tyevco/prettycoolboards/caliper/docs/electronics.md

# Schematics and boards

> **Status: rev A schematics captured, ERC clean (2 waived, listed below). Designed, not built or tested.**
> **Layout (§7):** both boards laid out and routed; KiCad 10.0.8 DRC + schematic parity: 0 errors, 0 unconnected.
> The toolchain and both boards moved from KiCad 9.0.9 to KiCad 10.0.8 on 2026-11-08 with no design change (§7.12).
> Both fab packages pass `release.py` (the J50 land now matches its part, §7.11); designed, not built.
> Every current, voltage and part choice here is a datasheet or catalogue figure, not a measurement.

The architecture of record is [SPEC](../hardware/design/SPEC.md); the net names, the ESP32 pin map and the I2C
addresses are in [`nets.py`](https://github.com/tyevco/prettycoolboards/blob/main/caliper/hardware/design/nets.py).
Why the big parts were chosen (and what lost) is in [Architecture](architecture.md).

## 1. How the schematic is made

The KiCad 10 projects are **generated from Python**, with the same toolchain as dial-me-spinner (vendored in
[`tools/`](https://github.com/tyevco/prettycoolboards/tree/main/tools)):

```
caliper/hardware/design/sheets/*.py ──build.py──▶ caliper/hardware/kicad/<board>/*.kicad_sch ──kicad-cli──▶ ERC, netlist, PDF
```

```sh
# in WSL (Ubuntu 24.04, KiCad 10.0.8)
python3 caliper/hardware/design/build.py --render      # both boards: schematic, ERC, netlist, PDF + PNG per sheet
python3 caliper/hardware/design/check_contract.py      # ESP32 pins in the netlist == nets.MCU_PINS
python3 tools/lcsc_check.py caliper/hardware/kicad/slider/prettycool-caliper-slider.net   # LCSC stock/type check
```

The sheets are **drawn with wires**, the way a person draws a schematic, so you can follow a connection by eye
(the toolchain's hard wiring rule, R1–R6 in [`tools/README.md`](https://github.com/tyevco/prettycoolboards/blob/main/tools/README.md#wiring-rule)):

- Each annotated group is a cluster around its anchor IC. Every satellite part sits next to the pin it serves and
  faces it: pull-ups and pull-downs, dividers, RC filters, the TX jumper + series-resistor chains, the CC
  resistors, the ESD part.
- Every connection on a sheet is an orthogonal wire, with a junction dot on every T. No junction joins four
  wires: a pull-up and a pull-down on the same net sit one grid step apart, so they make two T's.
- A pin's wire runs straight out on the pin's own row where it can. A test point or pull-up that would reach into
  the next row moves further out along its wire, and a test point may hang below the wire instead of above it
  (the ESP32's USB_D-/USB_D+ test points, the fuel gauge's ALRT pull-up). Only where a column is too crowded for
  that do the wires jog to fan the rows out: the AS5311 outputs (MAG_DO/A/IDX/INC_N/DEC_N) and the LCD
  connector's backlight pins, where R50 sits about 45 mm below J50 pin 12.
- Decoupling caps hang off the wire of the pin they decouple, and the power symbol sits at the end of that wire.
- A net that leaves the sheet has one global label per cluster, wired to all of that cluster's pins.
- A local net carries one local label as a name tag on its wire, so the net names in the netlist are unchanged.

`build.py` fails if the drawing breaks the rule. The check traces the drawn wires, not the labels, and names the
sheet, net and pins. Do not hand-edit the `.kicad_sch` files: change the sheet module and rebuild.

When the generator moved from "stub + label on every pin" to drawn wires (2026-11-07), `tools/netlist_diff.py`
showed the netlists before and after are **identical**: slider 96 nets, 125 components, 390 net members; scale
1 net, 4 components; same net names, same component fields, same symbol UUIDs. The ERC result did not change.
A second, independent review pass the same day traced the rendered sheets by eye. It fixed a power symbol drawn
over the buzzer's pin, six 4-way junctions, the half-row jogs on the I2C and LCD labels, and the label jumps
around test points on the ESP32 and the fuel gauge. The netlists were again identical to the pre-rework ones.
This is a check of the drawing only: nothing was built or measured.

| Board | KiCad project | Sheets | Rendered schematic |
|---|---|---|---|
| `slider` | `caliper/hardware/kicad/slider/prettycool-caliper-slider.kicad_pro` | power, mcu, sensor_mag, sensor_cap, ui, imu | [PDF](https://github.com/tyevco/prettycoolboards/blob/main/caliper/hardware/kicad/slider/render/prettycool-caliper-slider-schematic.pdf) |
| `scale` | `caliper/hardware/kicad/scale/prettycool-caliper-scale.kicad_pro` | scale | [PDF](https://github.com/tyevco/prettycoolboards/blob/main/caliper/hardware/kicad/scale/render/prettycool-caliper-scale-schematic.pdf) |

Toolchain changes made for this project (backward compatible): the deterministic UUID namespace in `schgen.py`
and `pcbgen.py` is now settable (`schgen.set_uuid_namespace()`, `pcbgen.UUID_NAMESPACE`; the default is still
`dial-me-spinner`), and `symgen.write_library()` takes the generator name. The caliper uses `prettycool-caliper`.

## 2. ERC status

| Board | Result (kicad-cli 10.0.8, `--severity-all`) |
|---|---|
| slider | **0 unwaived**; 2 waived `pin_to_pin` |
| scale | **clean** |

Waivers (in `build.py`, reported as "waived", never dropped silently):

| Violation | Pins | Why it is intended |
|---|---|---|
| pin_to_pin (open collector ↔ power output) | U5 pins 5 (QOD), 6 (VOUT) | TPS22917 QOD tied straight to VOUT, the datasheet's second QOD option (SLVSDW8B Table 6-1): +3V3_SNS is actively discharged when the switch turns off |
| pin_to_pin | U6 pins 5, 6 | Same for +3V3_UI |

`check_contract.py` result: `U10 checked against 42 nets.MCU_PINS entries -> OK` (it was also checked to fail on a
deliberately swapped pin).

## 3. Slider board, sheet by sheet

Reference designators are grouped by sheet: power 1–19, mcu 20s, sensor_mag 30s, sensor_cap 40s/60s–80s, ui 50s, imu 60s
(U60/C60–C62).

### 3.1 power: USB-C, charger, 3V3, rails

| Ref | Part | LCSC | Notes |
|---|---|---|---|
| J1 | HRO TYPE-C-31-M-12, 16-pin USB 2.0 receptacle | C165948 | Right edge (x = 62, y ≈ 26). CC1/CC2 each 5.1 k to GND (R1, R2): sink only, 5 V default USB current |
| U1 | USBLC6-2SC6 | C7519 | ESD on D+/D−/VBUS, flow-through. Within 5 mm of J1 |
| D1 | SMF5.0A TVS | C151296 | VBUS surge (as dial-me-spinner). On the layout both of J1's VBUS pad pairs land on D1's VBUS pad and the run to C1 / U2 leaves from it, so no copper path from J1 skips the TVS (§7.13) |
| U2 | BQ25180YBGR (I2C 0x6A) | C3682423 | Linear charger + power path, 70 mA charge set over I2C (0.52C for the 135 mAh cell; 250 mA before 2026-11-09), ship mode for storage. Battery discharge limit `IBAT_OCP` at its 1 A reset value (not 500 mA: an uncapped ≈ 0.5 A Wi-Fi peak from a low cell would come close; firmware §12.6). IN 2.2 µF/25 V 0805 X7R, SYS 10 µF/25 V, BAT 4.7 µF (dial-me-spinner's values, which its SPICE suite checked for DC bias). /INT → CHG_INT_N. TS/MR: 10 k NTC RT1 (board temperature next to the battery connector; the datasheet's "no TS" option is a plain 10 k) |
| J2 | JST SM02B-SRSS-TB (SH 2-pin) | C160402 | 1 = BAT+ (net VBAT_RAW), 2 = GND. **Check every pack's polarity**: hobby packs are not consistent (Q1 now survives a reversed one) |
| Q1, R10 | AO3401A P-MOSFET + 10 k gate resistor: battery reverse-polarity protection (added 2026-11-08) | C15127 (Basic), C25744 | Drain to J2 pin 1, source to VBAT, gate to GND via R10. Body diode first, then VGS = −VBAT turns it fully on; it conducts both ways, so charging works. Reversed cell: VGS = 0, off. VGS max ±12 V vs ≤ 4.4 V: no zener. At 0.5 A: ≤ 43 mV / ≤ 21 mW (85 mΩ max at VGS −2.5 V; ≈ 28 mV typical at a 3.0 V cell). The charger BAT pin, C3 and the MAX17048 stay on the protected side. Detail and the reversed-cell-with-USB case: [SPEC §3](../hardware/design/SPEC.md#_3-power-tree) |
| U3 | TPS63802DLAR buck-boost → +3V3 | C2845237 | 2 A, 11 µA Iq. EN = VSYS (always on), MODE = GND (power save), PG unused. TI typical application (SLVSEU9D Fig. 10-1): CIN 10 µF (C4), COUT 22 µF (C5) + 22 µF bulk (C6), feedback R3 511 k / R4 91 k → 3.31 V |
| L1 | Murata DFE201612E-R47M (0.47 µH, 5.5 A Isat) | C668312 | From TI's recommended list (Table 10-2). Footprint = KiCad's DFE201610P land (same 2016 body; the E part is 1.2 mm tall) |
| U4 | MAX17048G+T10 fuel gauge (0x36) | C2682616 | VDD = CELL = VBAT, CTG/QSTRT/EP to GND, 0.1 µF (C7). 3 µA hibernate. ALRT → FG_ALRT_N |
| U5 | TPS22917DBVR → +3V3_SNS | C2681320 | AS5311 + capacitive front-end. ON = SNS_PWR_EN (R5 100 k pull-down), CT 1 nF to VIN, QOD = VOUT |
| U6 | TPS22917DBVR → +3V3_UI | C2681320 | **Added during capture**: LCD logic VDD + RGB LED, also on SNS_PWR_EN (no GPIO is free) |
| C13 | 1 µF 0402 X5R at U6 VIN (added 2026-11-08) | C52923 (Basic) | U6's own input capacitor, right under its VIN / GND pins (C5, the nearest +3V3 cap, was 12.5 mm away by copper); the same part as C8 at U5 |
| R6, R7 | **2.2 k** I2C pull-ups to +3V3 (were 4.7 k) | C25879 | 400 kHz: rise time (30→70 %) = 0.847 RC = **205 ns** with the ≈ 110 pF bus estimate (4.7 k gave 438 ns, over fast mode's 300 ns). Sink current at VOL 0.4 V: (3.4 V − 0.4 V) / 2.18 kΩ ≤ **1.4 mA**, inside fast mode's 3 mA and every device's VOL rating: ESP32-S3 0.1 × VDD at 28 mA (S3 datasheet), BQ25180 0.4 V at 5 mA (SLUSE99C), MAX17048 0.4 V at 4 mA (19-6171); the LIS2DW12 is taken as fast-mode compliant (3 mA at 0.4 V; its datasheet could not be re-read here). No sleep cost: the bus idles high and the rail is off in ship mode. Always-on rail: the MAX17048's SCL/SDA have internal pull-downs and read a low bus as "disconnected" |
| R8, R9 | 10 k pull-ups on CHG_INT_N, FG_ALRT_N | C25744 | Open-drain interrupts |
| H1–H5, FID1–3 | M2 plated holes (GND), fiducials | – | Footprints only. H1 is the support hole, H2–H5 the tab clamp holes (H5 added to the schematic 2026-11-08). The SMT M2 standoffs on H2–H5 are **fitted by hand**: the only LCSC M2 SMT nuts (SMTSO20x0CTJ, e.g. C2915626 M2 × 2) have a Ø5.6 base and land, which would overhang the 6 mm tab (the hole is 2.5 mm from its outer edge) and exceed SPEC's OD ≤ 4.0 |
| TP1–TP7 | VBUS, VBAT, VSYS, +3V3, +3V3_SNS, +3V3_UI, GND | – | Bring-up |

Pinouts: BQ25180 from TI SLUSE99C Table 6-1 (and the YBG0008 land pattern, the footprint is copied from
dial-me-spinner); TPS63802 from SLVSEU9D Table 7-1, footprint drawn from the DLA0010A example board layout (p. 36:
pads 1–5 0.6 × 0.25 mm at x = −0.9, pads 6/7/9/10 0.9 × 0.25 mm at x = +0.75, GND pad 8 1.3 × 0.25 mm);
MAX17048 from the Maxim 19-6171 pin table (TDFN: 1 CTG, 2 CELL, 3 VDD, 4 GND, 5 ALRT, 6 QSTRT, 7 SCL, 8 SDA, EP).

### 3.2 mcu: ESP32-S3-MINI-1

| Ref | Part | LCSC | Notes |
|---|---|---|---|
| U10 | **ESP32-S3-MINI-1-N4R2** (4 MB quad flash, 2 MB quad PSRAM) | C3013941 | The N8R2 is not stocked at LCSC (searched 2026-11-07); the N8 (no PSRAM) is. KiCad's `RF_Module:ESP32-S3-MINI-1` symbol matches the Espressif pin table pad for pad; its footprint is `RF_Module:ESP32-S2-MINI-1`, the same 65-pad 15.4 × 20.5 mm land. That footprint has **no antenna keep-out zone** (its description also wrongly says "external antenna"): the layout must add the all-layer keep-out |
| C20, C21, C23 | 22 µF (0603) + 100 nF + 10 µF (0402) at pad 3 | C59461, C1525, C15525 | Datasheet v1.7 Fig. 9-1. C21 and C23 (CL05A106MQ5NUNC, 6.3 V X5R, 0.5 mm tall; expect a few µF at 3.3 V bias) sit on the **bottom under pad 3** (§7.2); C20 is the 22 µF bulk on top below the module |
| R20, C22 | EN RC 10 k / 1 µF | C25744, C52923 | Datasheet §9: "R = 10 kΩ and C = 1 µF" |
| R21, SW20 | BOOT: 10 k pull-up on GPIO0, button to GND | C25744, C720477 | Recovery only; normal flashing uses USB-Serial-JTAG |

The pin map is exactly `nets.MCU_PINS` ([SPEC §5](../hardware/design/SPEC.md#_5-mcu-pin-map-esp32-s3-mini-1)).
The KiCad symbol names pads 23/24 `USB_D-`/`USB_D+`; the sheet maps the contract's `IO19`/`IO20` to them.
IO26 (the PSRAM chip select on R2 parts) has a no-connect flag. Strapping: GPIO45 has a 100 k pull-down on the BUZZ
gate (R56), GPIO46 a 100 k pull-down on RGB_DIN (R55), GPIO0 the BOOT pull-up, GPIO3 the CHG_INT_N pull-up (harmless
while the JTAG_SEL eFuse is unburnt).

### 3.3 sensor_mag: AS5311

| Ref | Part | LCSC | Notes |
|---|---|---|---|
| U30 | ams AS5311-ATST (TSSOP-20) | C22459687 | **80 pcs in stock** at LCSC on 2026-11-07, Extended, $12.63. Order it early; if it is gone, consign it or hand-place it |
| C30, C31 | 100 nF + 1 µF at VDD5V | C1525, C52923 | Datasheet §7.7 |
| R30, R31 | 10 k pull-ups to +3V3_SNS on MagINCn / MagDECn | C25744 | Open drain (Table 1) |
| TP30–32 | MAG_A, MAG_B, MAG_IDX | – | Scope / logic analyser |

Pinout from the ams datasheet Revision 1.13, Table 1 (checked pin by pin): 1 NC, 2 MagINCn, 3 MagDECn, 4 A, 5 B,
6 NC, 7 Index, 8 VSS, 9 Prog, 10 NC, 11 NC, 12 DO, 13 CLK, 14 CSn, 15 PWM, 16 NC, 17 NC, 18 VDD3V3, 19 VDD5V,
20 NC. "Pins 1, 6, 10, 11, 16, 17 and 20 are for internal use and must not be connected": they carry no-connect
flags, as does the unused PWM output. 3.3 V operation: VDD5V and VDD3V3 both on +3V3_SNS (§7.7, "the LDO must be
bypassed by connecting VDD3V3 with VDD5V"). Prog to VSS ("for factory programming only"). CSn has an internal
~50 k pull-up and must be low for the A/B/Index outputs. Supply current 16 mA typ, 21 mA max.

### 3.4 sensor_cap: capacitive front-end (experimental)

```
CAP_TXn ─ R6n 0R (DNP-able) ─ R7n 100R ─ CAP_EL_TXn (comb phase n)        n = 0…7
CAP_EL_RX ─ R80 0R (DNP-able) ─ CAP_RX_IN ─┬─ U40A − (C40 10p C0G ‖ R81 10M to CAP_AMP_OUT)
                                           U40A + = CAP_VREF (R82/R83 100k/100k + C41 1u, buffered by U40B)
CAP_AMP_OUT ─ R84 390R ─┬─ R85 3.9k ─┬─ CAP_RX (GPIO1, ADC1_CH0)
                       C43 1n       C44 100p C0G
```

* **Placement (2026-11-08):** R84 / C43 sit at U40; R85 / C44 sit at the ESP32's GPIO1 pad (bottom side, under the
  module, beside GPIO1's escape via), so the long run across the board is **CAP_LP1** (390 Ω and 1 nF at its source
  end, a low-impedance node) and **CAP_RX** is ≈ 2 mm from the ADC pin. Both nets are in their own net class
  (*Analog*): 0.2 mm from every other net, and the GND pour follows them. TP42 (scope point) is on CAP_LP1
  (it was on CAP_RX; a pad in the test-pad row would now hang a 30 mm stub on the ADC node). §7.13. CAP_LP1's B.Cu
  and In2 stretches run in a shielded corridor (no other track within 1 mm on their layer or along them on the
  neighbouring one, GND copper round them): §7.14.

* **Op-amp:** TLV9062IDGKR (C398356): dual, 10 MHz GBW, rail-to-rail in/out, 538 µA per amplifier, 1.8–5.5 V.
  It meets SPEC's "≥ 10 MHz GBW, RRIO CMOS" at $0.23. If the bandwidth turns out short, a 50 MHz RRIO dual such as
  the OPA2365 has the same pinout, but LCSC C130011 is the **SOIC-8** OPA2365AIDR, so it is not a footprint drop-in
  for the VSSOP-8 land (a VSSOP version would have to be sourced).
* **Feedback:** 10 pF ‖ 10 MΩ: the gain is −C<sub>coupling</sub>/10 pF and the DC path's corner is
  1/(2π·10 MΩ·10 pF) ≈ 1.6 kHz, far below the 25–100 kHz drive.
* **Low-pass:** two RC poles at 1/(2π·390 Ω·1 nF) ≈ 408 kHz and 1/(2π·3.9 kΩ·100 pF) ≈ 408 kHz; the second stage
  is 10× the impedance so it barely loads the first.
* **Isolation:** with R60–R67 and R80 left off, the experiment is fully disconnected from the ESP32 and the
  op-amp. The rail (+3V3_SNS) is shared with the AS5311, and the op-amp is always fitted.

**Electrodes in the schematic (the approach chosen):** the electrodes are bottom-layer copper, not parts. They are
drawn as one symbol, **E40** (`caliper:CAP_ELECTRODES`), with a footprint of *seed pads*, one per electrode net:
pads 1–8 are eight 0.30 × 5.00 mm fingers at 0.635 mm pitch (pins PHASE0…PHASE7, one 5.08 mm repeat), pad 9 (pin RCV) is a
5.08 × 1.20 mm receive strip 3.8 mm below the comb centre (SPEC §2.1: comb y = 12.5…17.5, RX y = 10.6…11.8). The
layout script places E40 on the bottom at the start of the comb and draws the remaining 7 repeats and the full
40 mm RX strip as copper on the same nets. E40 is excluded from the BOM and the CPL. This keeps every electrode a
real net with a pad (ERC checks it, the netlist carries it to the board, DRC sees the copper on its net) without
net-tie footprints or ERC waivers. The pins are **passive** and named PHASEn / RCV, not TXn / RX: hwtools boardcheck
read a pin named TX6 as a UART transmitter and flagged it against U10 TXD0 (GPIO43, which drives phase 6 through
R66/R76) as "output to output" (SERIAL_DIRECTION_WIRING). With the rename it no longer does (re-run 2026-11-08).

### 3.5 ui: display, buttons, LED, piezo

**LCD panel pinout.** The 13-pin 1.14 in ST7789 glass is sold under many part numbers; the pin order used is the
DisplayModule **DM-TFT114-397** datasheet, §3.1 "Panel Pin Description" ([PDF](https://cdn.shopify.com/s/files/1/0264/7629/files/DM-TFT114-397_Datasheet.pdf)):

| Pin | 1 | 2 | 3 | 4 | 5 | 6 | 7 | 8 | 9 | 10 | 11 | 12 | 13 |
|---|---|---|---|---|---|---|---|---|---|---|---|---|---|
| Panel | NC | NC | SDA | SCL | RS (D/C) | RESET | CS | GND | NC | VDD | LEDK | LEDA | GND |
| Net | – | – | LCD_MOSI | LCD_SCK | LCD_DC | LCD_RST_N | LCD_CS_N | GND | – | +3V3_UI | LCD_LEDK | LCD_LEDA | GND |

Same datasheet: VDD 2.4–3.3 V, 8 mA typ; sleep-in 15 + 5 µA typ; backlight 1 white LED, VF 2.9–3.1 V at 20 mA.

| Ref | Part | LCSC | Notes |
|---|---|---|---|
| J50 | HDGC 0.5K-AX-13PWB, 13 P 0.5 mm FPC, bottom contact, slide lock, 2.0 mm | C2911931 | 2784 in stock. **Own footprint** (`caliper:HDGC_0.5K-AX-13PWB_1x13-1MP_P0.50mm_Horizontal`, drawn in `sheets/ui.py`) from the vendor drawing 0.5K-AX-nPWB: contacts 0.30 × 1.25 at 0.5 mm, nail pads 2.00 × 3.00 at x ±4.54, 2.325 mm behind the contact row. The genuine Hirose FH12-13S-0.5SH(55) (C5700671) and the Amphenol F32R 13-pin have KiCad footprints but no LCSC/JLC stock. Checked against the EasyEDA land (same contacts and nail x; EasyEDA's nails are 0.37 mm nearer the row and still land on this one). Pin 1 and the panel-tail orientation: §7.2 |
| C50, C51 | 1 µF + 100 nF at VDD | | |
| R50 | 15 Ω 0603, +3V3 → LEDA | C22810 | (3.31 V − VF) / 15 Ω ≈ 20 mA at VF 3.0 V (the panel's rated point), ≤ 27 mA at 2.9 V, ~14 mA at 3.1 V. Was 10 Ω at capture, which gave 31–41 mA (changed in review). Only ~0.3 V of headroom, so brightness follows VF and +3V3. Dim by PWM |
| Q50 | AO3400A, low side on LEDK, gate = LCD_BL | C20917 (Basic) | R51 100 k gate pull-down |
| SW50–52 | XUNPU TS-1088-AR02016 (3.9 × 2.9 × 2.0 mm) ZERO/HOLD/MODE | C720477 (Basic) | 100 k pull-up (R52–R54) + 100 nF (C52–C54) = 10 ms RC debounce; RTC GPIOs 17/18/21 wake from deep sleep |
| D50 | WS2812B-2020-V6 RGB LED | C52917434 | LCSC lists 3.3–5.3 V, so it runs on +3V3_UI with a 3.3 V DIN and no level shifter. R55 100 k pull-down (GPIO46 strap) |
| BZ50 | Murata PKMCS0909E4000-R1 piezo (4 kHz, external drive) | C910763 | +3V3 → BZ50 ‖ R57 1 k → Q51 (AO3400A) drain. R56 100 k gate pull-down holds GPIO45 (VDD_SPI strap) low at reset |

### 3.6 imu: LSM6DSO

U60 **LSM6DSOTR** (C2655100), a 6-axis IMU: 3-axis accelerometer + 3-axis gyroscope in an LGA-14 (2.5 × 3.0 ×
0.86 mm). It is on the system I2C and always powered from +3V3, so it can wake the ESP32 on pickup (INT1 → GPIO15,
an RTC GPIO). Until 2026-11-10 U60 was a LIS2DW12 accelerometer; the reasons for the change and what it cost are in
[§7.15](#_7-15-gyroscope-lsm6dso-replaces-the-lis2dw12-2026-11-10).

| Pin | Net | Why |
|---|---|---|
| 8 VDD, 5 VDDIO | +3V3 | C60 100 nF + C61 10 µF at VDD, C62 100 nF at VDDIO (DS12140 asks for 100 nF on each) |
| 13 SCL, 14 SDA | I2C_SCL, I2C_SDA | the system bus, 400 kHz |
| 12 CS | +3V3 | high = I2C |
| 1 SDO/SA0 | +3V3 | **address 0x6B**. SA0 low is 0x6A, the BQ25180's address on the same bus. SA0 is an input without a pull-up by default (Table 19, `PIN_CTRL.SDO_PU_EN` = 0), so the strap draws nothing (the LIS2DW12's SA0 had a permanent pull-up) |
| 2 SDx, 3 SCx | GND | Mode 1 (no sensor hub): "connect to VDDIO or GND" (Table 1) |
| 10 OCS_Aux, 11 SDO_Aux | not connected | Mode 1: left open, pads soldered |
| 4 INT1 | IMU_INT1 (GPIO15) | wake on pickup. Push-pull, active low, latched, set by the firmware. No pull on the net |
| 9 INT2 | IMU_INT2 (GPIO16) | spare interrupt, push-pull, no pull |
| 6, 7 GND | GND | |

* **INT1 at power-up.** Until the firmware configures it, INT1 is an *input* with an internal pull-down, and it
  "must be set to 0 or left unconnected during power-on" (Table 19, note 2). The net has no pull and GPIO15 is a
  high-impedance input at reset, so that holds. The consequence for the firmware: an unconfigured IMU shows INT1
  **low**, which is the wake level, so the firmware configures the IMU before it arms the wake
  ([Firmware](firmware.md)).
* **Axes.** U60 sits at 0° on the top side, so the chip axes are the board's (Fig. 3): X along the beam (board +x),
  Y across it (board +y), Z out of the display face.
* **What the gyroscope gives.** Roll and pitch come from gravity (the accelerometer) and stay absolute; the gyroscope
  makes them usable while the tool moves, and gives turn rate and a "held steady" test. Heading (rotation about
  the vertical) from the gyroscope alone is only relative and drifts. Since 2026-11-10 a magnetometer (U61, below)
  gives it a reference. This page said until then that one "would not work this close to the magnetic scale"; that
  reason was wrong (the tape's field is gone a centimetre away), and the real problem is the steel beam
  ([§7.16](#_7-16-compass-iis2mdc-magnetometer-2026-11-10)).
* **Not verified.** The piezo (BZ50) is 10 mm away; whether its 4 kHz drive shows up in the gyroscope output is not
  known (TVP: gyro noise with the buzzer on and off). The current figures are the datasheet's at VDD = 1.8 V; the
  board runs it at 3.3 V.

**The compass, U61.** An **IIS2MDCTR** (C2655002), a 3-axis magnetometer in an LGA-12 (2 × 2 × 0.7 mm), on the same
sheet, the same I2C bus and the always-on +3V3. Added on 2026-11-10
([§7.16](#_7-16-compass-iis2mdc-magnetometer-2026-11-10)). Pin functions and the application circuit are from ST
DocID030986 Rev 1 (Table 2, Fig. 5, §5), read from a distributor's copy up to page 25 of 40: the register map and
the package drawing were **not read**.

| Pin | Net | Why |
|---|---|---|
| 9 Vdd, 10 Vdd_IO | +3V3 | C64 100 nF + C65 10 µF at Vdd, C66 100 nF at Vdd_IO (Fig. 5: C3, C2, C4) |
| 5 C1 | COMPASS_C1 | **C63 220 nF** to GND (Fig. 5). The sensor's set / reset pulses come out of this capacitor: "very high current pulses flow from C1 to pin 5 and 6", ESR ≤ 200 mΩ, "as close as possible" to both pins (§5). An X7R 0402 (CL05B224KO5NNNC, C16772) |
| 1 SCL, 4 SDA | I2C_SCL, I2C_SDA | the system bus, 400 kHz. **Address 0x1E**, fixed (Table 21): no address pin, and nothing else on the bus is near it |
| 3 CS | +3V3 | "When using the I2C, CS must be tied high" (§5). An input without a pull-up |
| 7 INT/DRDY | not connected | every ESP32 pin is taken (`nets.MCU_PINS`), so the firmware polls. The pin is high impedance by default (Table 14) |
| 2, 11, 12 NC | not connected | "internally not connected" (Table 2); pads soldered |
| 6, 8 GND | GND | |

* **Axes: not known from the datasheet.** Its axis drawing (Fig. 2) is an isometric view from which the signs
  against pin 1 could not be read with certainty. The firmware has an axis map, and the first board fixes it
  (`bu compass`, [bring-up](bringup.md)).
* **Currents** (Table 5 and Table 11, typical): idle 1.5 µA; low-power mode at 10 Hz 25 µA, 50 µA with offset
  cancellation (the firmware's mode); high-resolution at 10 Hz 100 µA. Not measured.
* **What it can and cannot do here** is in §7.16: the steel beam is 11.2 mm away.

## 4. Scale board

No electronics: two plated M2 holes on GND (H1, H2) in the schematic, which the layout turns into the SPEC's Ø1.0
non-plated alignment holes (§7.6), two fiducials and a PWR_FLAG. The reflector pattern and the
back-copper ground plane are drawn by the layout script as copper/graphics (SPEC §2.2). The netlist exists so the
layout can import the holes and fiducials the same way as the slider.

## 5. BOM and sourcing

`tools/lcsc_check.py` against the JLCPCB catalogue on 2026-11-10: **49 BOM lines, 0 flagged** (every code
found, in stock, MPN matches). 23 lines are JLC **Basic**, 26 **Extended**; the four buttons are four lines with one
code, so the order has 46 different parts. On 2026-11-08 it was 47 lines, 22 Basic and 25 Extended: the compass
(§7.16) added U61 (Extended) and C63 220 nF (Basic). The stock and price columns below are as read on the date
given in each row, or on 2026-11-08.

| Line | LCSC | Type | Stock | $ (qty 1) |
|---|---|---|---|---|
| ESP32-S3-MINI-1-N4R2 | C3013941 | Extended | 7 487 | 5.00 |
| AS5311-ATST | C22459687 | Extended | **80** | 12.63 |
| BQ25180YBGR | C3682423 | Extended | 5 848 | 1.85 |
| MAX17048G+T10 | C2682616 | Extended | 22 821 | 2.01 |
| TPS63802DLAR | C2845237 | Extended | 23 909 | 0.91 |
| TPS22917DBVR (×2) | C2681320 | Extended | 3 637 | 0.37 |
| LSM6DSOTR (since 2026-11-10; was LIS2DW12TR C189624, $0.90) | C2655100 | Extended | 23 738 (2026-11-10) | 3.99 |
| IIS2MDCTR (compass, since 2026-11-10; §7.16) | C2655002 | Extended | 2 705 (2026-11-10) | 4.25 |
| TLV9062IDGKR | C398356 | Extended | 53 188 | 0.23 |
| WS2812B-2020-V6 | C52917434 | Extended | 740 820 | 0.09 |
| PKMCS0909E4000-R1 | C910763 | Extended | **535** | 1.10 |
| 0.5K-AX-13PWB FPC | C2911931 | Extended | 2 784 | 0.12 |
| AO3400A, AO3401A (Q1, C15127), TS-1088, 0402 R/C | various | Basic | > 100 k | < 0.09 |

**Parts that are not (reliably) on LCSC:** none is missing, but the **AS5311** has only 80 pieces at LCSC: if they
are gone when the order is placed, the part is consigned or hand-placed (the BOM field `JLC` says so). The LCD panel
itself is not a PCBA part: it plugs into J50 by hand.

## 6. Open risks (schematic)

* **LCD panel pitch / pin order.** The cited pinout comes from a module whose drawing shows a 0.7 mm *solder*
  tail; the board needs a panel with a 0.5 mm, 0.3 mm-thick plug-in tail in the same pin order. Buy the panel
  first and check its drawing; if it differs, change `PANEL_PINS` in `sheets/ui.py`.
* **FPC footprint**: now the C2911931 vendor land (§3.5). The vendor drawing and EasyEDA disagree by 0.37 mm on the
  nail position; the land covers both, but check the first parts' nails on the pads.
* **WS2812B-2020-V6** pin order and the 3.3 V minimum are from the LCSC listing and the WS2812B-2020 family; the V6
  datasheet could not be downloaded during capture.
* **Backlight headroom**: 3.31 V − 3.0 V VF leaves 0.3 V across 15 Ω + the FET; a 3.1 V LED gets ~14 mA, a 2.9 V
  one ≤ 27 mA. The panel's maximum LED current is not in the cited datasheet: check it on the bought panel.
* **Sleep current** is ≈ 40 µA (estimate; ≈ 38 µA before the compass, ≈ 33 µA before the gyroscope) against SPEC's
  target of ≤ 42 µA
  ([Architecture §5](architecture.md#_5-power-budget-and-battery-life)).
* **Contract reconciliation (SPEC §10, 2026-11-07).** The layout has the clamp tabs (74 × 34 overall), the
  single upper-band hole H1, the module in the top-left corner with an all-layer antenna keep-out, the D5 electrode
  geometry and the scale's Ø1.0 alignment holes (§7). H5 is in the schematic since 2026-11-08; the SMT M2 standoffs
  are hand-fitted (no LCSC part fits, §3.1). **Not yet in the schematics** (the board carries them as board-side
  edits, §7.9): the E40 seed-pad change (fingers 0.30 × 3.80, RX 5.08 × 1.30) and the scale holes as NPTH. In the schematics already: RT1 populated and
  TS enabled; IMU_INT1 has no pull (checked in the netlist).
* **Ship mode** can only be left by plugging in USB (TS/MR is not wired to a button).
* **RX electrode ESD**: the receive strip is exposed copper under an open mask, connected through R80 straight to a
  high-impedance op-amp input. It faces the scale, not the user, but a discharge into the beam could reach it.
  Not protected in rev A (a TVS would add pF and leakage at the most sensitive node).
* **Back-powering**: the MAG_*, LCD_* and RGB_DIN lines go into switched rails; the firmware must drive them low
  before SNS_PWR_EN goes low.
* Nothing here has been simulated (the simulation track owns SPICE) or built.

## 7. Layout

> **Status (2026-11-08): both boards laid out, routed and through the DRC + schematic-parity gate (KiCad 10.0.8:
> 0 errors, 0 unconnected, 0 parity errors on both; it was KiCad 9.0.9 until the move in §7.12, which changed no
> copper), and both fab packages pass
> `release.py`**, including the jlcplace placement gate on every CPL row (§7.7). The slider was re-placed and re-routed from
> scratch after the hardware changes in §7.11 (Q1, 2.2 k I2C pull-ups, the J50 land, bottom-side module
> decoupling, H5, silk); the figures in §7.5 and §7.10 are from the board before that re-route. The phase-4 review
> fixes (§7.13: VBAT / VSYS / VBUS pre-routes, C13, R85/C44 at the ADC pin, the stack-up, the USB loop round U1) were
> made with `layout.py --rework`, which keeps the routing of every unchanged net; so was the CAP_LP1 crosstalk
shield (§7.14, 2026-11-09). Designed,
> not built: nothing has been fabricated or measured, and no signal-integrity, RF or thermal analysis was run on
> the layout. An adversarial layout review on 2026-11-08 found and fixed five defects (the USB pair, three
> decoupling placements, a truncated electrode guard) and corrected several claims here; its findings, fixed and
> open, are in §7.10.

The boards are generated from the netlists by
[`layout.py`](https://github.com/tyevco/prettycoolboards/blob/main/caliper/hardware/design/layout.py) (adapted from
dial-me-spinner's) and released by
[`release.py`](https://github.com/tyevco/prettycoolboards/blob/main/caliper/hardware/design/release.py):

```sh
# in WSL (Ubuntu 24.04, KiCad 10.0.8, Freerouting 2.1.0, FREEROUTING_JAR=/opt/freerouting/freerouting.jar)
python3 caliper/hardware/design/layout.py --board scale                                  # place, pour, DRC
python3 caliper/hardware/design/layout.py --board slider --route --minutes 8 --attempts 1 # place, route, pour, DRC
python3 caliper/hardware/design/layout.py --board slider --complete                      # only if any stay open
python3 caliper/hardware/design/layout.py --board slider --rework [--rip NET,...]         # a change: keep the routing
                                                                                         # of the unchanged nets (§7.13)
python3 caliper/hardware/design/release.py [--refit-jlc] [--force]                       # gates, fab package
```

Coordinates below are SPEC's: board mm, origin at the lower-left of the 62 × 34 body, +y up (the beam's jaw-side
edge is y = 0). The drill/place origin is the same point, so the CPL is in these coordinates too.

### 7.1 Stack-up and rules (slider)

| Layer | Use |
|---|---|
| F.Cu | parts, signals, GND pour |
| In1.Cu | **solid GND plane** (layer type *power*; every GND SMD pad has its own via to it) |
| In2.Cu | **+3V3 pour**, signals, the 8 electrode **phase buses**, and a **GND** pour inside the electrode ring |
| B.Cu | U30 (AS5311) + C30/C31, the electrode comb and guards, 19 test pads, the MAG bus, signals; GND pour |

**Stack (written into the board since 2026-11-08, `layout.py` `SLIDER_STACKUP`; ORDER-NOTES names it): JLC04101H-3313**,
JLC's symmetric 1.0 mm 4-layer construction. ENIG.

| Layer | Thickness | Material |
|---|---|---|
| F.Mask / B.Mask | 15 µm | εr 3.8 |
| F.Cu, B.Cu | 35 µm | 1 oz finished |
| L1–L2 and L3–L4 prepreg | 0.0994 mm | 3313 (RC 57 %), εr 4.1 |
| In1.Cu, In2.Cu | 15.2 µm | 0.5 oz finished (JLC's figure) |
| Core | 0.6708 mm | FR-4, εr 4.6 (set so the stack adds up to 1.0 mm) |

The prepreg, its εr and the copper figures are JLC's impedance-table values (the hwtools run assumed the same). JLC
publishes this construction's core only inside its order and impedance pages, which could not be read from here; no
line on this board depends on it (every controlled line is an outer layer over its neighbouring plane through the
prepreg). Before 2026-11-08 the board file had no stack-up, so KiCad, sicalc and pcbroute fell back to KiCad's
default stack (the USB pair read 125 Ω differential there).

Net classes: default 0.12 / 0.10 mm, vias 0.40/0.20; Power (VBUS, VSYS, VBAT, VBAT_RAW, the buck-boost switch nodes)
0.30 mm, vias 0.50/0.25, with the main power paths pre-routed wider (§7.13); Rail3V3 (+3V3) 0.20 mm (≈ 0.7 A on 1 oz
outer copper, with the In2 +3V3 pour in parallel; the module peaks at ≈ 0.36 A); Supply (+3V3_SNS, +3V3_UI,
backlight) 0.20 mm; GND 0.30 mm; **USB 0.16 mm, 0.15 mm clearance, differential pair 0.16 mm / 0.16 mm gap**;
**Analog** (CAP_RX, CAP_LP1) 0.15 mm, **0.30 mm clearance**. Copper to edge 0.25 mm.

**USB pair impedance** (hwtools `sicalc solve`, 2D field solver, edge-coupled microstrip over the plane through the
0.0994 mm prepreg, εr 4.1, 35 µm copper, 15 µm mask, JLC's 17.8 µm etch): 0.14 mm / 0.18 mm gap (until 2026-11-08)
**96.7 Ω**; **0.16 mm / 0.16 mm gap (now) 89.4 Ω** (89.0 Ω with the B.Cu GND pour 0.25 mm beside it); the
0.16 / 0.14 mm of a 45° leg at the old 0.30 mm pitch would be 87.4 Ω, so the D− 45° leg moved out to 0.32 mm pitch.
The pair runs on B.Cu over its In2 GND strip, which in this symmetric stack is the same structure as F.Cu over In1.
Full-speed USB (12 Mb/s, ≥ 4 ns edges) is not sensitive to this at these lengths; the class is set right anyway.

Copper is poured on all four layers over the beam band (y 0–20) where the routing leaves room. Measured in the review
(copper incl. tracks and pads, share of the board area in y 0–20): F.Cu 67 %, In1 93 %, In2 63 %, B.Cu 65 %. The
outer pair is balanced; the inner pair is not (93 / 63 %), a small warp bias against the 0.03 mm flatness callout.

**In1 under the electrode via field.** Each phase's finger vias step 0.635 mm in x and 0.45 mm in y, 0.78 mm apart,
and their 0.8 mm In1 antipads merge, so In1 has eight diagonal slots ≈ 5.5 mm long under y 13.5–17.1. F.Cu tracks
that cross the via field cross those slots (a few mm per net, measured). Harmless for the slow nets; the LCD SPI lines
cross it for ≈ 1 mm each. Not changed in rev A (smaller finger vias would only shrink the slots to 0.08 mm webs).

### 7.2 Slider placement

Everything in SPEC §2.1's table is placed and locked by the script. The rest is placed next to the IC pin it serves
(decoupling, pull-ups, filters) or inside its cluster region. Where the layout differs from the table (SPEC allows
≤ 1 mm when every rule still holds; **bold** = more than that). The SPEC §2.1 table was updated to these
positions on 2026-11-08 (SPEC §11):

| Part | SPEC §2.1 | Layout | Why |
|---|---|---|---|
| U10 module | origin (8.3, 24.25) | (7.85, 24.25) | the electrode comb's left end runs under the module (SPEC places both there). With the module 0.45 mm left, finger 8's via clears the module's right pad column. Antenna still flush with the top edge; body x 0.1–15.6 |
| J50 FPC | (21.5, 8.5) | (21.5, 7.5) | at 8.5 its (FH12) fitting-nail pad sat on the electrode via rows. Since §7.11 the land is the C2911931 drawing's: contact row at x 23.35, pin 1 at y 10.5, pin 13 at y 4.5, nail pads up to y 13.04 |
| **Q1 / R10** (battery FET), RT1, C7 | RT1 (24.5, 26.5), C7 in the cluster | Q1 (25.1, 25.1) 90°, R10 (22.5, 23.5); **RT1 (22.3, 26.75)**; C7 (27.37, 26.3) | §7.11: Q1's drain pad 2.6 mm below J2 pin 1; RT1 moved 2.2 mm left (still beside J2, over the cell); C7 fixed left of U4's VBAT pins (1.3 mm) |
| J2 battery | (24.5, 31.4) | **bottom** (24.1, 24.9), 0° flipped (2026-11-09, SPEC §15 L1; was top (24.5, 30.6), 180°) | the slim housing has no room for a plug past the top edge, so J2 hangs into the battery pocket's J2 bay, mouth toward +y. At the draft's 31.4 the front fitting-nail pads crossed the top edge |
| SW20 BOOT | (27, 15.5) | (27, 15.7), 90° | rotated so its pads fall between the finger via rows |
| U1 USB ESD | (53.0, 24.0) | **(50.2, 26.3)** | at 53 its VBUS pin sits under the locked D+/D− crossover behind J1's pads; still 5 mm from J1 |
| **D1** TVS, R1/R2 CC | near J1 | **(52.7, 19.95) 180°**; (53.4, 23.7 / 29.0) | §7.13: D1's VBUS pad on the VBUS trunk (both J1 feeds land on it, the run to C1 / U2 leaves it), below J1's courtyard; was (51.3, 22.0) 90°, a branch. C53 (BTN_HOLD_N debounce) took D1's old spot, (51.3, 23.0) |
| **C30** (AS5311 100 nF) | (25.5, 6.0) bottom | **(35.45, 8.6)** bottom | review 2026-11-08: at 25.5 it was 8.1 mm from the VDD pins 18/19 (14.9 mm of track); now 1.7 mm, still inside the D2 window x 20–41, y 2.4–9.6. C31 (1 µF) stays at (36.5, 6.0). **SPEC table to update** |
| C8 / C10 (U5 in / out) | in the cluster | (51.3, 1.55) / (49.75, 5.5) | review 2026-11-08: the pin-anchored placer found no room inside the SPEC cluster box (y ≥ 2.5, x ≥ 50.5) and left them 6.5 / 7.0 mm from U5; now 1.9 / 1.6 mm. Both sit up to 0.95 mm outside the box (the 4.2 mm height rule still holds) |
| **U4 fuel gauge** | in the charger cluster | **(29.6, 27.2)**, beside J2 | its CELL/VDD pins then sense VBAT at the cell's connector, its I2C/ALRT lines stay short, and the cluster could not let them out (the electrode ring blocks In2/B.Cu up to x 52.4). **SPEC cluster list to update** |
| **R60–R67, R70–R77** | x 3.5–16, y 2.5–12 | **x 1.8–10.2, y 7.0–11.2** (a ladder of 8 columns, R7n over R6n) | §7.3: with the ladder there, the TX lines reach it down the left side instead of through the corner where the module meets the electrode via field |
| R6–R9 (I2C/alert pull-ups), C20 (module 22 µ bulk) | – / at pad 3, < 2 mm | below the TX ladder, x 0.4–9.9, y 2.7–6.8 | the module's 3V3 pad is in its left column, 0.45 mm from the edge, and no top-side spot is closer than ≈ 12 mm (the antenna keep-out is above the pad, the board edge left of it). C20 stays 20.5 mm away as the bulk, fed through the In2 +3V3 pour |
| **R85 / C44** (CAP_RX 3.9 k / 100 p, 0402) | at U40 | **bottom**, (3.3, 24.25) / (3.3, 23.25), under the module below C23 | §7.13: the anti-alias RC at the ADC pin; R85's and C44's CAP_RX pads 0.8 mm from GPIO1's escape via (was 40 mm of track away). SPEC §2.1's under-module bottom exception extended to y 22.7 |
| C13 (U6 input, 1 µ 0402) | new | (52.25, 10.3), under U6's VIN / GND pins | §7.13 |
| **C21 / C23** (module 100 n / 10 µ, 0402) | at pad 3, < 2 mm | **bottom**, (3.1, 26.5) / (3.1, 25.3), either side of pad 3's escape via (2.0, 25.95) | §7.11 (SPEC call 2026-11-08): their +3V3 pads are 1.9 mm from pad 3 (C21 was 22.4 mm away on top). 0.55 mm envelope against the 0.75 mm housing floor gap there; outside the beam band, the antenna rule area and the battery pocket |
| **R50 / Q50 / R51** (backlight) | (25.5, 4.0) | **(27.0, 7.4) / (28.1, 3.6) / (28.7, 7.0)** | beside J50, under the glass, around the electrode feed |
| **Q51 / R56 / R57** (piezo driver) | (40.0, 18.0) | **(47.35, 20.4) / (46.2, 23.7) / (33.7, 19.5)** | around BZ50 instead of under the glass edge; R57 (BUZZ_D pull-up) at BZ50's left |
| **FID3** | (60.5, 32.8) | **(33.0, 27.6)** | SPEC's spot is inside J1's courtyard (it reaches y 31.9 over x 54–63) |
| Charger / buck-boost | x 50.5–61.5, y 2.5–20.5 | U3 (55, 9), L1 (58, 9), U2 (57.2, 16.4), U5 (52.2, 4.6), U6 (53, 12.9) | TPS63802: CIN at VIN, COUT at VOUT, L1 right beside L1/L2, the FB divider R3/R4 at FB on the side away from L1; BQ25180: a locked DSBGA fan-out and its caps around the array; a locked 0.30 mm VBUS run from J1 to C1 and D1. L1 is 16 mm from U40 (SPEC ≥ 10), U60 31 mm from L1 (SPEC ≥ 15) |

**Antenna.** The module's library footprint carries Espressif's 15 mm clearance as a 45 × 19.5 mm rule area and a
matching courtyard. SPEC D4 records a 5 mm deviation, so on this instance both are replaced by the module-body
courtyard, and the SPEC keep-out is a board rule area on all four layers: no tracks, vias, pads or pours in x 0–21,
**y 29.2**–34 (SPEC says 29.0; the module's own top GND pad row reaches 29.1, and the antenna starts at 29.5).

**Escapes.** Before routing, the module's left column (0.45 mm from the edge, so it can only escape inward) and bottom
row, its right column, J50's five LCD pads, U60, U4 and U1's VBUS pin get a locked stub and via. The routers then leave
those pins on In2/B.Cu instead of walling them in on F.Cu; a via the router does not use is pruned afterwards. Five
AS5311 lines (MAG_A/B/IDX/CLK/DO) are a locked B.Cu bus from the module's left column down the left edge to U30,
planned so that no two cross.

### 7.3 Capacitive electrodes (SPEC §2.2)

All of the comb is real copper on the E40 nets, so DRC and parity check it like any other copper:

* **Fingers and RX are E40 pads.** The E40 instance on B.Cu holds 64 finger pads (0.30 × 3.80 at 0.635 mm,
  x 10.68 + 0.635 k, y 13.55–17.35). Pads 1–8 are the library's seed pads resized; 56 more carry the same numbers, so
  the phase is k mod 8. Pad 9 becomes the whole RX strip (40.64 × 1.30, y 11.05–12.35). As pads they get one mask
  aperture each (no aperture spans two nets) and no paste. The library seed still has the pre-D5 geometry, which is
  why DRC reports E40 as differing from its library copy.
* **Vias and buses.** One 0.40/0.20 via per finger. The eight seed fingers (k = 0–7) have theirs in a row at y 13.75,
  just below the module's bottom pad row; every other finger's via is at its phase's bus height. Phase p's In2 bus
  starts at its seed via, climbs at 45° to y = 13.75 + 0.45 (7 − p) and runs under the comb to finger 56 + p. Phase 7
  is the lowest bus and phase 0 the highest, so each new seed, one pitch to the right, finds the earlier buses already
  above it: no crossings, one layer. The buses under the fingers are the SPEC table's "phase bus" exception to the
  solid In2 guard.
* **Feed.** Each seed via drops on F.Cu to y 13.3 − 0.25 n and runs left to its ladder column (x 2.3 + 1.05 n): R7n
  (100 Ω) then R6n (0 Ω). Seed n turns lower the further right it is, so the eight stubs do not cross. The RX feed is a
  via at (42, 11.7) with R80 right under it.
* **Guards.** The inner guard (0.60, y 12.65–13.25, x 9.78–52.22 between the ring's sides) and the closed outer
  ring (0.40) are GND tracks on B.Cu, stitched to In1/In2 every 2.54 mm (not under the module). The routed board
  before the review had the inner guard cut back to x 17.4–50.42 by the clean-up (`pcbgen.trim_dangling` took its
  ends on the ring's sides for open ends), so the first ten fingers had no guard between them and the RX strip.
  Restored, and `trim_dangling` now treats an end on another segment's body as connected. In2 inside the ring is a GND pour around the buses.
  Freerouting gets In2 and B.Cu inside the ring as keep-outs (written into its DSN), the grid router as a temporary
  rule area, so no other net is routed under the electrodes (checked: no foreign track or via inside the ring).
* The finger vias sit inside the finger mask apertures and are open there (ORDER-NOTES says so).

**Bottom side** (SPEC D2): only U30 (AS5311, (31, 6), long axis along x, pads inside y 2.4–9.6) and C30/C31
(C30 at (35.45, 8.6) beside the VDD pins, C31 at (36.5, 6.0)) over the beam band; the 19 test pads on a 2.54 grid
at y 22.6 / 25.14, x 22.5–47.9, assigned by proximity (MCU next to the module, the rails at the charger end; TP22 /
TP23 (D+ / D−) at the east end of the lower row, on the two sides of the USB pair, §7.5); the tab holes H2–H5 have no exposed bottom
copper (B.Mask dropped on the instance pads).

### 7.4 Outline, holes, tabs

74 × 34 overall: the 62 × 34 body with 1 mm corners plus the two 6 × 14 mm end tabs (x −6…0 and 62…68, y 2.5…16.5),
with 0.5 mm fillets at the tab roots (a router bit leaves those anyway). H1 (18.75, 24) is the support hole; H2–H5 are
the tab clamp holes at (−3.5 / 65.5, 5.5 / 14.0), plated GND, Ø4.4 top pads for the SMT standoffs (fitted by hand,
§3.1). H5 is in the schematic since 2026-11-08 (it was a board-only footprint before).

### 7.5 Routing result (slider)

The slider is fully routed: **0 unconnected** (KiCad 9.0.9 then, KiCad 10.0.8 now). After the review: 2955 mm of track (F.Cu
1054, In2 933, B.Cu 968 mm) and 481 vias, 234 of them locked (electrode comb, escapes, the USB pair, GND fan-out,
stitching). The review's changes were made by moving the parts, ripping up the copper they disturbed and closing it
again with `layout.py --complete`, not by a fresh Freerouting run; `layout.py` carries the same placement and
pre-routes, so a fresh run starts from them (checked with `--place-only`: no pad conflicts, no clearance errors).

How it got there: Freerouting 2.1 (8 min) leaves ≈ 90 connections open on this board, mostly around the module.
Its passes stall, and in some runs it hung after an internal error. The grid router (`tools/finish_route.py`)
connects the rest, with rip-up, then the pours, the clean-up and the GND stitching are added and the loop repeats
until DRC shows nothing open (the logged run needed 15 finisher rounds). Freerouting has some randomness, so a
re-run gives a different but equivalent board. The run also found and fixed three generic toolchain bugs:

* `finish_route`: obstacles were grown by the new net's clearance only; KiCad uses the larger of the two nets'
  (the 0.15 mm USB class), so its new copper failed DRC and was thrown away again. It now also keeps the best round,
  and gives every failing net its turn at rip-up.
* `pcbgen.remove_debris` / `trim_dangling`: a track whose round end overlaps a pad, but whose end point lies just
  outside it, was treated as a floating spur and deleted, re-opening connections after every routing pass.
* `pcbgen` / `release.sync_fields` now copy the symbols' Description and Datasheet into the footprints (KiCad 10's
  parity compares them).

**USB D+/D−.** Before the review they were two independently routed tracks, 85 % on B.Cu: D+ above the test-pad
rows (y 28.6), D− between them (y 23.9), up to 4.7 mm apart, with no adjacent plane under 50 mm (D+) / 47 mm (D−)
of them (In2 there was signal routing, not pour) and about 25 In2 nets crossing broadside 0.1 mm below (LCD_MOSI,
LCD_SCK, LCD_BL and CAP_TX4 among them). The 0.14 mm "90 Ω" class width described none of it. Now
(`preroute_usb_pair`) they are **one locked pair**, 0.14 mm tracks 0.32 mm apart centre to centre (0.18 mm gap), on B.Cu from the module's escape
vias along y 19.2–19.6 (just above the electrode ring) and up a 45° leg to U1, over an **In2 GND strip**
(`USB_REF_IN2`, 0.6 mm wider than the pair each side, x 15–46.6, tied to In1 by 10 GND vias along its edges; the
routers are kept off it). D+ climbs to F.Cu west of U1 and enters pin 1, so the ESD array is in the line (J1 →
pin 6 → pin 1 → module; before, U1 hung off D+ as a stub); TP22 is a 2.7 mm stub, D− runs through TP23. U1's GND
pin 2 has a locked via of its own beside the D+ climb. Measured on the board before the 2026-11-08 re-route: D+
62.3 mm, D− 64.4 mm (2.1 mm mismatch). After the re-route (§7.11) KiCad 9.0.9 gave D+ 67.74 mm, D− 67.19 mm (hwtools
`pcbroute tune`, measure only, 2026-11-08: 0.55 mm skew, ≈ 3.6 ps, irrelevant at 12 Mb/s), and the routers had added
a second connection on each line between U1's two sides (D+ on In2 from J1's via (53.58, 27.25) to the climb via
(47.85, 27.45); D− from TP23 to U1 pin 4), so each line formed a loop through U1. **Fixed (§7.13):** J1 → U1 is now
pre-routed straight on F.Cu (D+ from J1's B6 via into pin 6, D− from the corner of the U behind J1's pads into pin 4),
the module side of D− (via → between R53's pads → pin 3) is locked too, and the bypasses are gone. Since §7.13 the
pair is 0.16 mm tracks with a 0.16 mm gap (89 Ω on the ordered stack, §7.1). Length before the re-route with no plane directly under it 17.6 / 15.8 mm (the stretch under the module's escape-via field, x 8–15, plus the
short F.Cu ends); In2 nets still under the pair: BTN_ZERO_N 3.6 mm, BTN_HOLD_N 3.1 mm and a few ≤ 1.4 mm. The pair
is an L4-over-L3 structure, not the L1-over-L2 microstrip the class width was estimated for, so ORDER-NOTES no
longer asks for impedance control. Full-speed USB (≥ 4 ns edges) is electrically short at these lengths either
way; the change is about common-mode loop area and crosstalk.

Not optimised by hand: the routing is what the two routers produced. It is dense and in places indirect (look at
the copper PDFs in `fab/slider/`). A hand clean-up pass in KiCad before an order would be worth it, especially
around the module and the charger.

### 7.6 DRC and schematic parity

| Board | KiCad | Errors | Unconnected | Parity errors | Warnings |
|---|---|---|---|---|---|
| slider | 10.0.8 (WSL, the gate) | **0** | **0** | **0** | `lib_footprint_mismatch` ×7 (E40, U10, J1, H2–H5) and 1 `track_dangling` (the open end of a 2.5 mm dead I2C_SCL branch on B.Cu at (16.65, 21.78) that the clean-up's six prune rounds left; harmless at 400 kHz) after §7.13 and its review; the regenerated FID1–3 match the 10.0.8 library now |
| scale | 10.0.8 | **0** | **0** | **0** | 7: `lib_footprint_mismatch` ×4 (H1, H2, FID1, FID2), `isolated_copper` ×1, `net_conflict` ×2 (parity warning) |

Under KiCad 9.0.9 (until 2026-11-08) the same boards gave the same 0 / 0 / 0 with 7 and 5 warnings: the
fiducials matched the 9.0 library.

Why each warning is intended:

* **E40**: the instance carries the SPEC D5 electrode geometry (64 fingers + the full RX strip as pads); the library
  seed is pre-D5. Fix in `sheets/sensor_cap.py` (below), not on the board.
* **U10**: the library's 15 mm antenna rule area and courtyard are removed on purpose (SPEC D4 deviation, §7.2),
  and its outline silk is clipped where it ran over the left and top edges.
* **J1**: its shell outline silk is clipped where it ran past the right edge (the receptacle overhangs the edge by
  1 mm). This replaced the four `silk_edge_clearance` warnings (`silk.clip_silk_at_edge`, layout.py).
* **H2–H5**: B.Mask removed from the tab-hole pads (no exposed copper 0.15 mm over the beam, SPEC §2.1).
* **FID1/FID2 (scale)**: the board keeps the KiCad 9.0 library's `Fiducial_1mm_Mask2mm`; KiCad 10.0.8's copy of
  that footprint differs (§7.12). The slider's FID1–3 were regenerated from the 10.0.8 library in §7.13. The fiducial copper and mask are unchanged; updating them from the
  library is not needed for the order.
* **Scale H1/H2** (`lib_footprint_mismatch`, `net_conflict` "no pad for pin 1 (GND)"): the netlist still has plated
  M2 holes; the instances are the SPEC Ø1.0 NPTH alignment holes, which have no copper pad for the GND pin.
* **Scale `isolated_copper`**: the back GND plane connects to nothing once the holes are NPTH (the scale is bonded
  with no fastener). Intentional for now; whether to tie it to the beam is an open question (§7.9).

The full reports: `caliper/hardware/kicad/<board>/*-drc.rpt` (`--severity-all`) and
`caliper/hardware/fab/<board>/drc-parity.rpt` (the release gate, errors only).

### 7.7 Release (fab package)

`release.py` writes, per board: gerbers + drill (zip), PDFs per side and per copper layer, the schematic PDF, 3D
renders and `ORDER-NOTES.md`; for the slider also the JLCPCB BOM and CPL. Order settings: [Assembly](assembly.md).

* **Scale: released** (both gates passed; no BOM/CPL: no parts. jlcplace checks it with an empty CPL: nothing on the
  board needs placing and gerbers.zip is this board's, plotted from the aux origin).
* **Slider: released** (2026-11-08): the DRC/parity gate and the jlcplace placement gate pass. Before §7.11 it was
  review-only: with the Hirose FH12 land the C2911931 part's fitting nails landed 1.3 mm off their pads.
* **jlcplace placement gate** ([jlcplace](https://github.com/tyevco/jlcplace) 0.2.1, `tools/jlcplace_gate.py`; how to
  run it: [Assembly](assembly.md#_6-jlcplace-placement-gate)). `jlcplace cpl` writes the slider CPL from the Gerbers'
  (0, 0) with the corrections stored in `caliper/hardware/design/jlcplace-db/` (44 LCSC codes, fitted 2026-11-08,
  status auto: derived numbers only, no EasyEDA geometry), then `jlcplace check` puts JLC's own EasyEDA footprint down
  at every row over `gerbers.zip`, with the BOM, and compares the nets each EasyEDA pad lands on, the LCSC pin names
  against the symbol's pin functions, polarity, the Gerbers' origin and the bottom-side reading. Any red row or red
  run finding refuses the package. Result after §7.13 (2026-11-08): slider **102 rows (C13 added): 0 red, 0 yellow,
  102 green** (BZ50 is green through the manual non-polar decision now stored in `jlcplace-db/C910763.json`; its
  polarity stays a preview-checklist item; before: 101 rows, 0 red, 1 yellow, 100 green); scale 0 rows,
  0 red. Before the decision BZ50 was the one yellow row: EasyEDA draws no "+" and names no pins, so the pad
  numbers alone decide its polarity. The datasheet shows the part is non-polar, so either way round is fine. It stays
  on the preview checklist with U30's bottom-side reading.
  The rows jlcplace writes match the previous `tools/jlc_cpl.py` CPL to 0.5 µm and the same angles; `jlc_cpl.py` and
  `jlc_offsets.json` (which kept EasyEDA pad coordinates in this public repository) are retired.

### 7.8 Renders

| | Top | Bottom |
|---|---|---|
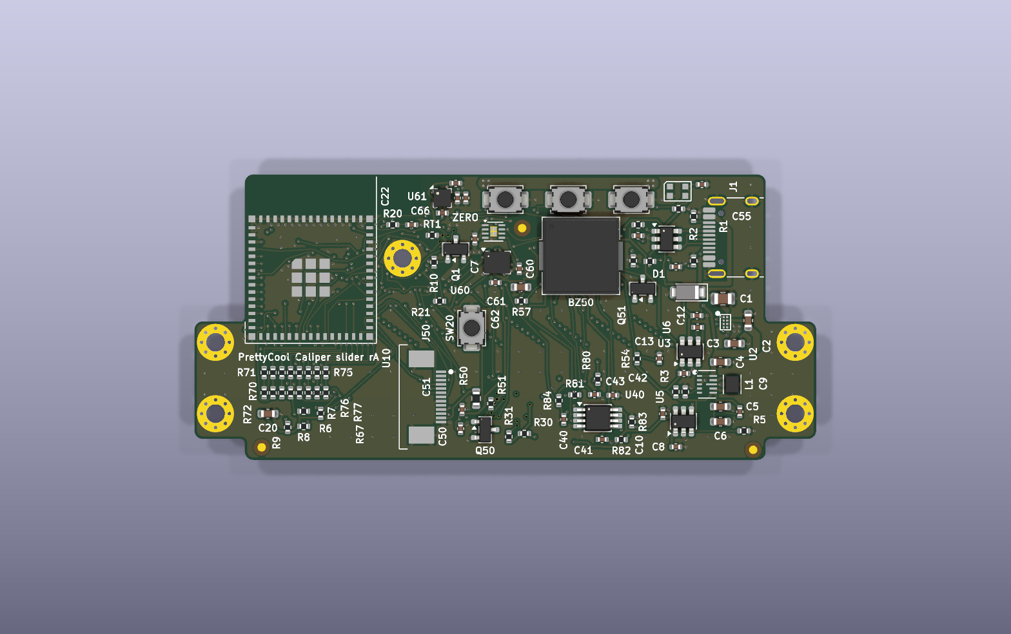
[picture p1: caliper/hardware/fab/slider/prettycool-caliper-slider-3d-top.png]
slider top
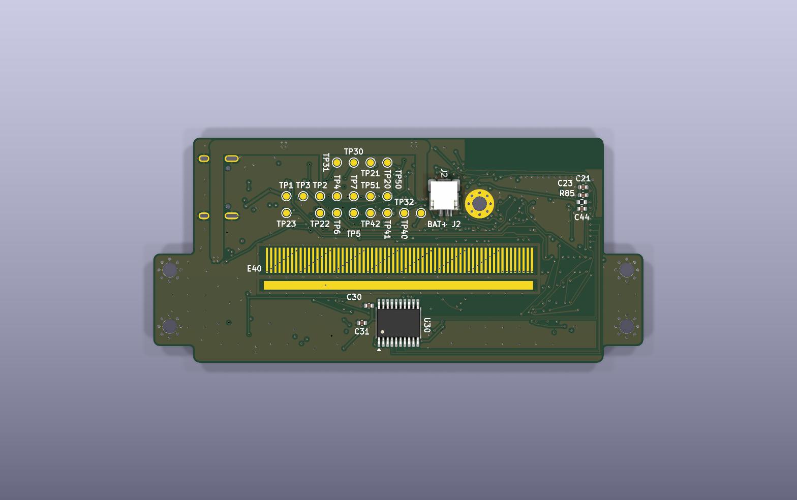
[picture p2: caliper/hardware/fab/slider/prettycool-caliper-slider-3d-bottom.png]
slider bottom
| Slider (`release.py`, KiCad 10.0.8) |  |  |

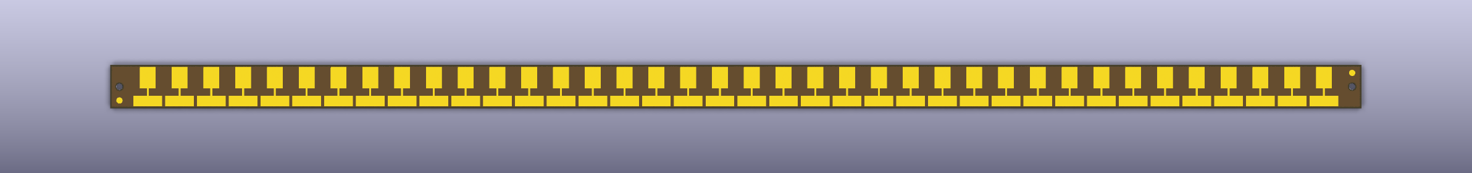
[picture p3: caliper/hardware/fab/scale/prettycool-caliper-scale-3d-top.png]
scale top


The module has no 3D body in the render (no model is installed for the KiCad footprint); the display glass, the
battery and the standoffs are not on the board.

### 7.9 Open layout items

* **SPEC table updates** for the moves above: done 2026-11-08 (SPEC §2.1 and §11). The mechanics re-extracted the
  envelope from this board and re-ran `clash_check.py`: 0 clashes ([Mechanics](mechanical.md) §12). With the module
  at x 7.85 the PA-CF moving inside jaw was 4.70 mm in plan from the antenna, inside SPEC D4's 5 mm. Its root
  flank was first relieved round the antenna corner; since the jaw's stiffening (2026-11-08) its root block runs
  under that corner and the part within 5.15 mm prints in unfilled PA through the body's RF modifier, so the PA-CF
  still keeps 5.15 mm ([Mechanics](mechanical.md) §9, §12).
* **Schematic-track items the board carries as layout edits**: the E40 footprint (should become the 64-finger + RX
  geometry; for a bottom placement at rotation 0 its RX pad must sit at local y −3.75) and the scale's Ø1.0 NPTH
  holes. (H5 and the module decoupling were closed on 2026-11-08, §7.11; the SMT standoffs are hand-fitted.)
* **USB**: the first 7 mm of the pair, under the module's escape-via field, has no plane directly under it (§7.5).
  The bypasses around U1 that the 2026-11-08 re-route had added are gone (§7.13). sicalc put MAG_A → D+ at 25.5 mV
  (5.9 mm at 0.18 mm on B.Cu along the pair's jog at x 10–14, y 20.5; I2C_SCL sat there before, 22.4 mV) against
  its 10 mV USB budget: a GND guard or a re-route of that jog (§7.14). Each rework since has put another line
  beside the pair: IMU_INT2 → D+ 26.9 mV on 2026-11-09, and since 2026-11-10 **I2C_SCL → D+ 27.8 mV and IMU_INT1 →
  D− 19.5 mV** (§7.15). The guard should be a rule area in `layout.py`, so that a rework cannot do it again.
* **`--rework` and Freerouting**: Freerouting does not see U1's jumper pad groups, so a rework that runs it puts a
  bypass round U1 back on each USB line, and it re-writes pieces of the VBUS / VBAT pre-routes; finish such a rework
  with `--rework --rip USB_DP,USB_DM,VBUS --no-freerouting` and `--rip VBUS,VSYS,VBAT --no-freerouting` (§7.14), or
  drop the USB nets from its DSN (not done yet).
* **From the hwtools run on the re-routed board (2026-11-08)**: the VBAT run, U6's input capacitor, the VBUS / TVS
  order, CAP_RX and the missing stack-up were fixed on 2026-11-08 (§7.13). Still open from that list:
  * **Backlight corner current**: R50 15 Ω gives up to ≈ 31 mA at VF 2.9 V and +3V3 at its top tolerance against the
    panel's 20 mA typical rating (§3.5 gives ≤ 27 mA at nominal +3V3). R50 18–22 Ω or a firmware PWM duty cap; an
    owner decision, not changed.
  * **CAP_RX in firmware**: the crosstalk estimates in §7.13 are upper bounds; still, do not sample during I2C
    traffic or LED updates where it costs nothing.
* **Antenna**: 5 mm clearance, not 15 (SPEC D4); BLE/Wi-Fi range test at bring-up.
* **Electrode buses under the fingers** (In2, 0.1 mm under B.Cu): ≈ 17 fF per bus/finger crossing. Every finger and
  every bus is driven through 100 Ω, so this crosstalk between driven nodes does not move a finger's potential; the
  coupling that matters is into the RX strip, and the In2 GND guard sits between the buses and the strip. Worth a
  look at bring-up, not expected to be a fixed offset source.
* **Scale back plane** floats (no fastener); decide whether to tie it to the beam.
* **Freerouting** stalls on this board; the grid router does most of the closing (§7.5). Re-runs differ: the first
  fresh run on KiCad 10 left USB_CC2 and CHG_INT_N open (§7.12). Changes are therefore made with `layout.py
  --rework` (§7.13), which keeps the routing of every unchanged net; a full fresh route has not been tried since.
* **Hand review** of the routing in KiCad before ordering (density around the module and the charger).

### 7.10 Layout review (2026-11-08)

An adversarial review of the routed slider and the scale, measured with pcbnew scripts on the board files (KiCad
9.0.9 in WSL) and by looking at per-layer plots and the renders. **Fixed** = changed in `layout.py` / the tools and
on the board, then the DRC/parity gate and `release.py` re-run.

| Check | Finding | Result |
|---|---|---|
| USB pair, ESD, reference plane | two separate tracks up to 4.7 mm apart, no adjacent plane under ≈ 50 mm, In2 signals crossing 0.1 mm below, U1 a stub on D+ | **Fixed** (§7.5): locked coupled pair over an In2 GND strip, U1 in line |
| Decoupling distance (straight line, cap pad to IC pin) | C8 / C10 (U5 in/out) 6.5 / 7.0 mm (the placer's cluster box had no room; the layout run's WARN was not acted on); C30 (AS5311 100 nF) 8.1 mm, 14.9 mm of track | **Fixed**: 1.96 / 1.66 / 1.71 mm |
| | C20 / C21 (module 22 µ / 100 n) 20.5 / 22.4 mm (§7.2 said 13) | open: SPEC call (§7.2) |
| | the rest: BQ25180 C1–C3 2.3–2.6 mm, TPS63802 C4/C5 1.65 mm and C6 3.45 mm, U60 C60–C62 1.65–2.3 mm, U40 C42 1.9 mm, C55 1.5 mm, C12 3.2 mm, C31 4.0 mm, C50/C51 2.1/3.4 mm | acceptable |
| BQ25180 / TPS63802 loops | CIN / COUT 1.65 mm from VIN / VOUT on F.Cu, L1 2.3 mm from the switch pins with short F.Cu leads; the CIN/COUT GND returns reach the IC GND through vias to In1 (0.1 mm below), not on top, because L1 and the VSYS feed sit between them; L1 16 mm from U40, U60 31 mm from L1 | acceptable (not TI's top-layer GND loop; In1 is right under it) |
| Electrode inner guard | cut back to x 17.4–50.42 by the clean-up | **Fixed** (§7.3) |
| Electrode comb vs SPEC §2.2 | 64 fingers 0.30 × 3.80 at 10.68 + 0.635 k, phase k mod 8, mask open, no paste; RX 10.68–51.32 × 11.05–12.35; ring 9.58–52.42 / 10.35–18.05, 0.40 wide; no foreign copper inside the ring on B.Cu or In2; In2 guard pour 189 mm² in one piece; comb and buses identical to a fresh generation | matches |
| Scale vs slider | 38 cells, coupler 4.58 wide at 5.08 pitch from scale x 3.73 (beam 18.23), y 10.85–17.15; Ø1.0 NPTH at scale x 1.5 / 198.5; the front is one mask opening | matches SPEC §2.2 (beam = scale + 14.5; slider electrodes beam 18.68–59.32 at R = 0) |
| Finger vias | 0.40 vias in 0.30 fingers: the annulus is 0.05 wider than the finger each side (under mask), the drill is open in the electrode; their In1 antipads merge into 8 slots (§7.1) | accepted, noted |
| Bottom side, beam band | parts only U30, C30, C31 (inside x 20–41, y 2.4–9.6) and E40; exposed copper in y < 20.5 only on those; every via tented on both sides (no via aperture in either mask gerber) | matches D2 |
| AS5311 vs tape | U30 centre (31.0, 6.0) = tape centre y 6.0, long axis along x, pads y 2.8–9.2, inside the channel window | matches SPEC; the Hall-array position inside the package was not checked against the datasheet drawing |
| Antenna | module body x 0.1–15.6, y 13.95–34.05 (flush with the top edge, top-left corner); no pad, track, via or pour on any layer in x 0–21, y 29.2–34; the pours reach y 29.0–29.2 (0.3 mm short of the antenna area at 29.5; the module's own GND pad row reaches 29.1) | matches the recorded D4 deviation |
| In1 plane under fast lines | solid (one fill outline, 92 % of the beam band) apart from via antipads and the finger-via slots; the USB pair is on B.Cu over its In2 strip; LCD SPI lines cross the slots for ≈ 1 mm each | acceptable |
| Thermal reliefs | all pours thermal (0.3 gap / 0.3 spoke); no starved-thermal or unconnected pad in DRC | acceptable |
| Copper balance (y 0–20) | F 67 %, In1 92 %, In2 65 %, B 66 % | outer pair balanced, inner not (§7.1) |
| Silk | 0.8 mm / 0.15 mm text (JLC's minimum), 34 references hidden where there is no room | legible at the limit |
| CPL rotations | JLC placement simulation on every row: all land on copper except J50 (the known part/footprint mismatch); the moved C8 / C10 / C30 pass | unchanged: review-only |
| Fab notes | asked for impedance control on a structure that did not exist; said vias were tented "on top" (they are tented on both sides) | **Fixed** in `release.py` (ORDER-NOTES) and [Assembly](assembly.md) |
| KiCad 10 | a zero-length track left by the clean-up was a `tracks_crossing` error in KiCad 10 only | **Fixed**: `finish()` drops zero-length segments |

Not checked: no field solver, SI, RF or thermal simulation; the routing outside the areas above was not
hand-reviewed. The mechanical clash check was not part of this review; the mechanics track ran it afterwards on the
reviewed board (C8 / C10 / C30 at their new positions): 0 clashes ([Mechanics](mechanical.md) §12).

### 7.11 Hardware changes after phase 3 (2026-11-08)

Made in the sheet modules and `layout.py`, then the slider was re-placed and re-routed from scratch (`layout.py
--board slider --route --minutes 8 --attempts 1`: Freerouting left 87 connections open, the grid router closed them,
then `--finish`). Result: 2940 mm of track (F.Cu 1061, In2 898, B.Cu 980), 479 vias (243 locked); KiCad 9 DRC +
parity 0 / 0 / 0 (7 warnings, §7.6); KiCad 10 the same; `release.py` passes for both boards; the mechanics' clash
check: 0 clashes. The record is [SPEC §12](../hardware/design/SPEC.md#_12-hardware-changes-after-phase-3-2026-11-08).

| Change | Detail |
|---|---|
| Battery reverse-polarity FET **Q1** (AO3401A, C15127, Basic) + R10 10 k | J2 pin 1 → VBAT_RAW → Q1 drain; source → VBAT; gate → R10 → GND. ≤ 43 mV / ≤ 21 mW at 0.5 A (VGS −3.0 V, bounded by the 85 mΩ maximum at −2.5 V; ≈ 28 mV typical), ≤ 21 mV at the 250 mA charge current. VGS max ±12 V: no zener. Reversed cell: off; reversed cell plus USB: the charger trickles 8 mA into Q1 at its threshold (≈ 40 mW) until its timer ends it. VBAT_RAW is in the 0.30 mm Power class. §3.1 |
| I2C pull-ups R6/R7 **2.2 k** | 205 ns rise at ≈ 110 pF (was 438 ns), ≤ 1.4 mA sink at 0.4 V (§3.1) |
| **J50 land** from the C2911931 vendor drawing | own footprint, checked against the EasyEDA land; the CPL row now lands on copper. Pin 1 at y 10.5 (the +y end of the row); the panel tail needs its contacts on the viewer side and pin 1 on +y before the fold (SPEC §2.1). §3.5 |
| **Module decoupling** C21 100 nF + new C23 10 µF (0402) on the **bottom** under pad 3 | 1.9 mm from pad 3; C20 22 µF stays on top as the bulk. §7.2 |
| **E40 pins** renamed PHASE0…7 / RCV | boardcheck's name-based UART check no longer pairs E40 with U10 TXD0 (§3.4) |
| **H5** in the schematic | parity no longer needs a board-only footprint; the SMT standoffs are hand-fitted (§3.1) |
| **Silk** | J1 and U10 outline silk clipped at the board edge: the four `silk_edge_clearance` warnings are gone (§7.6) |

Placement moves for these: Q1 (25.1, 25.1), R10 (22.5, 23.5), RT1 (24.5, 26.5) → (22.3, 26.75), C7 → (27.37, 26.3),
C21/C23 bottom (3.1, 26.5 / 25.3). A fresh route moves most other tracks, so the per-net figures in §7.5 and the
review table in §7.10 (USB lengths, copper balance, decoupling distances other than the above) describe the previous
board and were not re-measured.

### 7.12 Move to KiCad 10.0.8 (2026-11-08)

On 2026-11-08 WSL's KiCad went from 9.0.9 to **10.0.8** (kicad-cli, the `pcbnew` module and the 10.0.8 symbol,
footprint and 3D libraries). The toolchain was ported (API and file-format changes: [`tools/README.md`, "KiCad
10"](https://github.com/tyevco/prettycoolboards/blob/main/tools/README.md#kicad-10)) and both boards were moved
**without a design change**. KiCad 10 is now the only KiCad: the "KiCad 10 second opinion" files that used to be
copied into `fab/` by hand are gone. Evidence, all from pcbnew 10.0.8 / kicad-cli 10.0.8 in WSL:

* **Schematics** regenerated by `build.py` in the KiCad 10 format (`kicad-cli sch upgrade` of every generated sheet
  changes only token order and formatting, apart from the pin UUIDs KiCad adds for the other units of the
  multi-unit U40; the review also found 8 pairs of wires on the power and UI sheets sharing a UUID, a generator bug
  older than the move, now fixed: `tools/README.md`, "KiCad 10"). Wiring check passes; ERC: slider the same 2 waived
  `pin_to_pin`, scale clean; no new ERC rule fires (KiCad 10's report also lists the 4 checks the default settings
  ignore).
* **Netlists**: `netlist_diff.py --strict-fields` against the KiCad 9 netlists is **IDENTICAL** for both boards
  (98 nets / 129 parts / 398 pins on the slider) once `--pin-rename J1:S1=SH` maps the one pin the 10.0.8 library
  renamed (the USB-C shield). Format-only differences, not counted: KiCad 10 writes an empty datasheet as `""`
  (9: `"~"`, 105 parts), pin functions as `name_number`, and each net's class as the project's net-class patterns
  assign it (9: `"Default"` everywhere; nothing reads it). `check_contract.py`: OK.
* **Boards**: the committed routed boards were loaded and saved by pcbnew 10, not re-routed. A pcbnew script compared
  them with the KiCad 9 files: tracks (1671), vias (479), zones (12) and their fills (18 layers), pads (524 with
  nets), footprints (129) and copper drawings (124) are **identical** in count, coordinates and nets on the slider,
  and the scale likewise (1 zone, 4 pads, 43 drawings). The only edit: J1's four shield pads renumbered `S1` → `SH`
  to match the symbol (same copper, same GND net). Its footprint is otherwise the 9.0 copy: 10.0.8 draws that
  receptacle's signal pads as rounded rectangles, and updating it would change copper.
* **DRC + parity** (`--severity-all`): 0 errors, 0 unconnected, 0 parity on both (§7.6); the new warnings are the
  `lib_footprint_mismatch` of the fiducials against the 10.0.8 library.
* **Fab outputs** regenerated by `release.py`: every Gerber layer and both drill files of both boards are
  **geometrically identical** to the KiCad 9 package (same flashes, draws, arcs and regions per polarity block; only
  the header, the object order and the `J1,SH` pad attribute differ). BOM, CPL and `jlcplace-checklist.md` are
  byte-identical; jlcplace 0.2.1 still gives slider 101 rows, **0 red, 1 yellow (BZ50)**, 100 green, scale 0 rows.
* **Toolchain on pcbnew 10**: `layout.py` re-places the slider exactly where the committed board has every part
  (129 / 129 footprints at the same position, side and angle) and regenerates the scale copper-identical; `--finish`
  runs. One fresh `--route --minutes 8 --attempts 1` run of the slider in a scratch copy worked end to end on
  pcbnew 10 (Freerouting left 154 connections incomplete, about as many as the KiCad 9 run's 153; the grid router,
  clean-up, pours, stitching and silk all ran; 113 min) but ended with **2 connections open**, both routing outcomes
  rather than port defects: Freerouting ran VBUS through the gap between R2 and J1 that USB_CC2 needs (VBUS is
  Power class, which the grid router may not rip up), and CHG_INT_N found no path out of U2's 0.4 mm-pitch ball
  array. With that VBUS detour removed, `--complete` closed USB_CC2 at once; CHG_INT_N stayed open. Everything else
  on that board passed DRC and parity (0 errors). The committed board is not affected (it keeps its KiCad 9 routing);
  a future fresh route may need another run or a locked CC pre-route (open item).
* **Mechanics and firmware**: `extract_board_parts.py` writes the same `board_parts.json`, `clash_check.py` 0
  clashes, the mechanical tests and `tools/tests` pass, `gen_pins.py --check` and `pin_plan.py --check` up to date.

### 7.13 Phase-4 review fixes (2026-11-08)

The hwtools run and the phase-4 review found seven board / design issues (§7.9). Each fix is in the generators
(`sheets/*.py`, `layout.py`, `tools/`), so a regeneration reproduces it; nothing was edited by hand on a board. Designed,
not built: every number below is a calculation on the board files, not a measurement.

**How the board was changed (`layout.py --rework`).** A full fresh route does not reliably close on KiCad 10 (§7.12),
so the committed routing was kept: `--rework` regenerates the placement and every pre-route (child process), copies
the routed tracks and vias of every net it did not change from the old board, drops the copied items that now
collide with a new part or pre-route (shape check against the net classes, then DRC), routes what is open with
Freerouting while everything else is locked (and unlocks it again), then the grid router, pours, clean-up and
stitching as usual. Re-done here: the nets of the moved / new parts (D1, C53, C13, R85, C44, TP42), VBAT, VBAT_RAW,
VSYS, VBUS, USB_DP/DM, CAP_RX, CAP_LP1, plus whatever the new copper cut (FG_ALRT_N, I2C, CHG_TSMR, RGB_DIN, MAG_A,
IMU_INT1/2 and a few more were re-routed round the VBAT riser and the CAP_LP1 run). Toolchain fixes found on the way:
`finish_route.drc_uuids` now runs DRC with the board's own project file (a process that had built a board in memory
handed KiCad a default project: 0.5 mm minimum via, no net classes); `generate()` writes the net classes into the
`.kicad_pro` (pcbnew does not save the project of an in-memory board, so the USB and new classes never reached it);
`pcbgen.trim_dangling` no longer cuts locked copper and `dedupe_tracks` keeps the locked one of two identical
items; locked pre-routes that Freerouting rewrites on import are put back, and only they stay locked afterwards;
the grid router's clusters honour jumper pad groups; regenerated escape stubs / vias that the old board had pruned
(unused) are left out, because the old routing used that room. The board was reworked twice: from the committed
board (everything above), then from that result with USB_DP / USB_DM re-done once the U1 jumper groups and the
router fixes were in. Results below are the routed board's (resistance: a resistor network of the board's own tracks and vias,
35 µm outer / 15.2 µm inner copper, 20 µm via plating, pads ideal).

| # | Issue | Fix | Before → after |
|---|---|---|---|
| 1 | VBAT Q1 → U2 BAT: 0.30 mm over F.Cu, 18.9 mm B.Cu, 10.3 mm 0.5 oz In2, three single 0.25 mm vias | `preroute_vbat`: Q1's source → 3 vias → 2.0 mm B.Cu riser → 2.1 mm B.Cu band along the top edge (1.3 mm F.Cu strip in parallel over x 28–48.6, 2 × 2 vias at each end) → 1.9 mm B.Cu riser down x 58.4 between J1's shell tabs (band and riser doubled on In2) → 4 vias beside U2 → F.Cu to C3 and the BAT ball; BAT's DSBGA neck 0.12 → 0.25 mm (0.15 mm inside the ball's mask opening, review 2026-11-09) | Q1 → BAT ball **95 → 11.7 mΩ** (47.5 → 5.8 mV at 0.5 A; target ≤ 15); Q1 → C3 88 → 11.5 mΩ |
| 1 | J2 → Q1 (VBAT_RAW) | `preroute_vbat_raw`: 0.60 mm, the pads' width | 4.0 → 2.1 mΩ |
| 1 | U2 SYS → VSYS → TPS63802 VIN | `preroute_vsys`: SYS neck 0.25, 0.30 to C2, 0.80 mm C2 → C4, 0.60 / 0.25 into VIN, EN 0.20 | SYS → U3 VIN **20.9 → 11.8 mΩ**; → C4 18.5 → 10.0 |
| 1 | J1 → U2 IN (VBUS) | `preroute_vbus` (item 3), IN neck 0.25 / 0.30 | A4/B9 → IN 17.6 → 10.7 mΩ; A9/B4 → IN 22.5 → 18.5 mΩ (the two pad pairs are joined in the plug, so in use they are in parallel) |
| 2 | U6 (+3V3_UI switch) had no input cap; C5 12.5 mm away by copper | **C13** 1 µF 0402 (C52923, Basic) in `sheets/power.py`, fixed at (52.25, 10.3) under U6's VIN / GND pins | none → C13 pad 1.5 mm (centre to centre) from U6 pin 1 |
| 3 | J1's A9/B4 reached U2 along x 57.5 without passing D1 | `preroute_vbus`: D1 turned 180° and moved to (52.7, 19.95) so its VBUS pad faces east; A4/B9 (x 54.15, 0.40 mm) and A9/B4 (under the receptacle, x 57.65, 0.50 mm) both end on D1's pad, and the run to C1 (0.60) and U2 IN (0.50) leaves from it | every J1 VBUS pad now reaches U2 only through D1's pad; J1 A9 → D1 27.4 → 13.3 mΩ |
| 4 | CAP_RX 60 mm beside digital lines, R85/C44 at U40, ≈ 40 mm from GPIO1 | R85/C44 fixed on the bottom under the module beside GPIO1's escape via (SPEC §2.1 exception extended to y 22.7); the long run is now CAP_LP1 (390 Ω + 1 nF at its source end), pre-routed (`CAP_LP1_PATH`: the corridor the old CAP_RX used, an In2 hop round Q1, then F.Cu over the In1 plane, crossing the electrode via field in the channel between two phase staircases); net class **Analog** (CAP_RX, CAP_LP1): 0.2 mm from every other net (0.3 cannot cross the via field). TP42 moved from CAP_RX to CAP_LP1 | CAP_RX copper 60.1 → **2.9 mm**; R85 / C44 41.5 mm → 1.9 mm from GPIO1's pad; CAP_LP1 57.9 mm |
| 4 | crosstalk into the ADC line | hwtools `sicalc xtalk` (config below), same JLC04101H-3313 stack before and after | CAP_RX: worst **11.0 mV** (FG_ALRT_N, 11.6 mm edge-coupled on B.Cu), 7 aggressors over the 1 mV budget → worst **0.14 mV**, none over |
| 5 | no stack-up in the board file | `SLIDER_STACKUP` written into the board (JLC04101H-3313, §7.1), ORDER-NOTES names it; USB class 0.16 / 0.16 mm, a 90 Ω differential pair class | USB pair Zdiff (sicalc, mask + etch) 96.7 → **89.4 Ω** (it read 125 Ω on KiCad's default stack) |
| 6 | each USB line looped through U1 (D+ In2 J1 via → climb via; D− TP23 → U1 pin 4) | J1 → U1 pre-routed straight (`USB_J1_U1`), D− via → pin 3 locked, and U1's pins 1/6 and 3/4 declared **jumper pad groups** (they are one conductor in the USBLC6): KiCad then sees each line connected through the part and no router adds the bypass back (it was the routers' answer to "pin 1 and pin 6 not connected") | bypasses gone; D+ / D− J1 → U1 on F.Cu only |
| 7 | schematic readability | `schgen`: when the in-order rows do not fit a paper size, a first-fit-decreasing-height packing (whose last row may sit left of the title block) is tried before going up a size | power sheet **A2 → A3** (it was more than half empty); every sheet is A3 now. R50 still sits ≈ 45 mm of wire from J50 pin 12 and the dense sides keep their fanned labels (not changed: the placer's spine logic, more than a modest change) |

**CAP_LP1 crosstalk** (closed 2026-11-09, §7.14: worst 20.4 → 0.88 mV): the same scan flagged the new long run itself. Worst BTN_MODE_N 20.4 mV (5.7 mm broadside,
B.Cu over the In2 leg), then BOOT_N 4.4, RGB_DIN 3.7, IMU_INT2 3.2, I2C_SDA 3.0, BUZZ_D 1.8 mV. sicalc models a
terminated line; CAP_LP1 is not: 1 nF (C43) holds its source end and the coupled charge is filtered by R85 / C44
(408 kHz) before the ADC, so these are upper bounds, far above what reaches CAP_RX. The button and LED lines do not
switch during a burst in normal use.

**Independent check of this rework (review 2026-11-09, own pcbnew scripts on the committed board vs HEAD 2e86e8b):**

* **Two defects found and fixed** (the board was reworked once more, `--rework --rip VBUS,VSYS,VBAT` from the board
  above):
  * **DSBGA necks wider than the ball land.** The 0.25 mm IN / SYS / BAT necks started at the ball centre, so inside
    the ball's mask opening (r 0.14) the wetted copper was wider than the 0.23 mm NSMD land. TI's DSBGA land rule keeps
    the trace at the land to ≤ 2/3 of its diameter, or the joint wets off-centre. `preroute_bga_escape` now runs
    0.15 mm (`BGA_PAD_TRACE_MAX`) out to 0.27 mm from the centre and widens after that (+0.3 mΩ per ball).
  * **The grid router cut pre-routes short.** `finish_route.anchor_end` splits a track where a new route joins it
    part-way along, but pcbnew's `GetEnd()` returns a reference to the track's own point, so after `SetEnd()` the
    "tail" became zero-length and the far part of the track was lost (then pruned as dangling). In the board above
    this had already replaced the 0.50 mm C1 → U2 IN run with 0.30 mm router copper and cut the A4 feed and the In2
    band. On a rework that taps the VBAT band, it removed the whole B.Cu band east of the tap and the B.Cu riser
    (VBAT went to 25 mΩ, DRC still clean). Fixed: the split copies the points (`tools/tests/test_finish_route.py`).
    Every generated pre-route item is now on the board, locked (checked against a fresh `--place-only`).
* Resistances on the final board by a separate network solver (same copper figures; via barrels over the full
  1.0 mm): VBAT Q1 → BAT 97 → 12.7 mΩ, Q1 → C3 12.0, J2 → Q1 2.1, VSYS SYS → U3 VIN 12.0 (→ C4 10.2), VBUS
  A4/B9 → IN 11.2, A9/B4 → IN 18.1, A9/B4 → D1 12.9 mΩ: the table's figures within ±1 mΩ.
* D1: removing every VBUS item whose copper touches D1's pads leaves J1's pads reaching only each other and U1's
  VBUS pin / TP1 (the ESD clamp's reference and the test pad, joined on the A4/B9 side), never C1 or U2 (at HEAD, J1
  still reached C1 and U2), so every J1 → U2 path crosses D1's pad.
* C13: +3V3 pad → U6 pin 1 1.7 mm of copper (the +3V3 feed passes C13 first), GND pad → the GND via U6 pin 2 uses.
* CAP_RX 2.9 mm, R85's pad 1.94 mm from GPIO1's pad; CAP_LP1 keeps ≥ 0.22 mm from other nets and does not run
  beside any CAP_TX / CAP_EL_TX copper. The sicalc scan reproduces the numbers above on the committed board.
* USB: 31.8 mm of the pair at exactly 0.16 mm gap, 0.16 mm tracks (0.15 at J1's pads); a closed-form edge-coupled
  microstrip estimate on the 0.0994 mm prepreg gives ≈ 91 Ω before mask, consistent with the field solve's 89 Ω.
  D+ is J1 → U1 pin 6 / pin 1 → module, D− J1 → pin 4 / pin 3 → module, no other copper; U1 carries
  `jumper_pad_groups` (1 6) (3 4).
* Decoupling (shortest copper from each cap to its IC pin): no cap other than C13 moved; C1 3.4 → 2.7 mm, C3
  3.5 → 2.6 mm and C2 2.4 → 2.6 mm to U2 (SYS's escape now passes over C2 into its pad 1), C4 1.5 → 1.7 mm, the
  rest unchanged within 1 mm. C62 (U60's VDD_IO 100 n) is not tracked to pin 10 on either board: it reaches it
  through the In2 +3V3 pour (pre-existing; C61 10 µ is 1.8 mm of copper from pin 10).

Side effects of the rework (not defects, but the board did change outside the seven items):

* The B.Cu VBAT riser above Q1 and the top-edge band pushed some signals round: I2C_SCL 73 → 108 mm (+2 vias),
  BUZZ 40 → 58 mm, BTN_MODE_N 60 → 77 mm (+7 vias), LCD_BL 38 → 55 mm, BTN_HOLD_N 62 → 72 mm. None is timing-
  critical (400 kHz I2C, 2.2 k pull-ups: about 4 pF more).
* GND stitching vias 192 → 179: the row along the top edge (y 32.8, x 27–58) is gone under the VBAT band, and four
  grid vias at y 5.3 (x 12.7–20.2) gave way to I2C_SCL. F.Cu and the In1 plane still run to the edge there.
* The VBAT band (B.Cu, y 31.5–33.6) lies under the button-band ledge (x 29–57.5, y 32.6–34), which a button press
  loads. It is under mask and its vias are tented, so SPEC's "no exposed copper" holds, but keep at least one Kapton
  layer on the ledge when shimming it ([Mechanics](mechanical.md) §7 step 6): the body may be PA-CF.
* The button lines' press edges are fast (the switch discharges the 100 nF debounce cap), but a press is rare and
  the firmware sees it (GPIO edge), so a capacitive burst that overlaps one can simply be dropped.

Scan config (`caliper/hardware/design/xtalk-cap.yaml`, `python -m sicalc xtalk <board> --config ...` from hwtools): victims CAP_RX, CAP_LP1, CAP_AMP_OUT at a 1 mV budget; aggressors the
digital lines that may switch during a measurement (RGB_DIN, I2C_*, MAG_*, LCD_*, BTN_*, BUZZ*, IMU_*, CHG_INT_N,
FG_ALRT_N, SNS_PWR_EN, BOOT_N, MCU_EN, CAP_TX*, USB_D*) as 3.3 V / 2 ns waves, plus sicalc's default classes.

**USB after §7.13:** D+ 60.0 mm (F.Cu 8.1, B.Cu 51.9), D− 57.6 mm (F.Cu 11.6, B.Cu 45.9), all of it the locked pre-route
(no router copper left on either line), 2.4 mm skew (≈ 14 ps, irrelevant at 12 Mb/s). The same scan puts I2C_SCL → D+
at 22 mV (unchanged from before) and, after the re-routes, IMU_INT1 → D− at 13 mV against sicalc's 10 mV USB budget
(terminated-line upper bounds; full-speed USB receivers have ≥ 200 mV of differential margin and reject most of it as
common mode).

**Gates (2026-11-08, KiCad 10.0.8, WSL):** `build.py` wiring check and ERC as before (2 waived `pin_to_pin`); netlist
vs the previous one: the intended changes only (C13 added, TP42 CAP_RX → CAP_LP1); `netlist_diff.py --strict-fields`
IDENTICAL across the `schgen` packing change; DRC + schematic parity **0 errors, 0 unconnected, 0 parity** (warnings:
7 `lib_footprint_mismatch`, 2 `track_dangling` 0.035 mm router stubs; after the review's rework 1, see above); `release.py` PASS on both boards; jlcplace slider
102 rows 0 red; `check_contract.py` OK; firmware `gen_pins.py --check` / `pin_plan.py --check` up to date;
`tools/tests` 18 passed; mechanics `extract_board_parts.py` + `clash_check.py` on the reworked board: 108 envelopes,
6255 intersections, **0 not clear, 0 FAIL / RISK** (R85 / C44 under the module, 0.5 mm, inside the 0.75 mm floor gap).

### 7.14 CAP_LP1 crosstalk shield (2026-11-09)

Designed, not built: every number below is a calculation on the board file (hwtools `sicalc xtalk`, config
`caliper/hardware/design/xtalk-cap.yaml`, the JLC04101H-3313 stack in the board), not a measurement.

**Problem (§7.13, open item).** CAP_LP1, the 58 mm run from R84 / C43 at U40 to R85 under the module, was the victim
of every digital line over the 1 mV ANALOG budget. All of it sat on the two stretches that are not F.Cu over the In1
plane: B.Cu under the module (R85 → the climb past H1) and In2 from H1 to TP42. B.Cu and In2 are only 0.1 mm apart
and In2 has no GND plane of its own, so a line on B.Cu over the In2 stretch couples broadside, and the B.Cu stretch
has no ground closer than In1 (0.77 mm down):

| aggressor | where (before) | before | after |
|---|---|---|---|
| BTN_MODE_N | B.Cu right over the In2 stretch, 5.7 mm (15 mm alongside), offset 0.13 mm | **20.4 mV** | 0.88 mV (F.Cu, 4.4 mm at 0.49 mm in the electrode-field channel at x 38.9, F.Cu over In1: the lower half, unchanged) |
| BOOT_N | In2, 0.73 mm beside the In2 stretch's start | 4.4 | 0.03 (GND guard 0.53 mm wide between) |
| RGB_DIN | B.Cu, 0.44 mm beside the B.Cu stretch at the module's right edge | 3.7 | not coupled |
| IMU_INT2 | B.Cu, 0.42 mm beside the B.Cu stretch | 3.2 | 0.64 (F.Cu beside the short F.Cu hop by H1, 1.8 mm at 0.35 mm) |
| I2C_SDA | B.Cu, 0.37 mm beside the B.Cu stretch | 3.0 | 0.14 (GND guard 0.33 mm wide between) |
| BUZZ_D | B.Cu over the In2 stretch at TP42 | 1.8 | not coupled |

**Fix (`layout.py`: `CAP_LP1_SHIELD`, `cap_lp1_shield_keepouts`, `cap_lp1_ref_zone`, `cap_lp1_stitch`).** The pre-route
(`CAP_LP1_PATH`) is unchanged; each of its two inner stretches gets a 2 mm wide shielded corridor (1.0 mm either side
of the centre line):

* **Its own layer** (B.Cu for the B.Cu stretch, In2 for the In2 stretch): rule areas (no tracks) from 0.3 mm to
  1.0 mm either side, so no other line runs closer than ≈ 0.85 mm edge to edge, and the GND pour fills the gap.
* **The neighbouring layer** (In2 under the B.Cu stretch, B.Cu over the In2 stretch): a no-track rule area over the
  whole 2 mm band, cut by 0.8 mm crossing windows every 1.6 mm, so other nets still cross at right angles (a crossing
  couples over ≈ 0.2 mm, a parallel run over all of it) but none runs along it. The module's right-column escape vias
  inside the B.Cu stretch's band get a window of their own; the B.Cu test pads over the In2 stretch (TP30–TP41) get a
  channel out of the band on their far side.
* **GND copper**: an In2 GND zone over both bands (`CAP_LP1_REF_IN2`, priority 2 over the In2 +3V3 pour), so the In2
  stretch is a stripline with GND 0.2 mm beside it on In2 and the B.Cu GND pour 0.1 mm above it, and the B.Cu stretch
  a microstrip 0.1 mm over In2 GND with the B.Cu pour beside it; tied to In1 by GND vias 0.62 mm either side of the
  centre line every ≈ 1.6 mm where they fit (`cap_lp1_stitch`, after routing; 17 GND vias inside the bands).
* The ends stop short where CAP_LP1's own copper is on the guarded layer (the TP42 stub on B.Cu) or other parts'
  locked copper is (R85 / C44 / C23 at the B.Cu stretch's start).

**How the board was changed** (`layout.py --rework`, in a scratch copy of the repo, the result copied back; every step
DRC-clean): (1) `--rework --rip I2C_SDA,MAG_B` from the committed board: the new rule areas dropped every copied
track that now lay in them (BTN_MODE_N, BOOT_N, RGB_DIN, IMU_INT2, BUZZ_D and the lines crossing the corridors at a
shallow angle), Freerouting and the grid router re-routed them. A first attempt that ripped CAP_LP1 and the six
aggressors had left TP31 (MAG_B) with no way out of the B.Cu band and let I2C_SDA leave a U60 escape via under
CAP_AMP_OUT through a window; the pad channels and the "escape windows on the B.Cu stretch only" rule came from it.
(2) `--rip CAP_AMP_OUT,I2C_SCL,LCD_BL`: I2C_SCL had settled on In2 under CAP_AMP_OUT's B.Cu run to TP40 (2.3 mV) and
LCD_BL beside it (1.0 mV). (3) `--rip USB_DP,USB_DM,VBUS --no-freerouting`: Freerouting had added a bypass round U1
on each USB line again (it does not see U1's jumper pad groups) and re-written pieces of the VBUS / VBAT pre-routes;
(4) `--rip VBAT,VSYS --no-freerouting` and (5) `--rip VBUS,VSYS,VBAT --no-freerouting` (a rework that does not rip a
pre-routed net copies its split pieces unlocked; ripping the three together puts every generated piece back locked).
Result: USB_DP / USB_DM, VBUS, VBAT, VBAT_RAW, VSYS, CAP_RX and CAP_LP1 copper as on the committed board (CAP_LP1
plus a 0.26 mm grid-router joint at R84), every generated pre-route item locked.

Side effects (none timing-critical): BTN_MODE_N 77 → 111 mm (+6 vias, round the corridors), BTN_HOLD_N 72 → 84 mm,
I2C_SDA 88 → 96 mm, IMU_INT1 41 → 53 mm; I2C_SCL 107 → 74 mm, LCD_BL 55 → 39 mm, CAP_AMP_OUT 29 → 22 mm; CAP_TX1/2/3/7 re-routed under the module (In2 band), BOOT_N, RGB_DIN, IMU_INT2, MAG_A/B, BUZZ, the +3V3
routing round it; GND vias 179 → 191. No part moved (the mechanics' extracted envelope is identical).

Review (2026-11-09, pcbnew comparison with the committed board): 39 nets' copper differs, not only the ones named above.
Also re-routed in part (pieces that crossed a new rule area or were displaced by the re-routes): BTN_ZERO_N, MAG_DEC_N,
MAG_IDX, BATFET_G (its B.Cu hop through the corridor is now on F.Cu), MCU_EN, and **CAP_VREF** (a 2 mm piece now runs on
In2 with two vias, outside the In2 stretch's corridor; its closest approach to CAP_LP1 is unchanged, 0.23 mm on F.Cu
by U40 as on the committed board). CAP_RX_IN, CAP_VDIV, +3V3_SNS, +3V3_UI, CAP_TX0/5, CHG_TSMR, UI_CT,
LCD_CS_N, FG_ALRT_N, MAG_CSN and MAG_INC_N kept all their copper and gained short grid-router joints; router segments
under 1 µm went from 25 to 70 (no DRC finding). USB_DP/DM, VBUS, VBAT, VBAT_RAW, VSYS and CAP_RX are identical, no
footprint moved, and the 22 new zones are the shield's.

**Scan after (whole board, same config):** over-budget pairs 10 → 3. ANALOG victims (1 mV): CAP_LP1 worst **0.88 mV**
(BTN_MODE_N, above), CAP_AMP_OUT worst 0.65 → 0.15 mV (MAG_IDX), CAP_RX 0.14 mV (unchanged). USB (10 mV budget,
terminated-line upper bounds): the pair on itself 51 mV as before; I2C_SCL → D+ 22.4 and IMU_INT1 → D− 13.4 are gone,
**MAG_A → D+ 25.5 mV** took I2C_SCL's place (5.9 mm at 0.18 mm on B.Cu along the pair's jog at x 10–14, y 20.5, just
east of the module's escape-via field), I2C_SCL → D− 7.4 mV. Full-speed USB receivers reject most of it as common mode
(§7.13); a GND guard or a re-route of that jog is the remaining USB item (§7.9).

**Gates (2026-11-09, KiCad 10.0.8, WSL):** DRC + schematic parity **0 errors, 0 unconnected, 0 parity** (7
`lib_footprint_mismatch` warnings, the intended local overrides; no `track_dangling` left); `release.py --board slider`
PASS, jlcplace 0.2.1 **102 rows: 0 red, 0 yellow, 102 green** (the scale package is unchanged); `check_contract.py` OK;
`tools/tests` 19 passed; mechanics `extract_board_parts.py` + `clash_check.py` on this board (in a scratch copy of
`hardware/mechanical/`): 108 envelopes identical to the committed `board_parts.json`, 6255 intersections, **0 not
clear, 0 FAIL / RISK**. The schematic and netlist did not change.

### 7.15 Gyroscope: LSM6DSO replaces the LIS2DW12 (2026-11-10)

Designed, not built: nothing below has been soldered or measured. The currents are ST's typical figures (DS12140
Rev 3, AN5192 Rev 5, both at VDD = 1.8 V; the board runs the part at 3.3 V), the crosstalk numbers are hwtools
`sicalc xtalk` calculations on the board file, and the firmware has run on a PC and through the compiler only.

**Request and decision.** The owner asked for a gyroscope, so that the caliper knows which way it is held, and
offered Wi-Fi as the thing to remove if the board needed the room. It did not: the accelerometer U60 becomes a 6-axis
part (accelerometer + gyroscope in one package) on the same spot, on the same I2C bus, with the same two interrupt
lines to the same GPIOs. Nothing was removed.

**Wi-Fi stays.** Wi-Fi and BLE are the same ESP32-S3-MINI-1 module and the same antenna. Taking Wi-Fi out would be a
firmware option; it frees no board area, no part and no keep-out.

| | LIS2DW12 (before) | LSM6DSO (now) |
|---|---|---|
| Sensors | 3-axis accelerometer | 3-axis accelerometer + 3-axis gyroscope |
| Package | LGA-12, 2 × 2 × 0.7 mm | LGA-14L, 2.5 × 3.0 × 0.86 mm max |
| I2C address | 0x19 (SA0 high) | **0x6B** (SA0 high; 0x6A is the BQ25180) |
| Asleep | ~1 µA (low-power wake mode, estimate) | 5.5 µA typ (accelerometer in ultra-low-power mode at 12.5 Hz, gyroscope powered down) |
| Awake | 0.05 mA | 0.30 mA typ (both at 52 Hz, low-power mode; 0.55 mA in high-performance mode) |
| LCSC, price at 1–9 (JLC, 2026-11-10) | C189624, $0.90 | C2655100, extended, 23 738 in stock, **$3.99** |
| JLC placement rotation | 270 | 0 |

**What it costs.** $3.09 a board (5 boards of parts ≈ $136 → ≈ $151, [ordering](ordering.md)). The sleep estimate
goes from ≈ 33 to ≈ 38 µA and the SPEC target from ≤ 35 to **≤ 40 µA**; awake it adds 0.25 mA to ≈ 56 mA idle /
≈ 71 mA measuring, which does not show in the rounded totals. Battery life with the 135 mAh cell: a typical shop day
stays ≈ 3.3 days, light use 9.5 → ≈ 9.4 days, storage in deep sleep ≈ 5 → ≈ 4 months
([architecture §5](architecture.md)).

**What a gyroscope without a magnetometer can do.** Roll and pitch, and so "which face is up", are absolute:
gravity is the reference, and the gyroscope lets them follow a quick turn without waiting for the accelerometer to
settle. **Yaw, the turn about the vertical, is relative and drifts**: nothing on the board knows where north is. The
firmware reports it as an angle since power-on or since it was last zeroed, with a growing uncertainty
([firmware §12.2](firmware.md)).

**Circuit** (§3.6). Mode 1, I2C only: CS and SA0 to +3V3, SDx / SCx to GND, OCS_Aux / SDO_Aux open. INT1 → IMU_INT1
(GPIO15, the pickup wake), INT2 → IMU_INT2 (GPIO16), no pull on either. C60 100 nF + C61 10 µF at VDD (pin 8), C62
100 nF at VDDIO (pin 5): the same three capacitors as before. The netlist differs from the previous one at U60 only
(19 differences: its pins, value, footprint and fields).

**Board.** U60 keeps its centre (30.0, 23.5) and now sits at rotation 0, so the chip's axes are the board's: X along
the beam toward the USB end, Y toward the top edge, Z out of the display (to be checked on the first board with
`bu imu`, [bring-up](bringup.md)). The courtyard is now 3.58 × 3.10 mm (x 28.21…31.79, y 21.95…25.05), and four parts
moved out of its way:

| Part | Before (x, y, rot) | Now |
|---|---|---|
| C60 100 nF (VDD) | 27.62, 22.57, 90 | 32.66, 22.75, 90 |
| C61 10 µF (VDD) | 32.49, 23.75, 90 | 32.85, 20.58, 0 |
| C62 100 nF (VDDIO) | 30.11, 21.41, 0 | 29.82, 21.12, 0 |
| R57 1 k (piezo) | 33.73, 19.55, 90 | 32.90, 18.93, 0 |

**No copper under the sensor on its own layer** (`layout.py` `add_imu_keepout`, rule area `U60_NO_COPPER_UNDER`):
no track, via or pour on F.Cu inside the pad ring, x 29.35…30.65, y 23.1…23.9. ST's mounting note for LGA MEMS
sensors (TN0018) asks for a keep-out on the top metal layer under the package, so that nothing under it loads the
sensor unevenly once soldered. **Source caveat:** the wording comes from a web-search excerpt of Rev 6 of that note;
the current Rev 8 PDF was not read, and the excerpt says nothing about vias beside the package. The first rework had
put the I2C escape vias between the pad rows; with the rule area there is no copper there. The seven +3V3 / GND /
I2C escape vias now sit outside the pad ring, at the package outline: all inside the courtyard, and the nearest
overlaps the body's edge by about 0.1 mm. Whether that matters for the zero-g / zero-rate offsets is not known; the
bring-up reads both (`bu imu`, `bu gyro`).

**Re-route:** `layout.py --rework --rework-from <the committed board> --no-freerouting`, then `layout.py --finish`.
The grid router alone was used because the first attempt with Freerouting re-did 42 nets, the USB pair, VBUS, VBAT
and VSYS among them. Copper that differs from the committed board, 11 nets:

| Net | Length mm, before → now | Vias | Why |
|---|---|---|---|
| I2C_SCL | 73.6 → 75.0 | 13 → 10 | U60 pins moved |
| I2C_SDA | 95.1 → 85.8 | 14 → 11 | U60 pins moved |
| IMU_INT1 | 54.1 → 29.1 | 8 → 3 | U60 pins moved |
| IMU_INT2 | 33.9 → 51.0 | 7 → 6 | U60 pins moved |
| +3V3 | 209.2 → 208.7 | 16 → 15 | U60, C60–C62 |
| GND | 356.5 → 359.8 | 193 → 192 | U60, C60–C62 |
| BUZZ_D | 17.7 → 14.4 | 3 → 4 | R57 moved |
| BTN_MODE_N | 114.5 → 112.9 | 18 → 17 | displaced by the new copper |
| BOOT_N | 59.6 → 63.8 | 9 → 11 | displaced |
| LCD_BL | 38.9 → 51.8 | 9 → 11 | displaced |
| CAP_TX7 | 23.1 → 26.7 | 4 → 2 | displaced |

Vias in all 546 → 534. USB_DP / USB_DM, VBUS, VBAT, VBAT_RAW, VSYS, CAP_RX and CAP_LP1 are as on the committed board.

**Crosstalk scan after** (same config as §7.14). ANALOG victims (1 mV budget): CAP_LP1 worst **0.88 mV** (BTN_MODE_N,
unchanged), BOOT_N 0.65 mV (unchanged), IMU_INT2 0.31 mV. **USB got worse by one pair**: over sicalc's 10 mV budget
3 → 4. The pair on itself 51 mV as before; **I2C_SCL → D+ 27.8 mV** (6.7 mm at 0.18 mm on B.Cu) and **IMU_INT1 → D−
19.5 mV** (13.8 mm at 0.24 mm on B.Cu) where IMU_INT2 → D+ 26.9 mV was. These are the two aggressors §7.14 had moved
away from the pair, back beside it. They are terminated-line upper bounds, a full-speed receiver rejects most of it as
common mode (§7.13), and the I2C rise through 2.2 k is ≈ 205 ns (only the falling edge is fast). The GND guard or
re-route of that part of the pair is still the open USB item (§7.9), now with two lines beside it and not one.

**Toolchain fixes that came out of it** (`tools/`, with tests):

* `pcbgen.fanout_vias` kept a flat 0.15 mm from other nets' copper. A GND fan-out via landed 0.18 mm from a track of
  the Analog class (0.2 mm clearance): a DRC error. The gap is now the other net's class clearance when that is the
  larger one (`tools/tests/test_fanout_vias.py`).
* `pcbgen.dead_branch`, used by `layout.py`'s `prune_dangling`: a rework cuts the old copper of a re-routed net and
  can leave a dead branch of dozens of very short grid-router segments. DRC reports only the last segment of a branch
  per run, and the pruner removed one segment per round for six rounds, so two `track_dangling` warnings stayed
  (+3V3 on B.Cu; BTN_MODE_N on F.Cu, through a via, on B.Cu). It now removes the whole branch behind a reported end,
  up to the next fork, T-junction, pad, zone of the net or locked copper, and falls back to the single segment when
  the DRC count of unconnected items rises (`tools/tests/test_dead_branch.py`).

**Firmware** ([firmware §12.2](firmware.md)): an LSM6DSO driver (`components/power/imu.c`), an orientation filter
(`components/measure/orient.c`: up vector, roll / pitch / tilt, nearest face, relative yaw, gyroscope bias learned at
rest, a "held steady" flag), the display turning with the caliper (`CONFIG_CALIPER_UI_AUTO_FLIP`), and the bring-up
steps `bu imu`, `bu gyro`, `bu gyro turn` and `bu lcd flip`. Asleep the gyroscope is off and the accelerometer wakes
the ESP32 on pickup as the LIS2DW12 did. Not connected yet: orientation in the SETTLE capture, movement as "in use"
for the auto-off timer, and orientation over BLE, the web page or the log. The app slot is nearly full (4 % free).

**To verify on the first board (TVP):** the axis signs; INT1's level before and after configuration and INT2's
default level; the wake-up threshold (62.5 mg) against real handling; the two currents at 3.3 V; the filter's
thresholds; the zero-rate offset with the escape vias where they are.

**Gates (2026-11-10, KiCad 10.0.8, WSL):** `build.py` wiring check OK, ERC as before (2 waived TPS22917 pin_to_pin,
scale clean); `check_contract.py` OK; DRC + schematic parity **0 errors, 0 unconnected, 0 parity** (7
`lib_footprint_mismatch` warnings, the intended local overrides; no `track_dangling`); `release.py --board slider`
PASS, jlcplace 0.2.1 **102 rows: 0 red, 0 yellow, 102 green** (new entry C2655100: fitted by pad numbers, 14 of 14, rms
0.100 mm); `tools/tests` 24 passed; mechanics `run_all.sh`: 107 envelopes, 41 tests passed, clash check **0 not clear,
0 FAIL / RISK**; firmware host tests 6 of 6, `idf.py build` without warnings. The scale board did not change.

### 7.16 Compass: IIS2MDC magnetometer (2026-11-10)

Designed, not built: nothing below has been soldered or measured. The currents are ST's typical figures (DocID030986
Rev 1, read up to page 25 of 40 from a distributor's copy; the register map and the package drawing were not read),
the field figures are hand calculations, the crosstalk numbers are hwtools `sicalc xtalk` calculations on the board
file, and the firmware has run on a PC and through the compiler only.

**Request and decision.** After the gyroscope (§7.15) the owner asked for the magnetometer. The gyroscope's yaw is
relative and drifts, and a magnetometer is the usual reference for it. U61, an **IIS2MDCTR**, goes on the same I2C
bus and the always-on +3V3 with four capacitors (circuit and pin table: §3.6). Nothing was removed, and no ESP32 pin
changed: there was none free, so the part's INT/DRDY pin is not connected and the firmware polls it.

**What it costs.** $4.25 a board (U61 $4.25, JLC extended, 2 705 in stock on 2026-11-10; C63 $0.0045), and one more
extended line and one more basic line to load: 5 boards of parts ≈ $151 → ≈ $172 ([ordering](ordering.md)). The sleep estimate goes from ≈ 38 to
≈ 40 µA and the SPEC target from ≤ 40 to **≤ 42 µA**; awake it adds 0.05 mA, which does not show in the rounded
totals ([architecture §5](architecture.md)).

**What a compass can do on this tool, and what it cannot.** It gives the orientation filter a direction that holds
still, so the yaw stops drifting. It does **not** give north, and nothing in the firmware or the pages calls it
north. The Earth's field is 25–65 µT, of which roughly 20 µT is horizontal at mid-northern latitudes; that
horizontal part is all a heading has to work with. What disturbs it here, largest first:

| Source | Estimate at U61 | Kind |
|---|---|---|
| **The beam** (O1 tool steel, ferromagnetic), its edge 11.2 mm from U61 | **not calculated, not measured**; tens of degrees of heading error are possible | soft iron that moves against the sensor: it changes with the slider position and with how the tool is held, so no fixed calibration removes it |
| Wi-Fi transmission, ≈ 300 mA peaks | several times the 70 mA figures below | comes and goes with the load |
| GND-plane return under the corner, 70 mA | ≈ 1.3–1.7 µT in the board's plane (an upper bound: all of the current in a narrow strip) | load |
| VBAT riser, 70 mA | ≈ 1.8 µT, of which ≈ 0.56 µT in the board's plane | load |
| Battery lead pair at J2 (bottom side, under this corner), 70 mA | ≈ 1.6 µT, mostly vertical | load |
| Q1 path, 70 mA | ≤ ≈ 0.8 µT | load |
| VBAT trunk, 70 mA | ≈ 0.4 µT | load |
| The magnetic tape (2 mm poles), ≈ 21 mm from U61 | < 0.01 µT | negligible: an alternating pole pattern's field dies off within a few pole lengths |

* The load terms together come to roughly 5–10 % of a 20 µT horizontal field: **a few degrees of heading between
  load states**, and several times that while Wi-Fi transmits. They are straight-wire and current-strip estimates at
  70 mA (measuring, radio idle), not a field simulation.
* The datasheet asks to "keep currents higher than 10 mA a few millimeters away from the sensor IC" (§5.2). The
  battery connector J2 is on the bottom side under this corner, and its leads carry the whole load. The corner was
  still chosen, because distance from the beam matters more and the only other free spot, near (46.7, 26.5), is
  6.5 mm from the beam.
* **The beam is the open question.** With the O1 beam the heading may be poor or useless; with the 1.4301 beam
  option (not magnetic) it is expected to be much better. A distorted field that holds still is still a reference
  for yaw; a field that changes when the slider moves is not. The first board measures it
  ([bring-up B-10a](bringup.md#b-10a-compass-iis2mdc-and-the-steel-beam)).
* **Not assessed:** steel that moves with the board (the dome of SW50, 3.2 mm from U61's courtyard, the screws, the
  cell's tabs). It is fixed against the sensor, so its permanent field ends up in the calibration's offset; what it
  does by bending the field is not corrected.

**Board.** U61 at (23.5, 31.2), rotation 0, top side: the free corner of the top band, 1.25 mm right of the antenna
keep-out (x ≤ 21) and 3.2 mm left of SW50's courtyard. Courtyard x 22.25…24.75, y 29.95…32.45.

| Part | x, y, rot | Where |
|---|---|---|
| U61 IIS2MDC | 23.5, 31.2, 0 | |
| C63 220 nF (C1) | 23.5, 29.4, 0 | under pins 5 and 6, 1.04 mm centre to centre |
| C64 100 nF (Vdd) | 25.3, 31.2, 90 | beside pin 9 |
| C65 10 µF (Vdd) | 26.3, 31.2, 90 | beside C64 |
| C66 100 nF (Vdd_IO) | 25.1, 32.95, 180 | above pin 10 |

* **C1 loop, pre-routed** (`layout.py` `preroute_compass`, locked): pin 5 → C63 and pin 6 (GND) → C63 on F.Cu,
  0.25 mm wide, 1.1 mm each, about 2 mΩ. The datasheet wants C1 "as close as possible to pins 5 and 6 since very
  high current pulses flow from C1 to pin 5 and 6" (§5). The grid router's first result joined pin 5 and C63 with
  fifteen 0.12 mm segments in a zigzag.
* **No copper under the sensor on its own layer** (`add_imu_keepout(bb, "U61")`, rule area `U61_NO_COPPER_UNDER`):
  no track, via or pour on F.Cu inside the pad ring, x 23.12…23.88, y 30.83…31.58. The same rule as U60's, with the
  same caveat about its source (§7.15). Three vias sit inside the courtyard but outside the pad ring: GND
  (24.05, 32.5), I2C_SCL (22.33, 31.85) and I2C_SDA (22.62, 30.05). On In2, BTN_HOLD_N passes under the part and
  BOOT_N close by: lines that carry microamps through their pull-ups.
* **Re-route:** as in §7.15, `layout.py --rework --rework-from <the committed board> --no-freerouting`, then
  `layout.py --finish`. Copper that differs from the committed board, 16 nets:

| Net | Length mm, before → now | Vias | Why |
|---|---|---|---|
| COMPASS_C1 | 0 → 1.1 | 0 → 0 | new, pre-routed |
| +3V3 | 208.7 → 222.7 | 15 → 16 | U61, C64–C66 |
| GND | 359.8 → 366.5 | 192 → 189 | U61, C63–C66 |
| I2C_SCL | 75.0 → 98.0 | 10 → 11 | U61 added to the bus |
| I2C_SDA | 85.8 → 106.6 | 11 → 15 | U61 added to the bus |
| IMU_INT2 | 51.0 → 33.2 | 6 → 6 | re-routed with the bus |
| BOOT_N | 63.8 → 59.5 | 11 → 9 | displaced by the new copper |
| BTN_HOLD_N | 82.5 → 83.3 | 9 → 9 | displaced |
| BTN_MODE_N | 112.9 → 113.0 | 17 → 17 | displaced |
| BTN_ZERO_N | 64.2 → 68.2 | 10 → 12 | displaced |
| BUZZ | 62.9 → 54.7 | 11 → 11 | displaced |
| CAP_TX1 | 33.9 → 29.6 | 5 → 3 | displaced |
| CHG_TSMR | 44.4 → 42.2 | 4 → 6 | displaced |
| FG_ALRT_N | 59.7 → 64.6 | 4 → 9 | displaced |
| MCU_EN | 17.4 → 17.8 | 3 → 3 | displaced |
| RGB_DIN | 39.8 → 43.4 | 3 → 4 | displaced |

  Vias in all 534 → 543. USB_DP / USB_DM, VBUS, VBAT, VBAT_RAW, VSYS, CAP_RX and CAP_LP1 are as on the committed
  board. The I2C bus is now about 100 mm a line with four devices and the 2.2 k pull-ups; its capacitance was not
  re-calculated (TVP: rise time at 400 kHz).

**Crosstalk scan after** (same config as §7.14). ANALOG victims (1 mV budget): CAP_LP1 worst **0.88 mV** (BTN_MODE_N,
unchanged), then BTN_ZERO_N 0.74 mV (new: 2.5 mm at 0.27 mm on F.Cu) and BOOT_N 0.66 mV. **USB got better by one
pair**: over sicalc's 10 mV budget 4 → 3. The pair on itself 51 mV as before and IMU_INT1 → D− 19.4 mV (13.8 mm at
0.24 mm on B.Cu) as in §7.15; **I2C_SCL → D+ 27.8 mV is gone**. Now under the budget beside the pair: IMU_INT2 → D+
8.4 mV and I2C_SDA → D+ 6.8 mV. Terminated-line upper bounds, as before; the GND guard or re-route of that part of
the pair is still the open USB item (§7.9).

**Firmware** ([firmware §12.2](firmware.md)): a driver (`components/power/compass.c`: low-power mode at 10 Hz with
offset cancellation, power-down before deep sleep), a compass term in the orientation filter
(`components/measure/orient.c`), a hard-iron calibration kept in NVS (`bu compass cal`), and the bring-up check
`bu compass`. The filter uses the compass only while the field looks like the calibrated one (its size and its dip);
otherwise it marks the field as disturbed and yaw runs on the gyroscope alone, as before. The register addresses and
values come from ST's driver sources (`iis2mdc_reg.h`), not from the datasheet's register map. The app slot is now
3 % free.

**To verify on the first board (TVP):** the WHO_AM_I value and every register setting; the axis map; the two
currents at 3.3 V (1.5 µA asleep, 50 µA awake); the heading against the slider position and the tool's attitude
with the O1 beam, and with a 1.4301 beam if one is made; the heading against the load state (backlight, Wi-Fi,
charging); whether the calibration is accepted at all next to the beam; every threshold in the filter; the I2C rise
time.

**Gates (2026-11-10, KiCad 10.0.8, WSL):** `build.py` wiring check OK, ERC as before (2 waived TPS22917 pin_to_pin,
scale clean); `check_contract.py` OK; netlist against the previous one: 14 differences, all at U61 and C63–C66
(components 130 → 135, nets 99 → 104); DRC + schematic parity **0 errors, 0 unconnected, 0 parity** (7
`lib_footprint_mismatch` warnings, the intended local overrides); `release.py --board slider` PASS, jlcplace 0.2.1
**107 rows: 0 red, 0 yellow, 107 green** (new entries C2655002: fitted by pad numbers, 12 of 12, rms 0.013 mm, and
C16772: 2 of 2, rms 0.060 mm); `tools/lcsc_check.py` 49 lines, 0 flagged; `tools/tests` 24 passed; mechanics
`run_all.sh`: 112 envelopes, 41 tests passed, clash check **0 not clear, 0 FAIL / RISK**; firmware host tests 6 of 6,
`idf.py build` without warnings. The scale board did not change.
