tyevco/prettycoolboards/caliper/hardware/mechanical/clash_report.txt

clash_check.py -- board envelope from board_parts.json (../kicad/slider/prettycool-caliper-slider.kicad_pcb)
7097 intersections, 0 not clear; gap/board/RF rules: 0 FAIL, 0 RISK; body webs: 0 BREAK/THIN

== not clear ==
(intended contact, not counted: oring  x  beam)

== gaps and board rules ==
OK   AS5311 face (nominal A 1.1) to tape: 0.300 mm (target 0.3); over the package range A 0.85-1.2: 0.200-0.550 mm with the nominal 0.10 shim; the per-unit shim (0-0.35) brings every package to 0.3
OK   electrode face to scale face: 0.150 mm (target 0.15)
OK   B-rep distance AS5311 U30 (A max, as placed) to tape: 0.200 mm (>= 0.20)
OK   AS5311 leads y 2.80..9.20 inside the channel 1.90..10.10 (side clearance 0.90, need >= 0.5)
OK   bottom window x 28.0..49.0 over the tape channel x 27..201 at R 0
OK   bottom window x 179.0..200.0 over the tape channel x 27..201 at R 151
OK   board  bottom part C30 over the beam band: x 34.95..35.95 y 8.35..8.85 h 0.55 (window x 20..41 y 2.4..9.6 in, channel in, <= 1.3)
OK   board  bottom part C31 over the beam band: x 36.00..37.00 y 5.75..6.25 h 0.55 (window x 20..41 y 2.4..9.6 in, channel in, <= 1.3)
OK   board  bottom part U30 over the beam band: x 27.75..34.25 y 3.80..8.20 h 1.20 (window x 20..41 y 2.4..9.6 in, channel in, <= 1.3)
OK   board  tallest top part under the glass: SW20 2.00 (limit 2.6)
OK   board  tallest top part elsewhere: J1 3.30 (limit 4.2)
OK   board  bottom part C21 in the upper band: x 2.60..3.60 y 26.25..26.75 h 0.55 inside the module exception x 1.8..4.4, y 22.7..27.0, <= 0.55
OK   board  bottom part C23 in the upper band: x 2.60..3.60 y 25.05..25.55 h 0.55 inside the module exception x 1.8..4.4, y 22.7..27.0, <= 0.55
OK   board  bottom part C44 in the upper band: x 2.80..3.80 y 23.00..23.50 h 0.55 inside the module exception x 1.8..4.4, y 22.7..27.0, <= 0.55
OK   board  bottom part J2 in the upper band: x 22.10..26.10 y 23.23..27.48 h 2.95 inside the battery pocket x 21.8..59.3, y 22.7..34.8 (0.3 in)
OK   board  bottom part J2_plug in the upper band: x 21.90..26.30 y 27.48..32.08 h 2.95 inside the battery pocket x 21.8..59.3, y 22.7..34.8 (0.3 in)
OK   board  bottom part R85 in the upper band: x 2.77..3.83 y 23.98..24.52 h 0.40 inside the module exception x 1.8..4.4, y 22.7..27.0, <= 0.55
OK   board  antenna keep-out x 0.0..21.0 y 29.0..34.0: no parts
OK   board  H1 (18.75, 24.0) boss clear of the channel / Y gib (boss edge y 21.75 >= 21.70): True
OK   board  H2 (-3.5, 5.5) on an end tab with standoff room: True
OK   board  H3 (-3.5, 14.0) on an end tab with standoff room: True
OK   board  H4 (65.5, 5.5) on an end tab with standoff room: True
OK   board  H5 (65.5, 14.0) on an end tab with standoff room: True

== body walls (cut-feature pairs closer than WALL_MIN) ==
open  tunnel_cavity / tab_clamps: meet (intended opening)
open  tunnel_cavity / h1_pilot: meet (intended opening)
open  tunnel_cavity / battery_pocket: meet (intended opening)
open  tunnel_cavity / pad_pockets: meet (intended opening)
web   tunnel_cavity / pad_screws: web 0.90 mm (< WALL_MIN 1.2; local minimum 0.4)
open  tunnel_cavity / y_bores: meet (intended opening)
open  tunnel_cavity / back_plungers: meet (intended opening)
open  tunnel_cavity / roller_slot: meet (intended opening)
open  tunnel_cavity / usb: meet (intended opening)
web   tab_clamps / pad_pockets: web 0.45 mm (< WALL_MIN 1.2; local minimum 0.4)
web   tab_clamps / pad_screws: web 0.55 mm (< WALL_MIN 1.2; local minimum 0.4)
web   tab_clamps / lid_screws: web 0.94 mm (< WALL_MIN 1.2; local minimum 0.4)
web   h1_pilot / y_bores: web 0.85 mm (< WALL_MIN 1.2; local minimum 0.4)
open  battery_pocket / door_rebate: meet (intended opening)
web   battery_pocket / door_pilots: web 0.70 mm (< WALL_MIN 1.2; local minimum 0.4)
open  door_rebate / door_pilots: meet (intended opening)
open  pad_pockets / pad_screws: meet (intended opening)
web   pad_screws / usb: web 0.80 mm (< WALL_MIN 1.2; local minimum 0.4)
open  roller_slot / roller_axle: meet (intended opening)
open  roller_axle / usb: meet (intended opening)
web   usb / lid_screws: web 0.75 mm (< WALL_MIN 1.2; local minimum 0.4)

== RF (SPEC D4) ==
OK   plunger_hw_0: 5.15 mm from the antenna area in plan
OK   plunger_hw_1: 5.15 mm from the antenna area in plan
OK   board:J2_plug: 6.35 mm from the antenna area in plan
OK   board:J2: 6.86 mm from the antenna area in plan
OK   y_gib: 8.50 mm from the antenna area in plan
OK   beam: 9.50 mm from the antenna area in plan
OK   pad_insert_u3.5_y18.8: 9.87 mm from the antenna area in plan
OK   front_pad_1: 10.06 mm from the antenna area in plan
OK   battery (cell): 12.05 mm from the antenna area in plan
OK   back_gib: 12.50 mm from the antenna area in plan
OK   board:H3_standoff: 13.92 mm from the antenna area in plan
OK   tab_clamp_2: 13.92 mm from the antenna area in plan
OK   tab_clamp_3: 14.02 mm from the antenna area in plan
OK   lid_screw_u4.5_y9.75: 18.98 mm from the antenna area in plan
OK   board:H2_standoff: 22.28 mm from the antenna area in plan
OK   tab_clamp_0: 22.28 mm from the antenna area in plan
OK   tab_clamp_1: 22.38 mm from the antenna area in plan
OK   back_plunger_insert_u14: 22.70 mm from the antenna area in plan
OK   plunger_hw_2: 23.75 mm from the antenna area in plan
OK   pad_insert_u3.5_y0.95: 27.13 mm from the antenna area in plan
OK   front_pad_0: 27.93 mm from the antenna area in plan
OK   ref_strip: 29.50 mm from the antenna area in plan
OK   board:J1: 40.10 mm from the antenna area in plan
OK   back_plunger_insert_u64: 45.49 mm from the antenna area in plan
OK   plunger_hw_3: 46.54 mm from the antenna area in plan
OK   lid_screw_u73_y33.4: 48.35 mm from the antenna area in plan
OK   front_pad_3: 49.41 mm from the antenna area in plan
OK   pad_insert_u74_y18.8: 49.77 mm from the antenna area in plan
OK   roller_axle_pin: 49.77 mm from the antenna area in plan
OK   board:H5_standoff: 50.30 mm from the antenna area in plan
OK   tab_clamp_6: 50.30 mm from the antenna area in plan
OK   tab_clamp_7: 50.40 mm from the antenna area in plan
OK   lid_screw_u73.5_y9.75: 52.61 mm from the antenna area in plan
OK   board:H4_standoff: 53.42 mm from the antenna area in plan
OK   tab_clamp_4: 53.42 mm from the antenna area in plan
OK   tab_clamp_5: 53.52 mm from the antenna area in plan
OK   front_pad_2: 55.86 mm from the antenna area in plan
OK   pad_insert_u74_y0.95: 56.17 mm from the antenna area in plan
OK   stop_screw: 205.13 mm from the antenna area in plan
OK   PA-CF moving inside jaw: 5.15 mm in plan, 5.15 mm in 3D from the antenna; its shoulder block and gusset within 5.15 mm (0.19 cm^3, 1.75 mm at the closest) print in unfilled PA (the modifier)
OK   PA-CF fixed jaw (its inside jaw tip) at R = 0: 5.15 mm in plan from the antenna; further at any R > 0
OK   body within 5 mm of the antenna: 2.39 cm^3, printed in unfilled PA through the slicer modifier stl/slider_body_rf_modifier.stl

== all ==
CLEAR  R0     BZ50  x  beam
CLEAR  R0     BZ50  x  fixed_jaw
CLEAR  R0     BZ50  x  scale_pcb
CLEAR  R0     BZ50  x  stop_screw
CLEAR  R0     BZ50  x  tape
CLEAR  R0     C1  x  beam
CLEAR  R0     C1  x  fixed_jaw
CLEAR  R0     C1  x  scale_pcb
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
CLEAR  R0     C61  x  stop_screw
CLEAR  R0     C61  x  tape
CLEAR  R0     C62  x  beam
CLEAR  R0     C62  x  fixed_jaw
CLEAR  R0     C62  x  scale_pcb
CLEAR  R0     C62  x  stop_screw
CLEAR  R0     C62  x  tape
CLEAR  R0     C63  x  beam
CLEAR  R0     C63  x  fixed_jaw
CLEAR  R0     C63  x  scale_pcb
CLEAR  R0     C63  x  stop_screw
CLEAR  R0     C63  x  tape
CLEAR  R0     C64  x  beam
CLEAR  R0     C64  x  fixed_jaw
CLEAR  R0     C64  x  scale_pcb
CLEAR  R0     C64  x  stop_screw
CLEAR  R0     C64  x  tape
CLEAR  R0     C65  x  beam
CLEAR  R0     C65  x  fixed_jaw
CLEAR  R0     C65  x  scale_pcb
CLEAR  R0     C65  x  stop_screw
CLEAR  R0     C65  x  tape
CLEAR  R0     C66  x  beam
CLEAR  R0     C66  x  fixed_jaw
CLEAR  R0     C66  x  scale_pcb
CLEAR  R0     C66  x  stop_screw
CLEAR  R0     C66  x  tape
CLEAR  R0     C7  x  beam
CLEAR  R0     C7  x  fixed_jaw
CLEAR  R0     C7  x  scale_pcb
CLEAR  R0     C7  x  stop_screw
CLEAR  R0     C7  x  tape
CLEAR  R0     C8  x  beam
CLEAR  R0     C8  x  fixed_jaw
CLEAR  R0     C8  x  scale_pcb
CLEAR  R0     C8  x  stop_screw
CLEAR  R0     C8  x  tape
CLEAR  R0     C9  x  beam
CLEAR  R0     C9  x  fixed_jaw
CLEAR  R0     C9  x  scale_pcb
CLEAR  R0     C9  x  stop_screw
CLEAR  R0     C9  x  tape
CLEAR  R0     D1  x  beam
CLEAR  R0     D1  x  fixed_jaw
CLEAR  R0     D1  x  scale_pcb
CLEAR  R0     D1  x  stop_screw
CLEAR  R0     D1  x  tape
CLEAR  R0     D50  x  beam
CLEAR  R0     D50  x  fixed_jaw
CLEAR  R0     D50  x  scale_pcb
CLEAR  R0     D50  x  stop_screw
CLEAR  R0     D50  x  tape
CLEAR  R0     H2_standoff  x  beam
CLEAR  R0     H2_standoff  x  fixed_jaw
CLEAR  R0     H2_standoff  x  scale_pcb
CLEAR  R0     H2_standoff  x  stop_screw
CLEAR  R0     H2_standoff  x  tape
CLEAR  R0     H3_standoff  x  beam
CLEAR  R0     H3_standoff  x  fixed_jaw
CLEAR  R0     H3_standoff  x  scale_pcb
CLEAR  R0     H3_standoff  x  stop_screw
CLEAR  R0     H3_standoff  x  tape
CLEAR  R0     H4_standoff  x  beam
CLEAR  R0     H4_standoff  x  fixed_jaw
CLEAR  R0     H4_standoff  x  scale_pcb
CLEAR  R0     H4_standoff  x  stop_screw
CLEAR  R0     H4_standoff  x  tape
CLEAR  R0     H5_standoff  x  beam
CLEAR  R0     H5_standoff  x  fixed_jaw
CLEAR  R0     H5_standoff  x  scale_pcb
CLEAR  R0     H5_standoff  x  stop_screw
CLEAR  R0     H5_standoff  x  tape
CLEAR  R0     J1  x  beam
CLEAR  R0     J1  x  fixed_jaw
CLEAR  R0     J1  x  scale_pcb
CLEAR  R0     J1  x  stop_screw
CLEAR  R0     J1  x  tape
CLEAR  R0     J2  x  beam
CLEAR  R0     J2  x  fixed_jaw
CLEAR  R0     J2  x  scale_pcb
CLEAR  R0     J2  x  stop_screw
CLEAR  R0     J2  x  tape
CLEAR  R0     J2_plug  x  beam
CLEAR  R0     J2_plug  x  fixed_jaw
CLEAR  R0     J2_plug  x  scale_pcb
CLEAR  R0     J2_plug  x  stop_screw
CLEAR  R0     J2_plug  x  tape
CLEAR  R0     J50  x  beam
CLEAR  R0     J50  x  fixed_jaw
CLEAR  R0     J50  x  scale_pcb
CLEAR  R0     J50  x  stop_screw
CLEAR  R0     J50  x  tape
CLEAR  R0     L1  x  beam
CLEAR  R0     L1  x  fixed_jaw
CLEAR  R0     L1  x  scale_pcb
CLEAR  R0     L1  x  stop_screw
CLEAR  R0     L1  x  tape
CLEAR  R0     Q1  x  beam
CLEAR  R0     Q1  x  fixed_jaw
CLEAR  R0     Q1  x  scale_pcb
CLEAR  R0     Q1  x  stop_screw
CLEAR  R0     Q1  x  tape
CLEAR  R0     Q50  x  beam
CLEAR  R0     Q50  x  fixed_jaw
CLEAR  R0     Q50  x  scale_pcb
CLEAR  R0     Q50  x  stop_screw
CLEAR  R0     Q50  x  tape
CLEAR  R0     Q51  x  beam
CLEAR  R0     Q51  x  fixed_jaw
CLEAR  R0     Q51  x  scale_pcb
CLEAR  R0     Q51  x  stop_screw
CLEAR  R0     Q51  x  tape
CLEAR  R0     R1  x  beam
CLEAR  R0     R1  x  fixed_jaw
CLEAR  R0     R1  x  scale_pcb
CLEAR  R0     R1  x  stop_screw
CLEAR  R0     R1  x  tape
CLEAR  R0     R10  x  beam
CLEAR  R0     R10  x  fixed_jaw
CLEAR  R0     R10  x  scale_pcb
CLEAR  R0     R10  x  stop_screw
CLEAR  R0     R10  x  tape
CLEAR  R0     R2  x  beam
CLEAR  R0     R2  x  fixed_jaw
CLEAR  R0     R2  x  scale_pcb
CLEAR  R0     R2  x  stop_screw
CLEAR  R0     R2  x  tape
CLEAR  R0     R20  x  beam
CLEAR  R0     R20  x  fixed_jaw
CLEAR  R0     R20  x  scale_pcb
CLEAR  R0     R20  x  stop_screw
CLEAR  R0     R20  x  tape
CLEAR  R0     R21  x  beam
CLEAR  R0     R21  x  fixed_jaw
CLEAR  R0     R21  x  scale_pcb
CLEAR  R0     R21  x  stop_screw
CLEAR  R0     R21  x  tape
CLEAR  R0     R3  x  beam
CLEAR  R0     R3  x  fixed_jaw
CLEAR  R0     R3  x  scale_pcb
CLEAR  R0     R3  x  stop_screw
CLEAR  R0     R3  x  tape
CLEAR  R0     R30  x  beam
CLEAR  R0     R30  x  fixed_jaw
CLEAR  R0     R30  x  scale_pcb
CLEAR  R0     R30  x  stop_screw
CLEAR  R0     R30  x  tape
CLEAR  R0     R31  x  beam
CLEAR  R0     R31  x  fixed_jaw
CLEAR  R0     R31  x  scale_pcb
CLEAR  R0     R31  x  stop_screw
CLEAR  R0     R31  x  tape
CLEAR  R0     R4  x  beam
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
CLEAR  R0     U40  x  tape
CLEAR  R0     U5  x  beam
CLEAR  R0     U5  x  fixed_jaw
CLEAR  R0     U5  x  scale_pcb
CLEAR  R0     U5  x  stop_screw
CLEAR  R0     U5  x  tape
CLEAR  R0     U6  x  beam
CLEAR  R0     U6  x  fixed_jaw
CLEAR  R0     U6  x  scale_pcb
CLEAR  R0     U6  x  stop_screw
CLEAR  R0     U6  x  tape
CLEAR  R0     U60  x  beam
CLEAR  R0     U60  x  fixed_jaw
CLEAR  R0     U60  x  scale_pcb
CLEAR  R0     U60  x  stop_screw
CLEAR  R0     U60  x  tape
CLEAR  R0     U61  x  beam
CLEAR  R0     U61  x  fixed_jaw
CLEAR  R0     U61  x  scale_pcb
CLEAR  R0     U61  x  stop_screw
CLEAR  R0     U61  x  tape
CLEAR  R0     back_gib  x  beam
CLEAR  R0     back_gib  x  fixed_jaw
CLEAR  R0     back_gib  x  scale_pcb
CLEAR  R0     back_gib  x  stop_screw
CLEAR  R0     back_gib  x  tape
CLEAR  R0     battery  x  beam
CLEAR  R0     battery  x  fixed_jaw
CLEAR  R0     battery  x  scale_pcb
CLEAR  R0     battery  x  stop_screw
CLEAR  R0     battery  x  tape
CLEAR  R0     battery_door  x  beam
CLEAR  R0     battery_door  x  fixed_jaw
CLEAR  R0     battery_door  x  scale_pcb
CLEAR  R0     battery_door  x  stop_screw
CLEAR  R0     battery_door  x  tape
CLEAR  R0     board  x  beam
CLEAR  R0     board  x  fixed_jaw
CLEAR  R0     board  x  scale_pcb
CLEAR  R0     board  x  stop_screw
CLEAR  R0     board  x  tape
CLEAR  R0     button_cap_HOLD  x  beam
CLEAR  R0     button_cap_HOLD  x  fixed_jaw
CLEAR  R0     button_cap_HOLD  x  scale_pcb
CLEAR  R0     button_cap_HOLD  x  stop_screw
CLEAR  R0     button_cap_HOLD  x  tape
CLEAR  R0     button_cap_MODE  x  beam
CLEAR  R0     button_cap_MODE  x  fixed_jaw
CLEAR  R0     button_cap_MODE  x  scale_pcb
CLEAR  R0     button_cap_MODE  x  stop_screw
CLEAR  R0     button_cap_MODE  x  tape
CLEAR  R0     button_cap_ZERO  x  beam
CLEAR  R0     button_cap_ZERO  x  fixed_jaw
CLEAR  R0     button_cap_ZERO  x  scale_pcb
CLEAR  R0     button_cap_ZERO  x  stop_screw
CLEAR  R0     button_cap_ZERO  x  tape
CLEAR  R0     display  x  beam
CLEAR  R0     display  x  fixed_jaw
CLEAR  R0     display  x  scale_pcb
CLEAR  R0     display  x  stop_screw
CLEAR  R0     display  x  tape
CLEAR  R0     front_pad_0  x  beam
CLEAR  R0     front_pad_0  x  fixed_jaw
CLEAR  R0     front_pad_0  x  scale_pcb
CLEAR  R0     front_pad_0  x  stop_screw
CLEAR  R0     front_pad_0  x  tape
CLEAR  R0     front_pad_1  x  beam
CLEAR  R0     front_pad_1  x  fixed_jaw
CLEAR  R0     front_pad_1  x  scale_pcb
CLEAR  R0     front_pad_1  x  stop_screw
CLEAR  R0     front_pad_1  x  tape
CLEAR  R0     front_pad_2  x  beam
CLEAR  R0     front_pad_2  x  fixed_jaw
CLEAR  R0     front_pad_2  x  scale_pcb
CLEAR  R0     front_pad_2  x  stop_screw
CLEAR  R0     front_pad_2  x  tape
CLEAR  R0     front_pad_3  x  beam
CLEAR  R0     front_pad_3  x  fixed_jaw
CLEAR  R0     front_pad_3  x  scale_pcb
CLEAR  R0     front_pad_3  x  stop_screw
CLEAR  R0     front_pad_3  x  tape
CLEAR  R0     front_shell  x  beam
CLEAR  R0     front_shell  x  fixed_jaw
CLEAR  R0     front_shell  x  scale_pcb
CLEAR  R0     front_shell  x  stop_screw
CLEAR  R0     front_shell  x  tape
CLEAR  R0     lock_screw  x  beam
CLEAR  R0     lock_screw  x  fixed_jaw
CLEAR  R0     lock_screw  x  scale_pcb
CLEAR  R0     lock_screw  x  stop_screw
CLEAR  R0     lock_screw  x  tape
CLEAR  R0     oring  x  fixed_jaw
CLEAR  R0     oring  x  scale_pcb
CLEAR  R0     oring  x  stop_screw
CLEAR  R0     oring  x  tape
CLEAR  R0     plunger_hw_0  x  beam
CLEAR  R0     plunger_hw_0  x  fixed_jaw
CLEAR  R0     plunger_hw_0  x  scale_pcb
CLEAR  R0     plunger_hw_0  x  stop_screw
CLEAR  R0     plunger_hw_0  x  tape
CLEAR  R0     plunger_hw_1  x  beam
CLEAR  R0     plunger_hw_1  x  fixed_jaw
CLEAR  R0     plunger_hw_1  x  scale_pcb
CLEAR  R0     plunger_hw_1  x  stop_screw
CLEAR  R0     plunger_hw_1  x  tape
CLEAR  R0     plunger_hw_2  x  beam
CLEAR  R0     plunger_hw_2  x  fixed_jaw
CLEAR  R0     plunger_hw_2  x  scale_pcb
CLEAR  R0     plunger_hw_2  x  stop_screw
CLEAR  R0     plunger_hw_2  x  tape
CLEAR  R0     plunger_hw_3  x  beam
CLEAR  R0     plunger_hw_3  x  fixed_jaw
CLEAR  R0     plunger_hw_3  x  scale_pcb
CLEAR  R0     plunger_hw_3  x  stop_screw
CLEAR  R0     plunger_hw_3  x  tape
CLEAR  R0     pusher_lock_u19  x  beam
CLEAR  R0     pusher_lock_u19  x  fixed_jaw
CLEAR  R0     pusher_lock_u19  x  scale_pcb
CLEAR  R0     pusher_lock_u19  x  stop_screw
CLEAR  R0     pusher_lock_u19  x  tape
CLEAR  R0     pusher_tip_u14  x  beam
CLEAR  R0     pusher_tip_u14  x  fixed_jaw
CLEAR  R0     pusher_tip_u14  x  scale_pcb
CLEAR  R0     pusher_tip_u14  x  stop_screw
CLEAR  R0     pusher_tip_u14  x  tape
CLEAR  R0     pusher_tip_u24  x  beam
CLEAR  R0     pusher_tip_u24  x  fixed_jaw
CLEAR  R0     pusher_tip_u24  x  scale_pcb
CLEAR  R0     pusher_tip_u24  x  stop_screw
CLEAR  R0     pusher_tip_u24  x  tape
CLEAR  R0     pusher_u14  x  beam
CLEAR  R0     pusher_u14  x  fixed_jaw
CLEAR  R0     pusher_u14  x  scale_pcb
CLEAR  R0     pusher_u14  x  stop_screw
CLEAR  R0     pusher_u14  x  tape
CLEAR  R0     pusher_u24  x  beam
CLEAR  R0     pusher_u24  x  fixed_jaw
CLEAR  R0     pusher_u24  x  scale_pcb
CLEAR  R0     pusher_u24  x  stop_screw
CLEAR  R0     pusher_u24  x  tape
CLEAR  R0     ref_strip  x  beam
CLEAR  R0     ref_strip  x  fixed_jaw
CLEAR  R0     ref_strip  x  scale_pcb
CLEAR  R0     ref_strip  x  stop_screw
CLEAR  R0     ref_strip  x  tape
CLEAR  R0     slider_body  x  beam
CLEAR  R0     slider_body  x  fixed_jaw
CLEAR  R0     slider_body  x  scale_pcb
CLEAR  R0     slider_body  x  stop_screw
CLEAR  R0     slider_body  x  tape
CLEAR  R0     tab_clamp_0  x  beam
CLEAR  R0     tab_clamp_0  x  fixed_jaw
CLEAR  R0     tab_clamp_0  x  scale_pcb
CLEAR  R0     tab_clamp_0  x  stop_screw
CLEAR  R0     tab_clamp_0  x  tape
CLEAR  R0     tab_clamp_1  x  beam
CLEAR  R0     tab_clamp_1  x  fixed_jaw
CLEAR  R0     tab_clamp_1  x  scale_pcb
CLEAR  R0     tab_clamp_1  x  stop_screw
CLEAR  R0     tab_clamp_1  x  tape
CLEAR  R0     tab_clamp_2  x  beam
CLEAR  R0     tab_clamp_2  x  fixed_jaw
CLEAR  R0     tab_clamp_2  x  scale_pcb
CLEAR  R0     tab_clamp_2  x  stop_screw
CLEAR  R0     tab_clamp_2  x  tape
CLEAR  R0     tab_clamp_3  x  beam
CLEAR  R0     tab_clamp_3  x  fixed_jaw
CLEAR  R0     tab_clamp_3  x  scale_pcb
CLEAR  R0     tab_clamp_3  x  stop_screw
CLEAR  R0     tab_clamp_3  x  tape
CLEAR  R0     tab_clamp_4  x  beam
CLEAR  R0     tab_clamp_4  x  fixed_jaw
CLEAR  R0     tab_clamp_4  x  scale_pcb
CLEAR  R0     tab_clamp_4  x  stop_screw
CLEAR  R0     tab_clamp_4  x  tape
CLEAR  R0     tab_clamp_5  x  beam
CLEAR  R0     tab_clamp_5  x  fixed_jaw
CLEAR  R0     tab_clamp_5  x  scale_pcb
CLEAR  R0     tab_clamp_5  x  stop_screw
CLEAR  R0     tab_clamp_5  x  tape
CLEAR  R0     tab_clamp_6  x  beam
CLEAR  R0     tab_clamp_6  x  fixed_jaw
CLEAR  R0     tab_clamp_6  x  scale_pcb
CLEAR  R0     tab_clamp_6  x  stop_screw
CLEAR  R0     tab_clamp_6  x  tape
CLEAR  R0     tab_clamp_7  x  beam
CLEAR  R0     tab_clamp_7  x  fixed_jaw
CLEAR  R0     tab_clamp_7  x  scale_pcb
CLEAR  R0     tab_clamp_7  x  stop_screw
CLEAR  R0     tab_clamp_7  x  tape
CLEAR  R0     thumb_roller  x  beam
CLEAR  R0     thumb_roller  x  fixed_jaw
CLEAR  R0     thumb_roller  x  scale_pcb
CLEAR  R0     thumb_roller  x  stop_screw
CLEAR  R0     thumb_roller  x  tape
CLEAR  R0     y_gib  x  beam
CLEAR  R0     y_gib  x  fixed_jaw
CLEAR  R0     y_gib  x  scale_pcb
CLEAR  R0     y_gib  x  stop_screw
CLEAR  R0     y_gib  x  tape
CLEAR  R0     y_set_screw_u14  x  beam
CLEAR  R0     y_set_screw_u14  x  fixed_jaw
CLEAR  R0     y_set_screw_u14  x  scale_pcb
CLEAR  R0     y_set_screw_u14  x  stop_screw
CLEAR  R0     y_set_screw_u14  x  tape
CLEAR  R0     y_set_screw_u24  x  beam
CLEAR  R0     y_set_screw_u24  x  fixed_jaw
CLEAR  R0     y_set_screw_u24  x  scale_pcb
CLEAR  R0     y_set_screw_u24  x  stop_screw
CLEAR  R0     y_set_screw_u24  x  tape
CLEAR  R151   BZ50  x  beam
CLEAR  R151   BZ50  x  fixed_jaw
CLEAR  R151   BZ50  x  scale_pcb
CLEAR  R151   BZ50  x  stop_screw
CLEAR  R151   BZ50  x  tape
CLEAR  R151   C1  x  beam
CLEAR  R151   C1  x  fixed_jaw
CLEAR  R151   C1  x  scale_pcb
CLEAR  R151   C1  x  stop_screw
CLEAR  R151   C1  x  tape
CLEAR  R151   C10  x  beam
CLEAR  R151   C10  x  fixed_jaw
CLEAR  R151   C10  x  scale_pcb
CLEAR  R151   C10  x  stop_screw
CLEAR  R151   C10  x  tape
CLEAR  R151   C11  x  beam
CLEAR  R151   C11  x  fixed_jaw
CLEAR  R151   C11  x  scale_pcb
CLEAR  R151   C11  x  stop_screw
CLEAR  R151   C11  x  tape
CLEAR  R151   C12  x  beam
CLEAR  R151   C12  x  fixed_jaw
CLEAR  R151   C12  x  scale_pcb
CLEAR  R151   C12  x  stop_screw
CLEAR  R151   C12  x  tape
CLEAR  R151   C13  x  beam
CLEAR  R151   C13  x  fixed_jaw
CLEAR  R151   C13  x  scale_pcb
CLEAR  R151   C13  x  stop_screw
CLEAR  R151   C13  x  tape
CLEAR  R151   C2  x  beam
CLEAR  R151   C2  x  fixed_jaw
CLEAR  R151   C2  x  scale_pcb
CLEAR  R151   C2  x  stop_screw
CLEAR  R151   C2  x  tape
CLEAR  R151   C20  x  beam
CLEAR  R151   C20  x  fixed_jaw
CLEAR  R151   C20  x  scale_pcb
CLEAR  R151   C20  x  stop_screw
CLEAR  R151   C20  x  tape
CLEAR  R151   C21  x  beam
CLEAR  R151   C21  x  fixed_jaw
CLEAR  R151   C21  x  scale_pcb
CLEAR  R151   C21  x  stop_screw
CLEAR  R151   C21  x  tape
CLEAR  R151   C22  x  beam
CLEAR  R151   C22  x  fixed_jaw
CLEAR  R151   C22  x  scale_pcb
CLEAR  R151   C22  x  stop_screw
CLEAR  R151   C22  x  tape
CLEAR  R151   C23  x  beam
CLEAR  R151   C23  x  fixed_jaw
CLEAR  R151   C23  x  scale_pcb
CLEAR  R151   C23  x  stop_screw
CLEAR  R151   C23  x  tape
CLEAR  R151   C3  x  beam
CLEAR  R151   C3  x  fixed_jaw
CLEAR  R151   C3  x  scale_pcb
CLEAR  R151   C3  x  stop_screw
CLEAR  R151   C3  x  tape
CLEAR  R151   C30  x  beam
CLEAR  R151   C30  x  fixed_jaw
CLEAR  R151   C30  x  scale_pcb
CLEAR  R151   C30  x  stop_screw
CLEAR  R151   C30  x  tape
CLEAR  R151   C31  x  beam
CLEAR  R151   C31  x  fixed_jaw
CLEAR  R151   C31  x  scale_pcb
CLEAR  R151   C31  x  stop_screw
CLEAR  R151   C31  x  tape
CLEAR  R151   C4  x  beam
CLEAR  R151   C4  x  fixed_jaw
CLEAR  R151   C4  x  scale_pcb
CLEAR  R151   C4  x  stop_screw
CLEAR  R151   C4  x  tape
CLEAR  R151   C40  x  beam
CLEAR  R151   C40  x  fixed_jaw
CLEAR  R151   C40  x  scale_pcb
CLEAR  R151   C40  x  stop_screw
CLEAR  R151   C40  x  tape
CLEAR  R151   C41  x  beam
CLEAR  R151   C41  x  fixed_jaw
CLEAR  R151   C41  x  scale_pcb
CLEAR  R151   C41  x  stop_screw
CLEAR  R151   C41  x  tape
CLEAR  R151   C42  x  beam
CLEAR  R151   C42  x  fixed_jaw
CLEAR  R151   C42  x  scale_pcb
CLEAR  R151   C42  x  stop_screw
CLEAR  R151   C42  x  tape
CLEAR  R151   C43  x  beam
CLEAR  R151   C43  x  fixed_jaw
CLEAR  R151   C43  x  scale_pcb
CLEAR  R151   C43  x  stop_screw
CLEAR  R151   C43  x  tape
CLEAR  R151   C44  x  beam
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
CLEAR  R151   U30  x  stop_screw
CLEAR  R151   U30  x  tape
CLEAR  R151   U4  x  beam
CLEAR  R151   U4  x  fixed_jaw
CLEAR  R151   U4  x  scale_pcb
CLEAR  R151   U4  x  stop_screw
CLEAR  R151   U4  x  tape
CLEAR  R151   U40  x  beam
CLEAR  R151   U40  x  fixed_jaw
CLEAR  R151   U40  x  scale_pcb
CLEAR  R151   U40  x  stop_screw
CLEAR  R151   U40  x  tape
CLEAR  R151   U5  x  beam
CLEAR  R151   U5  x  fixed_jaw
CLEAR  R151   U5  x  scale_pcb
CLEAR  R151   U5  x  stop_screw
CLEAR  R151   U5  x  tape
CLEAR  R151   U6  x  beam
CLEAR  R151   U6  x  fixed_jaw
CLEAR  R151   U6  x  scale_pcb
CLEAR  R151   U6  x  stop_screw
CLEAR  R151   U6  x  tape
CLEAR  R151   U60  x  beam
CLEAR  R151   U60  x  fixed_jaw
CLEAR  R151   U60  x  scale_pcb
CLEAR  R151   U60  x  stop_screw
CLEAR  R151   U60  x  tape
CLEAR  R151   U61  x  beam
CLEAR  R151   U61  x  fixed_jaw
CLEAR  R151   U61  x  scale_pcb
CLEAR  R151   U61  x  stop_screw
CLEAR  R151   U61  x  tape
CLEAR  R151   back_gib  x  beam
CLEAR  R151   back_gib  x  fixed_jaw
CLEAR  R151   back_gib  x  scale_pcb
CLEAR  R151   back_gib  x  stop_screw
CLEAR  R151   back_gib  x  tape
CLEAR  R151   battery  x  beam
CLEAR  R151   battery  x  fixed_jaw
CLEAR  R151   battery  x  scale_pcb
CLEAR  R151   battery  x  stop_screw
CLEAR  R151   battery  x  tape
CLEAR  R151   battery_door  x  beam
CLEAR  R151   battery_door  x  fixed_jaw
CLEAR  R151   battery_door  x  scale_pcb
CLEAR  R151   battery_door  x  stop_screw
CLEAR  R151   battery_door  x  tape
CLEAR  R151   board  x  beam
CLEAR  R151   board  x  fixed_jaw
CLEAR  R151   board  x  scale_pcb
CLEAR  R151   board  x  stop_screw
CLEAR  R151   board  x  tape
CLEAR  R151   button_cap_HOLD  x  beam
CLEAR  R151   button_cap_HOLD  x  fixed_jaw
CLEAR  R151   button_cap_HOLD  x  scale_pcb
CLEAR  R151   button_cap_HOLD  x  stop_screw
CLEAR  R151   button_cap_HOLD  x  tape
CLEAR  R151   button_cap_MODE  x  beam
CLEAR  R151   button_cap_MODE  x  fixed_jaw
CLEAR  R151   button_cap_MODE  x  scale_pcb
CLEAR  R151   button_cap_MODE  x  stop_screw
CLEAR  R151   button_cap_MODE  x  tape
CLEAR  R151   button_cap_ZERO  x  beam
CLEAR  R151   button_cap_ZERO  x  fixed_jaw
CLEAR  R151   button_cap_ZERO  x  scale_pcb
CLEAR  R151   button_cap_ZERO  x  stop_screw
CLEAR  R151   button_cap_ZERO  x  tape
CLEAR  R151   display  x  beam
CLEAR  R151   display  x  fixed_jaw
CLEAR  R151   display  x  scale_pcb
CLEAR  R151   display  x  stop_screw
CLEAR  R151   display  x  tape
CLEAR  R151   front_pad_0  x  beam
CLEAR  R151   front_pad_0  x  fixed_jaw
CLEAR  R151   front_pad_0  x  scale_pcb
CLEAR  R151   front_pad_0  x  stop_screw
CLEAR  R151   front_pad_0  x  tape
CLEAR  R151   front_pad_1  x  beam
CLEAR  R151   front_pad_1  x  fixed_jaw
CLEAR  R151   front_pad_1  x  scale_pcb
CLEAR  R151   front_pad_1  x  stop_screw
CLEAR  R151   front_pad_1  x  tape
CLEAR  R151   front_pad_2  x  beam
CLEAR  R151   front_pad_2  x  fixed_jaw
CLEAR  R151   front_pad_2  x  scale_pcb
CLEAR  R151   front_pad_2  x  stop_screw
CLEAR  R151   front_pad_2  x  tape
CLEAR  R151   front_pad_3  x  beam
CLEAR  R151   front_pad_3  x  fixed_jaw
CLEAR  R151   front_pad_3  x  scale_pcb
CLEAR  R151   front_pad_3  x  stop_screw
CLEAR  R151   front_pad_3  x  tape
CLEAR  R151   front_shell  x  beam
CLEAR  R151   front_shell  x  fixed_jaw
CLEAR  R151   front_shell  x  scale_pcb
CLEAR  R151   front_shell  x  stop_screw
CLEAR  R151   front_shell  x  tape
CLEAR  R151   lock_screw  x  beam
CLEAR  R151   lock_screw  x  fixed_jaw
CLEAR  R151   lock_screw  x  scale_pcb
CLEAR  R151   lock_screw  x  stop_screw
CLEAR  R151   lock_screw  x  tape
CLEAR  R151   oring  x  fixed_jaw
CLEAR  R151   oring  x  scale_pcb
CLEAR  R151   oring  x  stop_screw
CLEAR  R151   oring  x  tape
CLEAR  R151   plunger_hw_0  x  beam
CLEAR  R151   plunger_hw_0  x  fixed_jaw
CLEAR  R151   plunger_hw_0  x  scale_pcb
CLEAR  R151   plunger_hw_0  x  stop_screw
CLEAR  R151   plunger_hw_0  x  tape
CLEAR  R151   plunger_hw_1  x  beam
CLEAR  R151   plunger_hw_1  x  fixed_jaw
CLEAR  R151   plunger_hw_1  x  scale_pcb
CLEAR  R151   plunger_hw_1  x  stop_screw
CLEAR  R151   plunger_hw_1  x  tape
CLEAR  R151   plunger_hw_2  x  beam
CLEAR  R151   plunger_hw_2  x  fixed_jaw
CLEAR  R151   plunger_hw_2  x  scale_pcb
CLEAR  R151   plunger_hw_2  x  stop_screw
CLEAR  R151   plunger_hw_2  x  tape
CLEAR  R151   plunger_hw_3  x  beam
CLEAR  R151   plunger_hw_3  x  fixed_jaw
CLEAR  R151   plunger_hw_3  x  scale_pcb
CLEAR  R151   plunger_hw_3  x  stop_screw
CLEAR  R151   plunger_hw_3  x  tape
CLEAR  R151   pusher_lock_u19  x  beam
CLEAR  R151   pusher_lock_u19  x  fixed_jaw
CLEAR  R151   pusher_lock_u19  x  scale_pcb
CLEAR  R151   pusher_lock_u19  x  stop_screw
CLEAR  R151   pusher_lock_u19  x  tape
CLEAR  R151   pusher_tip_u14  x  beam
CLEAR  R151   pusher_tip_u14  x  fixed_jaw
CLEAR  R151   pusher_tip_u14  x  scale_pcb
CLEAR  R151   pusher_tip_u14  x  stop_screw
CLEAR  R151   pusher_tip_u14  x  tape
CLEAR  R151   pusher_tip_u24  x  beam
CLEAR  R151   pusher_tip_u24  x  fixed_jaw
CLEAR  R151   pusher_tip_u24  x  scale_pcb
CLEAR  R151   pusher_tip_u24  x  stop_screw
CLEAR  R151   pusher_tip_u24  x  tape
CLEAR  R151   pusher_u14  x  beam
CLEAR  R151   pusher_u14  x  fixed_jaw
CLEAR  R151   pusher_u14  x  scale_pcb
CLEAR  R151   pusher_u14  x  stop_screw
CLEAR  R151   pusher_u14  x  tape
CLEAR  R151   pusher_u24  x  beam
CLEAR  R151   pusher_u24  x  fixed_jaw
CLEAR  R151   pusher_u24  x  scale_pcb
CLEAR  R151   pusher_u24  x  stop_screw
CLEAR  R151   pusher_u24  x  tape
CLEAR  R151   ref_strip  x  beam
CLEAR  R151   ref_strip  x  fixed_jaw
CLEAR  R151   ref_strip  x  scale_pcb
CLEAR  R151   ref_strip  x  stop_screw
CLEAR  R151   ref_strip  x  tape
CLEAR  R151   slider_body  x  beam
CLEAR  R151   slider_body  x  fixed_jaw
CLEAR  R151   slider_body  x  scale_pcb
CLEAR  R151   slider_body  x  stop_screw
CLEAR  R151   slider_body  x  tape
CLEAR  R151   tab_clamp_0  x  beam
CLEAR  R151   tab_clamp_0  x  fixed_jaw
CLEAR  R151   tab_clamp_0  x  scale_pcb
CLEAR  R151   tab_clamp_0  x  stop_screw
CLEAR  R151   tab_clamp_0  x  tape
CLEAR  R151   tab_clamp_1  x  beam
CLEAR  R151   tab_clamp_1  x  fixed_jaw
CLEAR  R151   tab_clamp_1  x  scale_pcb
CLEAR  R151   tab_clamp_1  x  stop_screw
CLEAR  R151   tab_clamp_1  x  tape
CLEAR  R151   tab_clamp_2  x  beam
CLEAR  R151   tab_clamp_2  x  fixed_jaw
CLEAR  R151   tab_clamp_2  x  scale_pcb
CLEAR  R151   tab_clamp_2  x  stop_screw
CLEAR  R151   tab_clamp_2  x  tape
CLEAR  R151   tab_clamp_3  x  beam
CLEAR  R151   tab_clamp_3  x  fixed_jaw
CLEAR  R151   tab_clamp_3  x  scale_pcb
CLEAR  R151   tab_clamp_3  x  stop_screw
CLEAR  R151   tab_clamp_3  x  tape
CLEAR  R151   tab_clamp_4  x  beam
CLEAR  R151   tab_clamp_4  x  fixed_jaw
CLEAR  R151   tab_clamp_4  x  scale_pcb
CLEAR  R151   tab_clamp_4  x  stop_screw
CLEAR  R151   tab_clamp_4  x  tape
CLEAR  R151   tab_clamp_5  x  beam
CLEAR  R151   tab_clamp_5  x  fixed_jaw
CLEAR  R151   tab_clamp_5  x  scale_pcb
CLEAR  R151   tab_clamp_5  x  stop_screw
CLEAR  R151   tab_clamp_5  x  tape
CLEAR  R151   tab_clamp_6  x  beam
CLEAR  R151   tab_clamp_6  x  fixed_jaw
CLEAR  R151   tab_clamp_6  x  scale_pcb
CLEAR  R151   tab_clamp_6  x  stop_screw
CLEAR  R151   tab_clamp_6  x  tape
CLEAR  R151   tab_clamp_7  x  beam
CLEAR  R151   tab_clamp_7  x  fixed_jaw
CLEAR  R151   tab_clamp_7  x  scale_pcb
CLEAR  R151   tab_clamp_7  x  stop_screw
CLEAR  R151   tab_clamp_7  x  tape
CLEAR  R151   thumb_roller  x  beam
CLEAR  R151   thumb_roller  x  fixed_jaw
CLEAR  R151   thumb_roller  x  scale_pcb
CLEAR  R151   thumb_roller  x  stop_screw
CLEAR  R151   thumb_roller  x  tape
CLEAR  R151   y_gib  x  beam
CLEAR  R151   y_gib  x  fixed_jaw
CLEAR  R151   y_gib  x  scale_pcb
CLEAR  R151   y_gib  x  stop_screw
CLEAR  R151   y_gib  x  tape
CLEAR  R151   y_set_screw_u14  x  beam
CLEAR  R151   y_set_screw_u14  x  fixed_jaw
CLEAR  R151   y_set_screw_u14  x  scale_pcb
CLEAR  R151   y_set_screw_u14  x  stop_screw
CLEAR  R151   y_set_screw_u14  x  tape
CLEAR  R151   y_set_screw_u24  x  beam
CLEAR  R151   y_set_screw_u24  x  fixed_jaw
CLEAR  R151   y_set_screw_u24  x  scale_pcb
CLEAR  R151   y_set_screw_u24  x  stop_screw
CLEAR  R151   y_set_screw_u24  x  tape
CLEAR  R75    BZ50  x  beam
CLEAR  R75    BZ50  x  fixed_jaw
CLEAR  R75    BZ50  x  scale_pcb
CLEAR  R75    BZ50  x  stop_screw
CLEAR  R75    BZ50  x  tape
CLEAR  R75    C1  x  beam
CLEAR  R75    C1  x  fixed_jaw
CLEAR  R75    C1  x  scale_pcb
CLEAR  R75    C1  x  stop_screw
CLEAR  R75    C1  x  tape
CLEAR  R75    C10  x  beam
CLEAR  R75    C10  x  fixed_jaw
CLEAR  R75    C10  x  scale_pcb
CLEAR  R75    C10  x  stop_screw
CLEAR  R75    C10  x  tape
CLEAR  R75    C11  x  beam
CLEAR  R75    C11  x  fixed_jaw
CLEAR  R75    C11  x  scale_pcb
CLEAR  R75    C11  x  stop_screw
CLEAR  R75    C11  x  tape
CLEAR  R75    C12  x  beam
CLEAR  R75    C12  x  fixed_jaw
CLEAR  R75    C12  x  scale_pcb
CLEAR  R75    C12  x  stop_screw
CLEAR  R75    C12  x  tape
CLEAR  R75    C13  x  beam
CLEAR  R75    C13  x  fixed_jaw
CLEAR  R75    C13  x  scale_pcb
CLEAR  R75    C13  x  stop_screw
CLEAR  R75    C13  x  tape
CLEAR  R75    C2  x  beam
CLEAR  R75    C2  x  fixed_jaw
CLEAR  R75    C2  x  scale_pcb
CLEAR  R75    C2  x  stop_screw
CLEAR  R75    C2  x  tape
CLEAR  R75    C20  x  beam
CLEAR  R75    C20  x  fixed_jaw
CLEAR  R75    C20  x  scale_pcb
CLEAR  R75    C20  x  stop_screw
CLEAR  R75    C20  x  tape
CLEAR  R75    C21  x  beam
CLEAR  R75    C21  x  fixed_jaw
CLEAR  R75    C21  x  scale_pcb
CLEAR  R75    C21  x  stop_screw
CLEAR  R75    C21  x  tape
CLEAR  R75    C22  x  beam
CLEAR  R75    C22  x  fixed_jaw
CLEAR  R75    C22  x  scale_pcb
CLEAR  R75    C22  x  stop_screw
CLEAR  R75    C22  x  tape
CLEAR  R75    C23  x  beam
CLEAR  R75    C23  x  fixed_jaw
CLEAR  R75    C23  x  scale_pcb
CLEAR  R75    C23  x  stop_screw
CLEAR  R75    C23  x  tape
CLEAR  R75    C3  x  beam
CLEAR  R75    C3  x  fixed_jaw
CLEAR  R75    C3  x  scale_pcb
CLEAR  R75    C3  x  stop_screw
CLEAR  R75    C3  x  tape
CLEAR  R75    C30  x  beam
CLEAR  R75    C30  x  fixed_jaw
CLEAR  R75    C30  x  scale_pcb
CLEAR  R75    C30  x  stop_screw
CLEAR  R75    C30  x  tape
CLEAR  R75    C31  x  beam
CLEAR  R75    C31  x  fixed_jaw
CLEAR  R75    C31  x  scale_pcb
CLEAR  R75    C31  x  stop_screw
CLEAR  R75    C31  x  tape
CLEAR  R75    C4  x  beam
CLEAR  R75    C4  x  fixed_jaw
CLEAR  R75    C4  x  scale_pcb
CLEAR  R75    C4  x  stop_screw
CLEAR  R75    C4  x  tape
CLEAR  R75    C40  x  beam
CLEAR  R75    C40  x  fixed_jaw
CLEAR  R75    C40  x  scale_pcb
CLEAR  R75    C40  x  stop_screw
CLEAR  R75    C40  x  tape
CLEAR  R75    C41  x  beam
CLEAR  R75    C41  x  fixed_jaw
CLEAR  R75    C41  x  scale_pcb
CLEAR  R75    C41  x  stop_screw
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
CLEAR  R75    U2  x  beam
CLEAR  R75    U2  x  fixed_jaw
CLEAR  R75    U2  x  scale_pcb
CLEAR  R75    U2  x  stop_screw
CLEAR  R75    U2  x  tape
CLEAR  R75    U3  x  beam
CLEAR  R75    U3  x  fixed_jaw
CLEAR  R75    U3  x  scale_pcb
CLEAR  R75    U3  x  stop_screw
CLEAR  R75    U3  x  tape
CLEAR  R75    U30  x  beam
CLEAR  R75    U30  x  fixed_jaw
CLEAR  R75    U30  x  scale_pcb
CLEAR  R75    U30  x  stop_screw
CLEAR  R75    U30  x  tape
CLEAR  R75    U4  x  beam
CLEAR  R75    U4  x  fixed_jaw
CLEAR  R75    U4  x  scale_pcb
CLEAR  R75    U4  x  stop_screw
CLEAR  R75    U4  x  tape
CLEAR  R75    U40  x  beam
CLEAR  R75    U40  x  fixed_jaw
CLEAR  R75    U40  x  scale_pcb
CLEAR  R75    U40  x  stop_screw
CLEAR  R75    U40  x  tape
CLEAR  R75    U5  x  beam
CLEAR  R75    U5  x  fixed_jaw
CLEAR  R75    U5  x  scale_pcb
CLEAR  R75    U5  x  stop_screw
CLEAR  R75    U5  x  tape
CLEAR  R75    U6  x  beam
CLEAR  R75    U6  x  fixed_jaw
CLEAR  R75    U6  x  scale_pcb
CLEAR  R75    U6  x  stop_screw
CLEAR  R75    U6  x  tape
CLEAR  R75    U60  x  beam
CLEAR  R75    U60  x  fixed_jaw
CLEAR  R75    U60  x  scale_pcb
CLEAR  R75    U60  x  stop_screw
CLEAR  R75    U60  x  tape
CLEAR  R75    U61  x  beam
CLEAR  R75    U61  x  fixed_jaw
CLEAR  R75    U61  x  scale_pcb
CLEAR  R75    U61  x  stop_screw
CLEAR  R75    U61  x  tape
CLEAR  R75    back_gib  x  beam
CLEAR  R75    back_gib  x  fixed_jaw
CLEAR  R75    back_gib  x  scale_pcb
CLEAR  R75    back_gib  x  stop_screw
CLEAR  R75    back_gib  x  tape
CLEAR  R75    battery  x  beam
CLEAR  R75    battery  x  fixed_jaw
CLEAR  R75    battery  x  scale_pcb
CLEAR  R75    battery  x  stop_screw
CLEAR  R75    battery  x  tape
CLEAR  R75    battery_door  x  beam
CLEAR  R75    battery_door  x  fixed_jaw
CLEAR  R75    battery_door  x  scale_pcb
CLEAR  R75    battery_door  x  stop_screw
CLEAR  R75    battery_door  x  tape
CLEAR  R75    board  x  beam
CLEAR  R75    board  x  fixed_jaw
CLEAR  R75    board  x  scale_pcb
CLEAR  R75    board  x  stop_screw
CLEAR  R75    board  x  tape
CLEAR  R75    button_cap_HOLD  x  beam
CLEAR  R75    button_cap_HOLD  x  fixed_jaw
CLEAR  R75    button_cap_HOLD  x  scale_pcb
CLEAR  R75    button_cap_HOLD  x  stop_screw
CLEAR  R75    button_cap_HOLD  x  tape
CLEAR  R75    button_cap_MODE  x  beam
CLEAR  R75    button_cap_MODE  x  fixed_jaw
CLEAR  R75    button_cap_MODE  x  scale_pcb
CLEAR  R75    button_cap_MODE  x  stop_screw
CLEAR  R75    button_cap_MODE  x  tape
CLEAR  R75    button_cap_ZERO  x  beam
CLEAR  R75    button_cap_ZERO  x  fixed_jaw
CLEAR  R75    button_cap_ZERO  x  scale_pcb
CLEAR  R75    button_cap_ZERO  x  stop_screw
CLEAR  R75    button_cap_ZERO  x  tape
CLEAR  R75    display  x  beam
CLEAR  R75    display  x  fixed_jaw
CLEAR  R75    display  x  scale_pcb
CLEAR  R75    display  x  stop_screw
CLEAR  R75    display  x  tape
CLEAR  R75    front_pad_0  x  beam
CLEAR  R75    front_pad_0  x  fixed_jaw
CLEAR  R75    front_pad_0  x  scale_pcb
CLEAR  R75    front_pad_0  x  stop_screw
CLEAR  R75    front_pad_0  x  tape
CLEAR  R75    front_pad_1  x  beam
CLEAR  R75    front_pad_1  x  fixed_jaw
CLEAR  R75    front_pad_1  x  scale_pcb
CLEAR  R75    front_pad_1  x  stop_screw
CLEAR  R75    front_pad_1  x  tape
CLEAR  R75    front_pad_2  x  beam
CLEAR  R75    front_pad_2  x  fixed_jaw
CLEAR  R75    front_pad_2  x  scale_pcb
CLEAR  R75    front_pad_2  x  stop_screw
CLEAR  R75    front_pad_2  x  tape
CLEAR  R75    front_pad_3  x  beam
CLEAR  R75    front_pad_3  x  fixed_jaw
CLEAR  R75    front_pad_3  x  scale_pcb
CLEAR  R75    front_pad_3  x  stop_screw
CLEAR  R75    front_pad_3  x  tape
CLEAR  R75    front_shell  x  beam
CLEAR  R75    front_shell  x  fixed_jaw
CLEAR  R75    front_shell  x  scale_pcb
CLEAR  R75    front_shell  x  stop_screw
CLEAR  R75    front_shell  x  tape
CLEAR  R75    lock_screw  x  beam
CLEAR  R75    lock_screw  x  fixed_jaw
CLEAR  R75    lock_screw  x  scale_pcb
CLEAR  R75    lock_screw  x  stop_screw
CLEAR  R75    lock_screw  x  tape
CLEAR  R75    oring  x  fixed_jaw
CLEAR  R75    oring  x  scale_pcb
CLEAR  R75    oring  x  stop_screw
CLEAR  R75    oring  x  tape
CLEAR  R75    plunger_hw_0  x  beam
CLEAR  R75    plunger_hw_0  x  fixed_jaw
CLEAR  R75    plunger_hw_0  x  scale_pcb
CLEAR  R75    plunger_hw_0  x  stop_screw
CLEAR  R75    plunger_hw_0  x  tape
CLEAR  R75    plunger_hw_1  x  beam
CLEAR  R75    plunger_hw_1  x  fixed_jaw
CLEAR  R75    plunger_hw_1  x  scale_pcb
CLEAR  R75    plunger_hw_1  x  stop_screw
CLEAR  R75    plunger_hw_1  x  tape
CLEAR  R75    plunger_hw_2  x  beam
CLEAR  R75    plunger_hw_2  x  fixed_jaw
CLEAR  R75    plunger_hw_2  x  scale_pcb
CLEAR  R75    plunger_hw_2  x  stop_screw
CLEAR  R75    plunger_hw_2  x  tape
CLEAR  R75    plunger_hw_3  x  beam
CLEAR  R75    plunger_hw_3  x  fixed_jaw
CLEAR  R75    plunger_hw_3  x  scale_pcb
CLEAR  R75    plunger_hw_3  x  stop_screw
CLEAR  R75    plunger_hw_3  x  tape
CLEAR  R75    pusher_lock_u19  x  beam
CLEAR  R75    pusher_lock_u19  x  fixed_jaw
CLEAR  R75    pusher_lock_u19  x  scale_pcb
CLEAR  R75    pusher_lock_u19  x  stop_screw
CLEAR  R75    pusher_lock_u19  x  tape
CLEAR  R75    pusher_tip_u14  x  beam
CLEAR  R75    pusher_tip_u14  x  fixed_jaw
CLEAR  R75    pusher_tip_u14  x  scale_pcb
CLEAR  R75    pusher_tip_u14  x  stop_screw
CLEAR  R75    pusher_tip_u14  x  tape
CLEAR  R75    pusher_tip_u24  x  beam
CLEAR  R75    pusher_tip_u24  x  fixed_jaw
CLEAR  R75    pusher_tip_u24  x  scale_pcb
CLEAR  R75    pusher_tip_u24  x  stop_screw
CLEAR  R75    pusher_tip_u24  x  tape
CLEAR  R75    pusher_u14  x  beam
CLEAR  R75    pusher_u14  x  fixed_jaw
CLEAR  R75    pusher_u14  x  scale_pcb
CLEAR  R75    pusher_u14  x  stop_screw
CLEAR  R75    pusher_u14  x  tape
CLEAR  R75    pusher_u24  x  beam
CLEAR  R75    pusher_u24  x  fixed_jaw
CLEAR  R75    pusher_u24  x  scale_pcb
CLEAR  R75    pusher_u24  x  stop_screw
CLEAR  R75    pusher_u24  x  tape
CLEAR  R75    ref_strip  x  beam
CLEAR  R75    ref_strip  x  fixed_jaw
CLEAR  R75    ref_strip  x  scale_pcb
CLEAR  R75    ref_strip  x  stop_screw
CLEAR  R75    ref_strip  x  tape
CLEAR  R75    slider_body  x  beam
CLEAR  R75    slider_body  x  fixed_jaw
CLEAR  R75    slider_body  x  scale_pcb
CLEAR  R75    slider_body  x  stop_screw
CLEAR  R75    slider_body  x  tape
CLEAR  R75    tab_clamp_0  x  beam
CLEAR  R75    tab_clamp_0  x  fixed_jaw
CLEAR  R75    tab_clamp_0  x  scale_pcb
CLEAR  R75    tab_clamp_0  x  stop_screw
CLEAR  R75    tab_clamp_0  x  tape
CLEAR  R75    tab_clamp_1  x  beam
CLEAR  R75    tab_clamp_1  x  fixed_jaw
CLEAR  R75    tab_clamp_1  x  scale_pcb
CLEAR  R75    tab_clamp_1  x  stop_screw
CLEAR  R75    tab_clamp_1  x  tape
CLEAR  R75    tab_clamp_2  x  beam
CLEAR  R75    tab_clamp_2  x  fixed_jaw
CLEAR  R75    tab_clamp_2  x  scale_pcb
CLEAR  R75    tab_clamp_2  x  stop_screw
CLEAR  R75    tab_clamp_2  x  tape
CLEAR  R75    tab_clamp_3  x  beam
CLEAR  R75    tab_clamp_3  x  fixed_jaw
CLEAR  R75    tab_clamp_3  x  scale_pcb
CLEAR  R75    tab_clamp_3  x  stop_screw
CLEAR  R75    tab_clamp_3  x  tape
CLEAR  R75    tab_clamp_4  x  beam
CLEAR  R75    tab_clamp_4  x  fixed_jaw
CLEAR  R75    tab_clamp_4  x  scale_pcb
CLEAR  R75    tab_clamp_4  x  stop_screw
CLEAR  R75    tab_clamp_4  x  tape
CLEAR  R75    tab_clamp_5  x  beam
CLEAR  R75    tab_clamp_5  x  fixed_jaw
CLEAR  R75    tab_clamp_5  x  scale_pcb
CLEAR  R75    tab_clamp_5  x  stop_screw
CLEAR  R75    tab_clamp_5  x  tape
CLEAR  R75    tab_clamp_6  x  beam
CLEAR  R75    tab_clamp_6  x  fixed_jaw
CLEAR  R75    tab_clamp_6  x  scale_pcb
CLEAR  R75    tab_clamp_6  x  stop_screw
CLEAR  R75    tab_clamp_6  x  tape
CLEAR  R75    tab_clamp_7  x  beam
CLEAR  R75    tab_clamp_7  x  fixed_jaw
CLEAR  R75    tab_clamp_7  x  scale_pcb
CLEAR  R75    tab_clamp_7  x  stop_screw
CLEAR  R75    tab_clamp_7  x  tape
CLEAR  R75    thumb_roller  x  beam
CLEAR  R75    thumb_roller  x  fixed_jaw
CLEAR  R75    thumb_roller  x  scale_pcb
CLEAR  R75    thumb_roller  x  stop_screw
CLEAR  R75    thumb_roller  x  tape
CLEAR  R75    y_gib  x  beam
CLEAR  R75    y_gib  x  fixed_jaw
CLEAR  R75    y_gib  x  scale_pcb
CLEAR  R75    y_gib  x  stop_screw
CLEAR  R75    y_gib  x  tape
CLEAR  R75    y_set_screw_u14  x  beam
CLEAR  R75    y_set_screw_u14  x  fixed_jaw
CLEAR  R75    y_set_screw_u14  x  scale_pcb
CLEAR  R75    y_set_screw_u14  x  stop_screw
CLEAR  R75    y_set_screw_u14  x  tape
CLEAR  R75    y_set_screw_u24  x  beam
CLEAR  R75    y_set_screw_u24  x  fixed_jaw
CLEAR  R75    y_set_screw_u24  x  scale_pcb
CLEAR  R75    y_set_screw_u24  x  stop_screw
CLEAR  R75    y_set_screw_u24  x  tape
CLEAR  board  BZ50  x  back_gib
CLEAR  board  BZ50  x  battery
CLEAR  board  BZ50  x  battery_door
CLEAR  board  BZ50  x  button_cap_HOLD
CLEAR  board  BZ50  x  button_cap_MODE
CLEAR  board  BZ50  x  button_cap_ZERO
CLEAR  board  BZ50  x  display
CLEAR  board  BZ50  x  front_pad_0
CLEAR  board  BZ50  x  front_pad_1
CLEAR  board  BZ50  x  front_pad_2
CLEAR  board  BZ50  x  front_pad_3
CLEAR  board  BZ50  x  front_shell
CLEAR  board  BZ50  x  lock_screw
CLEAR  board  BZ50  x  oring
CLEAR  board  BZ50  x  plunger_hw_0
CLEAR  board  BZ50  x  plunger_hw_1
CLEAR  board  BZ50  x  plunger_hw_2
CLEAR  board  BZ50  x  plunger_hw_3
CLEAR  board  BZ50  x  pusher_lock_u19
CLEAR  board  BZ50  x  pusher_tip_u14
CLEAR  board  BZ50  x  pusher_tip_u24
CLEAR  board  BZ50  x  pusher_u14
CLEAR  board  BZ50  x  pusher_u24
CLEAR  board  BZ50  x  ref_strip
CLEAR  board  BZ50  x  slider_body
CLEAR  board  BZ50  x  tab_clamp_0
CLEAR  board  BZ50  x  tab_clamp_1
CLEAR  board  BZ50  x  tab_clamp_2
CLEAR  board  BZ50  x  tab_clamp_3
CLEAR  board  BZ50  x  tab_clamp_4
CLEAR  board  BZ50  x  tab_clamp_5
CLEAR  board  BZ50  x  tab_clamp_6
CLEAR  board  BZ50  x  tab_clamp_7
CLEAR  board  BZ50  x  thumb_roller
CLEAR  board  BZ50  x  y_gib
CLEAR  board  BZ50  x  y_set_screw_u14
CLEAR  board  BZ50  x  y_set_screw_u24
CLEAR  board  C1  x  back_gib
CLEAR  board  C1  x  battery
CLEAR  board  C1  x  battery_door
CLEAR  board  C1  x  button_cap_HOLD
CLEAR  board  C1  x  button_cap_MODE
CLEAR  board  C1  x  button_cap_ZERO
CLEAR  board  C1  x  display
CLEAR  board  C1  x  front_pad_0
CLEAR  board  C1  x  front_pad_1
CLEAR  board  C1  x  front_pad_2
CLEAR  board  C1  x  front_pad_3
CLEAR  board  C1  x  front_shell
CLEAR  board  C1  x  lock_screw
CLEAR  board  C1  x  oring
CLEAR  board  C1  x  plunger_hw_0
CLEAR  board  C1  x  plunger_hw_1
CLEAR  board  C1  x  plunger_hw_2
CLEAR  board  C1  x  plunger_hw_3
CLEAR  board  C1  x  pusher_lock_u19
CLEAR  board  C1  x  pusher_tip_u14
CLEAR  board  C1  x  pusher_tip_u24
CLEAR  board  C1  x  pusher_u14
CLEAR  board  C1  x  pusher_u24
CLEAR  board  C1  x  ref_strip
CLEAR  board  C1  x  slider_body
CLEAR  board  C1  x  tab_clamp_0
CLEAR  board  C1  x  tab_clamp_1
CLEAR  board  C1  x  tab_clamp_2
CLEAR  board  C1  x  tab_clamp_3
CLEAR  board  C1  x  tab_clamp_4
CLEAR  board  C1  x  tab_clamp_5
CLEAR  board  C1  x  tab_clamp_6
CLEAR  board  C1  x  tab_clamp_7
CLEAR  board  C1  x  thumb_roller
CLEAR  board  C1  x  y_gib
CLEAR  board  C1  x  y_set_screw_u14
CLEAR  board  C1  x  y_set_screw_u24
CLEAR  board  C10  x  back_gib
CLEAR  board  C10  x  battery
CLEAR  board  C10  x  battery_door
CLEAR  board  C10  x  button_cap_HOLD
CLEAR  board  C10  x  button_cap_MODE
CLEAR  board  C10  x  button_cap_ZERO
CLEAR  board  C10  x  display
CLEAR  board  C10  x  front_pad_0
CLEAR  board  C10  x  front_pad_1
CLEAR  board  C10  x  front_pad_2
CLEAR  board  C10  x  front_pad_3
CLEAR  board  C10  x  front_shell
CLEAR  board  C10  x  lock_screw
CLEAR  board  C10  x  oring
CLEAR  board  C10  x  plunger_hw_0
CLEAR  board  C10  x  plunger_hw_1
CLEAR  board  C10  x  plunger_hw_2
CLEAR  board  C10  x  plunger_hw_3
CLEAR  board  C10  x  pusher_lock_u19
CLEAR  board  C10  x  pusher_tip_u14
CLEAR  board  C10  x  pusher_tip_u24
CLEAR  board  C10  x  pusher_u14
CLEAR  board  C10  x  pusher_u24
CLEAR  board  C10  x  ref_strip
CLEAR  board  C10  x  slider_body
CLEAR  board  C10  x  tab_clamp_0
CLEAR  board  C10  x  tab_clamp_1
CLEAR  board  C10  x  tab_clamp_2
CLEAR  board  C10  x  tab_clamp_3
CLEAR  board  C10  x  tab_clamp_4
CLEAR  board  C10  x  tab_clamp_5
CLEAR  board  C10  x  tab_clamp_6
CLEAR  board  C10  x  tab_clamp_7
CLEAR  board  C10  x  thumb_roller
CLEAR  board  C10  x  y_gib
CLEAR  board  C10  x  y_set_screw_u14
CLEAR  board  C10  x  y_set_screw_u24
CLEAR  board  C11  x  back_gib
CLEAR  board  C11  x  battery
CLEAR  board  C11  x  battery_door
CLEAR  board  C11  x  button_cap_HOLD
CLEAR  board  C11  x  button_cap_MODE
CLEAR  board  C11  x  button_cap_ZERO
CLEAR  board  C11  x  display
CLEAR  board  C11  x  front_pad_0
CLEAR  board  C11  x  front_pad_1
CLEAR  board  C11  x  front_pad_2
CLEAR  board  C11  x  front_pad_3
CLEAR  board  C11  x  front_shell
CLEAR  board  C11  x  lock_screw
CLEAR  board  C11  x  oring
CLEAR  board  C11  x  plunger_hw_0
CLEAR  board  C11  x  plunger_hw_1
CLEAR  board  C11  x  plunger_hw_2
CLEAR  board  C11  x  plunger_hw_3
CLEAR  board  C11  x  pusher_lock_u19
CLEAR  board  C11  x  pusher_tip_u14
CLEAR  board  C11  x  pusher_tip_u24
CLEAR  board  C11  x  pusher_u14
CLEAR  board  C11  x  pusher_u24
CLEAR  board  C11  x  ref_strip
CLEAR  board  C11  x  slider_body
CLEAR  board  C11  x  tab_clamp_0
CLEAR  board  C11  x  tab_clamp_1
CLEAR  board  C11  x  tab_clamp_2
CLEAR  board  C11  x  tab_clamp_3
CLEAR  board  C11  x  tab_clamp_4
CLEAR  board  C11  x  tab_clamp_5
CLEAR  board  C11  x  tab_clamp_6
CLEAR  board  C11  x  tab_clamp_7
CLEAR  board  C11  x  thumb_roller
CLEAR  board  C11  x  y_gib
CLEAR  board  C11  x  y_set_screw_u14
CLEAR  board  C11  x  y_set_screw_u24
CLEAR  board  C12  x  back_gib
CLEAR  board  C12  x  battery
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
CLEAR  board  C7  x  tab_clamp_2
CLEAR  board  C7  x  tab_clamp_3
CLEAR  board  C7  x  tab_clamp_4
CLEAR  board  C7  x  tab_clamp_5
CLEAR  board  C7  x  tab_clamp_6
CLEAR  board  C7  x  tab_clamp_7
CLEAR  board  C7  x  thumb_roller
CLEAR  board  C7  x  y_gib
CLEAR  board  C7  x  y_set_screw_u14
CLEAR  board  C7  x  y_set_screw_u24
CLEAR  board  C8  x  back_gib
CLEAR  board  C8  x  battery
CLEAR  board  C8  x  battery_door
CLEAR  board  C8  x  button_cap_HOLD
CLEAR  board  C8  x  button_cap_MODE
CLEAR  board  C8  x  button_cap_ZERO
CLEAR  board  C8  x  display
CLEAR  board  C8  x  front_pad_0
CLEAR  board  C8  x  front_pad_1
CLEAR  board  C8  x  front_pad_2
CLEAR  board  C8  x  front_pad_3
CLEAR  board  C8  x  front_shell
CLEAR  board  C8  x  lock_screw
CLEAR  board  C8  x  oring
CLEAR  board  C8  x  plunger_hw_0
CLEAR  board  C8  x  plunger_hw_1
CLEAR  board  C8  x  plunger_hw_2
CLEAR  board  C8  x  plunger_hw_3
CLEAR  board  C8  x  pusher_lock_u19
CLEAR  board  C8  x  pusher_tip_u14
CLEAR  board  C8  x  pusher_tip_u24
CLEAR  board  C8  x  pusher_u14
CLEAR  board  C8  x  pusher_u24
CLEAR  board  C8  x  ref_strip
CLEAR  board  C8  x  slider_body
CLEAR  board  C8  x  tab_clamp_0
CLEAR  board  C8  x  tab_clamp_1
CLEAR  board  C8  x  tab_clamp_2
CLEAR  board  C8  x  tab_clamp_3
CLEAR  board  C8  x  tab_clamp_4
CLEAR  board  C8  x  tab_clamp_5
CLEAR  board  C8  x  tab_clamp_6
CLEAR  board  C8  x  tab_clamp_7
CLEAR  board  C8  x  thumb_roller
CLEAR  board  C8  x  y_gib
CLEAR  board  C8  x  y_set_screw_u14
CLEAR  board  C8  x  y_set_screw_u24
CLEAR  board  C9  x  back_gib
CLEAR  board  C9  x  battery
CLEAR  board  C9  x  battery_door
CLEAR  board  C9  x  button_cap_HOLD
CLEAR  board  C9  x  button_cap_MODE
CLEAR  board  C9  x  button_cap_ZERO
CLEAR  board  C9  x  display
CLEAR  board  C9  x  front_pad_0
CLEAR  board  C9  x  front_pad_1
CLEAR  board  C9  x  front_pad_2
CLEAR  board  C9  x  front_pad_3
CLEAR  board  C9  x  front_shell
CLEAR  board  C9  x  lock_screw
CLEAR  board  C9  x  oring
CLEAR  board  C9  x  plunger_hw_0
CLEAR  board  C9  x  plunger_hw_1
CLEAR  board  C9  x  plunger_hw_2
CLEAR  board  C9  x  plunger_hw_3
CLEAR  board  C9  x  pusher_lock_u19
CLEAR  board  C9  x  pusher_tip_u14
CLEAR  board  C9  x  pusher_tip_u24
CLEAR  board  C9  x  pusher_u14
CLEAR  board  C9  x  pusher_u24
CLEAR  board  C9  x  ref_strip
CLEAR  board  C9  x  slider_body
CLEAR  board  C9  x  tab_clamp_0
CLEAR  board  C9  x  tab_clamp_1
CLEAR  board  C9  x  tab_clamp_2
CLEAR  board  C9  x  tab_clamp_3
CLEAR  board  C9  x  tab_clamp_4
CLEAR  board  C9  x  tab_clamp_5
CLEAR  board  C9  x  tab_clamp_6
CLEAR  board  C9  x  tab_clamp_7
CLEAR  board  C9  x  thumb_roller
CLEAR  board  C9  x  y_gib
CLEAR  board  C9  x  y_set_screw_u14
CLEAR  board  C9  x  y_set_screw_u24
CLEAR  board  D1  x  back_gib
CLEAR  board  D1  x  battery
CLEAR  board  D1  x  battery_door
CLEAR  board  D1  x  button_cap_HOLD
CLEAR  board  D1  x  button_cap_MODE
CLEAR  board  D1  x  button_cap_ZERO
CLEAR  board  D1  x  display
CLEAR  board  D1  x  front_pad_0
CLEAR  board  D1  x  front_pad_1
CLEAR  board  D1  x  front_pad_2
CLEAR  board  D1  x  front_pad_3
CLEAR  board  D1  x  front_shell
CLEAR  board  D1  x  lock_screw
CLEAR  board  D1  x  oring
CLEAR  board  D1  x  plunger_hw_0
CLEAR  board  D1  x  plunger_hw_1
CLEAR  board  D1  x  plunger_hw_2
CLEAR  board  D1  x  plunger_hw_3
CLEAR  board  D1  x  pusher_lock_u19
CLEAR  board  D1  x  pusher_tip_u14
CLEAR  board  D1  x  pusher_tip_u24
CLEAR  board  D1  x  pusher_u14
CLEAR  board  D1  x  pusher_u24
CLEAR  board  D1  x  ref_strip
CLEAR  board  D1  x  slider_body
CLEAR  board  D1  x  tab_clamp_0
CLEAR  board  D1  x  tab_clamp_1
CLEAR  board  D1  x  tab_clamp_2
CLEAR  board  D1  x  tab_clamp_3
CLEAR  board  D1  x  tab_clamp_4
CLEAR  board  D1  x  tab_clamp_5
CLEAR  board  D1  x  tab_clamp_6
CLEAR  board  D1  x  tab_clamp_7
CLEAR  board  D1  x  thumb_roller
CLEAR  board  D1  x  y_gib
CLEAR  board  D1  x  y_set_screw_u14
CLEAR  board  D1  x  y_set_screw_u24
CLEAR  board  D50  x  back_gib
CLEAR  board  D50  x  battery
CLEAR  board  D50  x  battery_door
CLEAR  board  D50  x  button_cap_HOLD
CLEAR  board  D50  x  button_cap_MODE
CLEAR  board  D50  x  button_cap_ZERO
CLEAR  board  D50  x  display
CLEAR  board  D50  x  front_pad_0
CLEAR  board  D50  x  front_pad_1
CLEAR  board  D50  x  front_pad_2
CLEAR  board  D50  x  front_pad_3
CLEAR  board  D50  x  front_shell
CLEAR  board  D50  x  lock_screw
CLEAR  board  D50  x  oring
CLEAR  board  D50  x  plunger_hw_0
CLEAR  board  D50  x  plunger_hw_1
CLEAR  board  D50  x  plunger_hw_2
CLEAR  board  D50  x  plunger_hw_3
CLEAR  board  D50  x  pusher_lock_u19
CLEAR  board  D50  x  pusher_tip_u14
CLEAR  board  D50  x  pusher_tip_u24
CLEAR  board  D50  x  pusher_u14
CLEAR  board  D50  x  pusher_u24
CLEAR  board  D50  x  ref_strip
CLEAR  board  D50  x  slider_body
CLEAR  board  D50  x  tab_clamp_0
CLEAR  board  D50  x  tab_clamp_1
CLEAR  board  D50  x  tab_clamp_2
CLEAR  board  D50  x  tab_clamp_3
CLEAR  board  D50  x  tab_clamp_4
CLEAR  board  D50  x  tab_clamp_5
CLEAR  board  D50  x  tab_clamp_6
CLEAR  board  D50  x  tab_clamp_7
CLEAR  board  D50  x  thumb_roller
CLEAR  board  D50  x  y_gib
CLEAR  board  D50  x  y_set_screw_u14
CLEAR  board  D50  x  y_set_screw_u24
CLEAR  board  H2_standoff  x  back_gib
CLEAR  board  H2_standoff  x  battery
CLEAR  board  H2_standoff  x  battery_door
CLEAR  board  H2_standoff  x  button_cap_HOLD
CLEAR  board  H2_standoff  x  button_cap_MODE
CLEAR  board  H2_standoff  x  button_cap_ZERO
CLEAR  board  H2_standoff  x  display
CLEAR  board  H2_standoff  x  front_pad_0
CLEAR  board  H2_standoff  x  front_pad_1
CLEAR  board  H2_standoff  x  front_pad_2
CLEAR  board  H2_standoff  x  front_pad_3
CLEAR  board  H2_standoff  x  front_shell
CLEAR  board  H2_standoff  x  lock_screw
CLEAR  board  H2_standoff  x  oring
CLEAR  board  H2_standoff  x  plunger_hw_0
CLEAR  board  H2_standoff  x  plunger_hw_1
CLEAR  board  H2_standoff  x  plunger_hw_2
CLEAR  board  H2_standoff  x  plunger_hw_3
CLEAR  board  H2_standoff  x  pusher_lock_u19
CLEAR  board  H2_standoff  x  pusher_tip_u14
CLEAR  board  H2_standoff  x  pusher_tip_u24
CLEAR  board  H2_standoff  x  pusher_u14
CLEAR  board  H2_standoff  x  pusher_u24
CLEAR  board  H2_standoff  x  ref_strip
CLEAR  board  H2_standoff  x  slider_body
CLEAR  board  H2_standoff  x  tab_clamp_0
CLEAR  board  H2_standoff  x  tab_clamp_1
CLEAR  board  H2_standoff  x  tab_clamp_2
CLEAR  board  H2_standoff  x  tab_clamp_3
CLEAR  board  H2_standoff  x  tab_clamp_4
CLEAR  board  H2_standoff  x  tab_clamp_5
CLEAR  board  H2_standoff  x  tab_clamp_6
CLEAR  board  H2_standoff  x  tab_clamp_7
CLEAR  board  H2_standoff  x  thumb_roller
CLEAR  board  H2_standoff  x  y_gib
CLEAR  board  H2_standoff  x  y_set_screw_u14
CLEAR  board  H2_standoff  x  y_set_screw_u24
CLEAR  board  H3_standoff  x  back_gib
CLEAR  board  H3_standoff  x  battery
CLEAR  board  H3_standoff  x  battery_door
CLEAR  board  H3_standoff  x  button_cap_HOLD
CLEAR  board  H3_standoff  x  button_cap_MODE
CLEAR  board  H3_standoff  x  button_cap_ZERO
CLEAR  board  H3_standoff  x  display
CLEAR  board  H3_standoff  x  front_pad_0
CLEAR  board  H3_standoff  x  front_pad_1
CLEAR  board  H3_standoff  x  front_pad_2
CLEAR  board  H3_standoff  x  front_pad_3
CLEAR  board  H3_standoff  x  front_shell
CLEAR  board  H3_standoff  x  lock_screw
CLEAR  board  H3_standoff  x  oring
CLEAR  board  H3_standoff  x  plunger_hw_0
CLEAR  board  H3_standoff  x  plunger_hw_1
CLEAR  board  H3_standoff  x  plunger_hw_2
CLEAR  board  H3_standoff  x  plunger_hw_3
CLEAR  board  H3_standoff  x  pusher_lock_u19
CLEAR  board  H3_standoff  x  pusher_tip_u14
CLEAR  board  H3_standoff  x  pusher_tip_u24
CLEAR  board  H3_standoff  x  pusher_u14
CLEAR  board  H3_standoff  x  pusher_u24
CLEAR  board  H3_standoff  x  ref_strip
CLEAR  board  H3_standoff  x  slider_body
CLEAR  board  H3_standoff  x  tab_clamp_0
CLEAR  board  H3_standoff  x  tab_clamp_1
CLEAR  board  H3_standoff  x  tab_clamp_2
CLEAR  board  H3_standoff  x  tab_clamp_3
CLEAR  board  H3_standoff  x  tab_clamp_4
CLEAR  board  H3_standoff  x  tab_clamp_5
CLEAR  board  H3_standoff  x  tab_clamp_6
CLEAR  board  H3_standoff  x  tab_clamp_7
CLEAR  board  H3_standoff  x  thumb_roller
CLEAR  board  H3_standoff  x  y_gib
CLEAR  board  H3_standoff  x  y_set_screw_u14
CLEAR  board  H3_standoff  x  y_set_screw_u24
CLEAR  board  H4_standoff  x  back_gib
CLEAR  board  H4_standoff  x  battery
CLEAR  board  H4_standoff  x  battery_door
CLEAR  board  H4_standoff  x  button_cap_HOLD
CLEAR  board  H4_standoff  x  button_cap_MODE
CLEAR  board  H4_standoff  x  button_cap_ZERO
CLEAR  board  H4_standoff  x  display
CLEAR  board  H4_standoff  x  front_pad_0
CLEAR  board  H4_standoff  x  front_pad_1
CLEAR  board  H4_standoff  x  front_pad_2
CLEAR  board  H4_standoff  x  front_pad_3
CLEAR  board  H4_standoff  x  front_shell
CLEAR  board  H4_standoff  x  lock_screw
CLEAR  board  H4_standoff  x  oring
CLEAR  board  H4_standoff  x  plunger_hw_0
CLEAR  board  H4_standoff  x  plunger_hw_1
CLEAR  board  H4_standoff  x  plunger_hw_2
CLEAR  board  H4_standoff  x  plunger_hw_3
CLEAR  board  H4_standoff  x  pusher_lock_u19
CLEAR  board  H4_standoff  x  pusher_tip_u14
CLEAR  board  H4_standoff  x  pusher_tip_u24
CLEAR  board  H4_standoff  x  pusher_u14
CLEAR  board  H4_standoff  x  pusher_u24
CLEAR  board  H4_standoff  x  ref_strip
CLEAR  board  H4_standoff  x  slider_body
CLEAR  board  H4_standoff  x  tab_clamp_0
CLEAR  board  H4_standoff  x  tab_clamp_1
CLEAR  board  H4_standoff  x  tab_clamp_2
CLEAR  board  H4_standoff  x  tab_clamp_3
CLEAR  board  H4_standoff  x  tab_clamp_4
CLEAR  board  H4_standoff  x  tab_clamp_5
CLEAR  board  H4_standoff  x  tab_clamp_6
CLEAR  board  H4_standoff  x  tab_clamp_7
CLEAR  board  H4_standoff  x  thumb_roller
CLEAR  board  H4_standoff  x  y_gib
CLEAR  board  H4_standoff  x  y_set_screw_u14
CLEAR  board  H4_standoff  x  y_set_screw_u24
CLEAR  board  H5_standoff  x  back_gib
CLEAR  board  H5_standoff  x  battery
CLEAR  board  H5_standoff  x  battery_door
CLEAR  board  H5_standoff  x  button_cap_HOLD
CLEAR  board  H5_standoff  x  button_cap_MODE
CLEAR  board  H5_standoff  x  button_cap_ZERO
CLEAR  board  H5_standoff  x  display
CLEAR  board  H5_standoff  x  front_pad_0
CLEAR  board  H5_standoff  x  front_pad_1
CLEAR  board  H5_standoff  x  front_pad_2
CLEAR  board  H5_standoff  x  front_pad_3
CLEAR  board  H5_standoff  x  front_shell
CLEAR  board  H5_standoff  x  lock_screw
CLEAR  board  H5_standoff  x  oring
CLEAR  board  H5_standoff  x  plunger_hw_0
CLEAR  board  H5_standoff  x  plunger_hw_1
CLEAR  board  H5_standoff  x  plunger_hw_2
CLEAR  board  H5_standoff  x  plunger_hw_3
CLEAR  board  H5_standoff  x  pusher_lock_u19
CLEAR  board  H5_standoff  x  pusher_tip_u14
CLEAR  board  H5_standoff  x  pusher_tip_u24
CLEAR  board  H5_standoff  x  pusher_u14
CLEAR  board  H5_standoff  x  pusher_u24
CLEAR  board  H5_standoff  x  ref_strip
CLEAR  board  H5_standoff  x  slider_body
CLEAR  board  H5_standoff  x  tab_clamp_0
CLEAR  board  H5_standoff  x  tab_clamp_1
CLEAR  board  H5_standoff  x  tab_clamp_2
CLEAR  board  H5_standoff  x  tab_clamp_3
CLEAR  board  H5_standoff  x  tab_clamp_4
CLEAR  board  H5_standoff  x  tab_clamp_5
CLEAR  board  H5_standoff  x  tab_clamp_6
CLEAR  board  H5_standoff  x  tab_clamp_7
CLEAR  board  H5_standoff  x  thumb_roller
CLEAR  board  H5_standoff  x  y_gib
CLEAR  board  H5_standoff  x  y_set_screw_u14
CLEAR  board  H5_standoff  x  y_set_screw_u24
CLEAR  board  J1  x  back_gib
CLEAR  board  J1  x  battery
CLEAR  board  J1  x  battery_door
CLEAR  board  J1  x  button_cap_HOLD
CLEAR  board  J1  x  button_cap_MODE
CLEAR  board  J1  x  button_cap_ZERO
CLEAR  board  J1  x  display
CLEAR  board  J1  x  front_pad_0
CLEAR  board  J1  x  front_pad_1
CLEAR  board  J1  x  front_pad_2
CLEAR  board  J1  x  front_pad_3
CLEAR  board  J1  x  front_shell
CLEAR  board  J1  x  lock_screw
CLEAR  board  J1  x  oring
CLEAR  board  J1  x  plunger_hw_0
CLEAR  board  J1  x  plunger_hw_1
CLEAR  board  J1  x  plunger_hw_2
CLEAR  board  J1  x  plunger_hw_3
CLEAR  board  J1  x  pusher_lock_u19
CLEAR  board  J1  x  pusher_tip_u14
CLEAR  board  J1  x  pusher_tip_u24
CLEAR  board  J1  x  pusher_u14
CLEAR  board  J1  x  pusher_u24
CLEAR  board  J1  x  ref_strip
CLEAR  board  J1  x  slider_body
CLEAR  board  J1  x  tab_clamp_0
CLEAR  board  J1  x  tab_clamp_1
CLEAR  board  J1  x  tab_clamp_2
CLEAR  board  J1  x  tab_clamp_3
CLEAR  board  J1  x  tab_clamp_4
CLEAR  board  J1  x  tab_clamp_5
CLEAR  board  J1  x  tab_clamp_6
CLEAR  board  J1  x  tab_clamp_7
CLEAR  board  J1  x  thumb_roller
CLEAR  board  J1  x  y_gib
CLEAR  board  J1  x  y_set_screw_u14
CLEAR  board  J1  x  y_set_screw_u24
CLEAR  board  J2  x  back_gib
CLEAR  board  J2  x  battery
CLEAR  board  J2  x  battery_door
CLEAR  board  J2  x  button_cap_HOLD
CLEAR  board  J2  x  button_cap_MODE
CLEAR  board  J2  x  button_cap_ZERO
CLEAR  board  J2  x  display
CLEAR  board  J2  x  front_pad_0
CLEAR  board  J2  x  front_pad_1
CLEAR  board  J2  x  front_pad_2
CLEAR  board  J2  x  front_pad_3
CLEAR  board  J2  x  front_shell
CLEAR  board  J2  x  lock_screw
CLEAR  board  J2  x  oring
CLEAR  board  J2  x  plunger_hw_0
CLEAR  board  J2  x  plunger_hw_1
CLEAR  board  J2  x  plunger_hw_2
CLEAR  board  J2  x  plunger_hw_3
CLEAR  board  J2  x  pusher_lock_u19
CLEAR  board  J2  x  pusher_tip_u14
CLEAR  board  J2  x  pusher_tip_u24
CLEAR  board  J2  x  pusher_u14
CLEAR  board  J2  x  pusher_u24
CLEAR  board  J2  x  ref_strip
CLEAR  board  J2  x  slider_body
CLEAR  board  J2  x  tab_clamp_0
CLEAR  board  J2  x  tab_clamp_1
CLEAR  board  J2  x  tab_clamp_2
CLEAR  board  J2  x  tab_clamp_3
CLEAR  board  J2  x  tab_clamp_4
CLEAR  board  J2  x  tab_clamp_5
CLEAR  board  J2  x  tab_clamp_6
CLEAR  board  J2  x  tab_clamp_7
CLEAR  board  J2  x  thumb_roller
CLEAR  board  J2  x  y_gib
CLEAR  board  J2  x  y_set_screw_u14
CLEAR  board  J2  x  y_set_screw_u24
CLEAR  board  J2_plug  x  back_gib
CLEAR  board  J2_plug  x  battery
CLEAR  board  J2_plug  x  battery_door
CLEAR  board  J2_plug  x  button_cap_HOLD
CLEAR  board  J2_plug  x  button_cap_MODE
CLEAR  board  J2_plug  x  button_cap_ZERO
CLEAR  board  J2_plug  x  display
CLEAR  board  J2_plug  x  front_pad_0
CLEAR  board  J2_plug  x  front_pad_1
CLEAR  board  J2_plug  x  front_pad_2
CLEAR  board  J2_plug  x  front_pad_3
CLEAR  board  J2_plug  x  front_shell
CLEAR  board  J2_plug  x  lock_screw
CLEAR  board  J2_plug  x  oring
CLEAR  board  J2_plug  x  plunger_hw_0
CLEAR  board  J2_plug  x  plunger_hw_1
CLEAR  board  J2_plug  x  plunger_hw_2
CLEAR  board  J2_plug  x  plunger_hw_3
CLEAR  board  J2_plug  x  pusher_lock_u19
CLEAR  board  J2_plug  x  pusher_tip_u14
CLEAR  board  J2_plug  x  pusher_tip_u24
CLEAR  board  J2_plug  x  pusher_u14
CLEAR  board  J2_plug  x  pusher_u24
CLEAR  board  J2_plug  x  ref_strip
CLEAR  board  J2_plug  x  slider_body
CLEAR  board  J2_plug  x  tab_clamp_0
CLEAR  board  J2_plug  x  tab_clamp_1
CLEAR  board  J2_plug  x  tab_clamp_2
CLEAR  board  J2_plug  x  tab_clamp_3
CLEAR  board  J2_plug  x  tab_clamp_4
CLEAR  board  J2_plug  x  tab_clamp_5
CLEAR  board  J2_plug  x  tab_clamp_6
CLEAR  board  J2_plug  x  tab_clamp_7
CLEAR  board  J2_plug  x  thumb_roller
CLEAR  board  J2_plug  x  y_gib
CLEAR  board  J2_plug  x  y_set_screw_u14
CLEAR  board  J2_plug  x  y_set_screw_u24
CLEAR  board  J50  x  back_gib
CLEAR  board  J50  x  battery
CLEAR  board  J50  x  battery_door
CLEAR  board  J50  x  button_cap_HOLD
CLEAR  board  J50  x  button_cap_MODE
CLEAR  board  J50  x  button_cap_ZERO
CLEAR  board  J50  x  display
CLEAR  board  J50  x  front_pad_0
CLEAR  board  J50  x  front_pad_1
CLEAR  board  J50  x  front_pad_2
CLEAR  board  J50  x  front_pad_3
CLEAR  board  J50  x  front_shell
CLEAR  board  J50  x  lock_screw
CLEAR  board  J50  x  oring
CLEAR  board  J50  x  plunger_hw_0
CLEAR  board  J50  x  plunger_hw_1
CLEAR  board  J50  x  plunger_hw_2
CLEAR  board  J50  x  plunger_hw_3
CLEAR  board  J50  x  pusher_lock_u19
CLEAR  board  J50  x  pusher_tip_u14
CLEAR  board  J50  x  pusher_tip_u24
CLEAR  board  J50  x  pusher_u14
CLEAR  board  J50  x  pusher_u24
CLEAR  board  J50  x  ref_strip
CLEAR  board  J50  x  slider_body
CLEAR  board  J50  x  tab_clamp_0
CLEAR  board  J50  x  tab_clamp_1
CLEAR  board  J50  x  tab_clamp_2
CLEAR  board  J50  x  tab_clamp_3
CLEAR  board  J50  x  tab_clamp_4
CLEAR  board  J50  x  tab_clamp_5
CLEAR  board  J50  x  tab_clamp_6
CLEAR  board  J50  x  tab_clamp_7
CLEAR  board  J50  x  thumb_roller
CLEAR  board  J50  x  y_gib
CLEAR  board  J50  x  y_set_screw_u14
CLEAR  board  J50  x  y_set_screw_u24
CLEAR  board  L1  x  back_gib
CLEAR  board  L1  x  battery
CLEAR  board  L1  x  battery_door
CLEAR  board  L1  x  button_cap_HOLD
CLEAR  board  L1  x  button_cap_MODE
CLEAR  board  L1  x  button_cap_ZERO
CLEAR  board  L1  x  display
CLEAR  board  L1  x  front_pad_0
CLEAR  board  L1  x  front_pad_1
CLEAR  board  L1  x  front_pad_2
CLEAR  board  L1  x  front_pad_3
CLEAR  board  L1  x  front_shell
CLEAR  board  L1  x  lock_screw
CLEAR  board  L1  x  oring
CLEAR  board  L1  x  plunger_hw_0
CLEAR  board  L1  x  plunger_hw_1
CLEAR  board  L1  x  plunger_hw_2
CLEAR  board  L1  x  plunger_hw_3
CLEAR  board  L1  x  pusher_lock_u19
CLEAR  board  L1  x  pusher_tip_u14
CLEAR  board  L1  x  pusher_tip_u24
CLEAR  board  L1  x  pusher_u14
CLEAR  board  L1  x  pusher_u24
CLEAR  board  L1  x  ref_strip
CLEAR  board  L1  x  slider_body
CLEAR  board  L1  x  tab_clamp_0
CLEAR  board  L1  x  tab_clamp_1
CLEAR  board  L1  x  tab_clamp_2
CLEAR  board  L1  x  tab_clamp_3
CLEAR  board  L1  x  tab_clamp_4
CLEAR  board  L1  x  tab_clamp_5
CLEAR  board  L1  x  tab_clamp_6
CLEAR  board  L1  x  tab_clamp_7
CLEAR  board  L1  x  thumb_roller
CLEAR  board  L1  x  y_gib
CLEAR  board  L1  x  y_set_screw_u14
CLEAR  board  L1  x  y_set_screw_u24
CLEAR  board  Q1  x  back_gib
CLEAR  board  Q1  x  battery
CLEAR  board  Q1  x  battery_door
CLEAR  board  Q1  x  button_cap_HOLD
CLEAR  board  Q1  x  button_cap_MODE
CLEAR  board  Q1  x  button_cap_ZERO
CLEAR  board  Q1  x  display
CLEAR  board  Q1  x  front_pad_0
CLEAR  board  Q1  x  front_pad_1
CLEAR  board  Q1  x  front_pad_2
CLEAR  board  Q1  x  front_pad_3
CLEAR  board  Q1  x  front_shell
CLEAR  board  Q1  x  lock_screw
CLEAR  board  Q1  x  oring
CLEAR  board  Q1  x  plunger_hw_0
CLEAR  board  Q1  x  plunger_hw_1
CLEAR  board  Q1  x  plunger_hw_2
CLEAR  board  Q1  x  plunger_hw_3
CLEAR  board  Q1  x  pusher_lock_u19
CLEAR  board  Q1  x  pusher_tip_u14
CLEAR  board  Q1  x  pusher_tip_u24
CLEAR  board  Q1  x  pusher_u14
CLEAR  board  Q1  x  pusher_u24
CLEAR  board  Q1  x  ref_strip
CLEAR  board  Q1  x  slider_body
CLEAR  board  Q1  x  tab_clamp_0
CLEAR  board  Q1  x  tab_clamp_1
CLEAR  board  Q1  x  tab_clamp_2
CLEAR  board  Q1  x  tab_clamp_3
CLEAR  board  Q1  x  tab_clamp_4
CLEAR  board  Q1  x  tab_clamp_5
CLEAR  board  Q1  x  tab_clamp_6
CLEAR  board  Q1  x  tab_clamp_7
CLEAR  board  Q1  x  thumb_roller
CLEAR  board  Q1  x  y_gib
CLEAR  board  Q1  x  y_set_screw_u14
CLEAR  board  Q1  x  y_set_screw_u24
CLEAR  board  Q50  x  back_gib
CLEAR  board  Q50  x  battery
CLEAR  board  Q50  x  battery_door
CLEAR  board  Q50  x  button_cap_HOLD
CLEAR  board  Q50  x  button_cap_MODE
CLEAR  board  Q50  x  button_cap_ZERO
CLEAR  board  Q50  x  display
CLEAR  board  Q50  x  front_pad_0
CLEAR  board  Q50  x  front_pad_1
CLEAR  board  Q50  x  front_pad_2
CLEAR  board  Q50  x  front_pad_3
CLEAR  board  Q50  x  front_shell
CLEAR  board  Q50  x  lock_screw
CLEAR  board  Q50  x  oring
CLEAR  board  Q50  x  plunger_hw_0
CLEAR  board  Q50  x  plunger_hw_1
CLEAR  board  Q50  x  plunger_hw_2
CLEAR  board  Q50  x  plunger_hw_3
CLEAR  board  Q50  x  pusher_lock_u19
CLEAR  board  Q50  x  pusher_tip_u14
CLEAR  board  Q50  x  pusher_tip_u24
CLEAR  board  Q50  x  pusher_u14
CLEAR  board  Q50  x  pusher_u24
CLEAR  board  Q50  x  ref_strip
CLEAR  board  Q50  x  slider_body
CLEAR  board  Q50  x  tab_clamp_0
CLEAR  board  Q50  x  tab_clamp_1
CLEAR  board  Q50  x  tab_clamp_2
CLEAR  board  Q50  x  tab_clamp_3
CLEAR  board  Q50  x  tab_clamp_4
CLEAR  board  Q50  x  tab_clamp_5
CLEAR  board  Q50  x  tab_clamp_6
CLEAR  board  Q50  x  tab_clamp_7
CLEAR  board  Q50  x  thumb_roller
CLEAR  board  Q50  x  y_gib
CLEAR  board  Q50  x  y_set_screw_u14
CLEAR  board  Q50  x  y_set_screw_u24
CLEAR  board  Q51  x  back_gib
CLEAR  board  Q51  x  battery
CLEAR  board  Q51  x  battery_door
CLEAR  board  Q51  x  button_cap_HOLD
CLEAR  board  Q51  x  button_cap_MODE
CLEAR  board  Q51  x  button_cap_ZERO
CLEAR  board  Q51  x  display
CLEAR  board  Q51  x  front_pad_0
CLEAR  board  Q51  x  front_pad_1
CLEAR  board  Q51  x  front_pad_2
CLEAR  board  Q51  x  front_pad_3
CLEAR  board  Q51  x  front_shell
CLEAR  board  Q51  x  lock_screw
CLEAR  board  Q51  x  oring
CLEAR  board  Q51  x  plunger_hw_0
CLEAR  board  Q51  x  plunger_hw_1
CLEAR  board  Q51  x  plunger_hw_2
CLEAR  board  Q51  x  plunger_hw_3
CLEAR  board  Q51  x  pusher_lock_u19
CLEAR  board  Q51  x  pusher_tip_u14
CLEAR  board  Q51  x  pusher_tip_u24
CLEAR  board  Q51  x  pusher_u14
CLEAR  board  Q51  x  pusher_u24
CLEAR  board  Q51  x  ref_strip
CLEAR  board  Q51  x  slider_body
CLEAR  board  Q51  x  tab_clamp_0
CLEAR  board  Q51  x  tab_clamp_1
CLEAR  board  Q51  x  tab_clamp_2
CLEAR  board  Q51  x  tab_clamp_3
CLEAR  board  Q51  x  tab_clamp_4
CLEAR  board  Q51  x  tab_clamp_5
CLEAR  board  Q51  x  tab_clamp_6
CLEAR  board  Q51  x  tab_clamp_7
CLEAR  board  Q51  x  thumb_roller
CLEAR  board  Q51  x  y_gib
CLEAR  board  Q51  x  y_set_screw_u14
CLEAR  board  Q51  x  y_set_screw_u24
CLEAR  board  R1  x  back_gib
CLEAR  board  R1  x  battery
CLEAR  board  R1  x  battery_door
CLEAR  board  R1  x  button_cap_HOLD
CLEAR  board  R1  x  button_cap_MODE
CLEAR  board  R1  x  button_cap_ZERO
CLEAR  board  R1  x  display
CLEAR  board  R1  x  front_pad_0
CLEAR  board  R1  x  front_pad_1
CLEAR  board  R1  x  front_pad_2
CLEAR  board  R1  x  front_pad_3
CLEAR  board  R1  x  front_shell
CLEAR  board  R1  x  lock_screw
CLEAR  board  R1  x  oring
CLEAR  board  R1  x  plunger_hw_0
CLEAR  board  R1  x  plunger_hw_1
CLEAR  board  R1  x  plunger_hw_2
CLEAR  board  R1  x  plunger_hw_3
CLEAR  board  R1  x  pusher_lock_u19
CLEAR  board  R1  x  pusher_tip_u14
CLEAR  board  R1  x  pusher_tip_u24
CLEAR  board  R1  x  pusher_u14
CLEAR  board  R1  x  pusher_u24
CLEAR  board  R1  x  ref_strip
CLEAR  board  R1  x  slider_body
CLEAR  board  R1  x  tab_clamp_0
CLEAR  board  R1  x  tab_clamp_1
CLEAR  board  R1  x  tab_clamp_2
CLEAR  board  R1  x  tab_clamp_3
CLEAR  board  R1  x  tab_clamp_4
CLEAR  board  R1  x  tab_clamp_5
CLEAR  board  R1  x  tab_clamp_6
CLEAR  board  R1  x  tab_clamp_7
CLEAR  board  R1  x  thumb_roller
CLEAR  board  R1  x  y_gib
CLEAR  board  R1  x  y_set_screw_u14
CLEAR  board  R1  x  y_set_screw_u24
CLEAR  board  R10  x  back_gib
CLEAR  board  R10  x  battery
CLEAR  board  R10  x  battery_door
CLEAR  board  R10  x  button_cap_HOLD
CLEAR  board  R10  x  button_cap_MODE
CLEAR  board  R10  x  button_cap_ZERO
CLEAR  board  R10  x  display
CLEAR  board  R10  x  front_pad_0
CLEAR  board  R10  x  front_pad_1
CLEAR  board  R10  x  front_pad_2
CLEAR  board  R10  x  front_pad_3
CLEAR  board  R10  x  front_shell
CLEAR  board  R10  x  lock_screw
CLEAR  board  R10  x  oring
CLEAR  board  R10  x  plunger_hw_0
CLEAR  board  R10  x  plunger_hw_1
CLEAR  board  R10  x  plunger_hw_2
CLEAR  board  R10  x  plunger_hw_3
CLEAR  board  R10  x  pusher_lock_u19
CLEAR  board  R10  x  pusher_tip_u14
CLEAR  board  R10  x  pusher_tip_u24
CLEAR  board  R10  x  pusher_u14
CLEAR  board  R10  x  pusher_u24
CLEAR  board  R10  x  ref_strip
CLEAR  board  R10  x  slider_body
CLEAR  board  R10  x  tab_clamp_0
CLEAR  board  R10  x  tab_clamp_1
CLEAR  board  R10  x  tab_clamp_2
CLEAR  board  R10  x  tab_clamp_3
CLEAR  board  R10  x  tab_clamp_4
CLEAR  board  R10  x  tab_clamp_5
CLEAR  board  R10  x  tab_clamp_6
CLEAR  board  R10  x  tab_clamp_7
CLEAR  board  R10  x  thumb_roller
CLEAR  board  R10  x  y_gib
CLEAR  board  R10  x  y_set_screw_u14
CLEAR  board  R10  x  y_set_screw_u24
CLEAR  board  R2  x  back_gib
CLEAR  board  R2  x  battery
CLEAR  board  R2  x  battery_door
CLEAR  board  R2  x  button_cap_HOLD
CLEAR  board  R2  x  button_cap_MODE
CLEAR  board  R2  x  button_cap_ZERO
CLEAR  board  R2  x  display
CLEAR  board  R2  x  front_pad_0
CLEAR  board  R2  x  front_pad_1
CLEAR  board  R2  x  front_pad_2
CLEAR  board  R2  x  front_pad_3
CLEAR  board  R2  x  front_shell
CLEAR  board  R2  x  lock_screw
CLEAR  board  R2  x  oring
CLEAR  board  R2  x  plunger_hw_0
CLEAR  board  R2  x  plunger_hw_1
CLEAR  board  R2  x  plunger_hw_2
CLEAR  board  R2  x  plunger_hw_3
CLEAR  board  R2  x  pusher_lock_u19
CLEAR  board  R2  x  pusher_tip_u14
CLEAR  board  R2  x  pusher_tip_u24
CLEAR  board  R2  x  pusher_u14
CLEAR  board  R2  x  pusher_u24
CLEAR  board  R2  x  ref_strip
CLEAR  board  R2  x  slider_body
CLEAR  board  R2  x  tab_clamp_0
CLEAR  board  R2  x  tab_clamp_1
CLEAR  board  R2  x  tab_clamp_2
CLEAR  board  R2  x  tab_clamp_3
CLEAR  board  R2  x  tab_clamp_4
CLEAR  board  R2  x  tab_clamp_5
CLEAR  board  R2  x  tab_clamp_6
CLEAR  board  R2  x  tab_clamp_7
CLEAR  board  R2  x  thumb_roller
CLEAR  board  R2  x  y_gib
CLEAR  board  R2  x  y_set_screw_u14
CLEAR  board  R2  x  y_set_screw_u24
CLEAR  board  R20  x  back_gib
CLEAR  board  R20  x  battery
CLEAR  board  R20  x  battery_door
CLEAR  board  R20  x  button_cap_HOLD
CLEAR  board  R20  x  button_cap_MODE
CLEAR  board  R20  x  button_cap_ZERO
CLEAR  board  R20  x  display
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
CLEAR  board  R84  x  y_set_screw_u24
CLEAR  board  R85  x  back_gib
CLEAR  board  R85  x  battery
CLEAR  board  R85  x  battery_door
CLEAR  board  R85  x  button_cap_HOLD
CLEAR  board  R85  x  button_cap_MODE
CLEAR  board  R85  x  button_cap_ZERO
CLEAR  board  R85  x  display
CLEAR  board  R85  x  front_pad_0
CLEAR  board  R85  x  front_pad_1
CLEAR  board  R85  x  front_pad_2
CLEAR  board  R85  x  front_pad_3
CLEAR  board  R85  x  front_shell
CLEAR  board  R85  x  lock_screw
CLEAR  board  R85  x  oring
CLEAR  board  R85  x  plunger_hw_0
CLEAR  board  R85  x  plunger_hw_1
CLEAR  board  R85  x  plunger_hw_2
CLEAR  board  R85  x  plunger_hw_3
CLEAR  board  R85  x  pusher_lock_u19
CLEAR  board  R85  x  pusher_tip_u14
CLEAR  board  R85  x  pusher_tip_u24
CLEAR  board  R85  x  pusher_u14
CLEAR  board  R85  x  pusher_u24
CLEAR  board  R85  x  ref_strip
CLEAR  board  R85  x  slider_body
CLEAR  board  R85  x  tab_clamp_0
CLEAR  board  R85  x  tab_clamp_1
CLEAR  board  R85  x  tab_clamp_2
CLEAR  board  R85  x  tab_clamp_3
CLEAR  board  R85  x  tab_clamp_4
CLEAR  board  R85  x  tab_clamp_5
CLEAR  board  R85  x  tab_clamp_6
CLEAR  board  R85  x  tab_clamp_7
CLEAR  board  R85  x  thumb_roller
CLEAR  board  R85  x  y_gib
CLEAR  board  R85  x  y_set_screw_u14
CLEAR  board  R85  x  y_set_screw_u24
CLEAR  board  R9  x  back_gib
CLEAR  board  R9  x  battery
CLEAR  board  R9  x  battery_door
CLEAR  board  R9  x  button_cap_HOLD
CLEAR  board  R9  x  button_cap_MODE
CLEAR  board  R9  x  button_cap_ZERO
CLEAR  board  R9  x  display
CLEAR  board  R9  x  front_pad_0
CLEAR  board  R9  x  front_pad_1
CLEAR  board  R9  x  front_pad_2
CLEAR  board  R9  x  front_pad_3
CLEAR  board  R9  x  front_shell
CLEAR  board  R9  x  lock_screw
CLEAR  board  R9  x  oring
CLEAR  board  R9  x  plunger_hw_0
CLEAR  board  R9  x  plunger_hw_1
CLEAR  board  R9  x  plunger_hw_2
CLEAR  board  R9  x  plunger_hw_3
CLEAR  board  R9  x  pusher_lock_u19
CLEAR  board  R9  x  pusher_tip_u14
CLEAR  board  R9  x  pusher_tip_u24
CLEAR  board  R9  x  pusher_u14
CLEAR  board  R9  x  pusher_u24
CLEAR  board  R9  x  ref_strip
CLEAR  board  R9  x  slider_body
CLEAR  board  R9  x  tab_clamp_0
CLEAR  board  R9  x  tab_clamp_1
CLEAR  board  R9  x  tab_clamp_2
CLEAR  board  R9  x  tab_clamp_3
CLEAR  board  R9  x  tab_clamp_4
CLEAR  board  R9  x  tab_clamp_5
CLEAR  board  R9  x  tab_clamp_6
CLEAR  board  R9  x  tab_clamp_7
CLEAR  board  R9  x  thumb_roller
CLEAR  board  R9  x  y_gib
CLEAR  board  R9  x  y_set_screw_u14
CLEAR  board  R9  x  y_set_screw_u24
CLEAR  board  RT1  x  back_gib
CLEAR  board  RT1  x  battery
CLEAR  board  RT1  x  battery_door
CLEAR  board  RT1  x  button_cap_HOLD
CLEAR  board  RT1  x  button_cap_MODE
CLEAR  board  RT1  x  button_cap_ZERO
CLEAR  board  RT1  x  display
CLEAR  board  RT1  x  front_pad_0
CLEAR  board  RT1  x  front_pad_1
CLEAR  board  RT1  x  front_pad_2
CLEAR  board  RT1  x  front_pad_3
CLEAR  board  RT1  x  front_shell
CLEAR  board  RT1  x  lock_screw
CLEAR  board  RT1  x  oring
CLEAR  board  RT1  x  plunger_hw_0
CLEAR  board  RT1  x  plunger_hw_1
CLEAR  board  RT1  x  plunger_hw_2
CLEAR  board  RT1  x  plunger_hw_3
CLEAR  board  RT1  x  pusher_lock_u19
CLEAR  board  RT1  x  pusher_tip_u14
CLEAR  board  RT1  x  pusher_tip_u24
CLEAR  board  RT1  x  pusher_u14
CLEAR  board  RT1  x  pusher_u24
CLEAR  board  RT1  x  ref_strip
CLEAR  board  RT1  x  slider_body
CLEAR  board  RT1  x  tab_clamp_0
CLEAR  board  RT1  x  tab_clamp_1
CLEAR  board  RT1  x  tab_clamp_2
CLEAR  board  RT1  x  tab_clamp_3
CLEAR  board  RT1  x  tab_clamp_4
CLEAR  board  RT1  x  tab_clamp_5
CLEAR  board  RT1  x  tab_clamp_6
CLEAR  board  RT1  x  tab_clamp_7
CLEAR  board  RT1  x  thumb_roller
CLEAR  board  RT1  x  y_gib
CLEAR  board  RT1  x  y_set_screw_u14
CLEAR  board  RT1  x  y_set_screw_u24
CLEAR  board  SW20  x  back_gib
CLEAR  board  SW20  x  battery
CLEAR  board  SW20  x  battery_door
CLEAR  board  SW20  x  button_cap_HOLD
CLEAR  board  SW20  x  button_cap_MODE
CLEAR  board  SW20  x  button_cap_ZERO
CLEAR  board  SW20  x  display
CLEAR  board  SW20  x  front_pad_0
CLEAR  board  SW20  x  front_pad_1
CLEAR  board  SW20  x  front_pad_2
CLEAR  board  SW20  x  front_pad_3
CLEAR  board  SW20  x  front_shell
CLEAR  board  SW20  x  lock_screw
CLEAR  board  SW20  x  oring
CLEAR  board  SW20  x  plunger_hw_0
CLEAR  board  SW20  x  plunger_hw_1
CLEAR  board  SW20  x  plunger_hw_2
CLEAR  board  SW20  x  plunger_hw_3
CLEAR  board  SW20  x  pusher_lock_u19
CLEAR  board  SW20  x  pusher_tip_u14
CLEAR  board  SW20  x  pusher_tip_u24
CLEAR  board  SW20  x  pusher_u14
CLEAR  board  SW20  x  pusher_u24
CLEAR  board  SW20  x  ref_strip
CLEAR  board  SW20  x  slider_body
CLEAR  board  SW20  x  tab_clamp_0
CLEAR  board  SW20  x  tab_clamp_1
CLEAR  board  SW20  x  tab_clamp_2
CLEAR  board  SW20  x  tab_clamp_3
CLEAR  board  SW20  x  tab_clamp_4
CLEAR  board  SW20  x  tab_clamp_5
CLEAR  board  SW20  x  tab_clamp_6
CLEAR  board  SW20  x  tab_clamp_7
CLEAR  board  SW20  x  thumb_roller
CLEAR  board  SW20  x  y_gib
CLEAR  board  SW20  x  y_set_screw_u14
CLEAR  board  SW20  x  y_set_screw_u24
CLEAR  board  SW50  x  back_gib
CLEAR  board  SW50  x  battery
CLEAR  board  SW50  x  battery_door
CLEAR  board  SW50  x  button_cap_HOLD
CLEAR  board  SW50  x  button_cap_MODE
CLEAR  board  SW50  x  button_cap_ZERO
CLEAR  board  SW50  x  display
CLEAR  board  SW50  x  front_pad_0
CLEAR  board  SW50  x  front_pad_1
CLEAR  board  SW50  x  front_pad_2
CLEAR  board  SW50  x  front_pad_3
CLEAR  board  SW50  x  front_shell
CLEAR  board  SW50  x  lock_screw
CLEAR  board  SW50  x  oring
CLEAR  board  SW50  x  plunger_hw_0
CLEAR  board  SW50  x  plunger_hw_1
CLEAR  board  SW50  x  plunger_hw_2
CLEAR  board  SW50  x  plunger_hw_3
CLEAR  board  SW50  x  pusher_lock_u19
CLEAR  board  SW50  x  pusher_tip_u14
CLEAR  board  SW50  x  pusher_tip_u24
CLEAR  board  SW50  x  pusher_u14
CLEAR  board  SW50  x  pusher_u24
CLEAR  board  SW50  x  ref_strip
CLEAR  board  SW50  x  slider_body
CLEAR  board  SW50  x  tab_clamp_0
CLEAR  board  SW50  x  tab_clamp_1
CLEAR  board  SW50  x  tab_clamp_2
CLEAR  board  SW50  x  tab_clamp_3
CLEAR  board  SW50  x  tab_clamp_4
CLEAR  board  SW50  x  tab_clamp_5
CLEAR  board  SW50  x  tab_clamp_6
CLEAR  board  SW50  x  tab_clamp_7
CLEAR  board  SW50  x  thumb_roller
CLEAR  board  SW50  x  y_gib
CLEAR  board  SW50  x  y_set_screw_u14
CLEAR  board  SW50  x  y_set_screw_u24
CLEAR  board  SW51  x  back_gib
CLEAR  board  SW51  x  battery
CLEAR  board  SW51  x  battery_door
CLEAR  board  SW51  x  button_cap_HOLD
CLEAR  board  SW51  x  button_cap_MODE
CLEAR  board  SW51  x  button_cap_ZERO
CLEAR  board  SW51  x  display
CLEAR  board  SW51  x  front_pad_0
CLEAR  board  SW51  x  front_pad_1
CLEAR  board  SW51  x  front_pad_2
CLEAR  board  SW51  x  front_pad_3
CLEAR  board  SW51  x  front_shell
CLEAR  board  SW51  x  lock_screw
CLEAR  board  SW51  x  oring
CLEAR  board  SW51  x  plunger_hw_0
CLEAR  board  SW51  x  plunger_hw_1
CLEAR  board  SW51  x  plunger_hw_2
CLEAR  board  SW51  x  plunger_hw_3
CLEAR  board  SW51  x  pusher_lock_u19
CLEAR  board  SW51  x  pusher_tip_u14
CLEAR  board  SW51  x  pusher_tip_u24
CLEAR  board  SW51  x  pusher_u14
CLEAR  board  SW51  x  pusher_u24
CLEAR  board  SW51  x  ref_strip
CLEAR  board  SW51  x  slider_body
CLEAR  board  SW51  x  tab_clamp_0
CLEAR  board  SW51  x  tab_clamp_1
CLEAR  board  SW51  x  tab_clamp_2
CLEAR  board  SW51  x  tab_clamp_3
CLEAR  board  SW51  x  tab_clamp_4
CLEAR  board  SW51  x  tab_clamp_5
CLEAR  board  SW51  x  tab_clamp_6
CLEAR  board  SW51  x  tab_clamp_7
CLEAR  board  SW51  x  thumb_roller
CLEAR  board  SW51  x  y_gib
CLEAR  board  SW51  x  y_set_screw_u14
CLEAR  board  SW51  x  y_set_screw_u24
CLEAR  board  SW52  x  back_gib
CLEAR  board  SW52  x  battery
CLEAR  board  SW52  x  battery_door
CLEAR  board  SW52  x  button_cap_HOLD
CLEAR  board  SW52  x  button_cap_MODE
CLEAR  board  SW52  x  button_cap_ZERO
CLEAR  board  SW52  x  display
CLEAR  board  SW52  x  front_pad_0
CLEAR  board  SW52  x  front_pad_1
CLEAR  board  SW52  x  front_pad_2
CLEAR  board  SW52  x  front_pad_3
CLEAR  board  SW52  x  front_shell
CLEAR  board  SW52  x  lock_screw
CLEAR  board  SW52  x  oring
CLEAR  board  SW52  x  plunger_hw_0
CLEAR  board  SW52  x  plunger_hw_1
CLEAR  board  SW52  x  plunger_hw_2
CLEAR  board  SW52  x  plunger_hw_3
CLEAR  board  SW52  x  pusher_lock_u19
CLEAR  board  SW52  x  pusher_tip_u14
CLEAR  board  SW52  x  pusher_tip_u24
CLEAR  board  SW52  x  pusher_u14
CLEAR  board  SW52  x  pusher_u24
CLEAR  board  SW52  x  ref_strip
CLEAR  board  SW52  x  slider_body
CLEAR  board  SW52  x  tab_clamp_0
CLEAR  board  SW52  x  tab_clamp_1
CLEAR  board  SW52  x  tab_clamp_2
CLEAR  board  SW52  x  tab_clamp_3
CLEAR  board  SW52  x  tab_clamp_4
CLEAR  board  SW52  x  tab_clamp_5
CLEAR  board  SW52  x  tab_clamp_6
CLEAR  board  SW52  x  tab_clamp_7
CLEAR  board  SW52  x  thumb_roller
CLEAR  board  SW52  x  y_gib
CLEAR  board  SW52  x  y_set_screw_u14
CLEAR  board  SW52  x  y_set_screw_u24
CLEAR  board  U1  x  back_gib
CLEAR  board  U1  x  battery
CLEAR  board  U1  x  battery_door
CLEAR  board  U1  x  button_cap_HOLD
CLEAR  board  U1  x  button_cap_MODE
CLEAR  board  U1  x  button_cap_ZERO
CLEAR  board  U1  x  display
CLEAR  board  U1  x  front_pad_0
CLEAR  board  U1  x  front_pad_1
CLEAR  board  U1  x  front_pad_2
CLEAR  board  U1  x  front_pad_3
CLEAR  board  U1  x  front_shell
CLEAR  board  U1  x  lock_screw
CLEAR  board  U1  x  oring
CLEAR  board  U1  x  plunger_hw_0
CLEAR  board  U1  x  plunger_hw_1
CLEAR  board  U1  x  plunger_hw_2
CLEAR  board  U1  x  plunger_hw_3
CLEAR  board  U1  x  pusher_lock_u19
CLEAR  board  U1  x  pusher_tip_u14
CLEAR  board  U1  x  pusher_tip_u24
CLEAR  board  U1  x  pusher_u14
CLEAR  board  U1  x  pusher_u24
CLEAR  board  U1  x  ref_strip
CLEAR  board  U1  x  slider_body
CLEAR  board  U1  x  tab_clamp_0
CLEAR  board  U1  x  tab_clamp_1
CLEAR  board  U1  x  tab_clamp_2
CLEAR  board  U1  x  tab_clamp_3
CLEAR  board  U1  x  tab_clamp_4
CLEAR  board  U1  x  tab_clamp_5
CLEAR  board  U1  x  tab_clamp_6
CLEAR  board  U1  x  tab_clamp_7
CLEAR  board  U1  x  thumb_roller
CLEAR  board  U1  x  y_gib
CLEAR  board  U1  x  y_set_screw_u14
CLEAR  board  U1  x  y_set_screw_u24
CLEAR  board  U10  x  back_gib
CLEAR  board  U10  x  battery
CLEAR  board  U10  x  battery_door
CLEAR  board  U10  x  button_cap_HOLD
CLEAR  board  U10  x  button_cap_MODE
CLEAR  board  U10  x  button_cap_ZERO
CLEAR  board  U10  x  display
CLEAR  board  U10  x  front_pad_0
CLEAR  board  U10  x  front_pad_1
CLEAR  board  U10  x  front_pad_2
CLEAR  board  U10  x  front_pad_3
CLEAR  board  U10  x  front_shell
CLEAR  board  U10  x  lock_screw
CLEAR  board  U10  x  oring
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
CLEAR  board  U60  x  pusher_u14
CLEAR  board  U60  x  pusher_u24
CLEAR  board  U60  x  ref_strip
CLEAR  board  U60  x  slider_body
CLEAR  board  U60  x  tab_clamp_0
CLEAR  board  U60  x  tab_clamp_1
CLEAR  board  U60  x  tab_clamp_2
CLEAR  board  U60  x  tab_clamp_3
CLEAR  board  U60  x  tab_clamp_4
CLEAR  board  U60  x  tab_clamp_5
CLEAR  board  U60  x  tab_clamp_6
CLEAR  board  U60  x  tab_clamp_7
CLEAR  board  U60  x  thumb_roller
CLEAR  board  U60  x  y_gib
CLEAR  board  U60  x  y_set_screw_u14
CLEAR  board  U60  x  y_set_screw_u24
CLEAR  board  U61  x  back_gib
CLEAR  board  U61  x  battery
CLEAR  board  U61  x  battery_door
CLEAR  board  U61  x  button_cap_HOLD
CLEAR  board  U61  x  button_cap_MODE
CLEAR  board  U61  x  button_cap_ZERO
CLEAR  board  U61  x  display
CLEAR  board  U61  x  front_pad_0
CLEAR  board  U61  x  front_pad_1
CLEAR  board  U61  x  front_pad_2
CLEAR  board  U61  x  front_pad_3
CLEAR  board  U61  x  front_shell
CLEAR  board  U61  x  lock_screw
CLEAR  board  U61  x  oring
CLEAR  board  U61  x  plunger_hw_0
CLEAR  board  U61  x  plunger_hw_1
CLEAR  board  U61  x  plunger_hw_2
CLEAR  board  U61  x  plunger_hw_3
CLEAR  board  U61  x  pusher_lock_u19
CLEAR  board  U61  x  pusher_tip_u14
CLEAR  board  U61  x  pusher_tip_u24
CLEAR  board  U61  x  pusher_u14
CLEAR  board  U61  x  pusher_u24
CLEAR  board  U61  x  ref_strip
CLEAR  board  U61  x  slider_body
CLEAR  board  U61  x  tab_clamp_0
CLEAR  board  U61  x  tab_clamp_1
CLEAR  board  U61  x  tab_clamp_2
CLEAR  board  U61  x  tab_clamp_3
CLEAR  board  U61  x  tab_clamp_4
CLEAR  board  U61  x  tab_clamp_5
CLEAR  board  U61  x  tab_clamp_6
CLEAR  board  U61  x  tab_clamp_7
CLEAR  board  U61  x  thumb_roller
CLEAR  board  U61  x  y_gib
CLEAR  board  U61  x  y_set_screw_u14
CLEAR  board  U61  x  y_set_screw_u24
CLEAR  board  board  x  back_gib
CLEAR  board  board  x  battery
CLEAR  board  board  x  battery_door
CLEAR  board  board  x  button_cap_HOLD
CLEAR  board  board  x  button_cap_MODE
CLEAR  board  board  x  button_cap_ZERO
CLEAR  board  board  x  display
CLEAR  board  board  x  front_pad_0
CLEAR  board  board  x  front_pad_1
CLEAR  board  board  x  front_pad_2
CLEAR  board  board  x  front_pad_3
CLEAR  board  board  x  front_shell
CLEAR  board  board  x  lock_screw
CLEAR  board  board  x  oring
CLEAR  board  board  x  plunger_hw_0
CLEAR  board  board  x  plunger_hw_1
CLEAR  board  board  x  plunger_hw_2
CLEAR  board  board  x  plunger_hw_3
CLEAR  board  board  x  pusher_lock_u19
CLEAR  board  board  x  pusher_tip_u14
CLEAR  board  board  x  pusher_tip_u24
CLEAR  board  board  x  pusher_u14
CLEAR  board  board  x  pusher_u24
CLEAR  board  board  x  ref_strip
CLEAR  board  board  x  slider_body
CLEAR  board  board  x  tab_clamp_0
CLEAR  board  board  x  tab_clamp_1
CLEAR  board  board  x  tab_clamp_2
CLEAR  board  board  x  tab_clamp_3
CLEAR  board  board  x  tab_clamp_4
CLEAR  board  board  x  tab_clamp_5
CLEAR  board  board  x  tab_clamp_6
CLEAR  board  board  x  tab_clamp_7
CLEAR  board  board  x  thumb_roller
CLEAR  board  board  x  y_gib
CLEAR  board  board  x  y_set_screw_u14
CLEAR  board  board  x  y_set_screw_u24
CLEAR  pair   back_gib  x  battery
CLEAR  pair   back_gib  x  display
CLEAR  pair   back_gib  x  front_pad_0
CLEAR  pair   back_gib  x  front_pad_1
CLEAR  pair   back_gib  x  front_pad_2
CLEAR  pair   back_gib  x  front_pad_3
CLEAR  pair   back_gib  x  lock_screw
CLEAR  pair   back_gib  x  plunger_hw_0
CLEAR  pair   back_gib  x  plunger_hw_1
CLEAR  pair   back_gib  x  plunger_hw_2
CLEAR  pair   back_gib  x  plunger_hw_3
CLEAR  pair   back_gib  x  pusher_lock_u19
CLEAR  pair   back_gib  x  pusher_tip_u14
CLEAR  pair   back_gib  x  pusher_tip_u24
CLEAR  pair   back_gib  x  pusher_u14
CLEAR  pair   back_gib  x  pusher_u24
CLEAR  pair   back_gib  x  ref_strip
CLEAR  pair   back_gib  x  tab_clamp_0
CLEAR  pair   back_gib  x  tab_clamp_1
CLEAR  pair   back_gib  x  tab_clamp_2
CLEAR  pair   back_gib  x  tab_clamp_3
CLEAR  pair   back_gib  x  tab_clamp_4
CLEAR  pair   back_gib  x  tab_clamp_5
CLEAR  pair   back_gib  x  tab_clamp_6
CLEAR  pair   back_gib  x  tab_clamp_7
CLEAR  pair   back_gib  x  y_gib
CLEAR  pair   back_gib  x  y_set_screw_u14
CLEAR  pair   back_gib  x  y_set_screw_u24
CLEAR  pair   battery  x  plunger_hw_0
CLEAR  pair   battery  x  plunger_hw_1
CLEAR  pair   battery  x  plunger_hw_2
CLEAR  pair   battery  x  plunger_hw_3
CLEAR  pair   battery  x  tab_clamp_0
CLEAR  pair   battery  x  tab_clamp_1
CLEAR  pair   battery  x  tab_clamp_2
CLEAR  pair   battery  x  tab_clamp_3
CLEAR  pair   battery  x  tab_clamp_4
CLEAR  pair   battery  x  tab_clamp_5
CLEAR  pair   battery  x  tab_clamp_6
CLEAR  pair   battery  x  tab_clamp_7
CLEAR  pair   battery_door  x  back_gib
CLEAR  pair   battery_door  x  battery
CLEAR  pair   battery_door  x  button_cap_HOLD
CLEAR  pair   battery_door  x  button_cap_MODE
CLEAR  pair   battery_door  x  button_cap_ZERO
CLEAR  pair   battery_door  x  display
CLEAR  pair   battery_door  x  front_pad_0
CLEAR  pair   battery_door  x  front_pad_1
CLEAR  pair   battery_door  x  front_pad_2
CLEAR  pair   battery_door  x  front_pad_3
CLEAR  pair   battery_door  x  lock_screw
CLEAR  pair   battery_door  x  oring
CLEAR  pair   battery_door  x  plunger_hw_0
CLEAR  pair   battery_door  x  plunger_hw_1
CLEAR  pair   battery_door  x  plunger_hw_2
CLEAR  pair   battery_door  x  plunger_hw_3
CLEAR  pair   battery_door  x  pusher_lock_u19
CLEAR  pair   battery_door  x  pusher_tip_u14
CLEAR  pair   battery_door  x  pusher_tip_u24
CLEAR  pair   battery_door  x  pusher_u14
CLEAR  pair   battery_door  x  pusher_u24
CLEAR  pair   battery_door  x  ref_strip
CLEAR  pair   battery_door  x  tab_clamp_0
CLEAR  pair   battery_door  x  tab_clamp_1
CLEAR  pair   battery_door  x  tab_clamp_2
CLEAR  pair   battery_door  x  tab_clamp_3
CLEAR  pair   battery_door  x  tab_clamp_4
CLEAR  pair   battery_door  x  tab_clamp_5
CLEAR  pair   battery_door  x  tab_clamp_6
CLEAR  pair   battery_door  x  tab_clamp_7
CLEAR  pair   battery_door  x  thumb_roller
CLEAR  pair   battery_door  x  y_gib
CLEAR  pair   battery_door  x  y_set_screw_u14
CLEAR  pair   battery_door  x  y_set_screw_u24
CLEAR  pair   button_cap_HOLD  x  back_gib
CLEAR  pair   button_cap_HOLD  x  battery
CLEAR  pair   button_cap_HOLD  x  button_cap_MODE
CLEAR  pair   button_cap_HOLD  x  display
CLEAR  pair   button_cap_HOLD  x  front_pad_0
CLEAR  pair   button_cap_HOLD  x  front_pad_1
CLEAR  pair   button_cap_HOLD  x  front_pad_2
CLEAR  pair   button_cap_HOLD  x  front_pad_3
CLEAR  pair   button_cap_HOLD  x  lock_screw
CLEAR  pair   button_cap_HOLD  x  oring
CLEAR  pair   button_cap_HOLD  x  plunger_hw_0
CLEAR  pair   button_cap_HOLD  x  plunger_hw_1
CLEAR  pair   button_cap_HOLD  x  plunger_hw_2
CLEAR  pair   button_cap_HOLD  x  plunger_hw_3
CLEAR  pair   button_cap_HOLD  x  pusher_lock_u19
CLEAR  pair   button_cap_HOLD  x  pusher_tip_u14
CLEAR  pair   button_cap_HOLD  x  pusher_tip_u24
CLEAR  pair   button_cap_HOLD  x  pusher_u14
CLEAR  pair   button_cap_HOLD  x  pusher_u24
CLEAR  pair   button_cap_HOLD  x  ref_strip
CLEAR  pair   button_cap_HOLD  x  tab_clamp_0
CLEAR  pair   button_cap_HOLD  x  tab_clamp_1
CLEAR  pair   button_cap_HOLD  x  tab_clamp_2
CLEAR  pair   button_cap_HOLD  x  tab_clamp_3
CLEAR  pair   button_cap_HOLD  x  tab_clamp_4
CLEAR  pair   button_cap_HOLD  x  tab_clamp_5
CLEAR  pair   button_cap_HOLD  x  tab_clamp_6
CLEAR  pair   button_cap_HOLD  x  tab_clamp_7
CLEAR  pair   button_cap_HOLD  x  thumb_roller
CLEAR  pair   button_cap_HOLD  x  y_gib
CLEAR  pair   button_cap_HOLD  x  y_set_screw_u14
CLEAR  pair   button_cap_HOLD  x  y_set_screw_u24
CLEAR  pair   button_cap_MODE  x  back_gib
CLEAR  pair   button_cap_MODE  x  battery
CLEAR  pair   button_cap_MODE  x  display
CLEAR  pair   button_cap_MODE  x  front_pad_0
CLEAR  pair   button_cap_MODE  x  front_pad_1
CLEAR  pair   button_cap_MODE  x  front_pad_2
CLEAR  pair   button_cap_MODE  x  front_pad_3
CLEAR  pair   button_cap_MODE  x  lock_screw
CLEAR  pair   button_cap_MODE  x  oring
CLEAR  pair   button_cap_MODE  x  plunger_hw_0
CLEAR  pair   button_cap_MODE  x  plunger_hw_1
CLEAR  pair   button_cap_MODE  x  plunger_hw_2
CLEAR  pair   button_cap_MODE  x  plunger_hw_3
CLEAR  pair   button_cap_MODE  x  pusher_lock_u19
CLEAR  pair   button_cap_MODE  x  pusher_tip_u14
CLEAR  pair   button_cap_MODE  x  pusher_tip_u24
CLEAR  pair   button_cap_MODE  x  pusher_u14
CLEAR  pair   button_cap_MODE  x  pusher_u24
CLEAR  pair   button_cap_MODE  x  ref_strip
CLEAR  pair   button_cap_MODE  x  tab_clamp_0
CLEAR  pair   button_cap_MODE  x  tab_clamp_1
CLEAR  pair   button_cap_MODE  x  tab_clamp_2
CLEAR  pair   button_cap_MODE  x  tab_clamp_3
CLEAR  pair   button_cap_MODE  x  tab_clamp_4
CLEAR  pair   button_cap_MODE  x  tab_clamp_5
CLEAR  pair   button_cap_MODE  x  tab_clamp_6
CLEAR  pair   button_cap_MODE  x  tab_clamp_7
CLEAR  pair   button_cap_MODE  x  thumb_roller
CLEAR  pair   button_cap_MODE  x  y_gib
CLEAR  pair   button_cap_MODE  x  y_set_screw_u14
CLEAR  pair   button_cap_MODE  x  y_set_screw_u24
CLEAR  pair   button_cap_ZERO  x  back_gib
CLEAR  pair   button_cap_ZERO  x  battery
CLEAR  pair   button_cap_ZERO  x  button_cap_HOLD
CLEAR  pair   button_cap_ZERO  x  button_cap_MODE
CLEAR  pair   button_cap_ZERO  x  display
CLEAR  pair   button_cap_ZERO  x  front_pad_0
CLEAR  pair   button_cap_ZERO  x  front_pad_1
CLEAR  pair   button_cap_ZERO  x  front_pad_2
CLEAR  pair   button_cap_ZERO  x  front_pad_3
CLEAR  pair   button_cap_ZERO  x  lock_screw
CLEAR  pair   button_cap_ZERO  x  oring
CLEAR  pair   button_cap_ZERO  x  plunger_hw_0
CLEAR  pair   button_cap_ZERO  x  plunger_hw_1
CLEAR  pair   button_cap_ZERO  x  plunger_hw_2
CLEAR  pair   button_cap_ZERO  x  plunger_hw_3
CLEAR  pair   button_cap_ZERO  x  pusher_lock_u19
CLEAR  pair   button_cap_ZERO  x  pusher_tip_u14
CLEAR  pair   button_cap_ZERO  x  pusher_tip_u24
CLEAR  pair   button_cap_ZERO  x  pusher_u14
CLEAR  pair   button_cap_ZERO  x  pusher_u24
CLEAR  pair   button_cap_ZERO  x  ref_strip
CLEAR  pair   button_cap_ZERO  x  tab_clamp_0
CLEAR  pair   button_cap_ZERO  x  tab_clamp_1
CLEAR  pair   button_cap_ZERO  x  tab_clamp_2
CLEAR  pair   button_cap_ZERO  x  tab_clamp_3
CLEAR  pair   button_cap_ZERO  x  tab_clamp_4
CLEAR  pair   button_cap_ZERO  x  tab_clamp_5
CLEAR  pair   button_cap_ZERO  x  tab_clamp_6
CLEAR  pair   button_cap_ZERO  x  tab_clamp_7
CLEAR  pair   button_cap_ZERO  x  thumb_roller
CLEAR  pair   button_cap_ZERO  x  y_gib
CLEAR  pair   button_cap_ZERO  x  y_set_screw_u14
CLEAR  pair   button_cap_ZERO  x  y_set_screw_u24
CLEAR  pair   display  x  battery
CLEAR  pair   display  x  plunger_hw_0
CLEAR  pair   display  x  plunger_hw_1
CLEAR  pair   display  x  plunger_hw_2
CLEAR  pair   display  x  plunger_hw_3
CLEAR  pair   display  x  tab_clamp_0
CLEAR  pair   display  x  tab_clamp_1
CLEAR  pair   display  x  tab_clamp_2
CLEAR  pair   display  x  tab_clamp_3
CLEAR  pair   display  x  tab_clamp_4
CLEAR  pair   display  x  tab_clamp_5
CLEAR  pair   display  x  tab_clamp_6
CLEAR  pair   display  x  tab_clamp_7
CLEAR  pair   front_pad_0  x  battery
CLEAR  pair   front_pad_0  x  display
CLEAR  pair   front_pad_0  x  front_pad_1
CLEAR  pair   front_pad_0  x  front_pad_2
CLEAR  pair   front_pad_0  x  front_pad_3
CLEAR  pair   front_pad_0  x  lock_screw
CLEAR  pair   front_pad_0  x  plunger_hw_0
CLEAR  pair   front_pad_0  x  plunger_hw_1
CLEAR  pair   front_pad_0  x  plunger_hw_2
CLEAR  pair   front_pad_0  x  plunger_hw_3
CLEAR  pair   front_pad_0  x  pusher_lock_u19
CLEAR  pair   front_pad_0  x  pusher_tip_u14
CLEAR  pair   front_pad_0  x  pusher_tip_u24
CLEAR  pair   front_pad_0  x  pusher_u14
CLEAR  pair   front_pad_0  x  pusher_u24
CLEAR  pair   front_pad_0  x  tab_clamp_0
CLEAR  pair   front_pad_0  x  tab_clamp_1
CLEAR  pair   front_pad_0  x  tab_clamp_2
CLEAR  pair   front_pad_0  x  tab_clamp_3
CLEAR  pair   front_pad_0  x  tab_clamp_4
CLEAR  pair   front_pad_0  x  tab_clamp_5
CLEAR  pair   front_pad_0  x  tab_clamp_6
CLEAR  pair   front_pad_0  x  tab_clamp_7
CLEAR  pair   front_pad_0  x  y_set_screw_u14
CLEAR  pair   front_pad_0  x  y_set_screw_u24
CLEAR  pair   front_pad_1  x  battery
CLEAR  pair   front_pad_1  x  display
CLEAR  pair   front_pad_1  x  front_pad_2
CLEAR  pair   front_pad_1  x  front_pad_3
CLEAR  pair   front_pad_1  x  lock_screw
CLEAR  pair   front_pad_1  x  plunger_hw_0
CLEAR  pair   front_pad_1  x  plunger_hw_1
CLEAR  pair   front_pad_1  x  plunger_hw_2
CLEAR  pair   front_pad_1  x  plunger_hw_3
CLEAR  pair   front_pad_1  x  pusher_lock_u19
CLEAR  pair   front_pad_1  x  pusher_tip_u14
CLEAR  pair   front_pad_1  x  pusher_tip_u24
CLEAR  pair   front_pad_1  x  pusher_u14
CLEAR  pair   front_pad_1  x  pusher_u24
CLEAR  pair   front_pad_1  x  tab_clamp_0
CLEAR  pair   front_pad_1  x  tab_clamp_1
CLEAR  pair   front_pad_1  x  tab_clamp_2
CLEAR  pair   front_pad_1  x  tab_clamp_3
CLEAR  pair   front_pad_1  x  tab_clamp_4
CLEAR  pair   front_pad_1  x  tab_clamp_5
CLEAR  pair   front_pad_1  x  tab_clamp_6
CLEAR  pair   front_pad_1  x  tab_clamp_7
CLEAR  pair   front_pad_1  x  y_set_screw_u14
CLEAR  pair   front_pad_1  x  y_set_screw_u24
CLEAR  pair   front_pad_2  x  battery
CLEAR  pair   front_pad_2  x  display
CLEAR  pair   front_pad_2  x  front_pad_3
CLEAR  pair   front_pad_2  x  lock_screw
CLEAR  pair   front_pad_2  x  plunger_hw_0
CLEAR  pair   front_pad_2  x  plunger_hw_1
CLEAR  pair   front_pad_2  x  plunger_hw_2
CLEAR  pair   front_pad_2  x  plunger_hw_3
CLEAR  pair   front_pad_2  x  pusher_lock_u19
CLEAR  pair   front_pad_2  x  pusher_tip_u14
CLEAR  pair   front_pad_2  x  pusher_tip_u24
CLEAR  pair   front_pad_2  x  pusher_u14
CLEAR  pair   front_pad_2  x  pusher_u24
CLEAR  pair   front_pad_2  x  tab_clamp_0
CLEAR  pair   front_pad_2  x  tab_clamp_1
CLEAR  pair   front_pad_2  x  tab_clamp_2
CLEAR  pair   front_pad_2  x  tab_clamp_3
CLEAR  pair   front_pad_2  x  tab_clamp_4
CLEAR  pair   front_pad_2  x  tab_clamp_5
CLEAR  pair   front_pad_2  x  tab_clamp_6
CLEAR  pair   front_pad_2  x  tab_clamp_7
CLEAR  pair   front_pad_2  x  y_set_screw_u14
CLEAR  pair   front_pad_2  x  y_set_screw_u24
CLEAR  pair   front_pad_3  x  battery
CLEAR  pair   front_pad_3  x  display
CLEAR  pair   front_pad_3  x  lock_screw
CLEAR  pair   front_pad_3  x  plunger_hw_0
CLEAR  pair   front_pad_3  x  plunger_hw_1
CLEAR  pair   front_pad_3  x  plunger_hw_2
CLEAR  pair   front_pad_3  x  plunger_hw_3
CLEAR  pair   front_pad_3  x  pusher_lock_u19
CLEAR  pair   front_pad_3  x  pusher_tip_u14
CLEAR  pair   front_pad_3  x  pusher_tip_u24
CLEAR  pair   front_pad_3  x  pusher_u14
CLEAR  pair   front_pad_3  x  pusher_u24
CLEAR  pair   front_pad_3  x  tab_clamp_0
CLEAR  pair   front_pad_3  x  tab_clamp_1
CLEAR  pair   front_pad_3  x  tab_clamp_2
CLEAR  pair   front_pad_3  x  tab_clamp_3
CLEAR  pair   front_pad_3  x  tab_clamp_4
CLEAR  pair   front_pad_3  x  tab_clamp_5
CLEAR  pair   front_pad_3  x  tab_clamp_6
CLEAR  pair   front_pad_3  x  tab_clamp_7
CLEAR  pair   front_pad_3  x  y_set_screw_u14
CLEAR  pair   front_pad_3  x  y_set_screw_u24
CLEAR  pair   front_shell  x  back_gib
CLEAR  pair   front_shell  x  battery
CLEAR  pair   front_shell  x  battery_door
CLEAR  pair   front_shell  x  button_cap_HOLD
CLEAR  pair   front_shell  x  button_cap_MODE
CLEAR  pair   front_shell  x  button_cap_ZERO
CLEAR  pair   front_shell  x  display
CLEAR  pair   front_shell  x  front_pad_0
CLEAR  pair   front_shell  x  front_pad_1
CLEAR  pair   front_shell  x  front_pad_2
CLEAR  pair   front_shell  x  front_pad_3
CLEAR  pair   front_shell  x  lock_screw
CLEAR  pair   front_shell  x  oring
CLEAR  pair   front_shell  x  plunger_hw_0
CLEAR  pair   front_shell  x  plunger_hw_1
CLEAR  pair   front_shell  x  plunger_hw_2
CLEAR  pair   front_shell  x  plunger_hw_3
CLEAR  pair   front_shell  x  pusher_lock_u19
CLEAR  pair   front_shell  x  pusher_tip_u14
CLEAR  pair   front_shell  x  pusher_tip_u24
CLEAR  pair   front_shell  x  pusher_u14
CLEAR  pair   front_shell  x  pusher_u24
CLEAR  pair   front_shell  x  ref_strip
CLEAR  pair   front_shell  x  tab_clamp_0
CLEAR  pair   front_shell  x  tab_clamp_1
CLEAR  pair   front_shell  x  tab_clamp_2
CLEAR  pair   front_shell  x  tab_clamp_3
CLEAR  pair   front_shell  x  tab_clamp_4
CLEAR  pair   front_shell  x  tab_clamp_5
CLEAR  pair   front_shell  x  tab_clamp_6
CLEAR  pair   front_shell  x  tab_clamp_7
CLEAR  pair   front_shell  x  thumb_roller
CLEAR  pair   front_shell  x  y_gib
CLEAR  pair   front_shell  x  y_set_screw_u14
CLEAR  pair   front_shell  x  y_set_screw_u24
CLEAR  pair   lock_screw  x  battery
CLEAR  pair   lock_screw  x  display
CLEAR  pair   lock_screw  x  plunger_hw_0
CLEAR  pair   lock_screw  x  plunger_hw_1
CLEAR  pair   lock_screw  x  plunger_hw_2
CLEAR  pair   lock_screw  x  plunger_hw_3
CLEAR  pair   lock_screw  x  tab_clamp_0
CLEAR  pair   lock_screw  x  tab_clamp_1
CLEAR  pair   lock_screw  x  tab_clamp_2
CLEAR  pair   lock_screw  x  tab_clamp_3
CLEAR  pair   lock_screw  x  tab_clamp_4
CLEAR  pair   lock_screw  x  tab_clamp_5
CLEAR  pair   lock_screw  x  tab_clamp_6
CLEAR  pair   lock_screw  x  tab_clamp_7
CLEAR  pair   lock_screw  x  y_set_screw_u14
CLEAR  pair   lock_screw  x  y_set_screw_u24
CLEAR  pair   oring  x  back_gib
CLEAR  pair   oring  x  battery
CLEAR  pair   oring  x  display
CLEAR  pair   oring  x  front_pad_0
CLEAR  pair   oring  x  front_pad_1
CLEAR  pair   oring  x  front_pad_2
CLEAR  pair   oring  x  front_pad_3
CLEAR  pair   oring  x  lock_screw
CLEAR  pair   oring  x  plunger_hw_0
CLEAR  pair   oring  x  plunger_hw_1
CLEAR  pair   oring  x  plunger_hw_2
CLEAR  pair   oring  x  plunger_hw_3
CLEAR  pair   oring  x  pusher_lock_u19
CLEAR  pair   oring  x  pusher_tip_u14
CLEAR  pair   oring  x  pusher_tip_u24
CLEAR  pair   oring  x  pusher_u14
CLEAR  pair   oring  x  pusher_u24
CLEAR  pair   oring  x  ref_strip
CLEAR  pair   oring  x  tab_clamp_0
CLEAR  pair   oring  x  tab_clamp_1
CLEAR  pair   oring  x  tab_clamp_2
CLEAR  pair   oring  x  tab_clamp_3
CLEAR  pair   oring  x  tab_clamp_4
CLEAR  pair   oring  x  tab_clamp_5
CLEAR  pair   oring  x  tab_clamp_6
CLEAR  pair   oring  x  tab_clamp_7
CLEAR  pair   oring  x  y_gib
CLEAR  pair   oring  x  y_set_screw_u14
CLEAR  pair   oring  x  y_set_screw_u24
CLEAR  pair   plunger_hw_0  x  plunger_hw_1
CLEAR  pair   plunger_hw_0  x  plunger_hw_2
CLEAR  pair   plunger_hw_0  x  plunger_hw_3
CLEAR  pair   plunger_hw_1  x  plunger_hw_2
CLEAR  pair   plunger_hw_1  x  plunger_hw_3
CLEAR  pair   plunger_hw_2  x  plunger_hw_3
CLEAR  pair   pusher_lock_u19  x  battery
CLEAR  pair   pusher_lock_u19  x  display
CLEAR  pair   pusher_lock_u19  x  lock_screw
CLEAR  pair   pusher_lock_u19  x  plunger_hw_0
CLEAR  pair   pusher_lock_u19  x  plunger_hw_1
CLEAR  pair   pusher_lock_u19  x  plunger_hw_2
CLEAR  pair   pusher_lock_u19  x  plunger_hw_3
CLEAR  pair   pusher_lock_u19  x  tab_clamp_0
CLEAR  pair   pusher_lock_u19  x  tab_clamp_1
CLEAR  pair   pusher_lock_u19  x  tab_clamp_2
CLEAR  pair   pusher_lock_u19  x  tab_clamp_3
CLEAR  pair   pusher_lock_u19  x  tab_clamp_4
CLEAR  pair   pusher_lock_u19  x  tab_clamp_5
CLEAR  pair   pusher_lock_u19  x  tab_clamp_6
CLEAR  pair   pusher_lock_u19  x  tab_clamp_7
CLEAR  pair   pusher_lock_u19  x  y_set_screw_u14
CLEAR  pair   pusher_lock_u19  x  y_set_screw_u24
CLEAR  pair   pusher_tip_u14  x  battery
CLEAR  pair   pusher_tip_u14  x  display
CLEAR  pair   pusher_tip_u14  x  lock_screw
CLEAR  pair   pusher_tip_u14  x  plunger_hw_0
CLEAR  pair   pusher_tip_u14  x  plunger_hw_1
CLEAR  pair   pusher_tip_u14  x  plunger_hw_2
CLEAR  pair   pusher_tip_u14  x  plunger_hw_3
CLEAR  pair   pusher_tip_u14  x  pusher_lock_u19
CLEAR  pair   pusher_tip_u14  x  pusher_tip_u24
CLEAR  pair   pusher_tip_u14  x  pusher_u14
CLEAR  pair   pusher_tip_u14  x  pusher_u24
CLEAR  pair   pusher_tip_u14  x  tab_clamp_0
CLEAR  pair   pusher_tip_u14  x  tab_clamp_1
CLEAR  pair   pusher_tip_u14  x  tab_clamp_2
CLEAR  pair   pusher_tip_u14  x  tab_clamp_3
CLEAR  pair   pusher_tip_u14  x  tab_clamp_4
CLEAR  pair   pusher_tip_u14  x  tab_clamp_5
CLEAR  pair   pusher_tip_u14  x  tab_clamp_6
CLEAR  pair   pusher_tip_u14  x  tab_clamp_7
CLEAR  pair   pusher_tip_u14  x  y_set_screw_u14
CLEAR  pair   pusher_tip_u14  x  y_set_screw_u24
CLEAR  pair   pusher_tip_u24  x  battery
CLEAR  pair   pusher_tip_u24  x  display
CLEAR  pair   pusher_tip_u24  x  lock_screw
CLEAR  pair   pusher_tip_u24  x  plunger_hw_0
CLEAR  pair   pusher_tip_u24  x  plunger_hw_1
CLEAR  pair   pusher_tip_u24  x  plunger_hw_2
CLEAR  pair   pusher_tip_u24  x  plunger_hw_3
CLEAR  pair   pusher_tip_u24  x  pusher_lock_u19
CLEAR  pair   pusher_tip_u24  x  pusher_u24
CLEAR  pair   pusher_tip_u24  x  tab_clamp_0
CLEAR  pair   pusher_tip_u24  x  tab_clamp_1
CLEAR  pair   pusher_tip_u24  x  tab_clamp_2
CLEAR  pair   pusher_tip_u24  x  tab_clamp_3
CLEAR  pair   pusher_tip_u24  x  tab_clamp_4
CLEAR  pair   pusher_tip_u24  x  tab_clamp_5
CLEAR  pair   pusher_tip_u24  x  tab_clamp_6
CLEAR  pair   pusher_tip_u24  x  tab_clamp_7
CLEAR  pair   pusher_tip_u24  x  y_set_screw_u14
CLEAR  pair   pusher_tip_u24  x  y_set_screw_u24
CLEAR  pair   pusher_u14  x  battery
CLEAR  pair   pusher_u14  x  display
CLEAR  pair   pusher_u14  x  lock_screw
CLEAR  pair   pusher_u14  x  plunger_hw_0
CLEAR  pair   pusher_u14  x  plunger_hw_1
CLEAR  pair   pusher_u14  x  plunger_hw_2
CLEAR  pair   pusher_u14  x  plunger_hw_3
CLEAR  pair   pusher_u14  x  pusher_lock_u19
CLEAR  pair   pusher_u14  x  pusher_tip_u24
CLEAR  pair   pusher_u14  x  pusher_u24
CLEAR  pair   pusher_u14  x  tab_clamp_0
CLEAR  pair   pusher_u14  x  tab_clamp_1
CLEAR  pair   pusher_u14  x  tab_clamp_2
CLEAR  pair   pusher_u14  x  tab_clamp_3
CLEAR  pair   pusher_u14  x  tab_clamp_4
CLEAR  pair   pusher_u14  x  tab_clamp_5
CLEAR  pair   pusher_u14  x  tab_clamp_6
CLEAR  pair   pusher_u14  x  tab_clamp_7
CLEAR  pair   pusher_u14  x  y_set_screw_u14
CLEAR  pair   pusher_u14  x  y_set_screw_u24
CLEAR  pair   pusher_u24  x  battery
CLEAR  pair   pusher_u24  x  display
CLEAR  pair   pusher_u24  x  lock_screw
CLEAR  pair   pusher_u24  x  plunger_hw_0
CLEAR  pair   pusher_u24  x  plunger_hw_1
CLEAR  pair   pusher_u24  x  plunger_hw_2
CLEAR  pair   pusher_u24  x  plunger_hw_3
CLEAR  pair   pusher_u24  x  pusher_lock_u19
CLEAR  pair   pusher_u24  x  tab_clamp_0
CLEAR  pair   pusher_u24  x  tab_clamp_1
CLEAR  pair   pusher_u24  x  tab_clamp_2
CLEAR  pair   pusher_u24  x  tab_clamp_3
CLEAR  pair   pusher_u24  x  tab_clamp_4
CLEAR  pair   pusher_u24  x  tab_clamp_5
CLEAR  pair   pusher_u24  x  tab_clamp_6
CLEAR  pair   pusher_u24  x  tab_clamp_7
CLEAR  pair   pusher_u24  x  y_set_screw_u14
CLEAR  pair   pusher_u24  x  y_set_screw_u24
CLEAR  pair   ref_strip  x  battery
CLEAR  pair   ref_strip  x  display
CLEAR  pair   ref_strip  x  front_pad_0
CLEAR  pair   ref_strip  x  front_pad_1
CLEAR  pair   ref_strip  x  front_pad_2
CLEAR  pair   ref_strip  x  front_pad_3
CLEAR  pair   ref_strip  x  lock_screw
CLEAR  pair   ref_strip  x  plunger_hw_0
CLEAR  pair   ref_strip  x  plunger_hw_1
CLEAR  pair   ref_strip  x  plunger_hw_2
CLEAR  pair   ref_strip  x  plunger_hw_3
CLEAR  pair   ref_strip  x  pusher_lock_u19
CLEAR  pair   ref_strip  x  pusher_tip_u14
CLEAR  pair   ref_strip  x  pusher_tip_u24
CLEAR  pair   ref_strip  x  pusher_u14
CLEAR  pair   ref_strip  x  pusher_u24
CLEAR  pair   ref_strip  x  tab_clamp_0
CLEAR  pair   ref_strip  x  tab_clamp_1
CLEAR  pair   ref_strip  x  tab_clamp_2
CLEAR  pair   ref_strip  x  tab_clamp_3
CLEAR  pair   ref_strip  x  tab_clamp_4
CLEAR  pair   ref_strip  x  tab_clamp_5
CLEAR  pair   ref_strip  x  tab_clamp_6
CLEAR  pair   ref_strip  x  tab_clamp_7
CLEAR  pair   ref_strip  x  y_set_screw_u14
CLEAR  pair   ref_strip  x  y_set_screw_u24
CLEAR  pair   slider_body  x  back_gib
CLEAR  pair   slider_body  x  battery
CLEAR  pair   slider_body  x  battery_door
CLEAR  pair   slider_body  x  button_cap_HOLD
CLEAR  pair   slider_body  x  button_cap_MODE
CLEAR  pair   slider_body  x  button_cap_ZERO
CLEAR  pair   slider_body  x  display
CLEAR  pair   slider_body  x  front_pad_0
CLEAR  pair   slider_body  x  front_pad_1
CLEAR  pair   slider_body  x  front_pad_2
CLEAR  pair   slider_body  x  front_pad_3
CLEAR  pair   slider_body  x  front_shell
CLEAR  pair   slider_body  x  lock_screw
CLEAR  pair   slider_body  x  oring
CLEAR  pair   slider_body  x  plunger_hw_0
CLEAR  pair   slider_body  x  plunger_hw_1
CLEAR  pair   slider_body  x  plunger_hw_2
CLEAR  pair   slider_body  x  plunger_hw_3
CLEAR  pair   slider_body  x  pusher_lock_u19
CLEAR  pair   slider_body  x  pusher_tip_u14
CLEAR  pair   slider_body  x  pusher_tip_u24
CLEAR  pair   slider_body  x  pusher_u14
CLEAR  pair   slider_body  x  pusher_u24
CLEAR  pair   slider_body  x  ref_strip
CLEAR  pair   slider_body  x  tab_clamp_0
CLEAR  pair   slider_body  x  tab_clamp_1
CLEAR  pair   slider_body  x  tab_clamp_2
CLEAR  pair   slider_body  x  tab_clamp_3
CLEAR  pair   slider_body  x  tab_clamp_4
CLEAR  pair   slider_body  x  tab_clamp_5
CLEAR  pair   slider_body  x  tab_clamp_6
CLEAR  pair   slider_body  x  tab_clamp_7
CLEAR  pair   slider_body  x  thumb_roller
CLEAR  pair   slider_body  x  y_gib
CLEAR  pair   slider_body  x  y_set_screw_u14
CLEAR  pair   slider_body  x  y_set_screw_u24
CLEAR  pair   tab_clamp_0  x  plunger_hw_0
CLEAR  pair   tab_clamp_0  x  plunger_hw_1
CLEAR  pair   tab_clamp_0  x  plunger_hw_2
CLEAR  pair   tab_clamp_0  x  plunger_hw_3
CLEAR  pair   tab_clamp_0  x  tab_clamp_1
CLEAR  pair   tab_clamp_0  x  tab_clamp_2
CLEAR  pair   tab_clamp_0  x  tab_clamp_3
CLEAR  pair   tab_clamp_0  x  tab_clamp_4
CLEAR  pair   tab_clamp_0  x  tab_clamp_5
CLEAR  pair   tab_clamp_0  x  tab_clamp_6
CLEAR  pair   tab_clamp_0  x  tab_clamp_7
CLEAR  pair   tab_clamp_1  x  plunger_hw_0
CLEAR  pair   tab_clamp_1  x  plunger_hw_1
CLEAR  pair   tab_clamp_1  x  plunger_hw_2
CLEAR  pair   tab_clamp_1  x  plunger_hw_3
CLEAR  pair   tab_clamp_1  x  tab_clamp_2
CLEAR  pair   tab_clamp_1  x  tab_clamp_3
CLEAR  pair   tab_clamp_1  x  tab_clamp_4
CLEAR  pair   tab_clamp_1  x  tab_clamp_5
CLEAR  pair   tab_clamp_1  x  tab_clamp_6
CLEAR  pair   tab_clamp_1  x  tab_clamp_7
CLEAR  pair   tab_clamp_2  x  plunger_hw_0
CLEAR  pair   tab_clamp_2  x  plunger_hw_1
CLEAR  pair   tab_clamp_2  x  plunger_hw_2
CLEAR  pair   tab_clamp_2  x  plunger_hw_3
CLEAR  pair   tab_clamp_2  x  tab_clamp_3
CLEAR  pair   tab_clamp_2  x  tab_clamp_4
CLEAR  pair   tab_clamp_2  x  tab_clamp_5
CLEAR  pair   tab_clamp_2  x  tab_clamp_6
CLEAR  pair   tab_clamp_2  x  tab_clamp_7
CLEAR  pair   tab_clamp_3  x  plunger_hw_0
CLEAR  pair   tab_clamp_3  x  plunger_hw_1
CLEAR  pair   tab_clamp_3  x  plunger_hw_2
CLEAR  pair   tab_clamp_3  x  plunger_hw_3
CLEAR  pair   tab_clamp_3  x  tab_clamp_4
CLEAR  pair   tab_clamp_3  x  tab_clamp_5
CLEAR  pair   tab_clamp_3  x  tab_clamp_6
CLEAR  pair   tab_clamp_3  x  tab_clamp_7
CLEAR  pair   tab_clamp_4  x  plunger_hw_0
CLEAR  pair   tab_clamp_4  x  plunger_hw_1
CLEAR  pair   tab_clamp_4  x  plunger_hw_2
CLEAR  pair   tab_clamp_4  x  plunger_hw_3
CLEAR  pair   tab_clamp_4  x  tab_clamp_5
CLEAR  pair   tab_clamp_4  x  tab_clamp_6
CLEAR  pair   tab_clamp_4  x  tab_clamp_7
CLEAR  pair   tab_clamp_5  x  plunger_hw_0
CLEAR  pair   tab_clamp_5  x  plunger_hw_1
CLEAR  pair   tab_clamp_5  x  plunger_hw_2
CLEAR  pair   tab_clamp_5  x  plunger_hw_3
CLEAR  pair   tab_clamp_5  x  tab_clamp_6
CLEAR  pair   tab_clamp_5  x  tab_clamp_7
CLEAR  pair   tab_clamp_6  x  plunger_hw_0
CLEAR  pair   tab_clamp_6  x  plunger_hw_1
CLEAR  pair   tab_clamp_6  x  plunger_hw_2
CLEAR  pair   tab_clamp_6  x  plunger_hw_3
CLEAR  pair   tab_clamp_6  x  tab_clamp_7
CLEAR  pair   tab_clamp_7  x  plunger_hw_0
CLEAR  pair   tab_clamp_7  x  plunger_hw_1
CLEAR  pair   tab_clamp_7  x  plunger_hw_2
CLEAR  pair   tab_clamp_7  x  plunger_hw_3
CLEAR  pair   thumb_roller  x  back_gib
CLEAR  pair   thumb_roller  x  battery
CLEAR  pair   thumb_roller  x  display
CLEAR  pair   thumb_roller  x  front_pad_0
CLEAR  pair   thumb_roller  x  front_pad_1
CLEAR  pair   thumb_roller  x  front_pad_2
CLEAR  pair   thumb_roller  x  front_pad_3
CLEAR  pair   thumb_roller  x  lock_screw
CLEAR  pair   thumb_roller  x  oring
CLEAR  pair   thumb_roller  x  plunger_hw_0
CLEAR  pair   thumb_roller  x  plunger_hw_1
CLEAR  pair   thumb_roller  x  plunger_hw_2
CLEAR  pair   thumb_roller  x  plunger_hw_3
CLEAR  pair   thumb_roller  x  pusher_lock_u19
CLEAR  pair   thumb_roller  x  pusher_tip_u14
CLEAR  pair   thumb_roller  x  pusher_tip_u24
CLEAR  pair   thumb_roller  x  pusher_u14
CLEAR  pair   thumb_roller  x  pusher_u24
CLEAR  pair   thumb_roller  x  ref_strip
CLEAR  pair   thumb_roller  x  tab_clamp_0
CLEAR  pair   thumb_roller  x  tab_clamp_1
CLEAR  pair   thumb_roller  x  tab_clamp_2
CLEAR  pair   thumb_roller  x  tab_clamp_3
CLEAR  pair   thumb_roller  x  tab_clamp_4
CLEAR  pair   thumb_roller  x  tab_clamp_5
CLEAR  pair   thumb_roller  x  tab_clamp_6
CLEAR  pair   thumb_roller  x  tab_clamp_7
CLEAR  pair   thumb_roller  x  y_gib
CLEAR  pair   thumb_roller  x  y_set_screw_u14
CLEAR  pair   thumb_roller  x  y_set_screw_u24
CLEAR  pair   y_gib  x  battery
CLEAR  pair   y_gib  x  display
CLEAR  pair   y_gib  x  front_pad_0
CLEAR  pair   y_gib  x  front_pad_1
CLEAR  pair   y_gib  x  front_pad_2
CLEAR  pair   y_gib  x  front_pad_3
CLEAR  pair   y_gib  x  lock_screw
CLEAR  pair   y_gib  x  plunger_hw_0
CLEAR  pair   y_gib  x  plunger_hw_1
CLEAR  pair   y_gib  x  plunger_hw_2
CLEAR  pair   y_gib  x  plunger_hw_3
CLEAR  pair   y_gib  x  pusher_lock_u19
CLEAR  pair   y_gib  x  pusher_tip_u14
CLEAR  pair   y_gib  x  pusher_tip_u24
CLEAR  pair   y_gib  x  pusher_u14
CLEAR  pair   y_gib  x  pusher_u24
CLEAR  pair   y_gib  x  ref_strip
CLEAR  pair   y_gib  x  tab_clamp_0
CLEAR  pair   y_gib  x  tab_clamp_1
CLEAR  pair   y_gib  x  tab_clamp_2
CLEAR  pair   y_gib  x  tab_clamp_3
CLEAR  pair   y_gib  x  tab_clamp_4
CLEAR  pair   y_gib  x  tab_clamp_5
CLEAR  pair   y_gib  x  tab_clamp_6
CLEAR  pair   y_gib  x  tab_clamp_7
CLEAR  pair   y_gib  x  y_set_screw_u14
CLEAR  pair   y_gib  x  y_set_screw_u24
CLEAR  pair   y_set_screw_u14  x  battery
CLEAR  pair   y_set_screw_u14  x  display
CLEAR  pair   y_set_screw_u14  x  plunger_hw_0
CLEAR  pair   y_set_screw_u14  x  plunger_hw_1
CLEAR  pair   y_set_screw_u14  x  plunger_hw_2
CLEAR  pair   y_set_screw_u14  x  plunger_hw_3
CLEAR  pair   y_set_screw_u14  x  tab_clamp_0
CLEAR  pair   y_set_screw_u14  x  tab_clamp_1
CLEAR  pair   y_set_screw_u14  x  tab_clamp_2
CLEAR  pair   y_set_screw_u14  x  tab_clamp_3
CLEAR  pair   y_set_screw_u14  x  tab_clamp_4
CLEAR  pair   y_set_screw_u14  x  tab_clamp_5
CLEAR  pair   y_set_screw_u14  x  tab_clamp_6
CLEAR  pair   y_set_screw_u14  x  tab_clamp_7
CLEAR  pair   y_set_screw_u14  x  y_set_screw_u24
CLEAR  pair   y_set_screw_u24  x  battery
CLEAR  pair   y_set_screw_u24  x  display
CLEAR  pair   y_set_screw_u24  x  plunger_hw_0
CLEAR  pair   y_set_screw_u24  x  plunger_hw_1
CLEAR  pair   y_set_screw_u24  x  plunger_hw_2
CLEAR  pair   y_set_screw_u24  x  plunger_hw_3
CLEAR  pair   y_set_screw_u24  x  tab_clamp_0
CLEAR  pair   y_set_screw_u24  x  tab_clamp_1
CLEAR  pair   y_set_screw_u24  x  tab_clamp_2
CLEAR  pair   y_set_screw_u24  x  tab_clamp_3
CLEAR  pair   y_set_screw_u24  x  tab_clamp_4
CLEAR  pair   y_set_screw_u24  x  tab_clamp_5
CLEAR  pair   y_set_screw_u24  x  tab_clamp_6
CLEAR  pair   y_set_screw_u24  x  tab_clamp_7
INTND  R0     oring  x  beam  overlap 0.084 mm^3
INTND  R151   oring  x  beam  overlap 0.084 mm^3
INTND  R75    oring  x  beam  overlap 0.084 mm^3
