tyevco/prettycoolboards/caliper/hardware/fab/scale/jlcplace-checklist.md

# JLC preview checklist: prettycool-caliper-scale.kicad\_pcb

CPL prettycool-caliper-scale-CPL-empty.csv, bottom reading `jlc-2022`, jlcplace 0.2.1.

Open the order's placement preview at JLC and look at each part below. Tick it when the part sits on its pads with pin 1 / polarity where the board wants it. An item for several parts names the one to look at.

**Origin:** the Gerbers' (0, 0) is this CPL's origin, board (100, 100) (the aux (drill/place file) origin): the rows were checked from it, as JLC reads them

Nothing to check: every row was simulated, no bottom part depends on the reading, every angle is a multiple of 90 and every correction is green or verified.
