tyevco/prettycoolboards/caliper/docs/firmware.md

# Firmware

> **Status: builds for the target, not run on hardware.** The ESP-IDF project in
> [`caliper/firmware`](../firmware/README.md) **builds with `idf.py build` on ESP-IDF v5.4.2** for the
> esp32s3 (4 MB / N4R2 layout, clean build, **0 warnings**). With the bring-up commands (§10.1) the image is
> **1 711 168 B and fits the 1 728 KB app slot with 58 304 B (3.3 %) to spare** (built 2026-11-10 with the IIS2MDC
> compass driver and its part of the orientation filter: 6 288 B more than with the LSM6DSO driver, the orientation
> filter and the display flip, which had added 15 728 B the same day); `CONFIG_CALIPER_BRINGUP=n` gave 23 520 B
> back before those changes and has not been rebuilt since (§13). No binary has been flashed: nothing has run on a
> chip, and that includes the LSM6DSO driver, which is written from the datasheet text, and the IIS2MDC compass
> driver, whose register values come from ST's driver sources because the datasheet's register map was not read
> (§12.2). The portable core (units, rounding, tolerance, statistics, the SETTLE / SWEEP capture modes, log
> records, GATT codecs, settings JSON, CSV, button gestures, the AS5311 frame logic, the SSI fine
> interpolation, the capacitive demodulator, the orientation filter of §12.2 with its compass part and the
> bring-up pass/fail rules) is compiled and tested on the host: **72 test groups, 2741 checks, 0 failures**, with
> `-Werror`,
> AddressSanitizer and UBSan (fatal: any undefined behaviour fails the run), and also compiled as strict ISO C11; the reading-log store (`store.c`) has its
> own host test against stubbed LittleFS/NVS (**4 groups, 2614 checks, 0 failures**). Everything that
> touches a peripheral is unverified. Numbers marked **TVP** are to be verified on the prototype. The
> adversarial review of the capacitive, UI, storage, Wi-Fi and USB modules and the SSI interpolation
> (§14.1) found and fixed 20 defects; none of the fixes has run on a chip either.

The architecture of record is [SPEC](../hardware/design/SPEC.md); the pins come from
[`nets.py`](../hardware/design/nets.py) through a generated header. Where this page and SPEC disagree,
SPEC wins. The companion page that talks to the BLE service is described in [App](app.md).

## 1. Platform and layout

| | |
|---|---|
| SDK | ESP-IDF **v5.4.2** (built with it), target `esp32s3` |
| Module | ESP32-S3-MINI-1-**N4R2**: 4 MB quad flash, 2 MB quad PSRAM (SPEC §1). An 8 MB (N8R2) overlay exists |
| RTOS | FreeRTOS (dual core), tickless idle, dynamic frequency scaling 40–160 MHz |
| BLE | NimBLE (in IDF), peripheral only, up to 2 connections |
| Display | `esp_lcd` ST7789 driver (in IDF) + `espressif/esp_lvgl_port` **2.7.2** + `lvgl/lvgl` **9.2.2**. The port is pinned to `~2.7.2`: 2.8.0 and later use `LV_COLOR_FORMAT_RGB565_SWAPPED`, which LVGL 9.2 does not have |
| USB | `espressif/esp_tinyusb` **1.7.6** (with `espressif/tinyusb` 0.21.0): CDC ACM + MSC |
| Storage | `joltwallet/littlefs` **1.23.1** for the log and profiles, NVS for settings, FAT + wear levelling for MSC |
| Lock file | `caliper/firmware/dependencies.lock` (committed) pins the managed components above; `led_strip` 2.5.5 |
| Network | `esp_wifi`, `esp_http_server`, `esp_http_client`, `esp-mqtt` (all in IDF 5.4) |

```
caliper/firmware/
  CMakeLists.txt  sdkconfig.defaults  sdkconfig.defaults.8mb  partitions_4mb.csv  partitions_8mb.csv
  tools/gen_pins.py          nets.py -> main/board_pins.h
  main/                      app_main.c (tasks, wiring), Kconfig.projbuild, idf_component.yml
    board_pins.h             GENERATED, committed
    proto/caliper_gatt.h     the BLE contract (UUIDs, opcodes, layouts, flags)
  components/
    board/                   exposes main/board_pins.h + proto/ to every component; checks pin drift
    measure/                 PORTABLE: measure.c logrec.c gatt_codec.c settings.c csv.c buttons.c hid_keymap.c
                             orient.c (orientation from the gyroscope + accelerometer, the compass as a
                             yaw reference, §12.2)
    sensor_mag/              AS5311: sensor_mag.c (PCNT, SSI, index) + as5311_proto.c (PORTABLE)
    sensor_cap/              EXPERIMENTAL: sensor_cap.c (bundle drive, ADC) + cap_demod.c (PORTABLE)
    caliper_core/            event bus, live state, commands, settings, profiles, stats
    store/                   LittleFS ring log, profiles file, NVS settings, CSV export
    ui/                      panel + LVGL port, screens, button routing
    ble/                     NimBLE: custom service, BAS/DIS/HID, worker (log stream, typing)
    caliper_wifi/            STA / provisioning AP, HTTP server, MQTT + HTTP POST push
    caliper_usb/             TinyUSB CDC + MSC, CLI
    power/                   BQ25180, MAX17048, LSM6DSO (imu.c), IIS2MDC (compass.c), temperature guard,
                             LEDC, LED, deep sleep
  test/host/                 CMake project: the PORTABLE files + tiny_test.h + test_main.c
```

The components are named `caliper_wifi` / `caliper_usb` rather than `wifi` / `usb` because IDF 5.x already
has a component called `usb` (the PHY and host library that `esp_tinyusb` uses); a project component of the
same name would shadow it.

## 2. Architecture

```mermaid
flowchart LR
  subgraph core1["core 1"]
    SEN["sensor task<br/>100 Hz"]
    CAP["cap task<br/>~20 Hz, EXPERIMENTAL"]
  end
  subgraph core0["core 0"]
    BTN["buttons task<br/>100 Hz"]
    APP["app task<br/>10 Hz / 1 Hz"]
    BUS(("bus<br/>esp_event loop"))
    BLEW["ble_wrk"]
    LV["LVGL task"]
    HTTP["httpd"]
    PUSH["push"]
    CLI["cli"]
  end
  AS5311["AS5311<br/>PCNT A/B + SSI"] --> SEN
  CAPHW["8 TX phases + ADC1"] --> CAP
  CAP -- "atomic cap_nm" --> SEN
  SEN -- "core_sample()" --> CORE["caliper_core<br/>live state, zero/hold,<br/>auto-hold, tolerance, stats"]
  BTN -- "ui_handle_button()" --> LV
  LV -- "core_command()" --> BUS
  BLEGATT["NimBLE host<br/>GATT access"] -- "core_command()" --> BUS
  HTTP -- "core_command()" --> BUS
  CLI -- "core_command()" --> BUS
  BUS --> CORE
  CORE -- "RECORDED / SEND / STATE /<br/>SLEEP / WIFI / BEEP / TOAST" --> BUS
  BUS --> BLEW & PUSH & LV & APP
  CORE --> STORE["store<br/>LittleFS ring + NVS"]
  APP --> PWR["power<br/>BQ25180, MAX17048,<br/>LSM6DSO, IIS2MDC, sleep"]
  APP -- "ble_tick()" --> BLEGATT
```

* **One owner of the state.** `caliper_core` holds the live reading, the zero, hold, unit, active
  profile, statistics, settings and profiles behind one mutex. Readers copy a snapshot
  (`core_get_live()`); writers post a command (`core_command()`), which runs in order on the **bus** task, a
  dedicated `esp_event` loop (queue 32, stack 6 KB, priority 6, core 0). Every front end (buttons, BLE,
  web, CLI) therefore behaves the same way.
* **Events out** of the core go over the same bus: `CAL_EVT_RECORDED` (a `logrec_t`) feeds the BLE log, the
  MQTT/HTTP push and the LED flash; `CAL_EVT_SEND` makes the BLE worker type the reading; `CAL_EVT_SLEEP`,
  `CAL_EVT_WIFI`, `CAL_EVT_BEEP`, `CAL_EVT_TOAST`, `CAL_EVT_STATE`, `CAL_EVT_SETTINGS`, `CAL_EVT_PROFILES`.
* **The capacitive path is isolated.** It has its own task and pins, hands one atomic value to the
  sensor task, and stops itself after 50 bad bursts in a row. A failure only clears `CAP_VALID`.

### 2.1 Tasks

| Task | Core | Prio | Rate | Job |
|---|---|---|---|---|
| `sensor` | 1 | 10 | 100 Hz (`vTaskDelayUntil`) | PCNT count and an SSI frame (≈ 40 µs) on every sample, fine position, `core_sample()` |
| `cap` | 1 | 4 | ~20 Hz (6.8 ms burst + 40 ms pause) | EXPERIMENTAL burst, demodulation, unwrap |
| `buttons` | 0 | 7 | 100 Hz | sample 3 GPIOs, `btn_update()`, `ui_handle_button()` |
| `app` | 0 | 3 | 10 Hz | `ble_tick()` (LIVE/battery notify); at 1 Hz: power poll, USB poll, dim, auto-off, low battery |
| `bus` | 0 | 6 | events | commands, events |
| `imu` | 0 | 5 | 50 Hz (`vTaskDelayUntil`) | one 14-byte I2C read of the LSM6DSO (temperature, gyroscope, accelerometer), the orientation filter (§12.2); on every 5th sample (10 Hz) the IIS2MDC compass: its status and, when a new sample is waiting, a 6-byte read |
| `ble_wrk` | 0 | 5 | jobs | LOG_READ streaming, HID typing |
| `push` | 0 | 3 | jobs | MQTT publish, HTTP POST |
| `cli` | 0 | 3 | lines | USB console commands |
| LVGL (`esp_lvgl_port`) | 0 | 4 | 33 ms refresh | rendering; pinned to core 0 (the port's default is no affinity) |
| TinyUSB | 0 | 5 | events | CDC/MSC; `CONFIG_TINYUSB_TASK_AFFINITY_CPU0` (esp_tinyusb defaults to CPU1) |
| NimBLE host, httpd, mqtt | 0 | | | started by their components |

Core 1 holds only the sensor and cap tasks. The cap burst masks interrupts on core 1 for 6.8 ms, which
delays the sensor task by up to one sample; the PCNT keeps counting in hardware meanwhile, so no counts are
lost. The ADC DMA interrupt is allocated from `app_main` on core 0 so the masked core never holds it, and it
is IRAM-safe (`CONFIG_ADC_CONTINUOUS_ISR_IRAM_SAFE`) so a flash write on core 0 cannot hold it off (§5).

## 3. The pin header

`tools/gen_pins.py` reads `caliper/hardware/design/nets.py` (`GPIO` and `I2C_ADDR`) and writes
[`main/board_pins.h`](../firmware/main/board_pins.h): one `PIN_<NET>` per GPIO, `I2C_ADDR_<DEV>`, the
`PIN_CAP_TX_LIST` initialiser in phase order, `BOARD_PINS_ALL` / `BOARD_PINS_COUNT` (every GPIO, for the
pin-plan test, §12.5), and a `BOARD_PINS_HASH` (SHA-256 of nets.py and the generator). It fails if a net the firmware needs disappears or if GPIO26 (the PSRAM chip select) is used.

* The header is **committed**, so the firmware builds without the hardware tree.
* The `board` component runs `gen_pins.py --check` at CMake configure time; a stale header **stops the
  build** with the command to regenerate it. CMake re-runs the check when nets.py changes.
* It already paid off once: during capture the schematic moved the accelerometer (then a LIS2DW12) to **0x19**
  (SA0 high) and added the +3V3_UI rail; the check flagged the stale header and the firmware followed (§12).
  The same path carried the change to the LSM6DSO at **0x6B** on 2026-11-10 (§12.2), and the same day the
  compass: `I2C_ADDR["IIS2MDC"]` in nets.py became `I2C_ADDR_IIS2MDC` **0x1E** in the header, whose
  `BOARD_PINS_HASH` is now `202d301f8ed3b0f1` (it was `ee472a43b6aab9d6`). No GPIO changed: the compass has no
  pin of its own (§12.2).

```sh
python3 caliper/firmware/tools/gen_pins.py           # regenerate
python3 caliper/firmware/tools/gen_pins.py --check   # what the build runs
```

## 4. Magnetic sensing (AS5311)

| Item | Implementation |
|---|---|
| Counting | PCNT unit, two channels (A edge/B level and B edge/A level), **4× decoding**. The AS5311's incremental outputs give **256 A/B pulses = 1024 edges per 2 mm pole pair** (datasheet rev 1.12 §7.1 and Table 8, "RESinc 10 bit, 1.95 µm"); only the SSI word has 4096 steps per pole pair. Limits ±30000 with watch points and `accum_count`, so the driver accumulates overflows into an `int` (150 mm = 76 800 counts) |
| Scale | 2 mm / 1024 = **1953.125 nm/count** = 15625/8 nm. The reading is the count **refined by the SSI angle** (SPEC D1, below) to the 12-bit step **488.28125 nm** = 15625/32 nm, converted in `int64` with symmetric round-half-away (`meas_lsb_to_nm`; `meas_counts_to_nm` for the count alone). Displayed resolution 0.01 mm is 20.48 SSI steps |
| Fine interpolation | `as5311_fine_combine()` (portable, host-tested). With the slip tracker locked, `ssi ≈ 4·dir·count + offset (mod 4096)`; the residual `r = wrap(ssi − expected(count))` in [−2048, 2047] is the SSI's correction to the count, and `fine = 4·count + dir·r` SSI LSB. This is the SSI position unwrapped around the count: the count supplies the pole, the wrap is taken on the difference, so it is continuous across pole boundaries (4095 → 0). It also removes the incremental outputs' 2-edge direction hysteresis. Used only with a valid frame taken while the count did not change during it; otherwise (moving, bad frame) the count alone (`COARSE`, not an error) |
| Consistency | `\|r\|` > **12 LSB** (3 edges: the 2-edge hysteresis of §7.2 plus up to one edge of lock phase, since the offset is learned at an arbitrary point inside a count; **TVP**) is a **mismatch**: that reading uses the count alone and is flagged `SENSOR_ERR` (SPEC D1: "more than 2 edges" beyond what the hysteresis allows). The count is only re-aligned to the SSI after the **same** correction (±1 count) is seen on **3 consecutive still frames** (`as5311_mismatch_update`), so one bad but parity-valid frame cannot shift the reading; each correction is counted (`slips`) |
| Wrap-race filter | The PCNT driver's count is the 16-bit hardware count plus an accumulator its ISR bumps by ±30000 at the watch points. A read that lands between the hardware reset and the ISR is off by 30000 counts (58.6 mm). A step > 15000 counts (29 mm in one 10 ms sample, 2.9 m/s) is re-read up to twice 20 µs apart (`as5311_jump_plausible()`, no state change); then `as5311_jump_filter()` sees that sample's last read **once**: an implausible step is held (the previous count is used, the reading is COARSE) and only a jump that persists for **3 samples (30 ms)** is accepted as real. (Before the review the filter ran on every re-read, so a race that outlasted 40 µs, e.g. with the PCNT ISR held off by a flash write on core 0, was accepted as a 58.6 mm jump.) Rejections are counted (`jumps`) |
| SSI | Bit-banged on MAG_CSN/MAG_CLK/MAG_DO with 1 µs half-periods (≈ 500 kHz; limit 1 MHz). Datasheet Table 10 / Fig. 6: CLK idles **high** and must be high when CSn falls (with CLK low the frame carries the field magnitude instead), ≥ 500 ns CSn high between frames (tCSn), ≥ 500 ns from CSn low to the first CLK falling edge (tCLKFE, which latches the data), then each rising edge shifts out one bit (valid ≤ 413 ns later); DO is sampled 1 µs after each of the 18 rising edges. Frame: D11..D0, OCF, COF, LIN, MagINC, MagDEC, PAR (even parity over bits 1–17) |
| Frame check | Parity even over all 18 bits, OCF = 1, COF = 0 (`as5311_frame_valid`). All-ones (DO stuck high) and all-zeros frames are rejected. 3 bad frames in a row set `SENSOR_ERR` |
| Field check | Datasheet Table 13: MagINC = MagDEC = 1 with LIN = 1 is the RED range (out of spec), readings flagged `SENSOR_ERR`; with LIN = 0 it is YELLOW (≈ 3.4…54.5 mT, slightly reduced accuracy, logged). MagINC or MagDEC alone is a dynamic "distance changing" state. **TVP** at bring-up; the MAG_INC_N / MAG_DEC_N pins are configured as inputs but not used yet |
| Power-up lock | CSn is high at power-up, so A/B/Index stay high until the first CSn low pulse (datasheet §7.1.1). After the first valid frame the driver waits 2 ms for A/B to settle and takes a second frame as the reference, so that unlock transition can't shift the count |
| Slip check | At first power-up the offset between the SSI position and the count's phase (in SSI LSB: count mod 1024 × 4) is locked; it is kept across deep sleep (RTC memory), so the fine position never jumps by a lock phase. Every SSI read (100 Hz) computes the residual above, but only when the count did not change during the ≈ 40 µs frame; the correction uses `SSI_SIGN` |
| Index | MAG_IDX rising edge → IRAM ISR reads the PCNT count; the count's phase at the index must stay within ±16 LSB (4 counts) of the first one (logged) |
| Direction | `CONFIG_CALIPER_MAG_DIR_INVERT` flips the user-facing sign. The firmware assumes the SSI position rises with the PCNT count as wired (`SSI_SIGN`, **TVP**) |
| Power | SNS_PWR_EN high powers +3V3_SNS (and +3V3_UI, §12); 20 ms power-up, then up to 100 ms waiting for OCF |
| Deep sleep | Before sleeping, the count, the in-pole position and the SSI/count offset go to RTC memory (only from a still count and a valid frame) and the rail goes off. After waking, `count = stored + round(wrap(ssi_now − ssi_stored) / 4)`, then the stored offset is restored and the recovered count must pass the consistency check above. The result is exact to an SSI step if the slider moved less than ±1 mm while asleep. A larger move while asleep is not detectable: the reading is then off by a multiple of 2 mm (documented limitation, SPEC/architecture §3.2) |
| Zero after a wake | The zero lives in RTC memory, but `core_mag_origin()` keeps it **only if the count was recovered** (`sensor_mag_origin() == MAG_ORIGIN_RECOVERED`). If there was no saved position, no valid frame on waking, or the recovered count failed the check (and also after a reset that kept RTC memory), the zero is dropped and LIVE / the log carry **`REZERO` (flag bit 6)**. The display shows the value in amber with **ZERO?**, the web page shows "PRESS ZERO" and a toast says "Position lost: press ZERO". ZERO clears it |

## 5. Capacitive sensing (EXPERIMENTAL)

The SPEC asks for a rotating 8-phase square pattern and synchronous I/Q demodulation of ADC1 continuous
samples. Two hardware facts shape the implementation:

1. The ESP32-S3 ADC in continuous mode tops out at about **83 kS/s**, so 8 samples per cycle at the SPEC's
   25–100 kHz is impossible. The ADC's rate is APB / 16 / 2 / *interval* with an integer interval
   (`hal/adc_hal.c`): the firmware uses interval 31 = **80 645 S/s** and steps the pattern every 2 samples
   (**24.8 µs**), i.e. a **5.04 kHz** rotation with exactly 16 samples per cycle. The step is counted in CPU
   cycles of the clock actually running (3968 at 160 MHz) from the ADC period read back from the clock tree.
   (Before the review the drive used a fixed 25.000 µs against the 80 645 S/s the driver really produced
   for its "80 kS/s" request: 16.13 samples per cycle, so the windows slid ~2 samples against the drive per
   half.) The charge amplifier (10 pF ‖ 10 MΩ, corner 1.6 kHz) still integrates at 5 kHz, so the
   front-end should work there (**TVP**; contract issue reported).
2. The ADC and the drive loop start at an unknown relative delay. Each burst therefore runs the pattern
   **forward for 16 cycles, then in reverse for 16**. The position phase changes sign between the halves and
   the delay phase does not, so `2·θ = φ_reverse − φ_forward`, independent of the delay. The price is a
   **half-pitch ambiguity**: the burst measures the position modulo 2.54 mm.

| Step | Detail |
|---|---|
| Drive | Dedicated-GPIO bundle on CAP_TX0..7; phase *n* high while (n − step) mod 8 < 4. A cycle-counter loop inside a critical section on core 1, with a CPU-max PM lock |
| Sample | `adc_continuous` ADC1_CH0 (CAP_RX, GPIO1), 12 dB attenuation, TYPE2 frames; ~530 samples per burst. The driver's pool is flushed before and after every burst (`adc_continuous_stop()` leaves unread frames there, which shifted the next burst's sample index by a frame). The delay estimate (ADC start → drive start) is taken after `adc_continuous_start()` returns; a burst whose drive started more than 64 samples late (preempted) is discarded instead of being clamped into the wrong windows. `CONFIG_ADC_CONTINUOUS_ISR_IRAM_SAFE=y`: with a non-IRAM ISR, a log or NVS write on core 0 holds the ISR off for a sector erase while the 5-frame (4 ms) DMA ring is overwritten, and the burst would be demodulated from spliced samples |
| Demodulate | Single-bin DFT at 16 samples/cycle on a 12-cycle window from each half (2 cycles of margin at every edge), referenced to the absolute sample index, mean removed (`cap_demod_iq`) |
| Position | `frac = wrap((φr − φf) / 2π)` in [0, 1) of the 2.54 mm half pitch; amplitude of each half ≥ 8 LSB and within 2× of the other, else invalid |
| Unwrap | Whole half-pitches are counted from successive fractions, so the slider must move less than **1.27 mm between bursts (~25 mm/s at ~20 bursts/s)**; faster motion loses a half-pitch while the in-pitch fraction stays right |
| Zero and origin | The unwrapper restarts at every boot, so the cap zero is **not** kept across a deep sleep (it was, and the reading came back off by a multiple of 2.54 mm). After a boot, and after a ZERO taken while the cap had no valid burst, the first valid burst is **aligned to the magnetic reading**; ZERO zeroes both. A later cap/mag disagreement of more than 1.27 mm can only be a lost half-pitch, so whole half-pitches are taken back out (`caliper_core.c`); the sub-half-pitch part stays the capacitive scale's own measurement |

The host tests synthesise captures from a coupling model (phase *n* couples `1 + cos(θ − 2πn/8)`), with ±2 LSB
noise and start delays of 0–16 samples: the recovered fraction is delay-independent to 0.003 of a half
pitch and linear in θ. That proves the arithmetic, not the electrode physics. The sign (`CAP_SIGN`), the
constant phase offset (taken out by zeroing) and the ADC's actual sample rate (a rate error adds a constant
offset, also zeroed) are **TVP**.

## 6. Measurement core (`components/measure`, portable)

| Function | Rule | Tested |
|---|---|---|
| Rounding | Integer nm; halves round **away from zero**, symmetric for negative values; a value that rounds to zero prints `0.00`, never `-0.00` | ±5000 nm at 0.01 mm, carries (999.995 → 1000.00) |
| mm display | `decimals` (settings) = 1–3 digits; default 2 → step 10 µm | |
| Inch display | `decimals + 2` digits; at the default 4 digits the step is **0.0005 in = 12 700 nm**, so the last digit is always 0 or 5 | 0.0005 / 0.00075 / 150 mm = 5.9055 in |
| Zero / hold | Zero stores the raw position; hold freezes the shown value; zeroing while held shows 0 | |
| Capture: SETTLE | Replaces the auto-hold. Fires once when the reading has moved > 0.5 mm since the last capture and then stays within a 10 µm span (±5 µm) for 0.8 s; holds the **median of the last 32 samples** (320 ms), not the first still sample; releases when the jaws move > 0.5 mm away (§6.1) | exact median against a reference sort, a +40 µm glitch moves it ≤ 1 LSB, a 20 µm/s ramp never fires, power-up stillness never fires |
| Capture: SWEEP | Min/max peak-hold while the jaws are on the part; freezes on lift-off; shows MIN (OD) or MAX (ID) from the approach direction, or forced (§6.1) | analytic rocked-cylinder, bore and depth traces (§6.1) |
| Tolerance | Band = `nominal − \|tol_minus\| … nominal + \|tol_plus\|`, **inclusive**, decided on the **displayed (rounded)** value. Green inside the inner 80 % of each half, amber in the outer 20 % (still a pass), red outside. Gauge −1000 at the lower limit, +1000 at the upper, clamped ±1500 | limits ±1 nm, one-sided, negative nominal, sign of tol_minus ignored |
| Statistics | Welford over the **recorded** readings: n, min, max, mean, sample σ (n − 1) | vs a two-pass long-double computation on 5000 values at 150 mm (σ to 1e-9 relative) |
| Log record | 16 bytes LE `{u32 seq, u32 unix_s, i32 value_nm, u8 unit_kind, u8 flags, u16 profile_id}` (byte 12: bit 0 unit, bits 1..3 the capture kind, §8.1) | byte-exact pack, round trip, end marker |
| Ring log | seq *s* lives in slot (s − 1) mod capacity; seq numbers never restart (a clear moves `base_seq`), so incremental sync never sees a reused number | wraparound, clear, restore after reboot, bijection over 12 345 appends; the flash layout in `store_tests` (§11) |
| CSV | `seq,unix_s[,utc],value,unit,flags,profile,kind`; flags `H` hold, `P` pass, `F` fail, `E` sensor error, **`Z` zero lost** (REZERO, added in the review: such a value is relative to an origin set after a sleep/reset); **`kind`** (appended last with the capture modes, so readers of the first seven columns are unaffected): empty for a plain reading, `settle`, `min` or `max`. `csv_pack()` emits whole lines only and the export flushes and continues, so a batch that does not fit the 1 KiB buffer is split instead of losing its tail (the old loop dropped the rest of the batch) | widest line < 104 B, a 16-record batch of widest lines in 1 KiB, `HPFEZ`, the kind column |
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
