tyevco/prettycoolboards/caliper/docs/app.md

# Companion app

**Status:** written and tested against its own demo simulator and unit tests only. No caliper
firmware or hardware exists yet, so the page has **never talked to a real caliper**. Treat
everything below as the design of record for the app side of the BLE contract.

**Live page: <https://tyevco.github.io/prettycoolboards/caliper/app/>**
(add `?demo` to the URL to start the simulator straight away).

The companion app is one static web page that talks to the caliper over **Web Bluetooth**. There
is no install, no build step and no server: the page is plain HTML, CSS and two ES modules, with
no third-party libraries and no CDN, so it works offline once loaded. VitePress copies it verbatim
from [`public/caliper/app/`](../../public/caliper/app/) into the docs site.

| File | Contents |
|---|---|
| [`index.html`](https://github.com/tyevco/prettycoolboards/blob/main/public/caliper/app/index.html) | Layout and styles (light/dark from `prefers-color-scheme`) |
| [`app.js`](../../public/caliper/app/app.js) | UI, Web Bluetooth transport, demo simulator, chart, Web Serial console |
| [`protocol.js`](../../public/caliper/app/protocol.js) | The GATT contract as pure functions: encode/decode of every characteristic, units, stats, CSV |
| [`protocol.test.mjs`](../../public/caliper/app/protocol.test.mjs) | `node --test` suite against hand-built byte arrays |
| [`protocol.vectors.test.mjs`](../../public/caliper/app/protocol.vectors.test.mjs) | byte vectors produced by the firmware's C codec (`test/host/gen_vectors.c`) |

## What it does

- **Live reading.** Big caliper-style digits in the unit the caliper is set to (mm or inch),
  status chips for HOLD, PASS, FAIL, CAP (capacitive reading valid), CHG (charging) and SENSOR ERR.
  The display gets a green or red border on PASS/FAIL, and the text chips carry the same
  information for people who can't tell the colours apart.
- **Magnetic vs capacitive.** The AS5311 reading, the experimental capacitive reading and their
  difference (cap − mag, in µm or 10⁻⁴ in) side by side. Comparing the two is the point of
  the capacitive scale (see [architecture](architecture.md)), so the difference is always on
  screen while the CAP_VALID flag is set.
- **Buttons** that send COMMAND opcodes: Zero, Hold, Record, mm/in, Set time. The clock is set
  automatically on every connect (SET_TIME with the phone's/PC's Unix time), because the caliper
  has no RTC battery. Keyboard shortcuts: <kbd>Z</kbd>, <kbd>H</kbd>, <kbd>R</kbd>, <kbd>U</kbd>.
- **Capture modes** (firmware [§6.1](firmware.md#_6-1-capture-modes)), shown
  only when the caliper sends the 20-byte LIVE (older firmware: no capture controls). **Capture: Off / Settle /
  Sweep** and, for Sweep, **Show: Auto / Min / Max** send SET_CAPTURE (`0x05`); **Re-arm** sends CAPTURE_RESET
  (`0x06`). A chip names the mode, the extreme shown and the state (`SWEEP · MIN (auto) · tracking`, `· frozen`,
  `SETTLE · settling`, `· aborted`), and a line under the digits gives the other extreme, the range R (one digit
  more than the reading) and n, or for Settle the median's sample count and σ. The big digits are always
  `value_nm`, the shown value: the chosen extreme or the median. PASS / FAIL say what was judged:
  `PASS (min)`, `FAIL (max)`, `PASS (median)`. Hold on the caliper or the page freezes a running capture and
  re-arms a frozen one, as on the device. **Auto** reads the approach (closing = OD = min, opening = bore = max):
  it suits ODs and one bore at a time; for several bores in a row choose **Max**, for depth and steps **Min**
  (firmware §6.1).
- **Live chart** of the last 30 s, drawn on a `<canvas>` by hand (no chart library): magnetic as
  a solid line, capacitive dashed, and the active profile's tolerance band shaded with the nominal
  as a dashed line. The y-axis autoscales; it includes the band when the readings are within
  20 band-widths of it, otherwise a "band above/below" hint is shown.
- **Session stats**: count, min, max, mean, sample σ (n−1) and range of the readings recorded
  from this page (Record or "Add current"), computed in the browser with Welford's algorithm.
  Readings recorded with the caliper's own button do not reach the page; download the log for those.
- **Log download.** LOG_READ from a chosen sequence number (0 = everything), reassembly of the
  16-byte records until the end marker, a table (newest first) and CSV export. If no
  notification arrives for 5 s before the end marker, the download stops and keeps what it has.
  "Clear log on caliper" sends LOG_CLEAR after a confirmation dialog. With a caliper that has the capture
  modes the page sends the 6-byte LOG_READ that returns each record's kind; the table tags SETTLE / MIN / MAX
  records and the CSV gets a last `kind` column (`settle`, `min`, `max` or empty). If that read is refused it
  falls back to the plain 5-byte one.
- **Tolerance profiles editor**: read, add, edit, delete and write the PROFILES records, and
  select the active one (SELECT_PROFILE; "No profile" selects id 0). Values are edited in the
  current display unit and stored in nm.
- **Settings editor** for the SETTINGS JSON with a live byte counter against the 240-byte limit.
  The Wi-Fi password field is write-only: it is never filled from the caliper, and it is left out
  of the JSON when blank, which means "keep the stored password".
- **Device panel**: name, Device Information strings, battery level (notify if the
  characteristic supports it, otherwise read once on connect).
- **USB console (optional)**: a Web Serial terminal for the firmware's USB CDC console at
  115200 baud, filtered to Espressif's USB vendor ID 0x303A.

## Browser support

Web Bluetooth is a Chromium feature. Checked against the browser vendors' published status, not
tested on every platform listed:

| Browser | Connect over BLE | Demo mode | USB console |
|---|---|---|---|
| Chrome / Edge, Windows 10+, macOS, ChromeOS | yes | yes | yes |
| Chrome / Edge, Linux | listed as supported but less mature (BlueZ); some versions need `chrome://flags/#enable-experimental-web-platform-features`. Unverified | yes | yes |
| Chrome, Android 6+ | yes | yes | no (no Web Serial on Android) |
| Firefox (all platforms) | **no**, Mozilla does not implement Web Bluetooth | yes | no |
| Safari, macOS and iOS; every iOS browser (all use WebKit) | **no** | yes | no |
| Bluefy (third-party iOS browser) | probably, untested | yes | no |

When Web Bluetooth is missing the page says so in a banner, disables Connect and offers demo mode.
Web Bluetooth also needs a secure context: `https://` (the docs site) or `http://localhost`.
Opening `index.html` from disk (`file://`) does not work, because browsers block ES-module
imports from `file://`.

What was actually run: the page in desktop Chrome on Windows 11 in demo mode, at desktop width and
in a 360 px-wide frame (no horizontal scroll), plus the `node --test` suite. The BLE transport has
not run against any device.

A review pass afterwards re-ran it in desktop Chrome (Windows 11) in demo mode, served by
`vitepress preview`: deleting a profile and writing reported "2 profiles written, 1 deleted" and
a read-back returned 2; mm/in switched the reading to 4 inch decimals; an out-of-range `decimals`
was refused before writing; the log download returned 42 records in 3 notifications; the page
loaded only `app.js` and `protocol.js` (no other network requests); no console errors. In 320,
360 and 412 px frames there was no horizontal scroll. At 320 px the worst-case reading
"−150.000 mm" was clipped with the original font size, so the digits were made smaller on narrow
screens (`clamp(34px, 11.5vw, 112px)`); after that it fits. Dark mode was checked only by reading
the CSS (every colour token is redefined under `prefers-color-scheme: dark`), not on screen.
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
