tyevco/prettycoolboards/caliper/docs/simulation.md

# Simulation

_Not written yet. No SPICE simulation of the power path or the capacitive front-end has been run for rev A; see
[SPEC](../hardware/design/SPEC.md) for the design values._
