tyevco/prettycoolboards/caliper/docs/ideas/index.md

# Oh, neat: things we might want in the future

A parking lot for ideas that are researched but **not planned for rev A**. Nothing on this page has been built.
Each idea gets a short summary here and a research note beside it.

| Idea | Status | Note |
|---|---|---|
| Rev B directions: battery life, dropping Wi-Fi, other chips, jaws, beam, fabrication | Open list, nothing designed | [rev-b.md](rev-b.md) |
| Electronic slide lock | **Binned** (owner, 2026-11-11). Research kept for reference | [slide-lock.md](slide-lock.md) |

## Electronic slide lock (binned)

> **Binned on 2026-11-11** by the owner: not pursued for rev B. The summary below and the research note stay as a
> record.

**What:** press HOLD and the slider locks itself on the beam. It unlocks on a button press, or when you push the
slider (the encoder sees it). It holds with zero power, so the lock stays engaged through deep sleep.
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
