tyevco/prettycoolboards/caliper/docs/ideas/rev-b.md

# Rev B ideas

A list of directions for a second revision, collected on 2026-11-11 while costing rev A's fabrication. **None of
this is designed, built or measured.** Numbers marked *estimate* are hand estimates from datasheets or from the
[power budget](../architecture.md#_5-power-budget-and-battery-life); every part named here is a candidate to research, not a
choice. Rev A stays as it is: these are inputs for the next board and housing.
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
