tyevco/prettycoolboards/caliper/hardware/fab/scale/prettycool-caliper-scale-3d-bottom.png

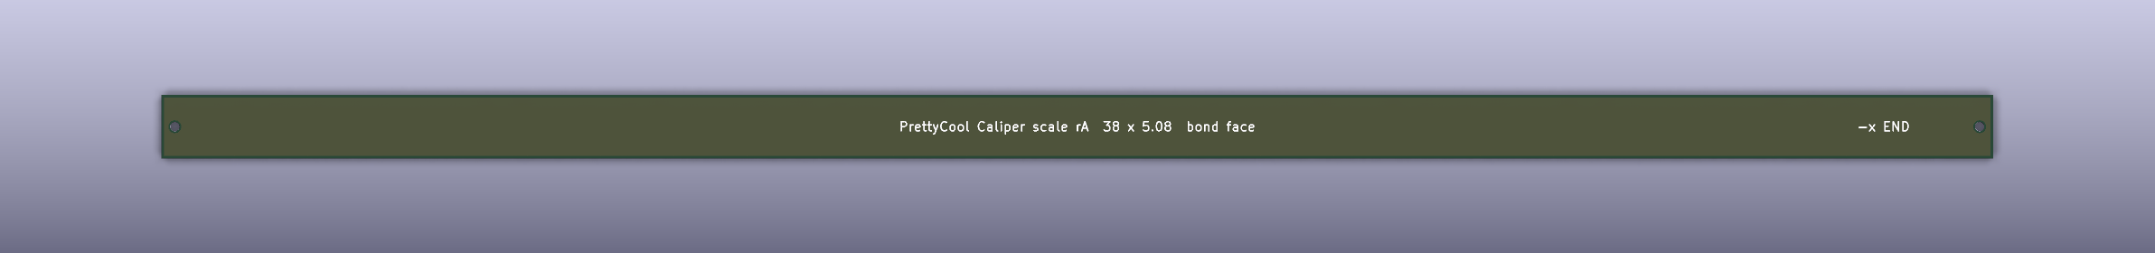
caliper/hardware/fab/scale/prettycool-caliper-scale-3d-bottom.png
