tyevco/prettycoolboards/caliper/hardware/kicad/scale/render/sheet-1.png

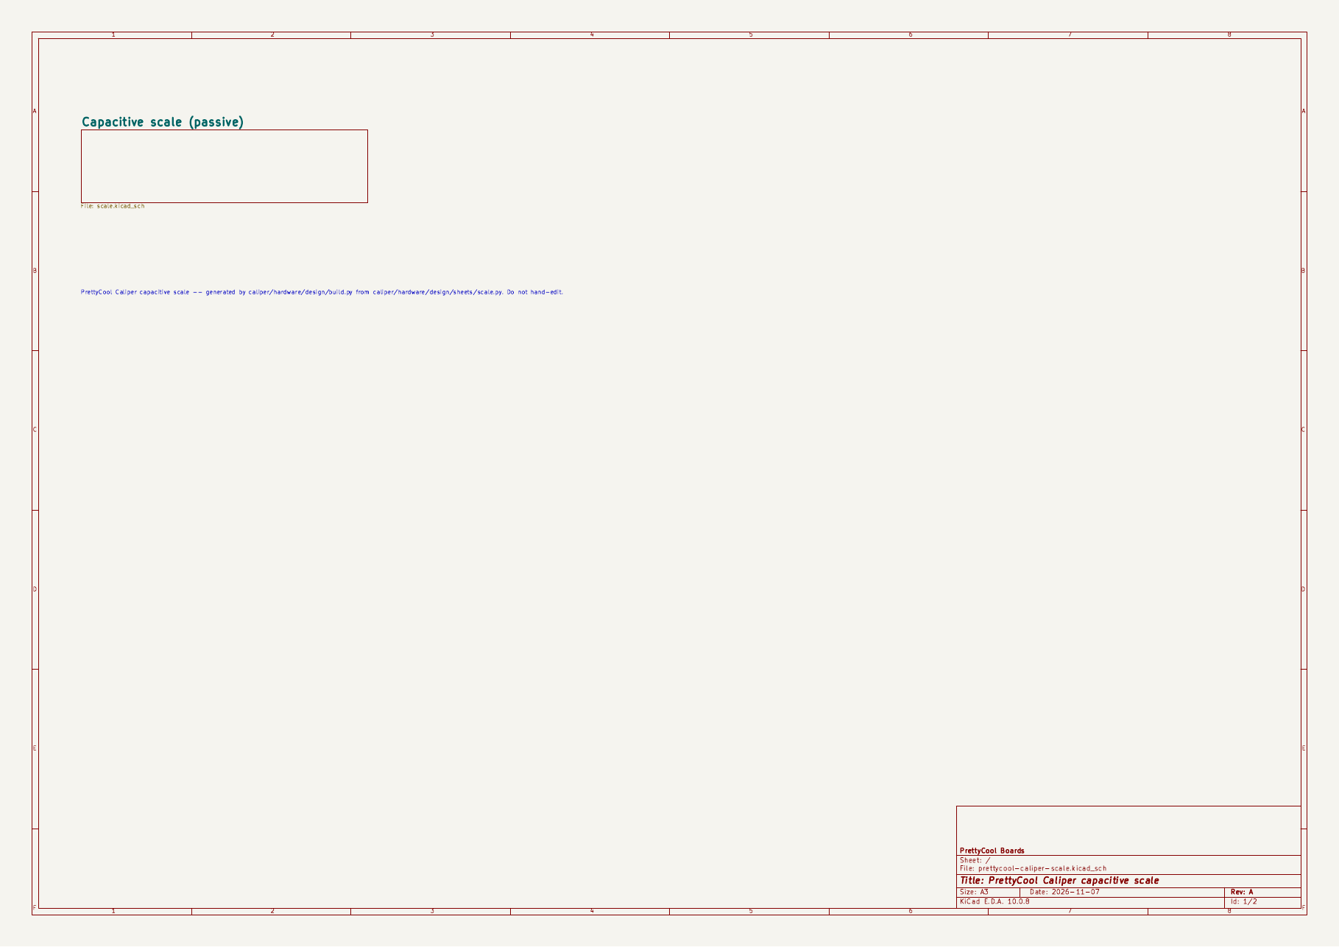
caliper/hardware/kicad/scale/render/sheet-1.png
