tyevco/prettycoolboards/caliper/hardware/kicad/scale/render/sheet-2.png

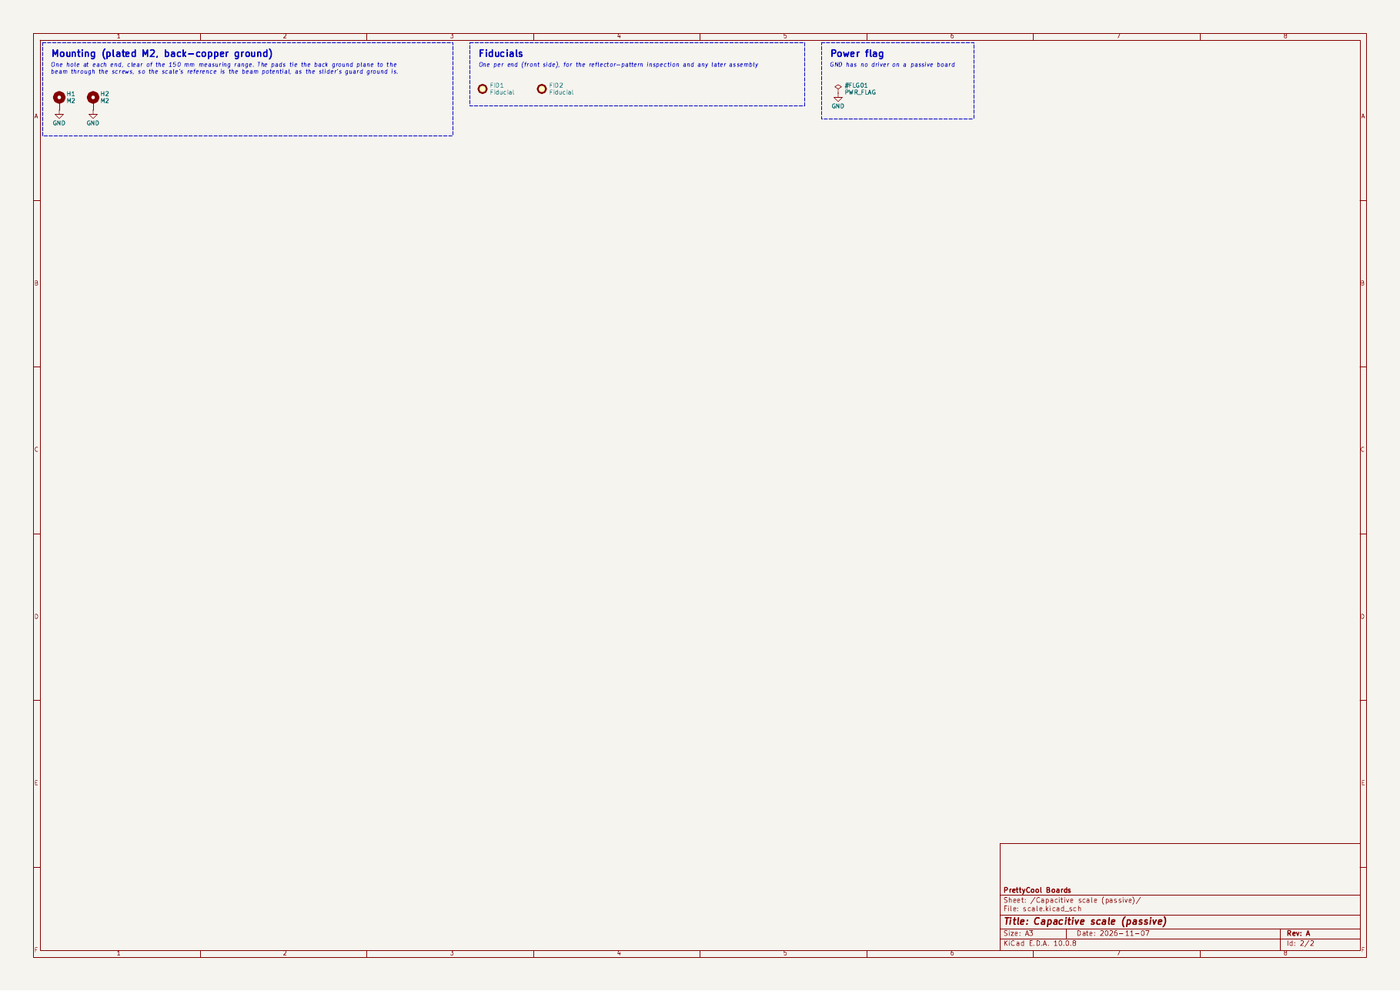
caliper/hardware/kicad/scale/render/sheet-2.png
