tyevco/prettycoolboards/caliper/hardware/kicad/slider/render/sheet-1.png

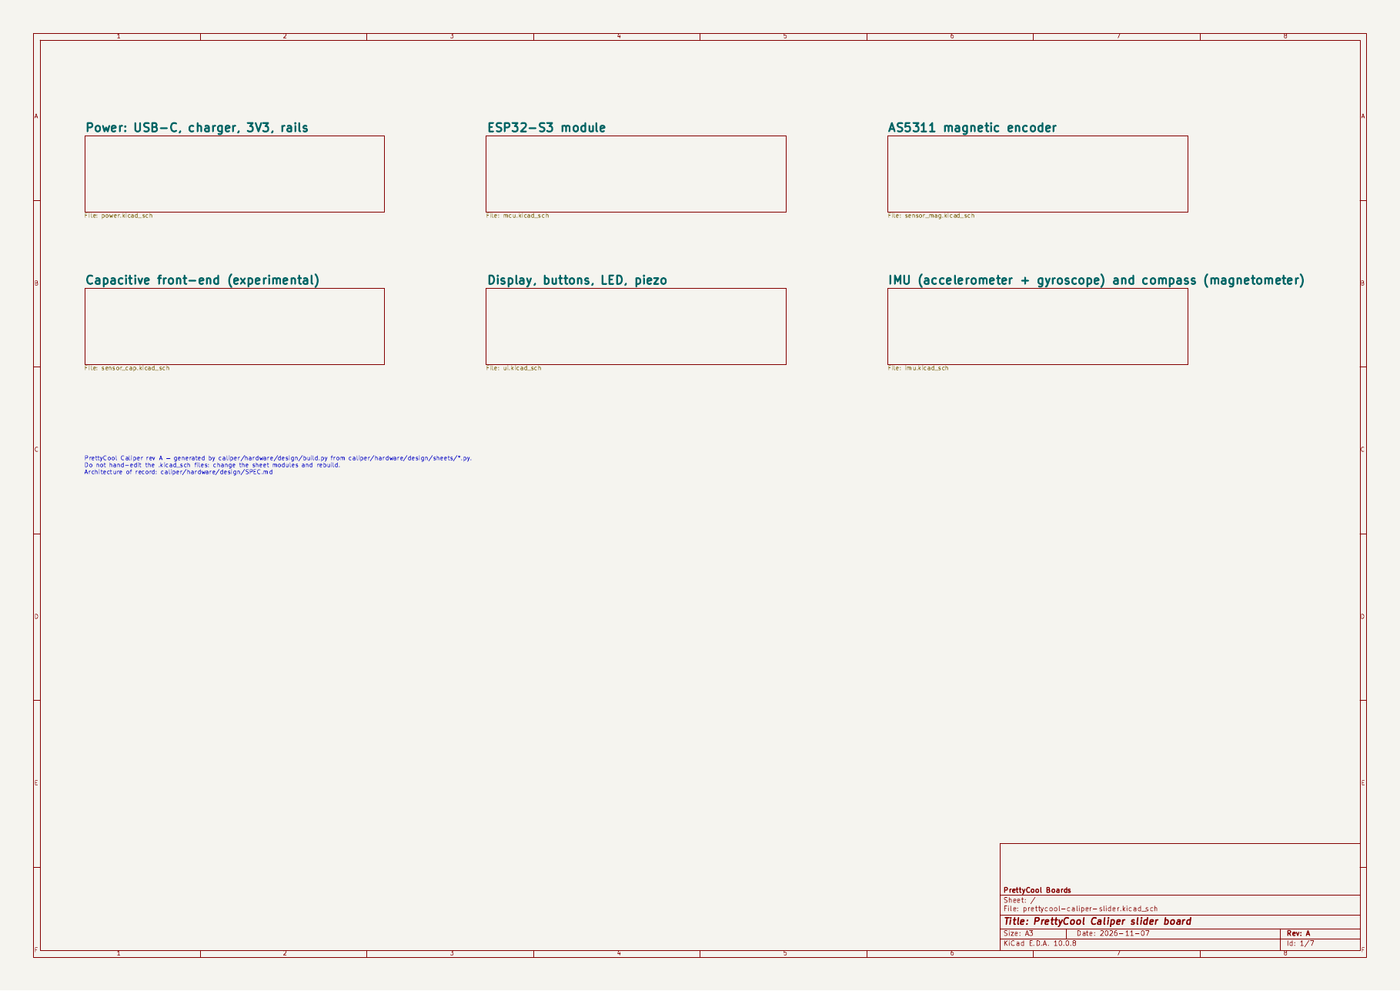
caliper/hardware/kicad/slider/render/sheet-1.png
