tyevco/prettycoolboards/caliper/hardware/kicad/slider/render/sheet-2.png

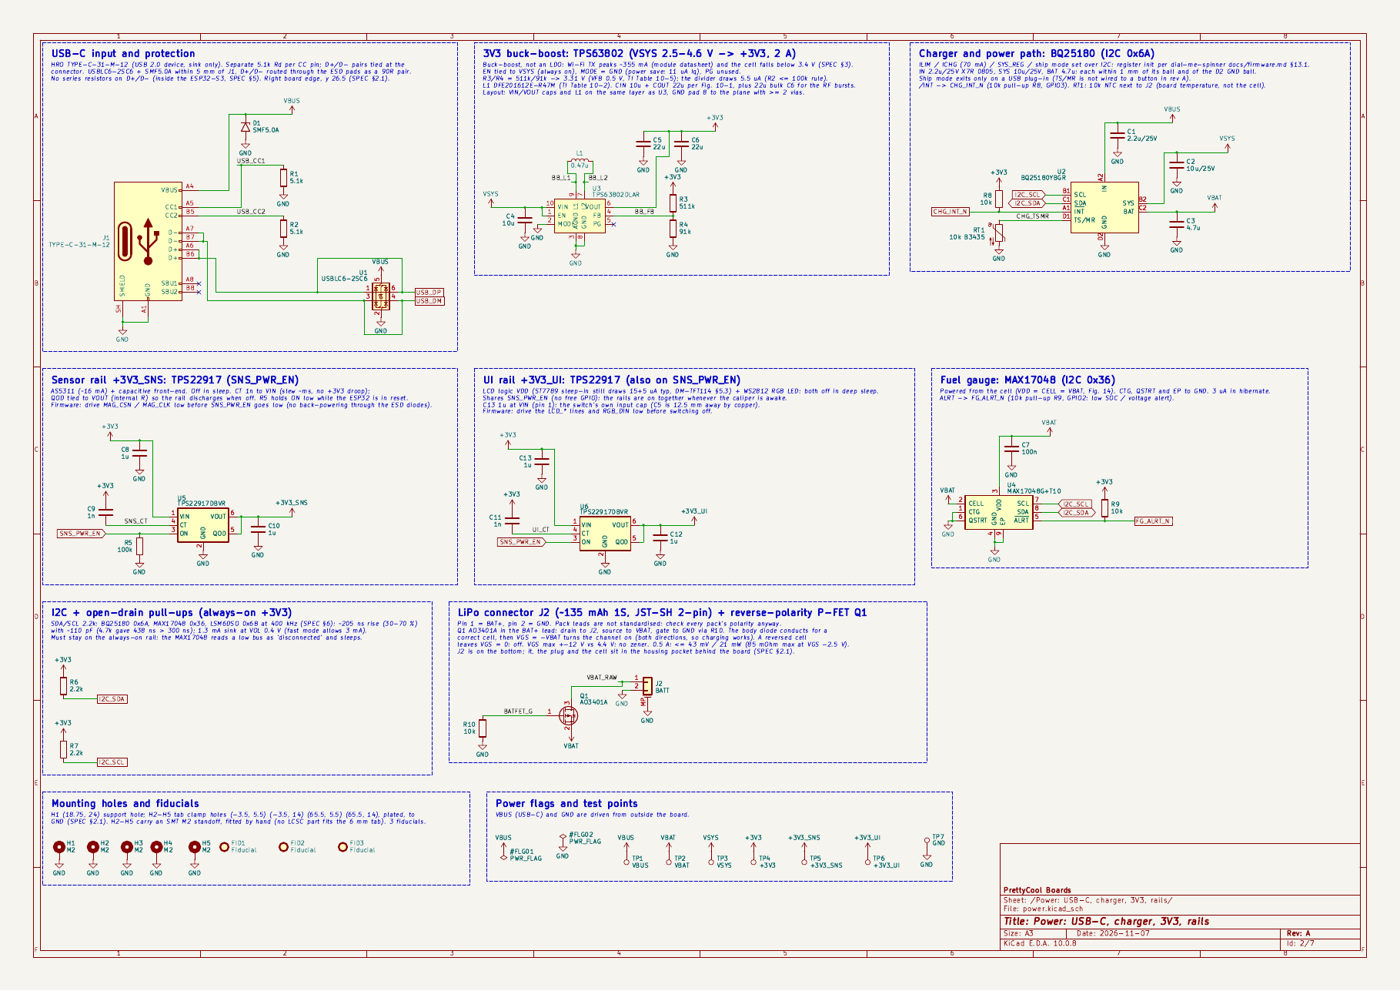
caliper/hardware/kicad/slider/render/sheet-2.png
