tyevco/prettycoolboards/caliper/hardware/kicad/slider/render/sheet-3.png

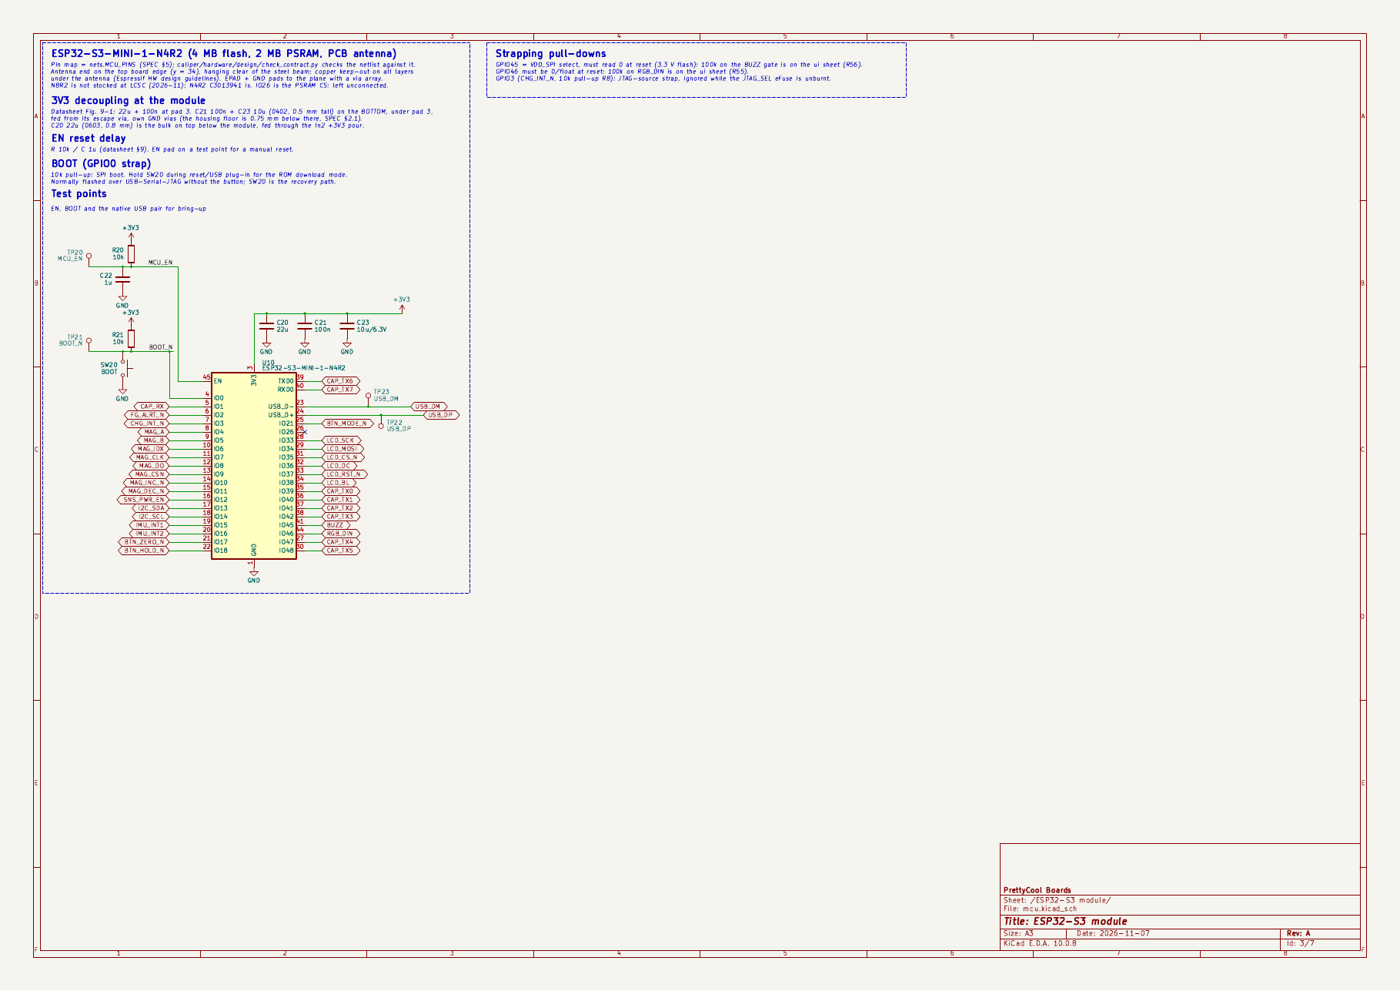
caliper/hardware/kicad/slider/render/sheet-3.png
