tyevco/prettycoolboards/caliper/hardware/kicad/slider/render/sheet-4.png

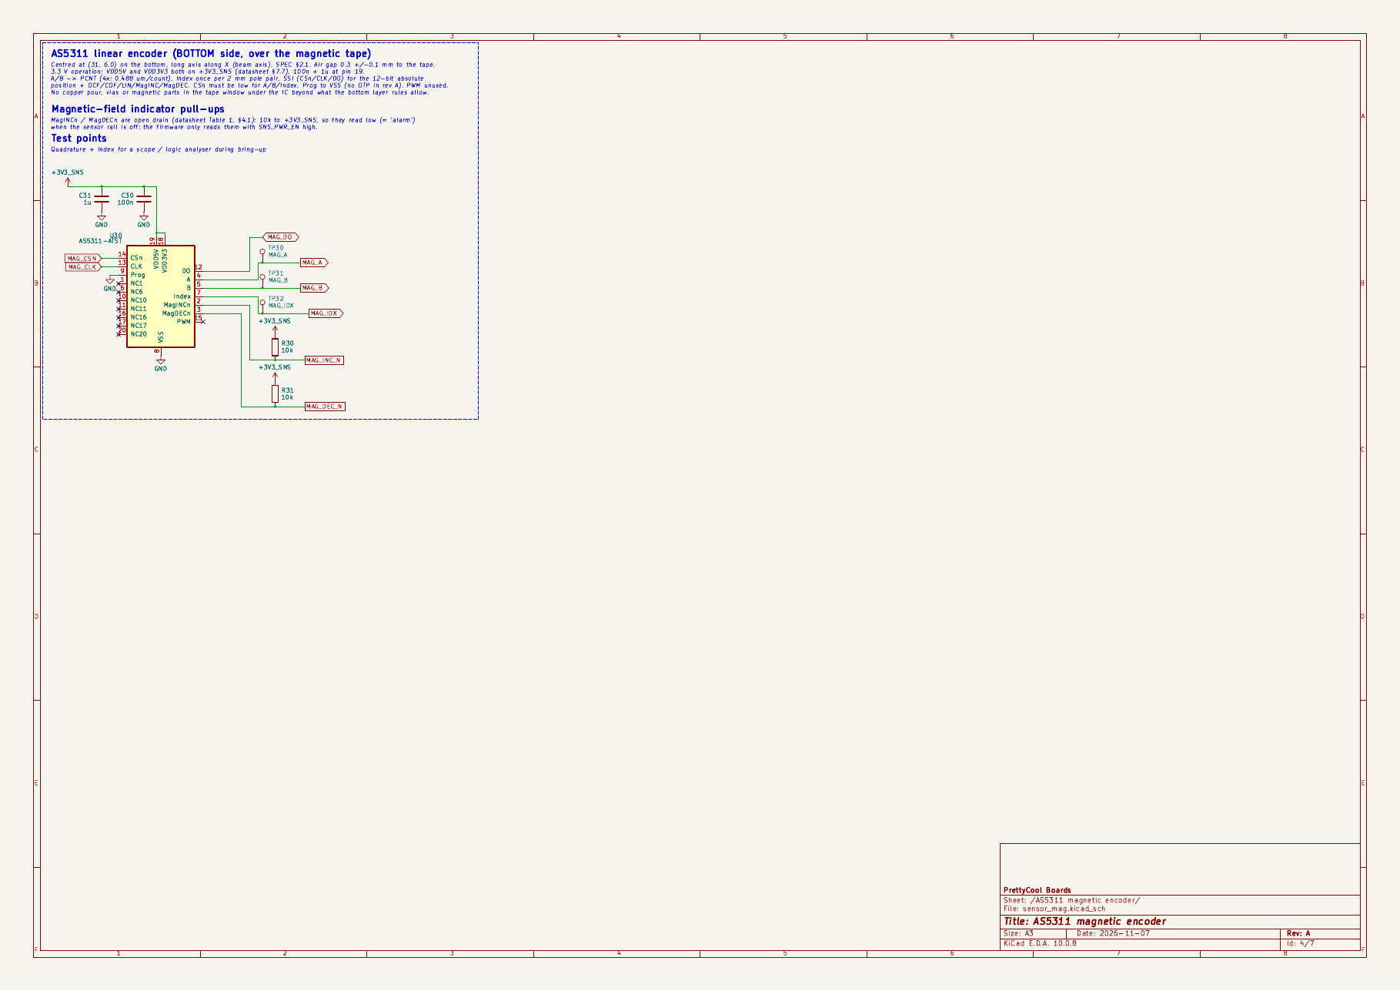
caliper/hardware/kicad/slider/render/sheet-4.png
