tyevco/prettycoolboards/caliper/hardware/kicad/slider/render/sheet-5.png

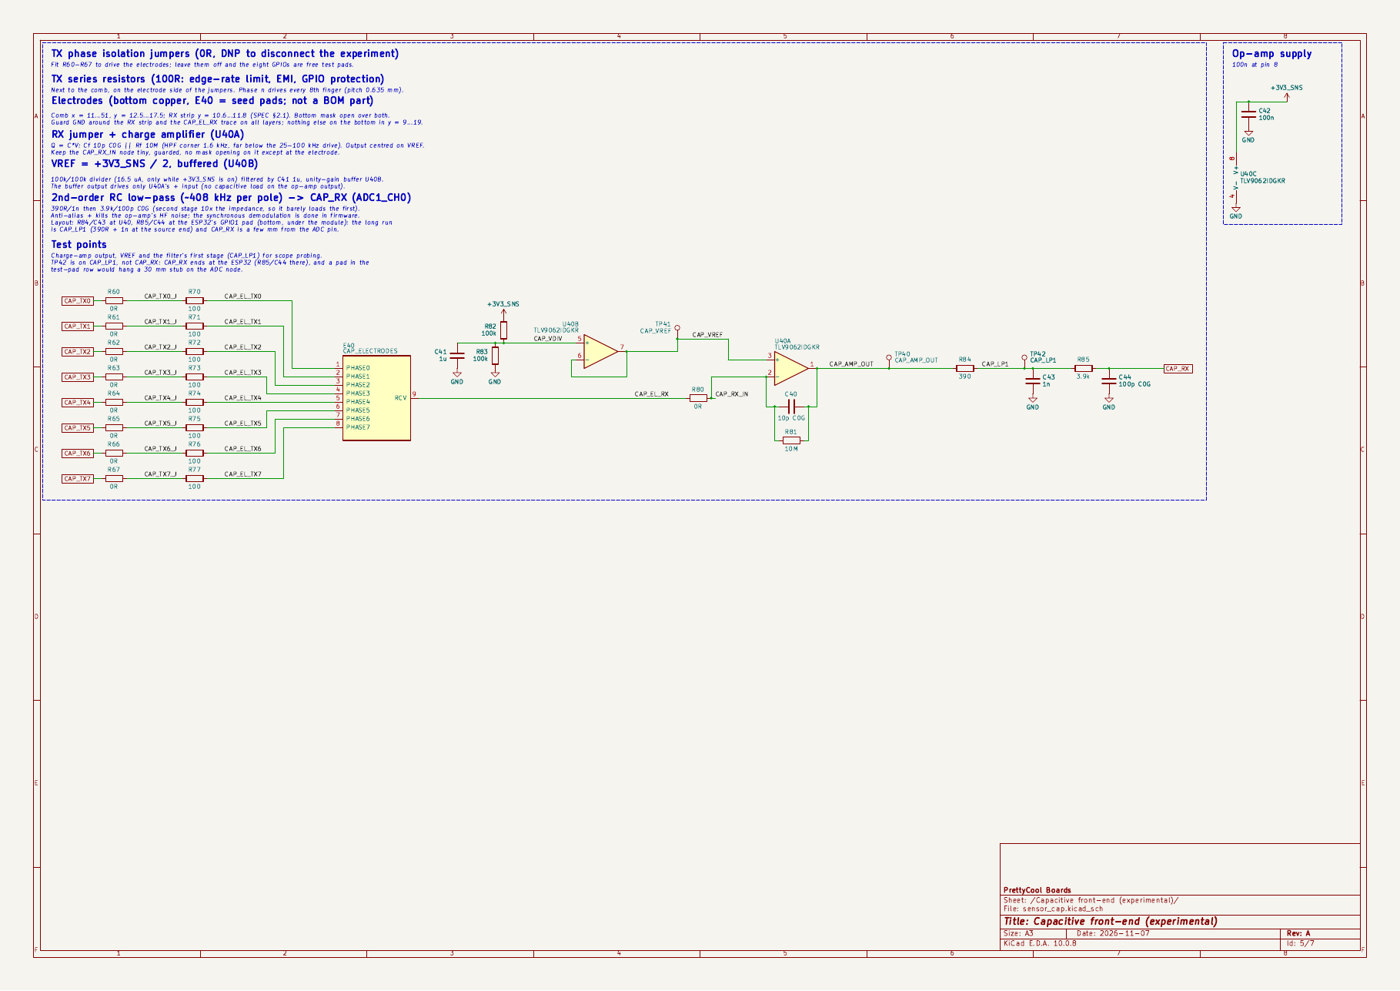
caliper/hardware/kicad/slider/render/sheet-5.png
