tyevco/prettycoolboards/caliper/hardware/kicad/slider/render/sheet-6.png

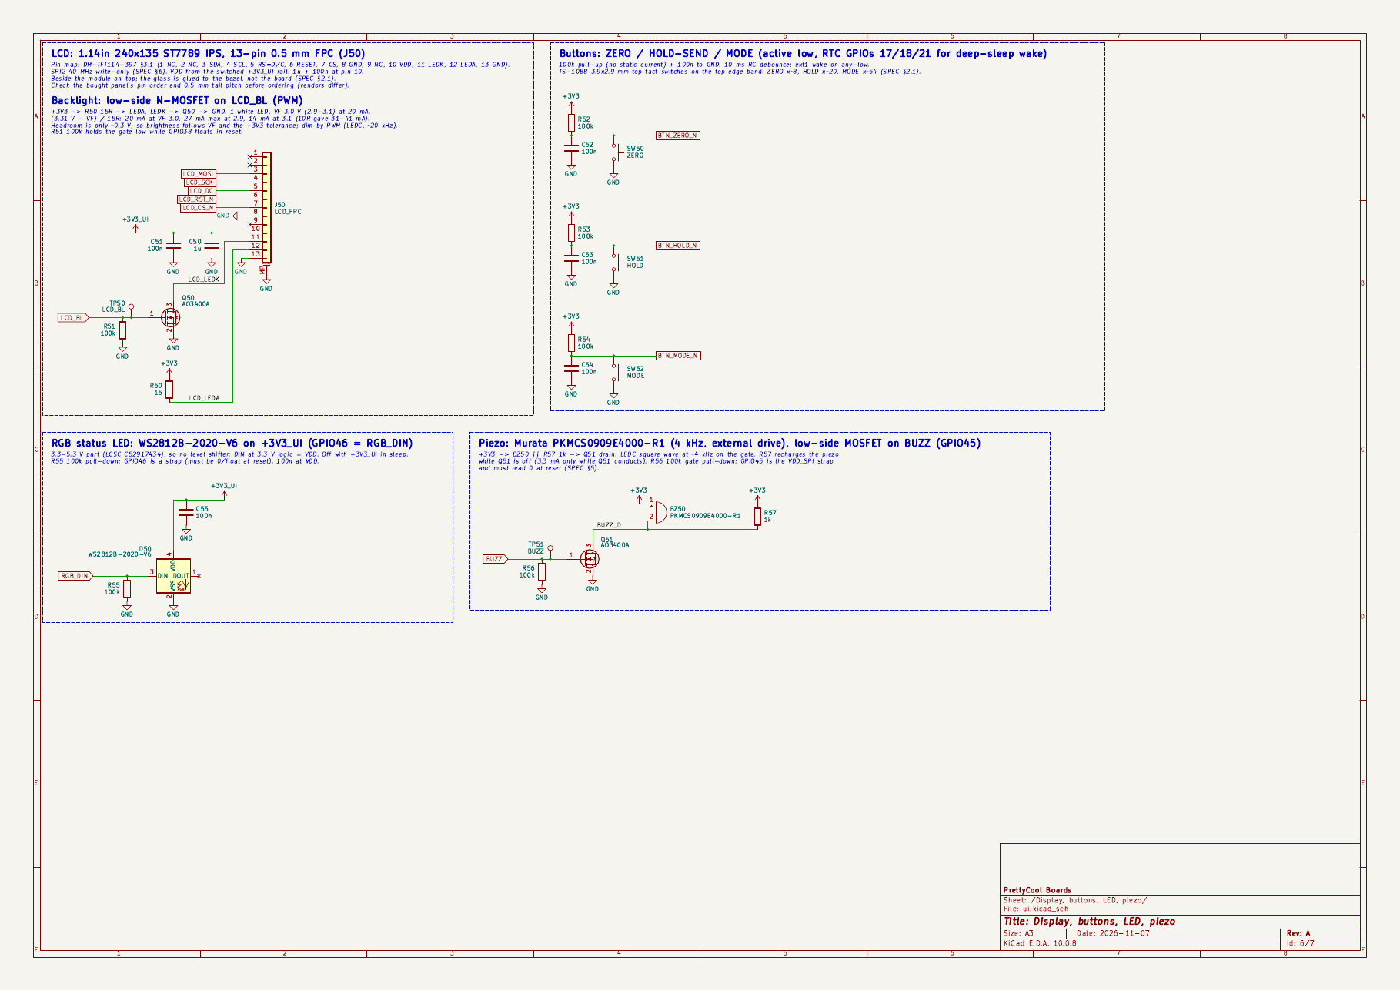
caliper/hardware/kicad/slider/render/sheet-6.png
