tyevco/prettycoolboards/caliper/hardware/kicad/slider/render/sheet-7.png

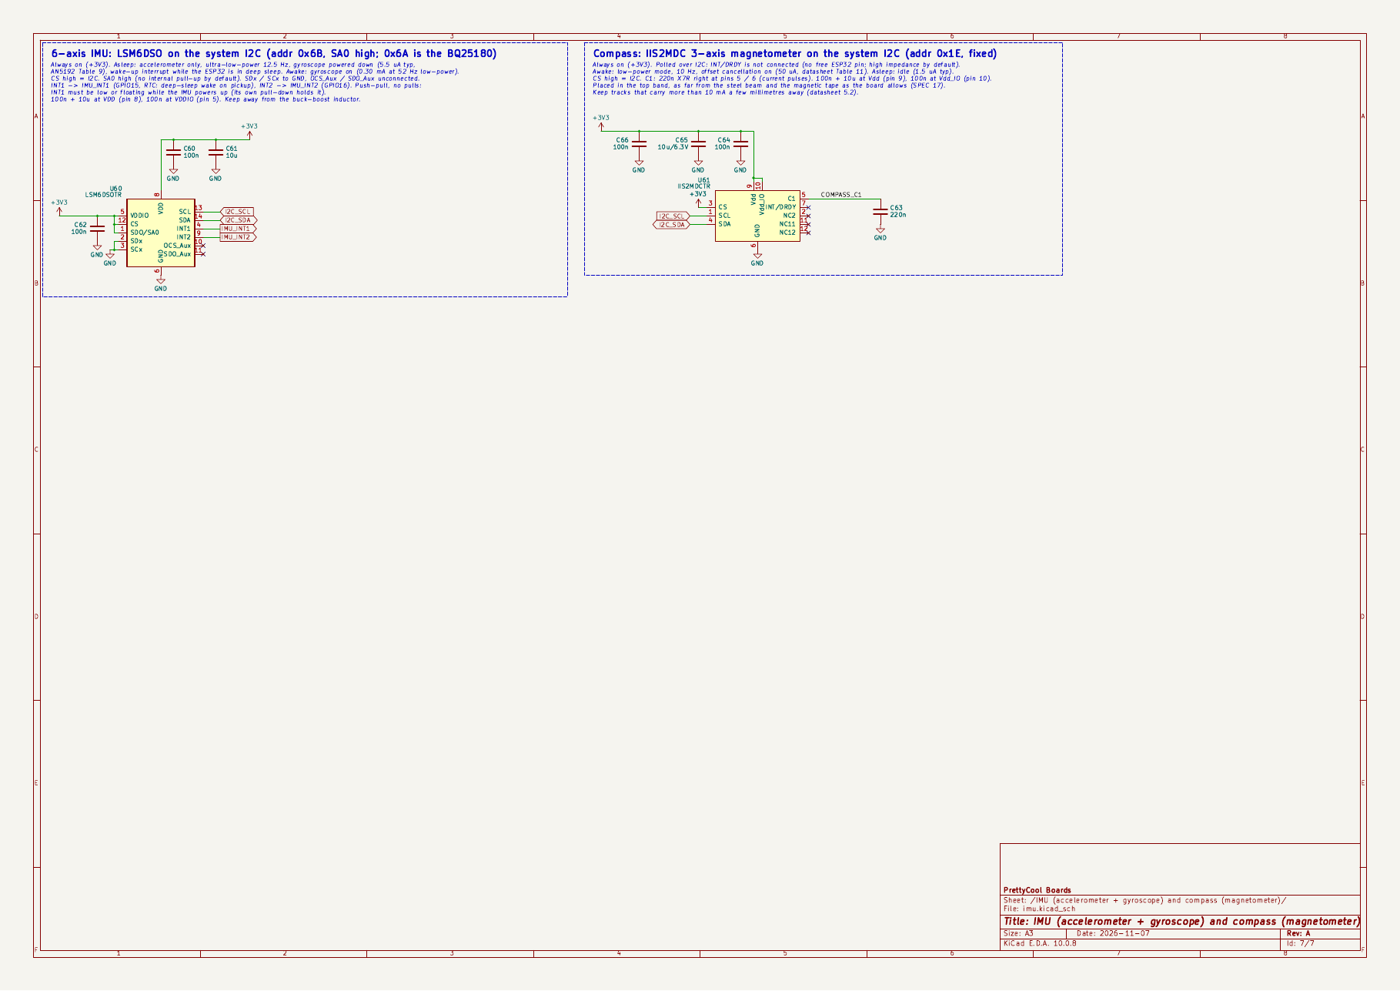
caliper/hardware/kicad/slider/render/sheet-7.png
