tyevco/prettycoolboards/caliper/hardware/mechanical/renders/fea_jaw.png

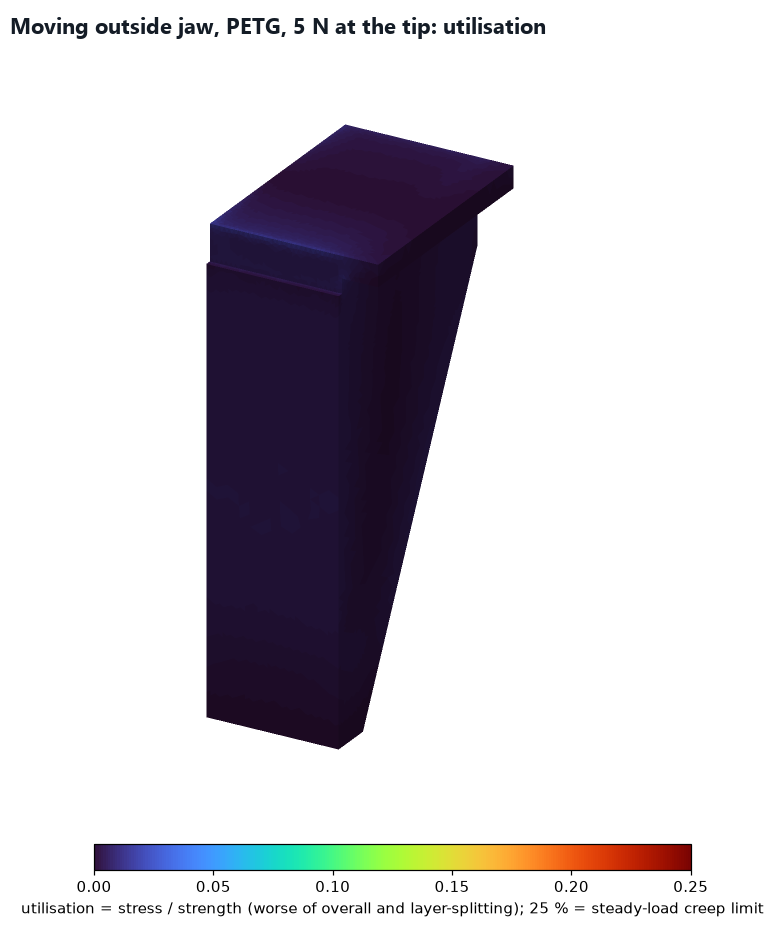
caliper/hardware/mechanical/renders/fea_jaw.png
