tyevco/prettycoolboards/public/caliper/gallery/img/board_fit.png

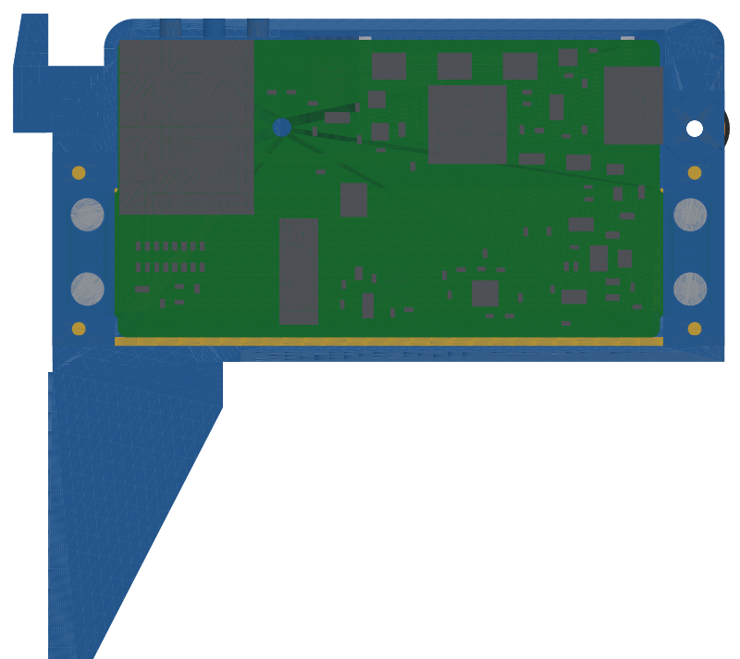
public/caliper/gallery/img/board_fit.png
