tyevco/prettycoolboards/public/caliper/gallery/img/exploded.png

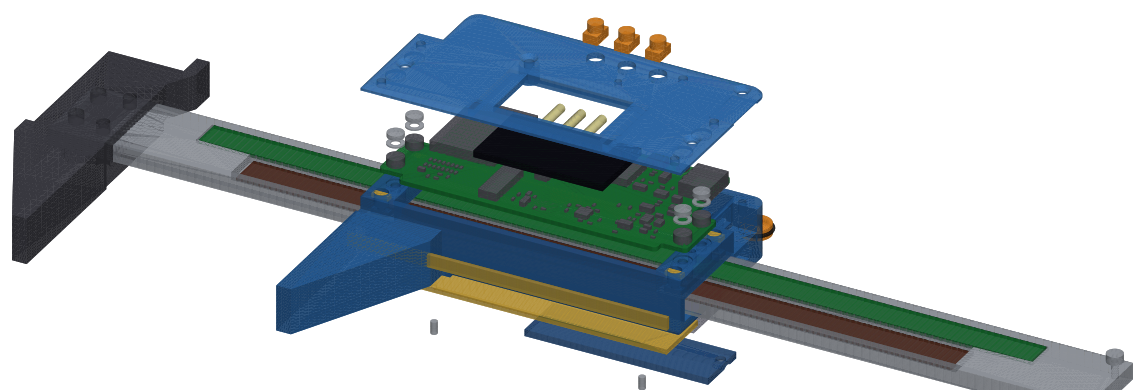
public/caliper/gallery/img/exploded.png
