tyevco/prettycoolboards/public/caliper/gallery/img/jaws_closed.png

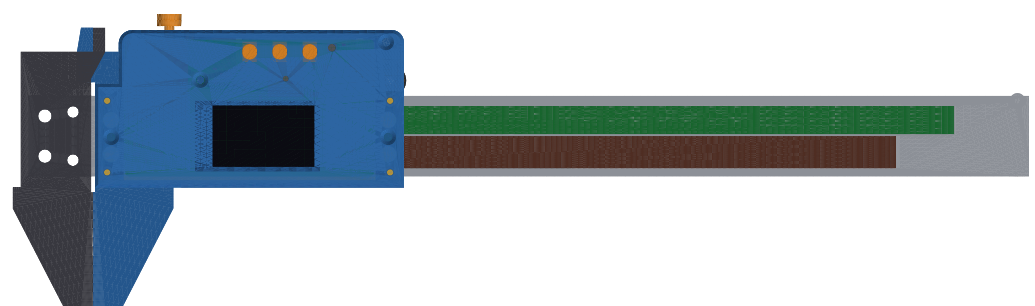
public/caliper/gallery/img/jaws_closed.png
