tyevco/prettycoolboards/public/caliper/gallery/img/section.png

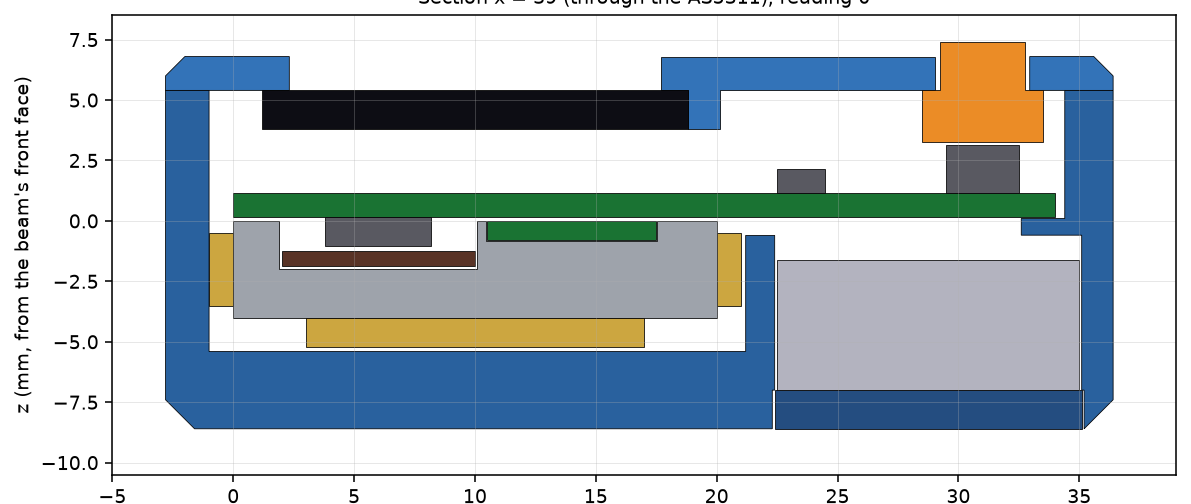
public/caliper/gallery/img/section.png
