tyevco/prettycoolboards/public/caliper/gallery/img/section_gaps.png

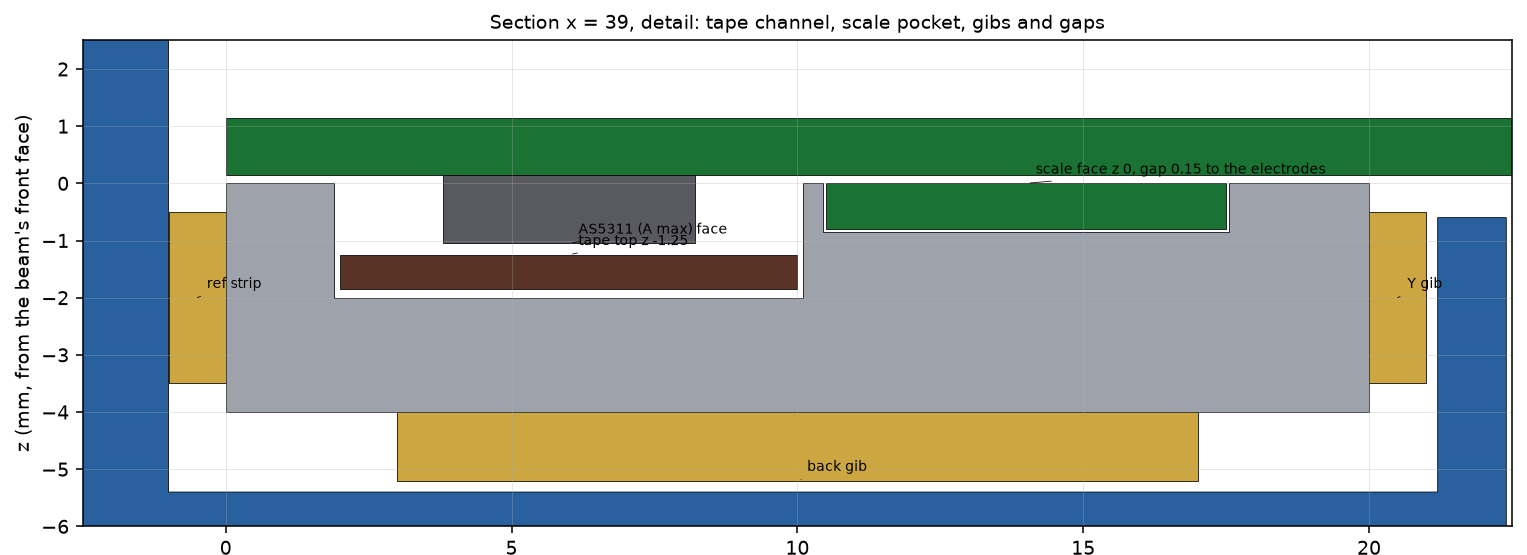
public/caliper/gallery/img/section_gaps.png
