tyevco/prettycoolboards/public/caliper/gallery/img/slider_open.png

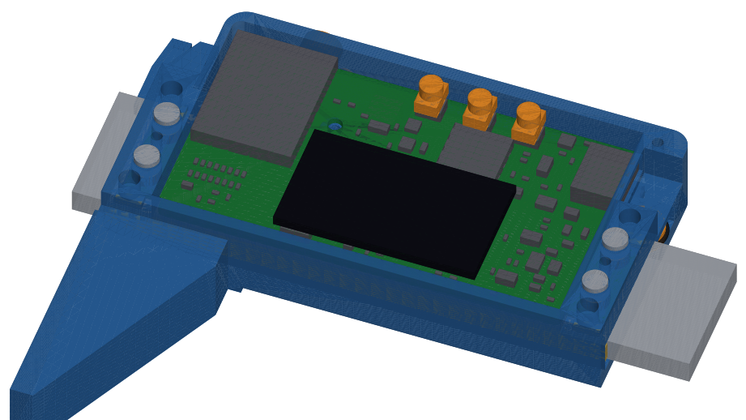
public/caliper/gallery/img/slider_open.png
