tyevco/prettycoolboards/caliper/hardware/fab/slider/ORDER-NOTES.md

# Order notes: prettycool-caliper-slider.kicad_pcb

(generated by caliper/hardware/design/release.py; do not edit)

Rev A is **designed, not built**: nothing here has been fabricated, assembled or measured.

* DRC/parity gate (kicad-cli 10.0.8, errors only): ** Found 0 DRC violations **; ** Found 0 unconnected pads **; ** Found 0 Footprint errors **
* Do not place (DNP): none
* Not assembled, not in BOM/CPL (copper / mechanical only): E40, FID1, FID2, FID3, H1, H2, H3, H4, H5, TP1, TP2, TP3, TP4, TP5, TP6, TP7, TP20, TP21, TP22, TP23, TP30, TP31, TP32, TP40, TP41, TP42, TP50, TP51 (E40 = the capacitive electrode comb: bare copper, no part)
* Bottom-side placements (8): C21, C23, C30, C31, C44, J2, R85, U30
* **jlcplace 0.2.1 placement gate** (JLC's EasyEDA footprints put down at every CPL row, over gerbers.zip): 107 results: 0 red, 0 yellow, 107 green, 0 verified
  * origin: the Gerbers' (0, 0) is this CPL's origin, board (100, 100) (the aux (drill/place file) origin): the rows were checked from it, as JLC reads them
  * cross-check without the database (EasyEDA records alone): every row the records call red is red here too, or a recorded decision accepts it
* **JLC placement preview checklist** (3 items, also in jlcplace-checklist.md): open the order's placement preview and tick each part when it sits on its pads with pin 1 / polarity where the board wants it
  * [ ] uncertain correction: **BZ50** (C910763, top, rot 0): yellow db correction (manual): polarity decided by pad numbers only (rot 180 also lands both pads, and no pin names or drawn + confirm it): check the polarity mark in JLC's preview
  * [ ] bottom reading: **J2** (C160402, bottom, rot 180): if JLC read the bottom rotation another way: as ccw-from-top+180 or jlc-2022+180, pin 1 would land off copper (4 pins move)
  * [ ] bottom reading: **U30** (C22459687, bottom, rot 0): if JLC read the bottom rotation another way: as ccw-from-top+180 or jlc-2022+180, pin 1 would sit on pad 11 (20 pins move)
* **PCB:** 4 layers, **1.0 mm** finished thickness, FR-4, **ENIG** (flat pads for the 0.4 mm-pitch DSBGA, the LGA module and the bare electrode copper), green mask, white silk, 1 oz outer / 0.5 oz inner copper.
* **Stack-up: JLC04101H-3313** (select it in the order's layer stack-up option): JLC's symmetric 4-layer 1.0 mm construction with one 3313 prepreg (0.0994 mm, er 4.1) between each outer and inner layer, 35 um outer / 15.2 um inner copper (JLC's impedance page: 3313 er 4.1, core er 4.6; a third-party catalogue of JLC's templates gives this construction a 0.70 mm NP-155F core, 2026-11-09). The board file carries this stack (layout.py `SLIDER_STACKUP`; its 0.6708 mm core is set so the stack adds up to 1.0 mm, within 0.03 mm of that; no line depends on the core). Symmetric is required by the flatness callout. L1 F.Cu signals, L2 In1 solid GND, L3 In2 +3V3 pour / signals / electrode phase buses, L4 B.Cu sensors, the VBAT trunk. **No impedance control ordered** (it would buy nothing for full-speed USB, 12 Mb/s): USB_DP/USB_DM are a pair of 0.16 mm tracks with a 0.16 mm gap, mostly on L4 over a GND strip on L3, 89 ohm differential on this stack (hwtools sicalc field solve with mask and JLC's etch; docs/electronics.md §7.1). Do not take the 7628 stack: the pair would be 109 ohm and the inner-layer crosstalk geometry of the CAP_LP1 shield would change. If the order form offers the stack-up only with impedance control on, take it and give USB_DP/USB_DM as 90 ohm differential, 0.16/0.16 mm on L4 over L3.
* **Flatness callout (SPEC D3):** bow/twist <= 0.03 mm over y 0-20 mm (the beam band, x -6...68 incl. the end tabs), assembled board on a surface plate, 100 % inspected, reject above. IPC-6012 class 2 (0.75 %) would allow 0.55 mm: put this in the order remark and agree it before ordering; it may need a quote.
* **Copper balance:** copper is poured on all four layers in the beam band (y 0-20) on purpose; do not remove it.
* **Vias:** 0.40/0.20 mm signal vias, 0.45-0.50/0.20-0.25 mm GND/power vias; tented on **both** sides (no via opening in either mask gerber). The exceptions are the 64 electrode finger vias and the RX feed via: they sit inside the bottom electrode mask apertures, so they are open on the bottom and tented on top (no plugging needed; epoxy-filled + capped is acceptable if JLC prefers). **Order option: the 0.2 mm via hole** (432 vias have a 0.20 mm drill): JLC charges extra below 0.3 mm and is reported to add a 4-wire Kelvin test (caliper/docs/ordering.md §2).
* **Bottom side, beam band (y 0-20):** only U30 (AS5311) and C30/C31 are assembled there (<= 1.30 mm). The E40 electrode copper is bare (mask open per finger, no paste, no part).
* **Assembly: Standard PCBA, both sides** (Economic cannot build it: one side only, 0.5 mm minimum BGA pitch against U2's 0.4 mm DSBGA, standard stack-ups only). Standard needs edge rails, fiducials and >= 70 x 70 mm: order it panelised by JLCPCB (1 x 2, rails on the long sides) with no break-off tabs on the end tabs (x < 0, x > 62: clamp faces). Top = everything else; bottom = U30, C30, C31 (beam band) and C21, C23, R85, C44 (0402, under the module: its 3V3 decoupling and the ADC input's RC filter, upper band) and J2 (the battery's JST-SH receptacle, upper band, mouth toward the top edge; on the bottom since 2026-11-09 for the slim housing, SPEC 15); nothing else is placed on the bottom (the 19 test pads are bare). If two-sided assembly is not wanted, these eight can be hand-soldered (U30 is TSSOP-20, 0.65 mm pitch).
* **AS5311 supply:** U30 AS5311-ATST (LCSC C22459687): 80 pcs at LCSC on 2026-11-07, 75 in JLC's parts library on 2026-11-09 (USD 12.64 at 1-9). Check stock when ordering; if it is gone, order the board with U30 as DNP and consign/hand-fit the part (Mouser/DigiKey stock it as AS5311-ATST / AS5311-ATSU).
* **SMT M2 standoffs on H2-H5 (tab clamp holes, SPEC D3):** not in this BOM: fitted by hand (reflow or iron) on the top pads (PEM SMTSO-M2-2ET class, 2.0 mm tall, OD <= 4.0). The LCSC M2 SMT nuts (SMTSO20x0CTJ, e.g. C2915626) have a 5.6 mm base that overhangs the 6 mm tabs.
* **Not on the PCBA:** the LCD panel (plugs into J50 by hand), the LiPo (J2), the magnetic tape and the scale board.
