tyevco/prettycoolboards/caliper/hardware/fab/scale/ORDER-NOTES.md

# Order notes: prettycool-caliper-scale.kicad_pcb

(generated by caliper/hardware/design/release.py; do not edit)

Rev A is **designed, not built**: nothing here has been fabricated, assembled or measured.

* DRC/parity gate (kicad-cli 10.0.8, errors only): ** Found 0 DRC violations **; ** Found 0 unconnected pads **; ** Found 0 Footprint errors **
* Do not place (DNP): none
* Not assembled, not in BOM/CPL (copper / mechanical only): FID1, FID2, H1, H2
* Bottom-side placements (0): none
* **jlcplace 0.2.1 placement gate** (JLC's EasyEDA footprints put down at every CPL row, over gerbers.zip): 0 results: 0 red, 0 yellow, 0 green, 0 verified
  * no parts, no CPL: checked with an empty CPL (not shipped), so nothing on the board needs placing and gerbers.zip is this board's, plotted from the CPL origin
  * origin: the Gerbers' (0, 0) is this CPL's origin, board (100, 100) (the aux (drill/place file) origin): the rows were checked from it, as JLC reads them
* JLC placement preview checklist (jlcplace-checklist.md): nothing to check
* **PCB:** 2 layers, **0.8 mm**, ENIG, 200 x 7 mm. **No solder mask on the front (F) side at all**: the whole front is one mask opening over the reflector pattern (bare ENIG copper is the electrode face). Back: solid copper under green mask, white silk on the back only.
* **No assembly.** No BOM, no CPL. Two Ø1.0 non-plated alignment holes (pin jig for bonding), two fiducials.
* **Front copper is 38 isolated islands (no net) by design**: tell JLC's DFM review the floating copper is intended (it is a passive capacitive reflector scale).
* **Flatness:** the scale is bonded flush into the beam pocket with 3M 467MP; ask for the standard bow/twist and inspect; the pocket and adhesive take up <= 0.05 mm.
* **Panelising:** 200 mm is inside JLC's standard size; order as a single board (no V-cut near the pattern).
