tyevco/prettycoolboards/caliper/hardware/fab/slider/prettycool-caliper-slider-BOM-JLCPCB.csv

Comment | Designator | Footprint | LCSC Part # | MPN | Qty
PKMCS0909E4000-R1 | BZ50 | Buzzer_Murata_PKMCS0909E | C910763 | PKMCS0909E4000-R1 | 1
2.2u/25V | C1 | C_0805_2012Metric | C277470 | CC0805KKX7R8BB225 | 1
10u/25V | C2 | C_0603_1608Metric | C96446 | CL10A106MA8NRNC | 1
4.7u | C3 | C_0603_1608Metric | C19666 | CL10A475KO8NNNC | 1
10u | C4,C61 | C_0603_1608Metric | C19702 | CL10A106KP8NNNC | 2
22u | C5,C6,C20 | C_0603_1608Metric | C59461 | CL10A226MQ8NRNC | 3
100n | C7,C21,C30,C42,C51,C52,C53,C54,C55,C60,C62,C64,C66 | C_0402_1005Metric | C1525 | CL05B104KO5NNNC | 13
1u | C8,C10,C12,C13,C22,C31,C41,C50 | C_0402_1005Metric | C52923 | CL05A105KA5NQNC | 8
1n | C9,C11,C43 | C_0402_1005Metric | C1523 | 0402B102K500NT | 3
10u/6.3V | C23,C65 | C_0402_1005Metric | C15525 | CL05A106MQ5NUNC | 2
10p C0G | C40 | C_0402_1005Metric | C1545 | 0402CG100J500NT | 1
100p C0G | C44 | C_0402_1005Metric | C1546 | 0402CG101J500NT | 1
220n | C63 | C_0402_1005Metric | C16772 | CL05B224KO5NNNC | 1
SMF5.0A | D1 | D_SMF | C151296 | SMF5.0A | 1
WS2812B-2020-V6 | D50 | LED_WS2812B-2020_PLCC4_2.0x2.0mm | C52917434 | WS2812B-2020-V6 | 1
TYPE-C-31-M-12 | J1 | USB_C_Receptacle_HRO_TYPE-C-31-M-12 | C165948 | TYPE-C-31-M-12 | 1
BATT | J2 | JST_SH_SM02B-SRSS-TB_1x02-1MP_P1.00mm_Horizontal | C160402 | SM02B-SRSS-TB(LF)(SN) | 1
LCD_FPC | J50 | HDGC_0.5K-AX-13PWB_1x13-1MP_P0.50mm_Horizontal | C2911931 | 0.5K-AX-13PWB | 1
0.47u | L1 | L_Murata_DFE201610P | C668312 | DFE201612E-R47M=P2 | 1
AO3401A | Q1 | SOT-23 | C15127 | AO3401A | 1
AO3400A | Q50,Q51 | SOT-23 | C20917 | AO3400A | 2
5.1k | R1,R2 | R_0402_1005Metric | C25905 | 0402WGF5101TCE | 2
511k | R3 | R_0402_1005Metric | C64042 | 0402WGF5113TCE | 1
91k | R4 | R_0402_1005Metric | C4147 | 0402WGF9102TCE | 1
100k | R5,R51,R52,R53,R54,R55,R56,R82,R83 | R_0402_1005Metric | C25741 | 0402WGF1003TCE | 9
2.2k | R6,R7 | R_0402_1005Metric | C25879 | 0402WGF2201TCE | 2
10k | R8,R9,R10,R20,R21,R30,R31 | R_0402_1005Metric | C25744 | 0402WGF1002TCE | 7
15 | R50 | R_0603_1608Metric | C22810 | 0603WAF150JT5E | 1
1k | R57 | R_0402_1005Metric | C11702 | 0402WGF1001TCE | 1
0R | R60,R61,R62,R63,R64,R65,R66,R67,R80 | R_0402_1005Metric | C17168 | 0402WGF0000TCE | 9
100 | R70,R71,R72,R73,R74,R75,R76,R77 | R_0402_1005Metric | C25076 | 0402WGF1000TCE | 8
10M | R81 | R_0402_1005Metric | C26082 | 0402WGF1005TCE | 1
390 | R84 | R_0402_1005Metric | C25109 | 0402WGF3900TCE | 1
3.9k | R85 | R_0402_1005Metric | C51721 | 0402WGF3901TCE | 1
10k B3435 | RT1 | R_0402_1005Metric | C77131 | NCP15XH103F03RC | 1
BOOT | SW20 | SW_SPST_TS-1088-xR020 | C720477 | TS-1088-AR02016 | 1
ZERO | SW50 | SW_SPST_TS-1088-xR020 | C720477 | TS-1088-AR02016 | 1
HOLD | SW51 | SW_SPST_TS-1088-xR020 | C720477 | TS-1088-AR02016 | 1
MODE | SW52 | SW_SPST_TS-1088-xR020 | C720477 | TS-1088-AR02016 | 1
USBLC6-2SC6 | U1 | SOT-23-6 | C7519 | USBLC6-2SC6 | 1
BQ25180YBGR | U2 | Texas_DSBGA-8_1.04x1.59mm_Layout2x4_P0.4mm_YBG0008 | C3682423 | BQ25180YBGR | 1
TPS63802DLAR | U3 | Texas_DLA0010A_VSON-HR-10_2x3mm_P0.5mm | C2845237 | TPS63802DLAR | 1
MAX17048G+T10 | U4 | TDFN-8-1EP_2x2mm_P0.5mm_EP0.8x1.2mm | C2682616 | MAX17048G+T10 | 1
TPS22917DBVR | U5,U6 | SOT-23-6 | C2681320 | TPS22917DBVR | 2
ESP32-S3-MINI-1-N4R2 | U10 | ESP32-S2-MINI-1 | C3013941 | ESP32-S3-MINI-1-N4R2 | 1
AS5311-ATST | U30 | TSSOP-20_4.4x6.5mm_P0.65mm | C22459687 | AS5311-ATST | 1
TLV9062IDGKR | U40 | VSSOP-8_3x3mm_P0.65mm | C398356 | TLV9062IDGKR | 1
LSM6DSOTR | U60 | LGA-14_3x2.5mm_P0.5mm_LayoutBorder3x4y | C2655100 | LSM6DSOTR | 1
IIS2MDCTR | U61 | LGA-12_2x2mm_P0.5mm | C2655002 | IIS2MDCTR | 1
