tyevco/prettycoolboards/public/caliper/gallery/img/parts.png

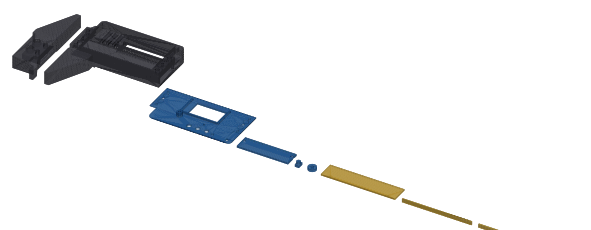
public/caliper/gallery/img/parts.png
