tyevco/prettycoolboards/caliper/hardware/mechanical/step/caliper_assembly.step

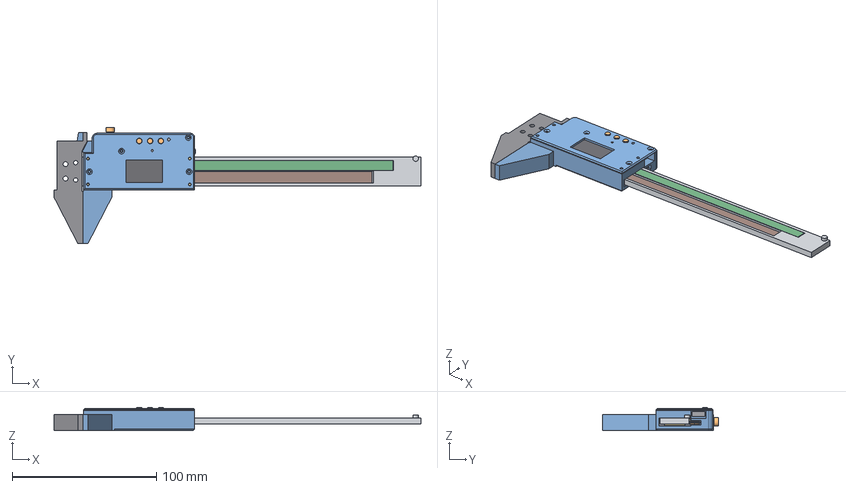
[picture p33: CAD file, 2026-11-10]
caliper/hardware/mechanical/step/caliper_assembly.step
254.0 x 80.4 x 16.0 mm
beam
fixed_jaw
tape
scale_pcb
stop_screw
slider_body
front_shell
battery_door
button_cap_ZERO
button_cap_HOLD
button_cap_MODE
thumb_roller
oring
back_gib
y_gib
ref_strip
front_pad_0
front_pad_1
front_pad_2
front_pad_3
pusher_tip_u14
pusher_u14
pusher_tip_u24
pusher_u24
pusher_lock_u19
lock_screw
y_set_screw_u14
y_set_screw_u24
board
board_parts
display
battery
tab_clamp_0
tab_clamp_1
tab_clamp_2
tab_clamp_3
tab_clamp_4
tab_clamp_5
tab_clamp_6
tab_clamp_7
plunger_hw_0
plunger_hw_1
plunger_hw_2
plunger_hw_3
