tyevco/prettycoolboards/caliper/hardware/mechanical/stl/slider_body_rf_modifier.stl

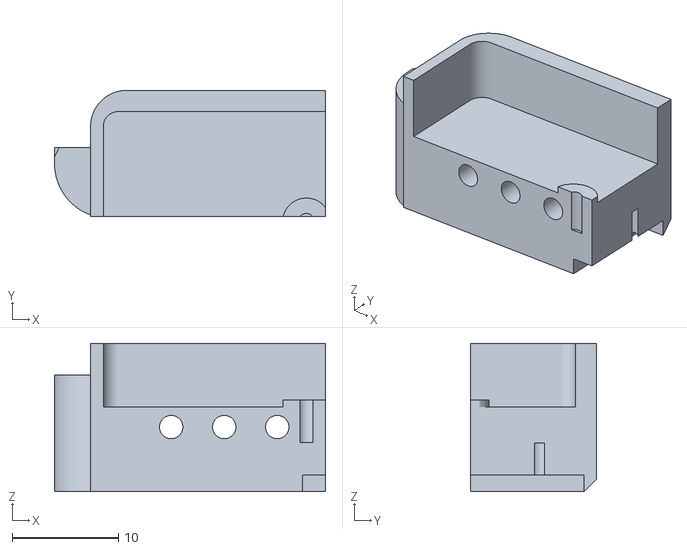
[picture p34: CAD file, 2026-11-10]
caliper/hardware/mechanical/stl/slider_body_rf_modifier.stl
25.5 x 11.9 x 14.0
