tyevco/prettycoolboards/caliper/hardware/mechanical/step/beam_pockets.step

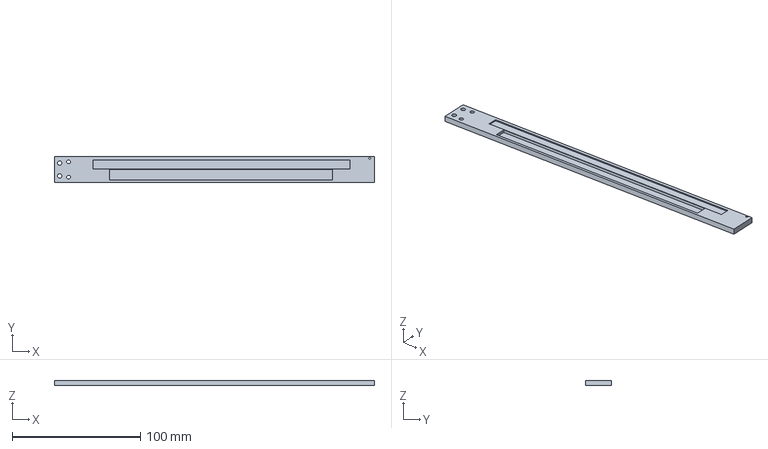
[picture p35: CAD file, 2026-11-10]
caliper/hardware/mechanical/step/beam_pockets.step
250.0 x 20.0 x 4.00 mm
