tyevco/prettycoolboards/caliper/hardware/mechanical/step/slider_body_b.step

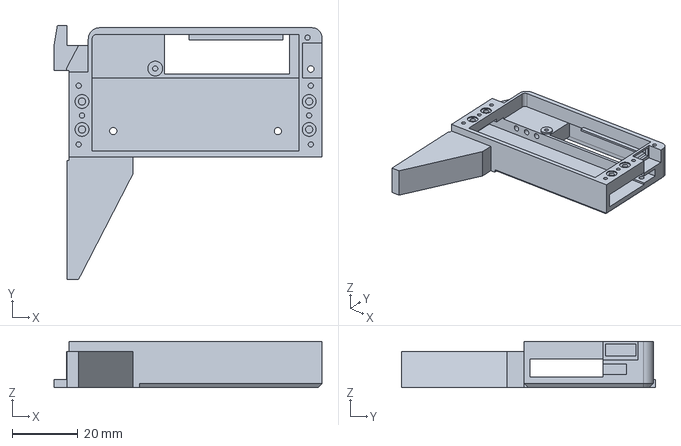
[picture p36: CAD file, 2026-11-10]
caliper/hardware/mechanical/step/slider_body_b.step
81.4 x 77.0 x 14.0 mm
