tyevco/prettycoolboards/caliper/hardware/mechanical/step/button_cap.step

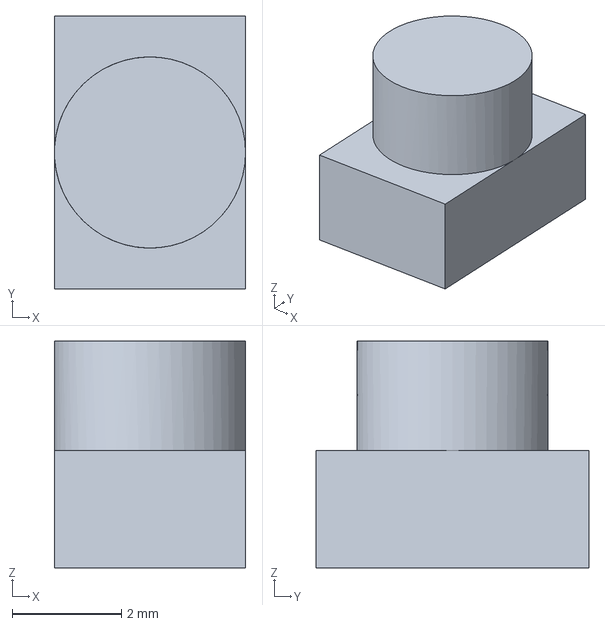
[picture p37: CAD file, 2026-11-10]
caliper/hardware/mechanical/step/button_cap.step
3.50 x 5.00 x 4.15 mm
