tyevco/prettycoolboards/caliper/hardware/mechanical/step/front_shell.step

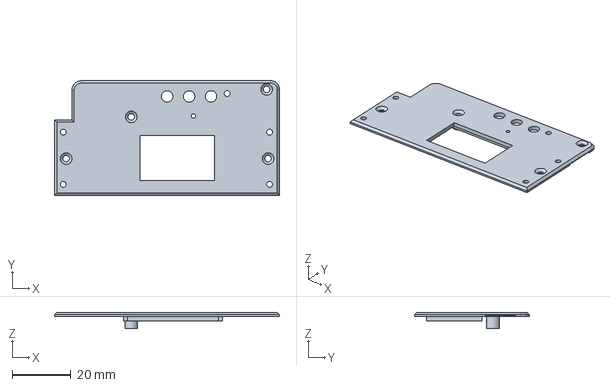
[picture p38: CAD file, 2026-11-10]
caliper/hardware/mechanical/step/front_shell.step
76.9 x 39.2 x 5.55 mm
