tyevco/prettycoolboards/caliper/hardware/mechanical/step/front_pad.step

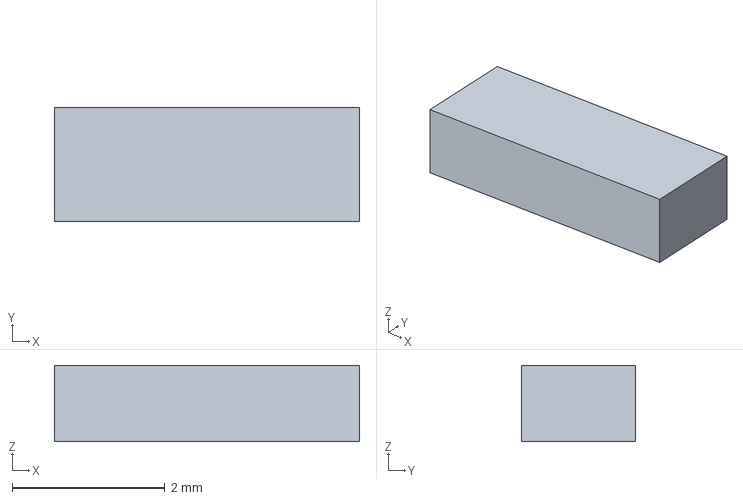
[picture p39: CAD file, 2026-11-10]
caliper/hardware/mechanical/step/front_pad.step
4.00 x 1.50 x 1.00 mm
