tyevco/prettycoolboards/caliper/hardware/mechanical/step/y_gib.step

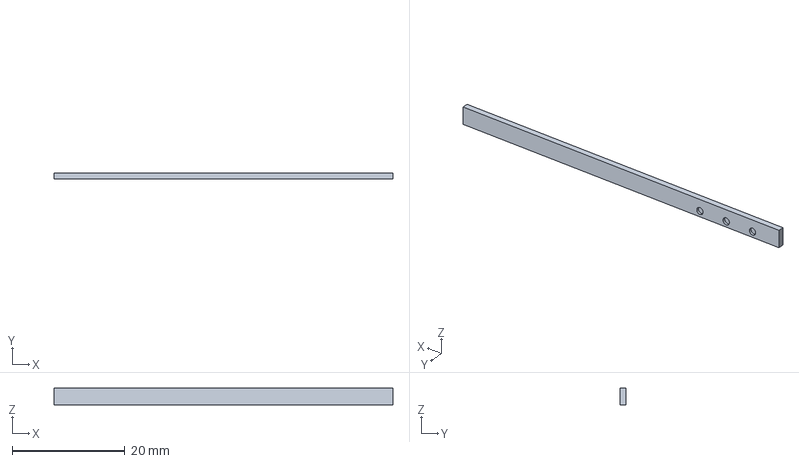
[picture p40: CAD file, 2026-11-10]
caliper/hardware/mechanical/step/y_gib.step
60.0 x 1.00 x 3.00 mm
