tyevco/prettycoolboards/caliper/hardware/mechanical/step/fixed_jaw.step

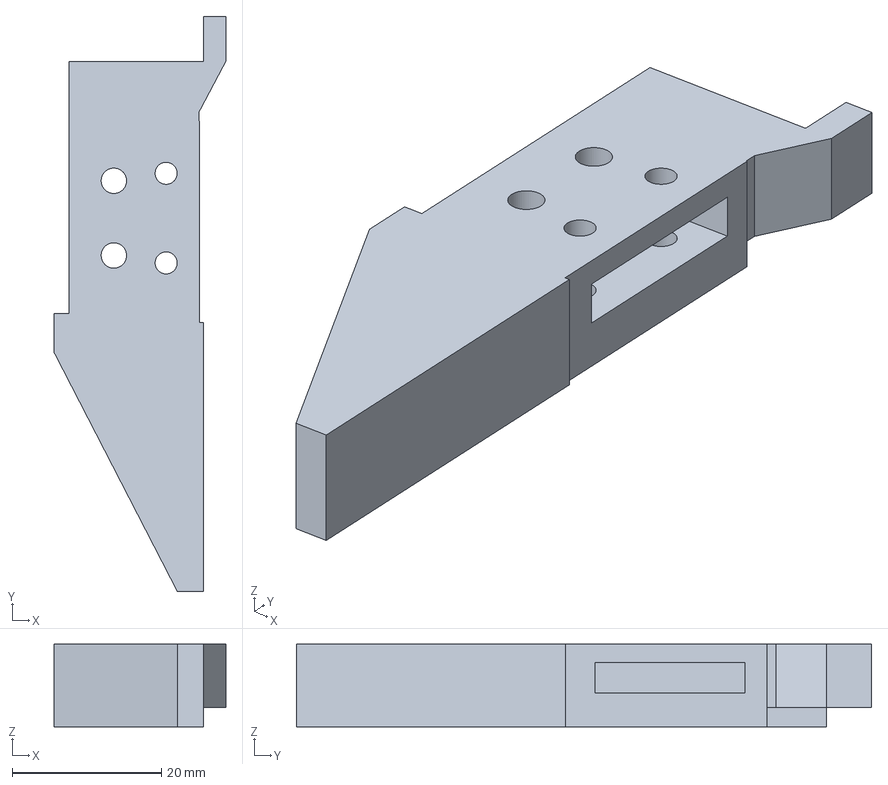
[picture p41: CAD file, 2026-11-10]
caliper/hardware/mechanical/step/fixed_jaw.step
23.0 x 77.0 x 11.1 mm
