tyevco/prettycoolboards/caliper/hardware/mechanical/step/back_gib.step

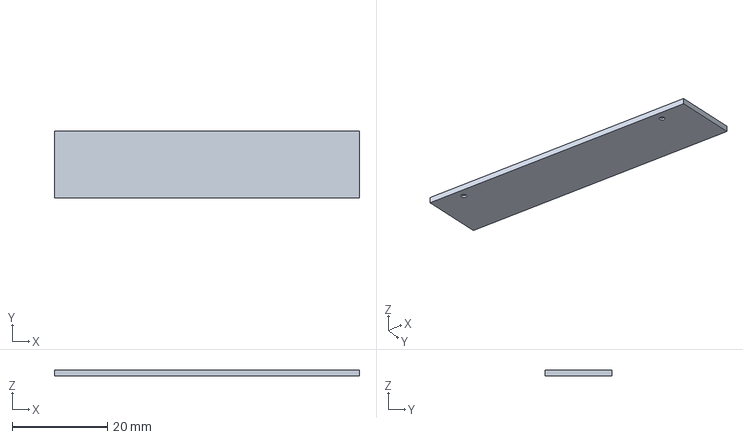
[picture p42: CAD file, 2026-11-10]
caliper/hardware/mechanical/step/back_gib.step
64.0 x 14.0 x 1.20 mm
