tyevco/prettycoolboards/caliper/hardware/mechanical/step/ref_strip.step

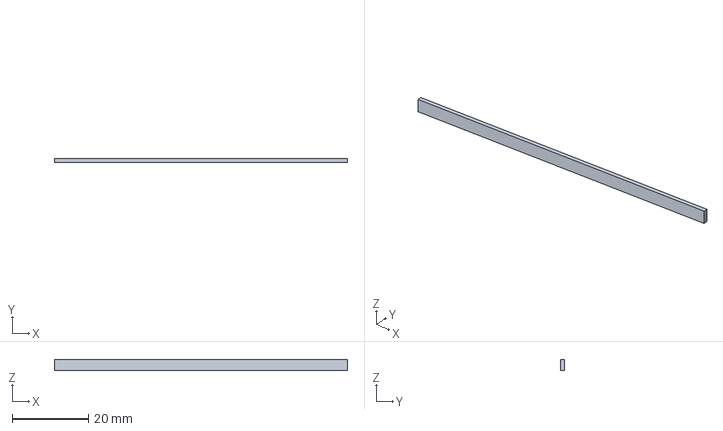
[picture p43: CAD file, 2026-11-10]
caliper/hardware/mechanical/step/ref_strip.step
76.9 x 1.00 x 3.00 mm
