tyevco/prettycoolboards/caliper/hardware/mechanical/step/thumb_roller.step

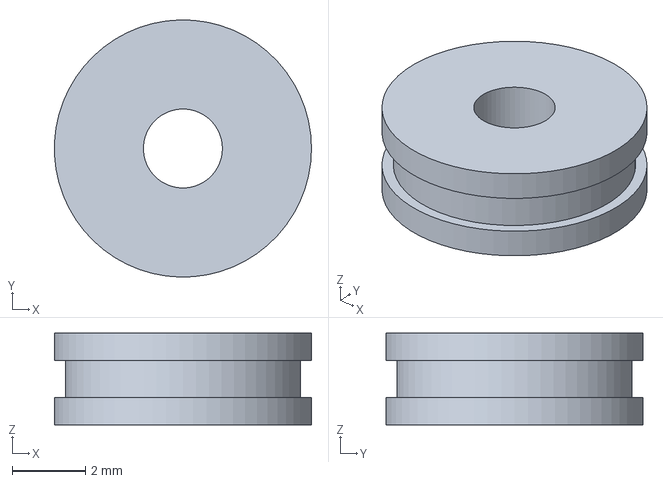
[picture p44: CAD file, 2026-11-10]
caliper/hardware/mechanical/step/thumb_roller.step
7.00 x 7.00 x 2.50 mm
