tyevco/prettycoolboards/caliper/hardware/mechanical/step/battery_door.step

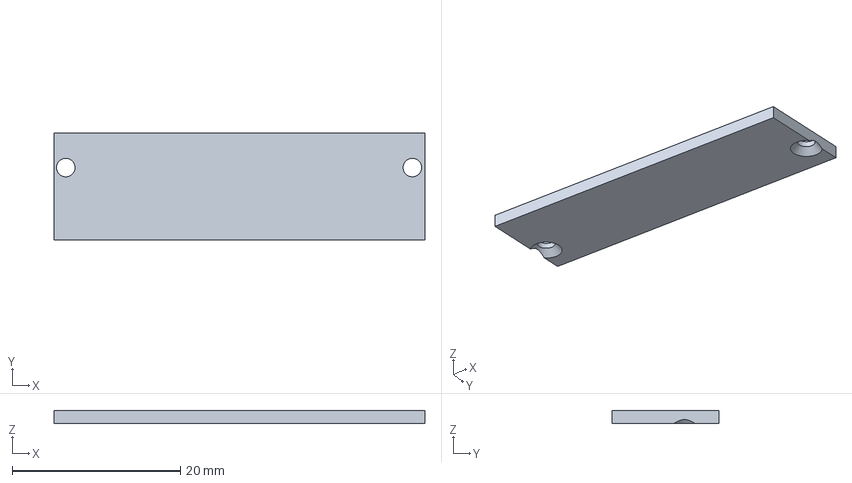
[picture p45: CAD file, 2026-11-10]
caliper/hardware/mechanical/step/battery_door.step
44.1 x 12.7 x 1.60 mm
