tyevco/prettycoolboards/(list of files, cad)

Other CAD files:
caliper/hardware/mechanical/step/beam.step
caliper/hardware/mechanical/step/slider_body.step
caliper/hardware/mechanical/stl/back_gib.stl
caliper/hardware/mechanical/stl/battery_door.stl
caliper/hardware/mechanical/stl/beam.stl
caliper/hardware/mechanical/stl/button_cap.stl
caliper/hardware/mechanical/stl/fixed_jaw.stl
caliper/hardware/mechanical/stl/front_pad.stl
caliper/hardware/mechanical/stl/front_shell.stl
caliper/hardware/mechanical/stl/ref_strip.stl
caliper/hardware/mechanical/stl/slider_body.stl
caliper/hardware/mechanical/stl/slider_body_b.stl
caliper/hardware/mechanical/stl/thumb_roller.stl
caliper/hardware/mechanical/stl/y_gib.stl
