tyevco/prettycoolboards/public/caliper/gallery/img/assembly.png

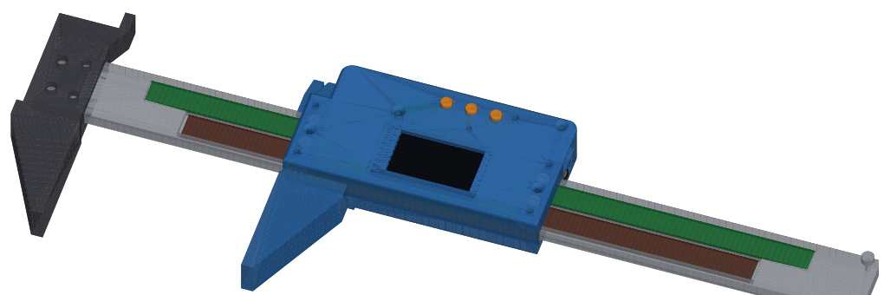
public/caliper/gallery/img/assembly.png
