tyevco/prettycoolboards/public/caliper/gallery/img/assembly_back.png

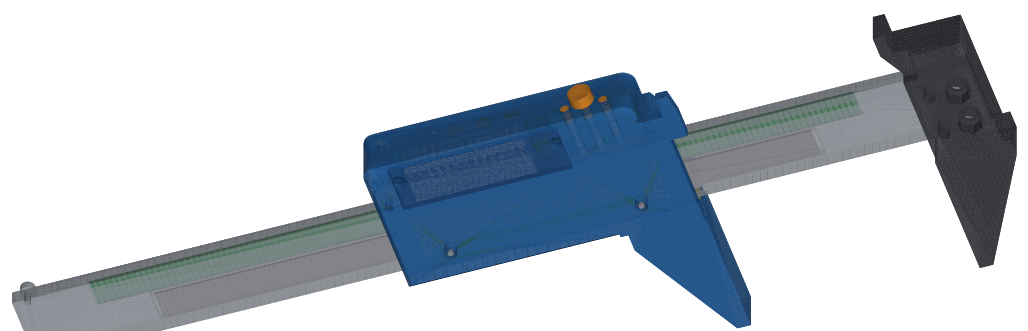
public/caliper/gallery/img/assembly_back.png
