tyevco/prettycoolboards/caliper/hardware/fab/slider/prettycool-caliper-slider-B_Cu.pdf

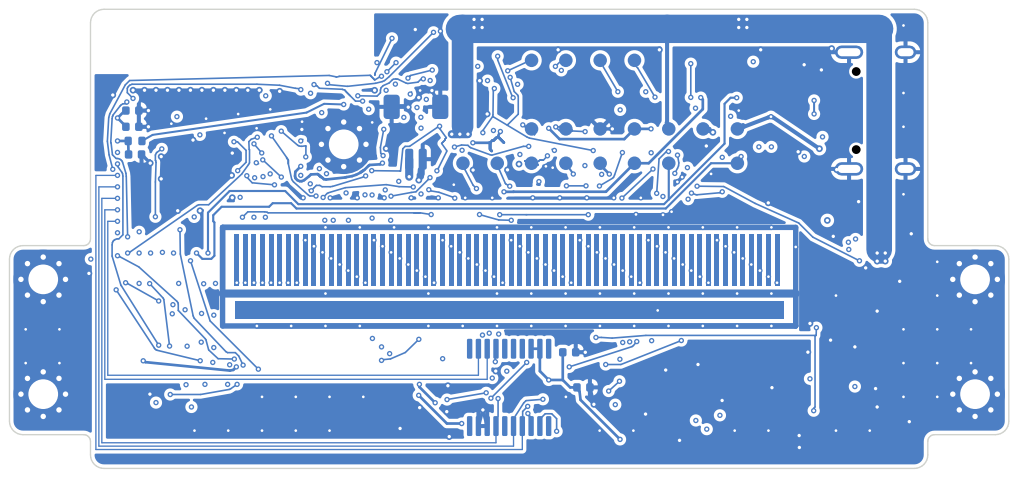
[picture p48: page 1]

Sheet:
File: prettycool-caliper-slider.kicad_pcb
Title:

Size: A4 | Rev:
KiCad E.D.A. 10.0.8 | Id: 1/1
