tyevco/prettycoolboards/caliper/hardware/fab/slider/prettycool-caliper-slider-bottom.pdf

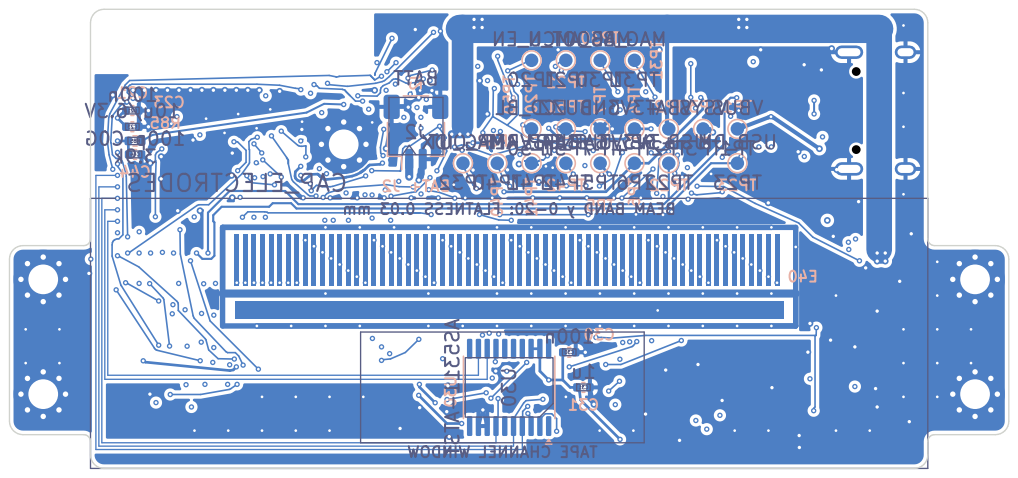
[picture p49: page 1]

TP3 WINDOW CHANNEL TAPE mm 0.03 FLATNESS 0-20: y BAND BEAM 10u/6.3V C23 MAG_IDX

Sheet:
File: prettycool-caliper-slider.kicad_pcb
Title:

Size: A4 | Rev:
KiCad E.D.A. 10.0.8 | Id: 1/1
