tyevco/prettycoolboards/caliper/hardware/fab/scale/prettycool-caliper-scale-B_Cu.pdf

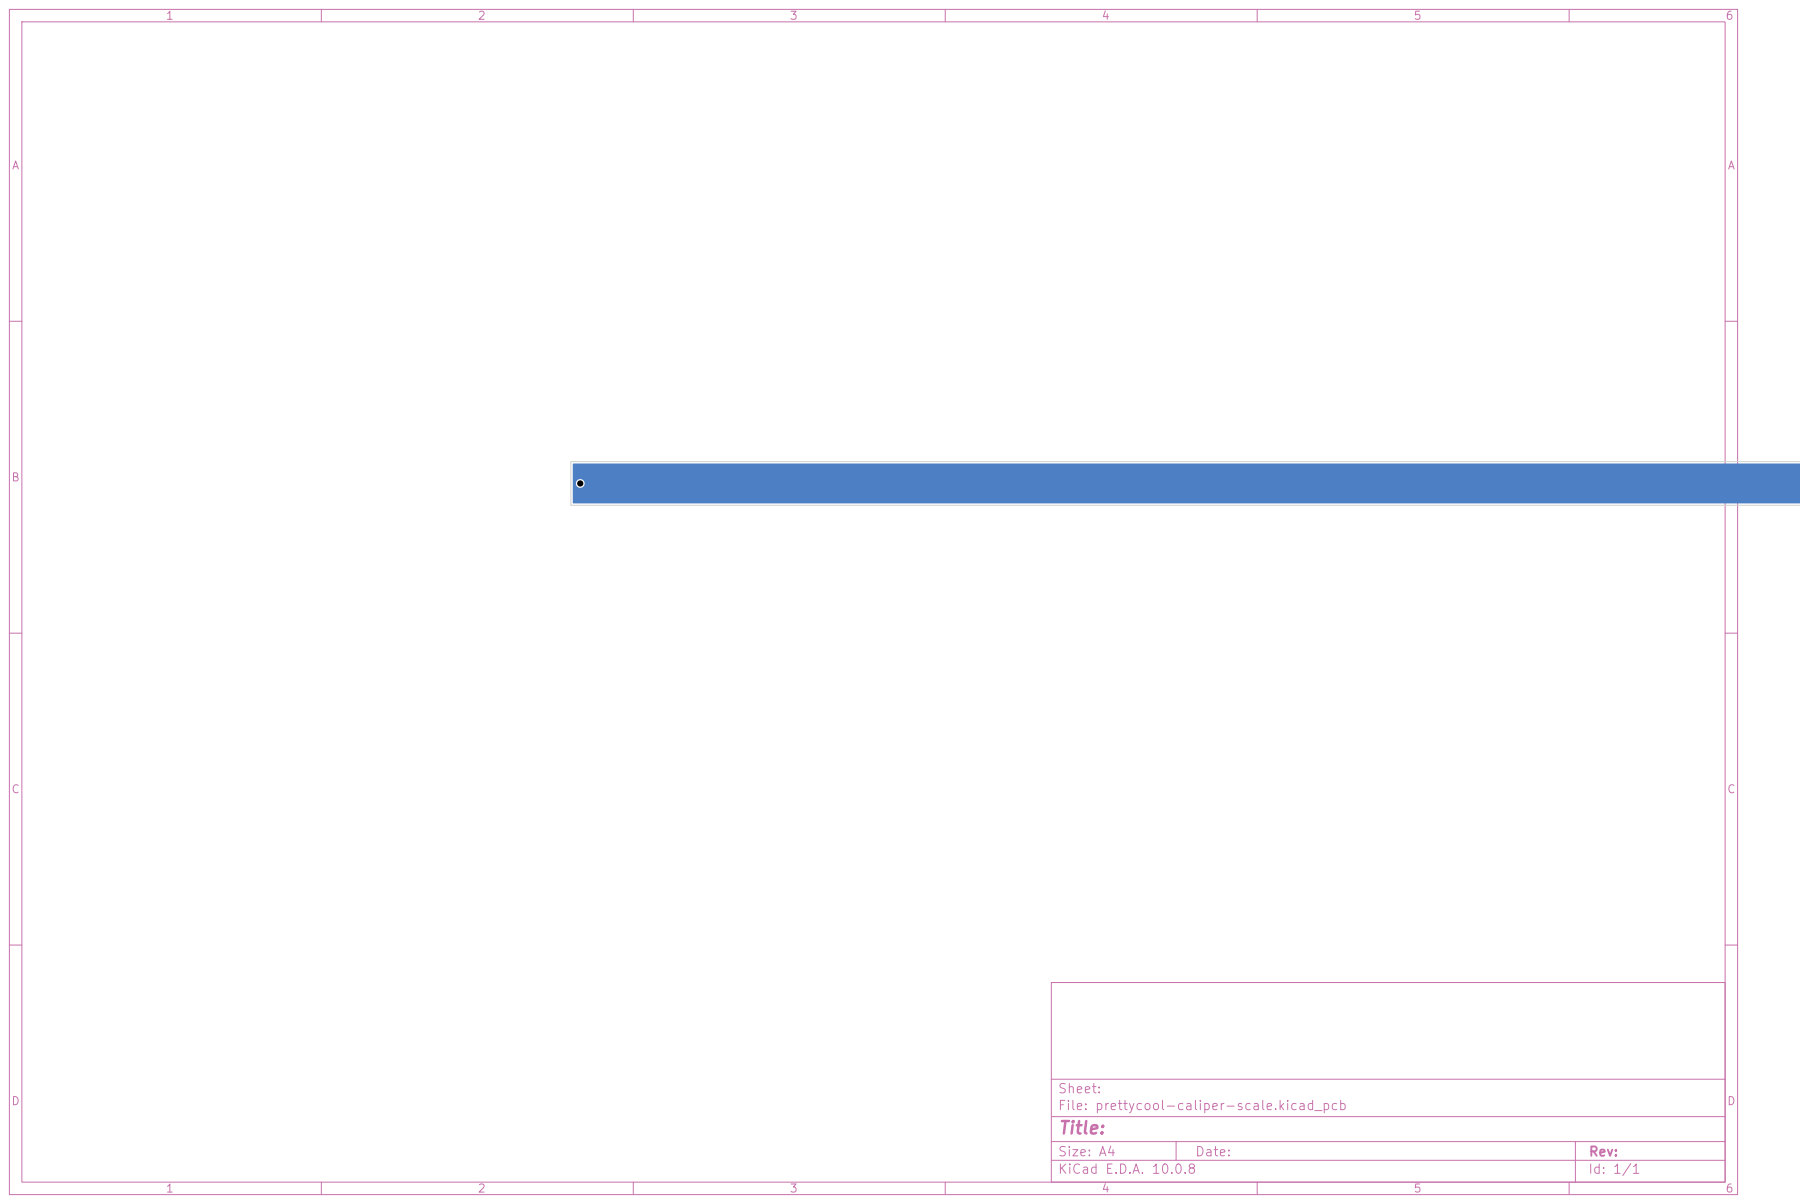
[picture p57: page 1]

Sheet:
File: prettycool-caliper-scale.kicad_pcb
Title:

Size: A4 | Rev:
KiCad E.D.A. 10.0.8 | Id: 1/1
