tyevco/prettycoolboards/caliper/hardware/fab/scale/prettycool-caliper-scale-schematic.pdf

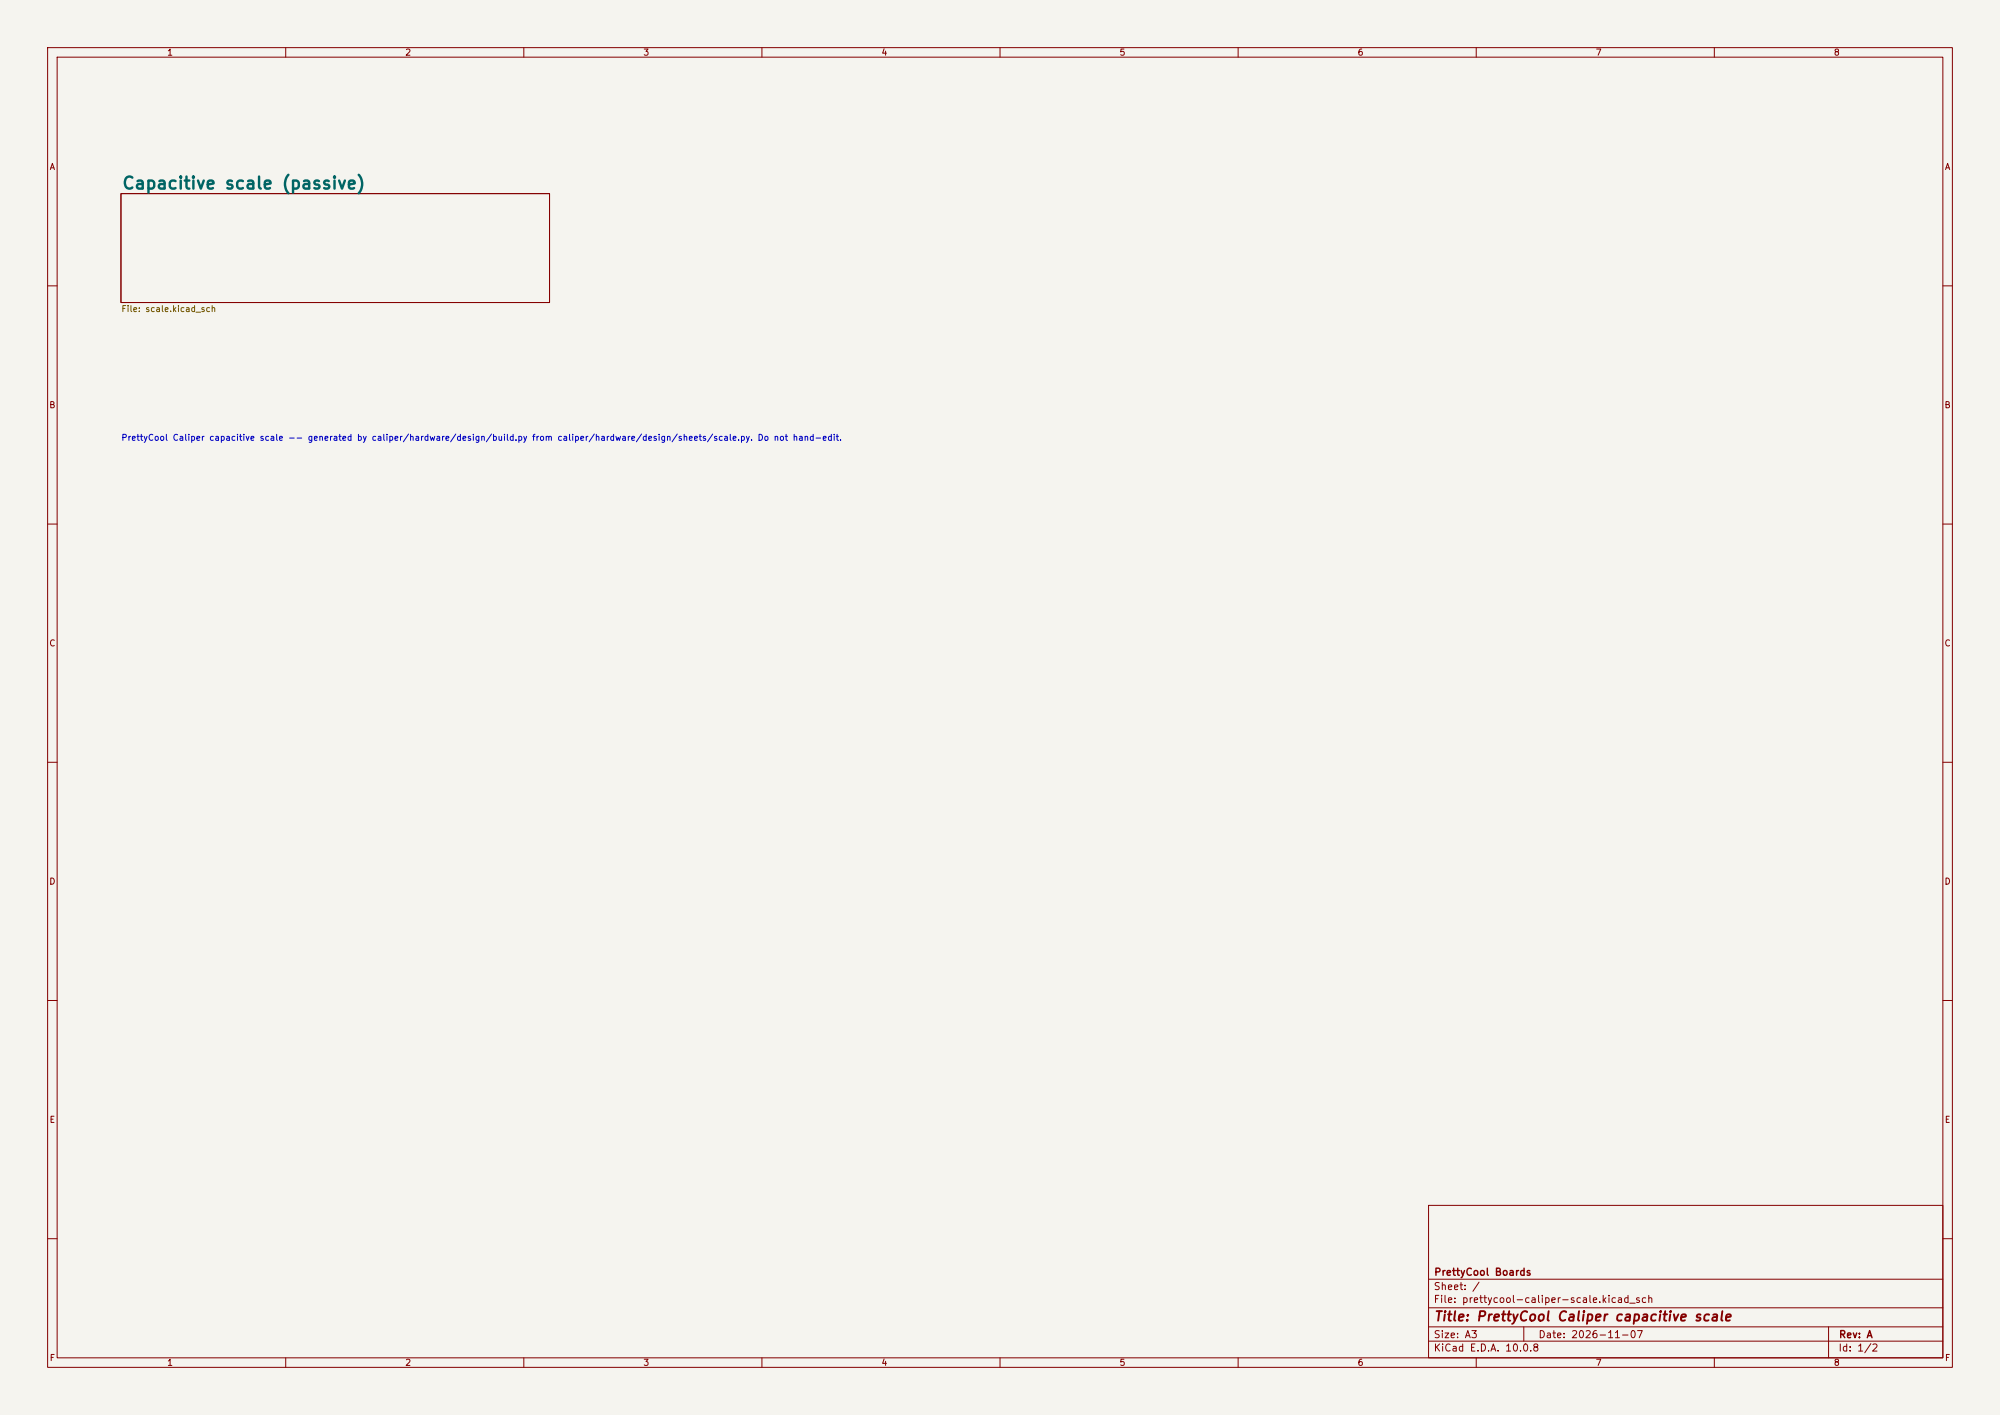
[picture p58: page 1]

File: scale.kicad_sch PrettyCool Caliper capacitive scale -- generated by caliper/hardware/design/build.py from caliper/hardware/design/sheets/scale.py. Do not hand-edit.

PrettyCool Boards
Sheet: /
File: prettycool-caliper-scale.kicad_sch
Title: PrettyCool Caliper capacitive scale

Size: A3 | Rev: A | F Date: 2026-11-07
KiCad E.D.A. 10.0.8 | Id: 1/2

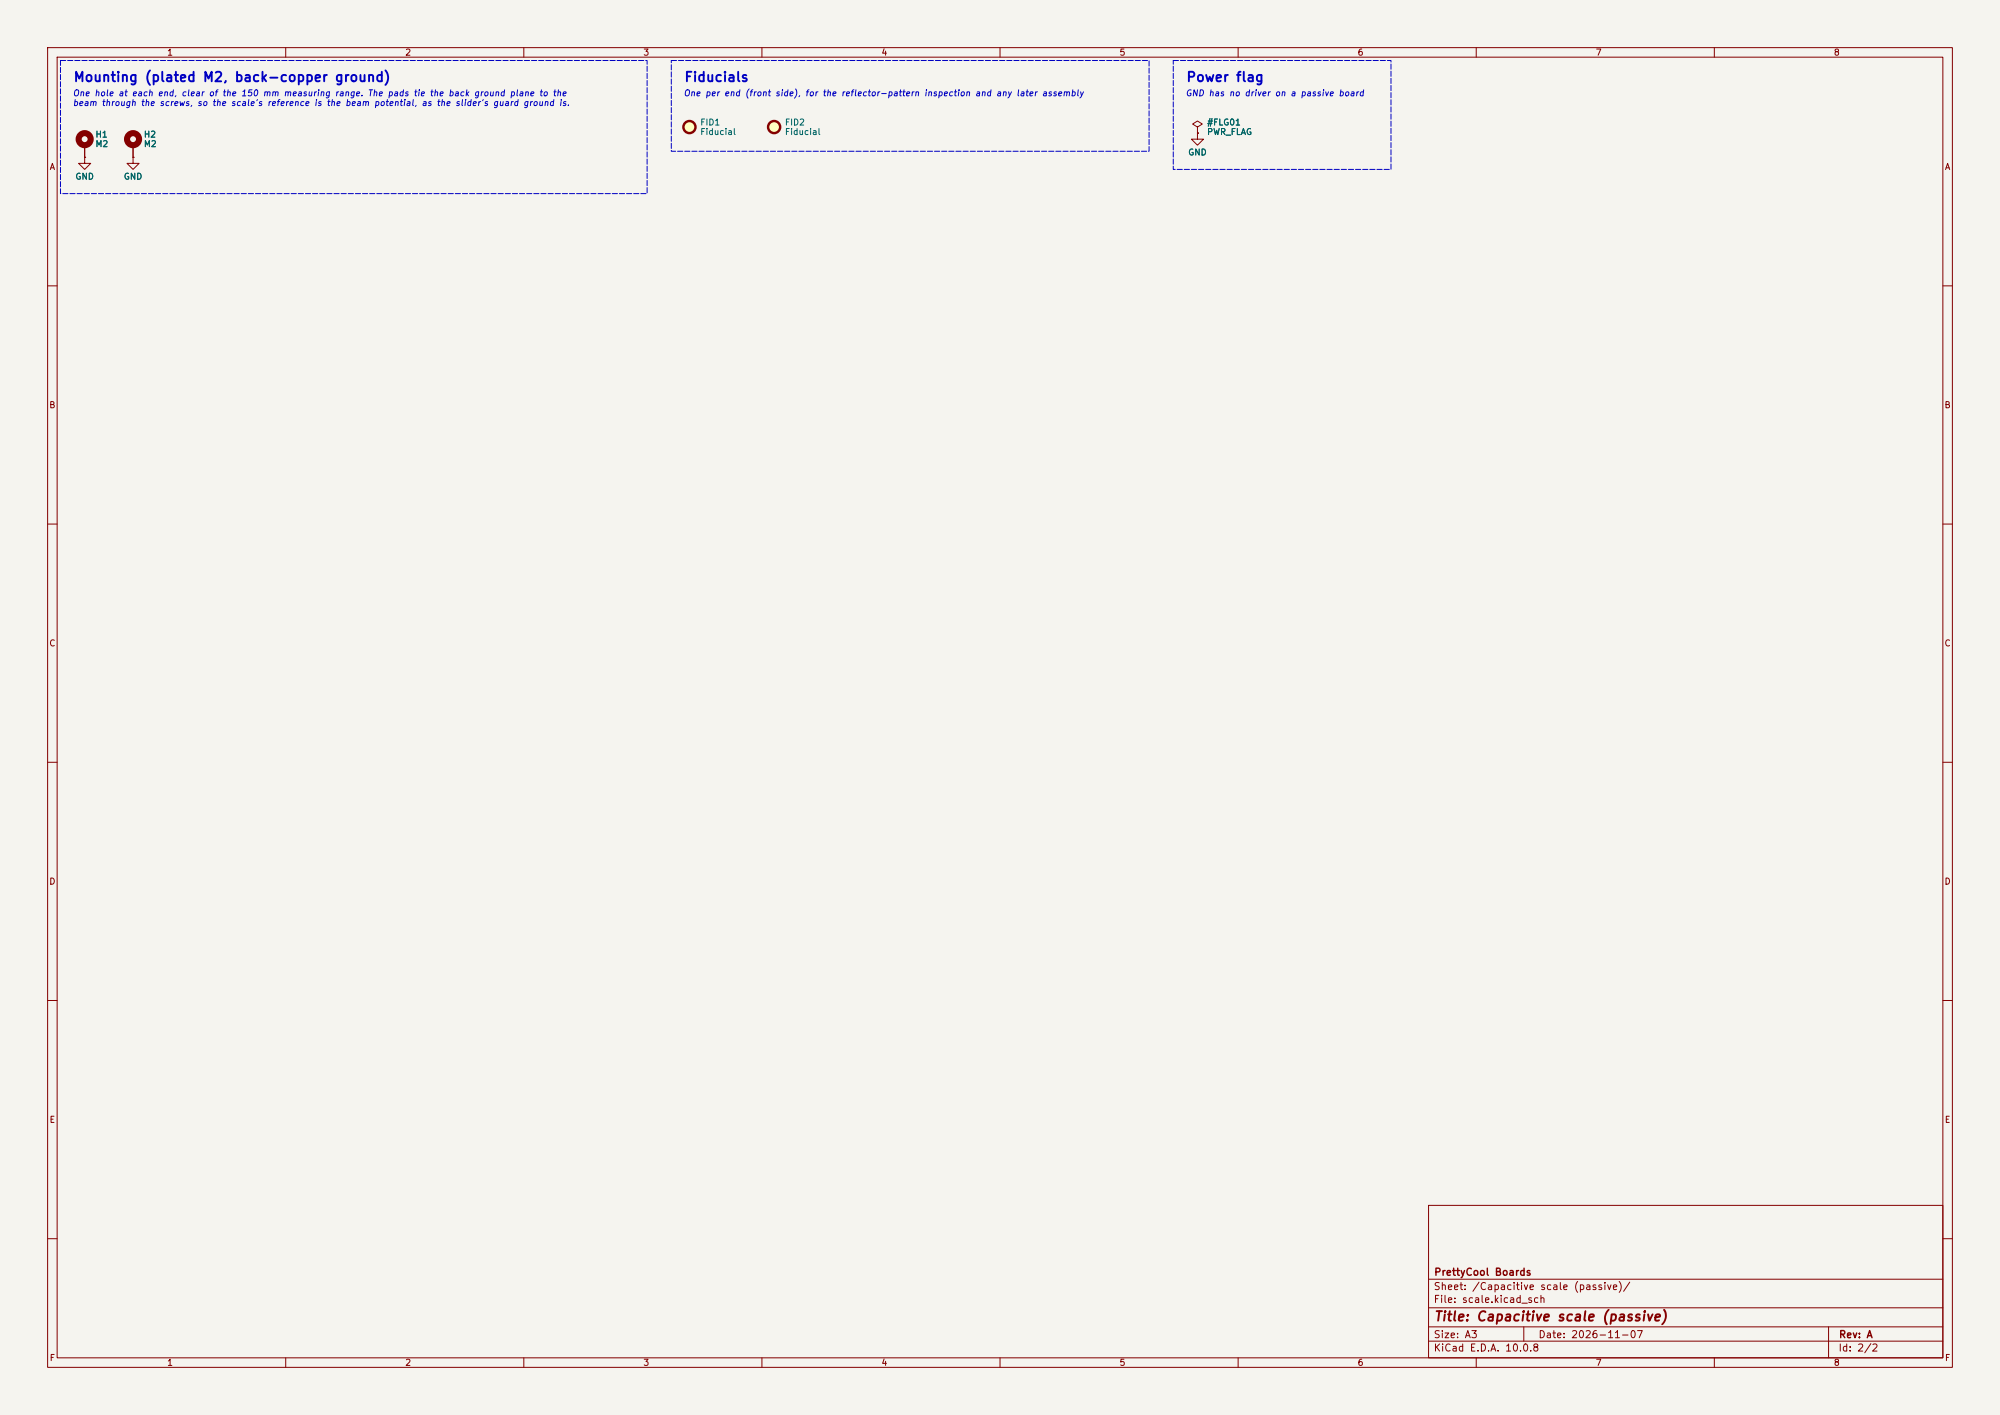
[picture p59: page 2]

GND has no driver on a passive board Fiducials
One per end (front side), for the reflector-pattern inspection and any later assembly

PrettyCool Boards
Sheet: /Capacitive scale (passive)/
File: scale.kicad_sch
Title: Capacitive scale (passive)

Size: A3 | Rev: A | F Date: 2026-11-07
KiCad E.D.A. 10.0.8 | Id: 2/2
