tyevco/prettycoolboards/caliper/hardware/mechanical/drawings/beam_pockets.pdf

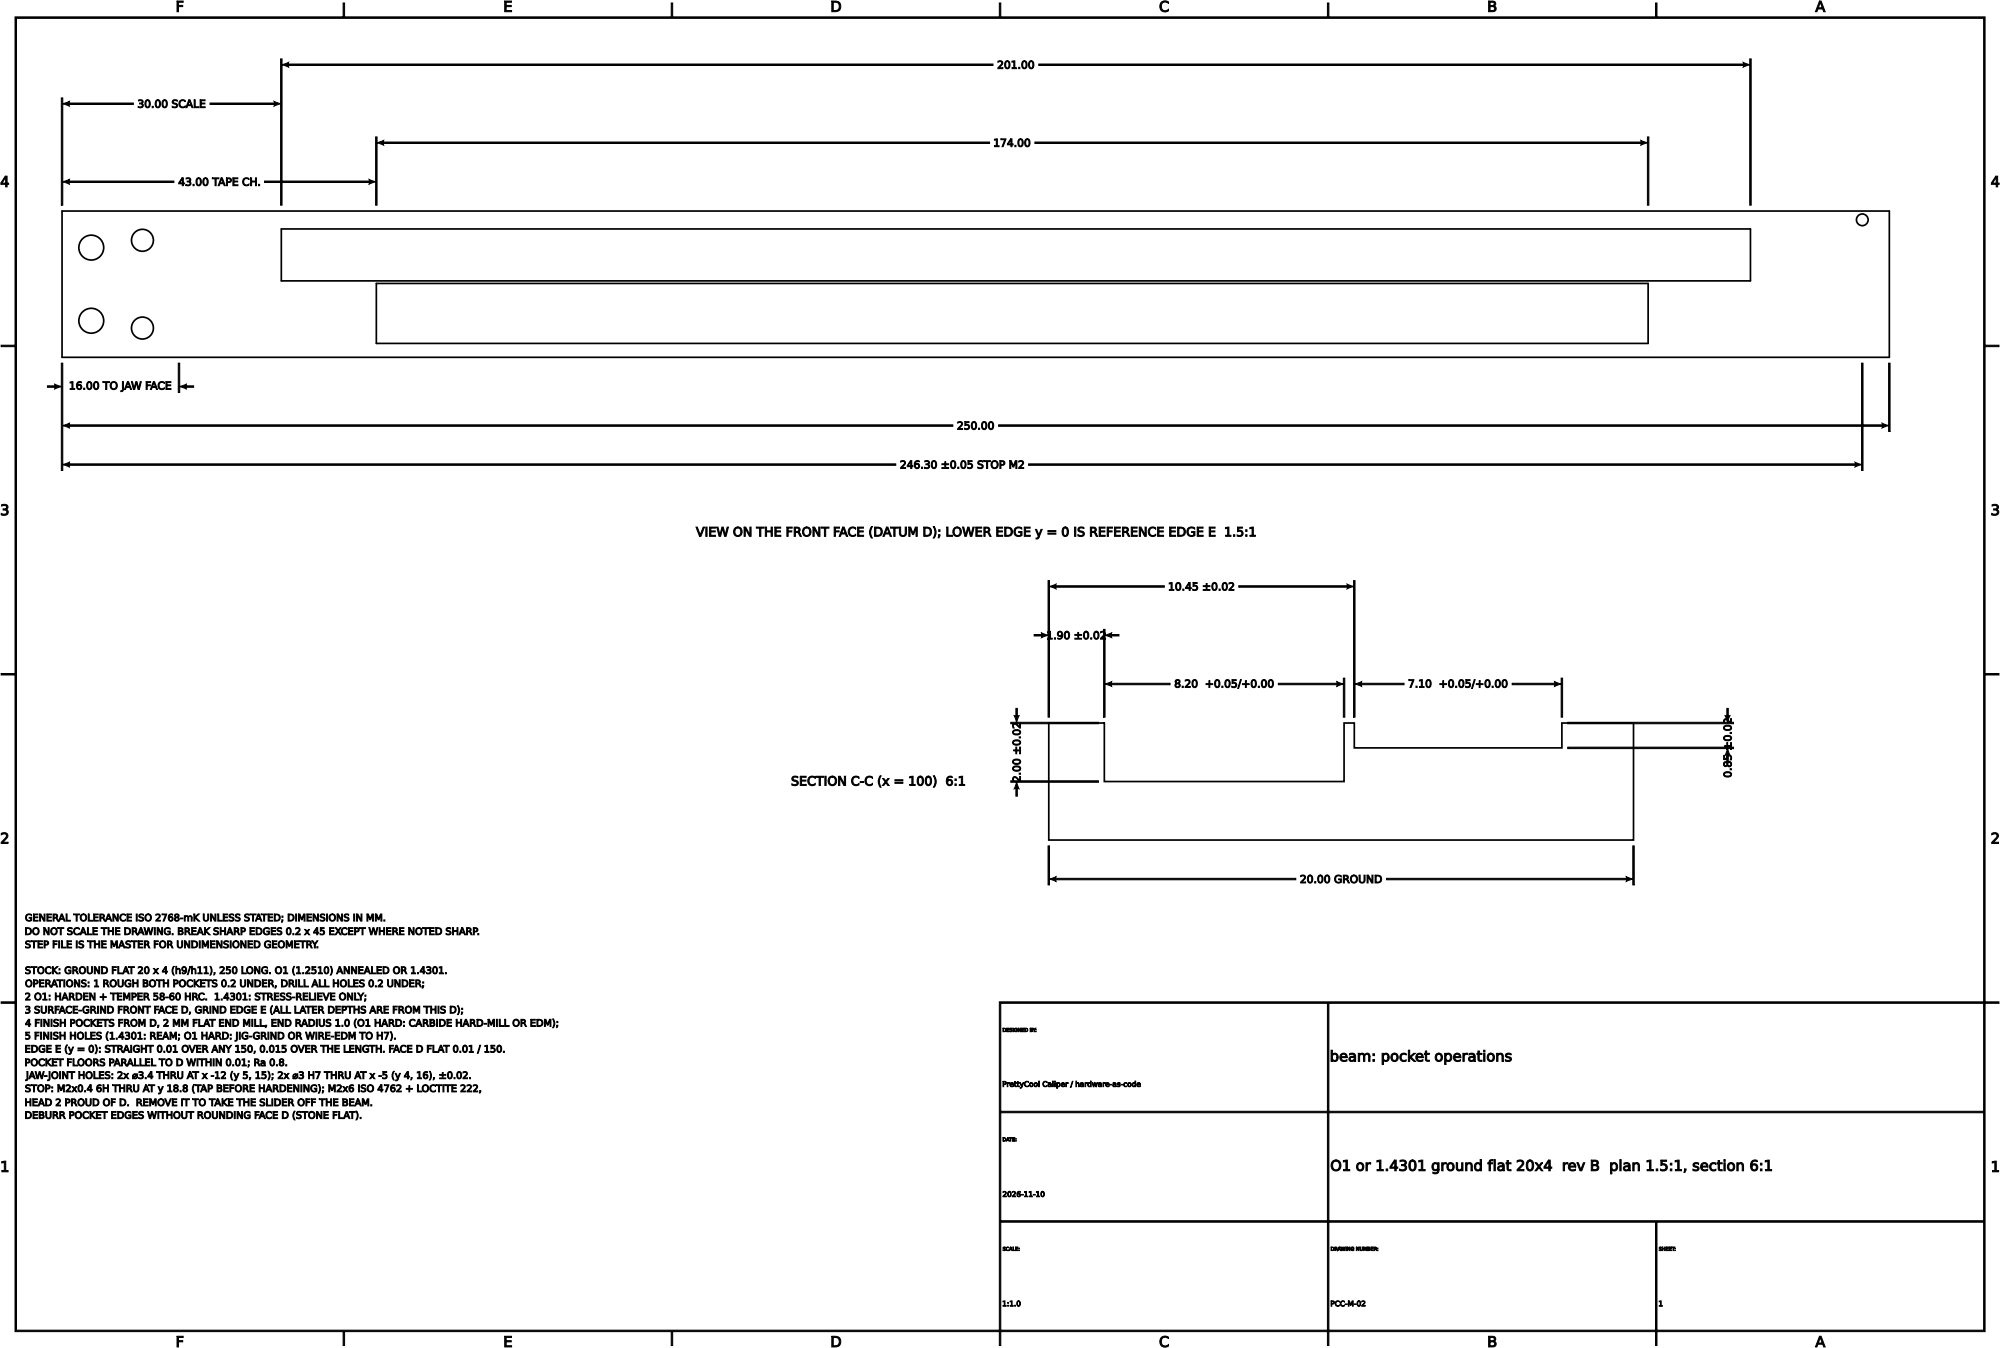
[picture p60: page 1]
