tyevco/prettycoolboards/caliper/hardware/mechanical/drawings/slider_body_b.pdf

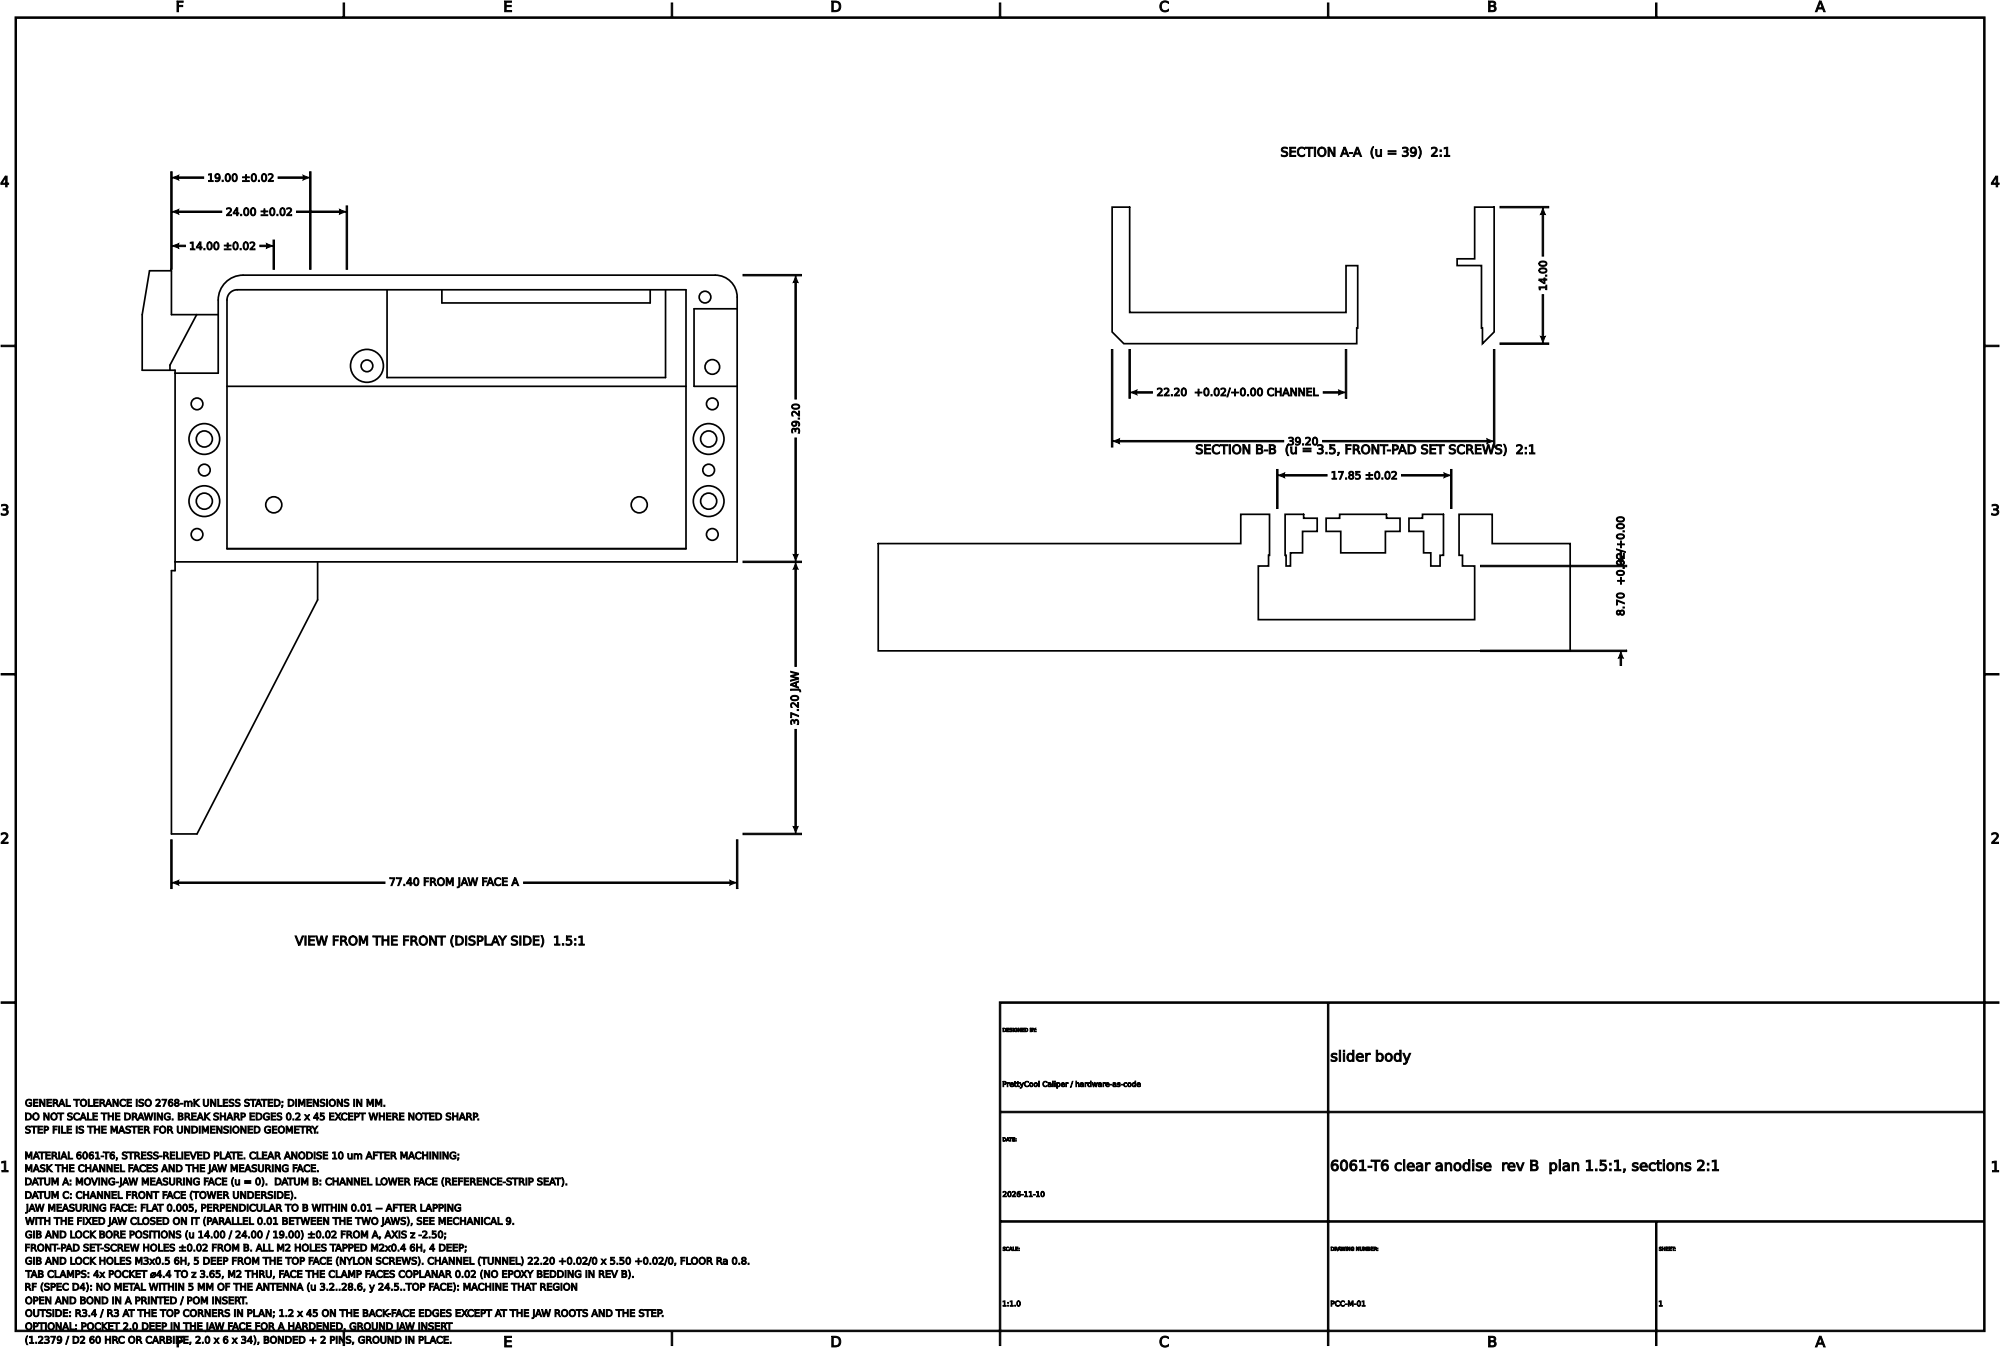
[picture p61: page 1]
