tyevco/prettycoolboards/caliper/hardware/kicad/slider/prettycool-caliper-slider.kicad_pcb

## KiCad design caliper/hardware/kicad/slider/prettycool-caliper-slider.kicad_pcb (2026-11-11)

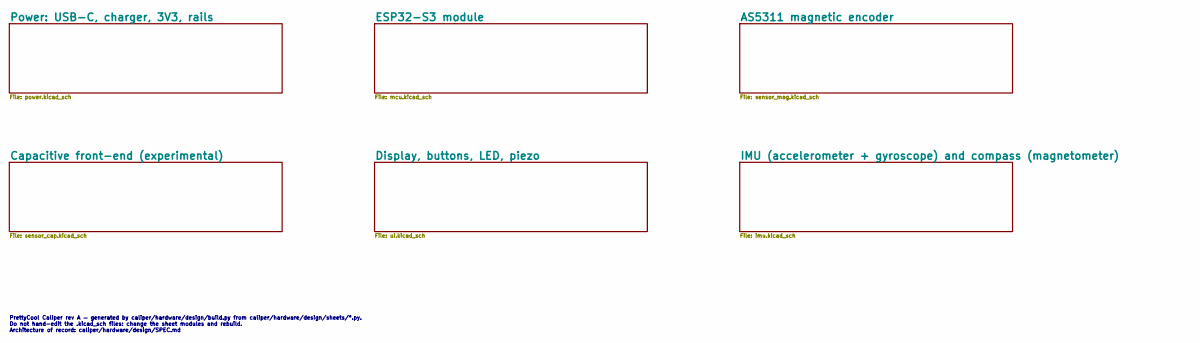
[picture p62: schematic prettycool-caliper-slider.kicad_sch, PrettyCool Caliper slider board]

Notes on the sheet:
PrettyCool Caliper rev A — generated by caliper/hardware/design/build.py from caliper/hardware/design/sheets/*.py. Do not hand-edit the .kicad_sch files: change the sheet modules and rebuild. Architecture of record: caliper/hardware/design/SPEC.md

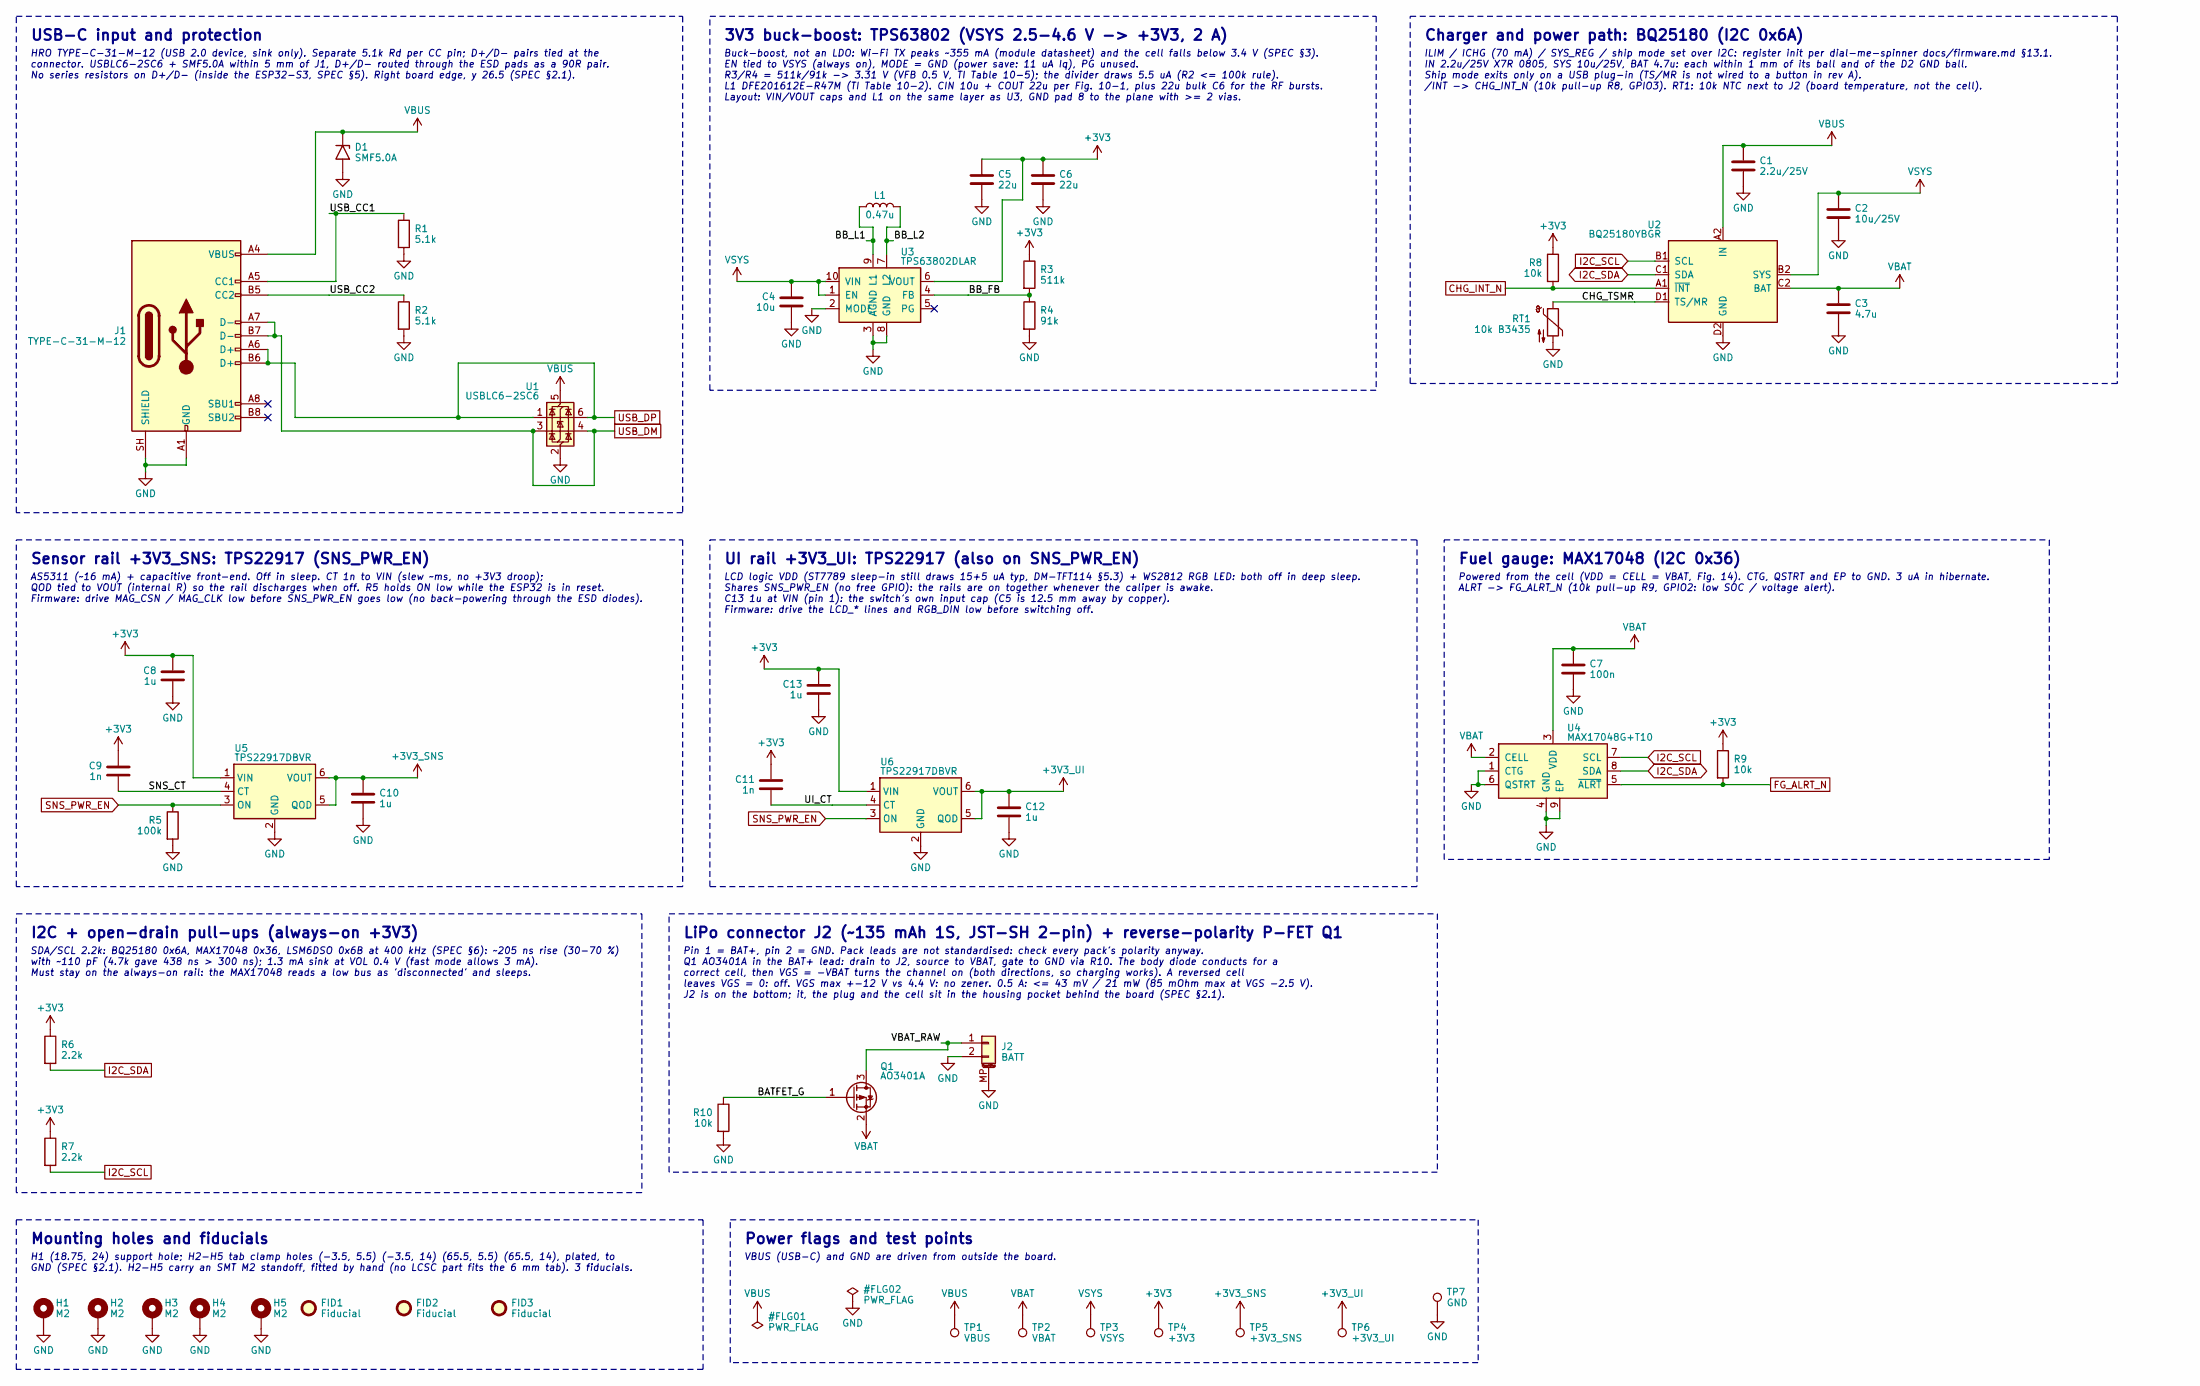
[picture p63: schematic power.kicad_sch, Power: USB-C, charger, 3V3, rails]

Parts:
C1: 2.2u/25V; C_0805_2012Metric; MPN CC0805KKX7R8BB225; LCSC C277470
C2: 10u/25V; C_0603_1608Metric; MPN CL10A106MA8NRNC; LCSC C96446
C3: 4.7u; C_0603_1608Metric; MPN CL10A475KO8NNNC; LCSC C19666
C4: 10u; C_0603_1608Metric; MPN CL10A106KP8NNNC; LCSC C19702
C5, C6: 22u; C_0603_1608Metric; MPN CL10A226MQ8NRNC; LCSC C59461
C7: 100n; C_0402_1005Metric; MPN CL05B104KO5NNNC; LCSC C1525
C8, C10, C12, C13: 1u; C_0402_1005Metric; MPN CL05A105KA5NQNC; LCSC C52923
C9, C11: 1n; C_0402_1005Metric; MPN 0402B102K500NT; LCSC C1523
D1: SMF5.0A; D_SMF; MPN SMF5.0A; LCSC C151296
FID1, FID2, FID3: Fiducial; Fiducial_1mm_Mask2mm
H1, H2, H3, H4, H5: M2; MountingHole_2.2mm_M2_Pad_Via
J1: TYPE-C-31-M-12; USB_C_Receptacle_HRO_TYPE-C-31-M-12; MPN TYPE-C-31-M-12; LCSC C165948
J2: BATT; JST_SH_SM02B-SRSS-TB_1x02-1MP_P1.00mm_Horizontal; MPN SM02B-SRSS-TB(LF)(SN); LCSC C160402
L1: 0.47u; L_Murata_DFE201610P; MPN DFE201612E-R47M=P2; LCSC C668312
Q1: AO3401A; SOT-23; MPN AO3401A; LCSC C15127
R1, R2: 5.1k; R_0402_1005Metric; MPN 0402WGF5101TCE; LCSC C25905
R3: 511k; R_0402_1005Metric; MPN 0402WGF5113TCE; LCSC C64042
R4: 91k; R_0402_1005Metric; MPN 0402WGF9102TCE; LCSC C4147
R5: 100k; R_0402_1005Metric; MPN 0402WGF1003TCE; LCSC C25741
R6, R7: 2.2k; R_0402_1005Metric; MPN 0402WGF2201TCE; LCSC C25879
R8, R9, R10: 10k; R_0402_1005Metric; MPN 0402WGF1002TCE; LCSC C25744
RT1: 10k B3435; R_0402_1005Metric; MPN NCP15XH103F03RC; LCSC C77131
TP1: VBUS; TestPoint_Pad_D1.0mm
TP2: VBAT; TestPoint_Pad_D1.0mm
TP3: VSYS; TestPoint_Pad_D1.0mm
TP4: +3V3; TestPoint_Pad_D1.0mm
TP5: +3V3_SNS; TestPoint_Pad_D1.0mm
TP6: +3V3_UI; TestPoint_Pad_D1.0mm
TP7: GND; TestPoint_Pad_D1.0mm
U1: USBLC6-2SC6; SOT-23-6; MPN USBLC6-2SC6; LCSC C7519
U2: BQ25180YBGR; Texas_DSBGA-8_1.04x1.59mm_Layout2x4_P0.4mm_YBG0008; MPN BQ25180YBGR; LCSC C3682423
U3: TPS63802DLAR; Texas_DLA0010A_VSON-HR-10_2x3mm_P0.5mm; MPN TPS63802DLAR; LCSC C2845237
U4: MAX17048G+T10; TDFN-8-1EP_2x2mm_P0.5mm_EP0.8x1.2mm; MPN MAX17048G+T10; LCSC C2682616
U5, U6: TPS22917DBVR; SOT-23-6; MPN TPS22917DBVR; LCSC C2681320

Connections:
+3V3: C5.1, C6.1, C8.1, C9.2, C11.2, C13.1, R3.1, R6.1, R7.1, R8.1, R9.1, TP4.1, U3.6 (VOUT), U5.1 (VIN), U6.1 (VIN); also elsewhere on the board
+3V3_SNS: C10.1, TP5.1, U5.5 (QOD), U5.6 (VOUT); also elsewhere on the board
+3V3_UI: C12.1, TP6.1, U6.5 (QOD), U6.6 (VOUT); also elsewhere on the board
/Power: USB-C, charger, 3V3, rails/BATFET_G: Q1.1 (G), R10.1
/Power: USB-C, charger, 3V3, rails/BB_FB: R3.2, R4.1, U3.4 (FB)
/Power: USB-C, charger, 3V3, rails/BB_L1: L1.1, U3.9 (L1)
/Power: USB-C, charger, 3V3, rails/BB_L2: L1.2, U3.7 (L2)
/Power: USB-C, charger, 3V3, rails/CHG_TSMR: RT1.1, U2.D1 (TS/MR)
/Power: USB-C, charger, 3V3, rails/SNS_CT: C9.1, U5.4 (CT)
/Power: USB-C, charger, 3V3, rails/UI_CT: C11.1, U6.4 (CT)
/Power: USB-C, charger, 3V3, rails/USB_CC1: J1.A5 (CC1), R1.1
/Power: USB-C, charger, 3V3, rails/USB_CC2: J1.B5 (CC2), R2.1
/Power: USB-C, charger, 3V3, rails/VBAT_RAW: J2.1, Q1.3 (D)
CHG_INT_N: R8.2, U2.A1 (~INT); also elsewhere on the board
FG_ALRT_N: R9.2, U4.5 (~ALRT); also elsewhere on the board
GND: C1.2, C2.2, C3.2, C4.2, C5.2, C6.2, C7.2, C8.2, C10.2, C12.2, C13.2, D1.2 (A2), H1.1, H2.1, H3.1, H4.1, H5.1, J1.A1 (GND), J1.A12 (GND), J1.B1 (GND), J1.B12 (GND), J1.SH (SHIELD), J2.2, J2.MP (MountPin), R1.2, R2.2, R4.2, R5.2, R10.2, RT1.2, TP7.1, U1.2 (GND), U2.D2 (GND), U3.2 (MODE), U3.3 (AGND), U3.8 (GND), U4.1 (CTG), U4.4 (GND), U4.6 (QSTRT), U4.9 (EP), U5.2 (GND), U6.2 (GND); also elsewhere on the board
I2C_SCL: R7.2, U2.B1 (SCL), U4.7 (SCL); also elsewhere on the board
I2C_SDA: R6.2, U2.C1 (SDA), U4.8 (SDA); also elsewhere on the board
SNS_PWR_EN: R5.1, U5.3 (ON), U6.3 (ON); also elsewhere on the board
USB_DM: J1.A7 (D-), J1.B7 (D-), U1.3 (I/O2), U1.4 (I/O2); also elsewhere on the board
USB_DP: J1.A6 (D+), J1.B6 (D+), U1.1 (I/O1), U1.6 (I/O1); also elsewhere on the board
VBAT: C3.1, C7.1, Q1.2 (S), TP2.1, U2.C2 (BAT), U4.2 (CELL), U4.3 (VDD)
VBUS: C1.1, D1.1 (A1), J1.A4 (VBUS), J1.A9 (VBUS), J1.B4 (VBUS), J1.B9 (VBUS), TP1.1, U1.5 (VBUS), U2.A2 (IN)
VSYS: C2.1, C4.1, TP3.1, U2.B2 (SYS), U3.1 (EN), U3.10 (VIN)

Notes on the sheet:
USB-C input and protection
HRO TYPE-C-31-M-12 (USB 2.0 device, sink only). Separate 5.1k Rd per CC pin; D+/D- pairs tied at the connector. USBLC6-2SC6 + SMF5.0A within 5 mm of J1, D+/D- routed through the ESD pads as a 90R pair. No series resistors on D+/D- (inside the ESP32-S3, SPEC §5). Right board edge, y 26.5 (SPEC §2.1).
Charger and power path: BQ25180 (I2C 0x6A)
ILIM / ICHG (70 mA) / SYS_REG / ship mode set over I2C: register init per dial-me-spinner docs/firmware.md §13.1. IN 2.2u/25V X7R 0805, SYS 10u/25V, BAT 4.7u: each within 1 mm of its ball and of the D2 GND ball. Ship mode exits only on a USB plug-in (TS/MR is not wired to a button in rev A). /INT -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
LiPo connector J2 (~135 mAh 1S, JST-SH 2-pin) + reverse-polarity P-FET Q1
Pin 1 = BAT+, pin 2 = GND. Pack leads are not standardised: check every pack's polarity anyway. Q1 AO3401A in the BAT+ lead: drain to J2, source to VBAT, gate to GND via R10. The body diode conducts for a correct cell, then VGS = -VBAT turns the channel on (both directions, so charging works). A re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
3V3 buck-boost: TPS63802 (VSYS 2.5-4.6 V -> +3V3, 2 A)
Buck-boost, not an LDO: Wi-Fi TX peaks ~355 mA (module datasheet) and the cell falls below 3.4 V (SPEC §3). EN tied to VSYS (always on), MODE = GND (power save: 11 uA Iq), PG unused. R3/R4 = 511k/91k -> 3.31 V (VFB 0.5 V, TI Table 10-5); the divider draws 5.5 uA (R2 <= 100k rule). L1 DFE201612E-R47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
Fuel gauge: MAX17048 (I2C 0x36)
Powered from the cell (VDD = CELL = VBAT, Fig. 14). CTG, QSTRT and EP to GND. 3 uA in hibernate. ALRT -> FG_ALRT_N (10k pull-up R9, GPIO2: low SOC / voltage alert).
Sensor rail +3V3_SNS: TPS22917 (SNS_PWR_EN)
AS5311 (~16 mA) + capacitive front-end. Off in sleep. CT 1n to VIN (slew ~ms, no +3V3 droop); QOD tied to VOUT (internal R) so the rail discharges when off. R5 holds ON low while the ESP32 is in reset. Firmware: drive MAG_CSN / MAG_CLK low before SNS_PWR_EN goes low (no back-powering through the ES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
UI rail +3V3_UI: TPS22917 (also on SNS_PWR_EN)
LCD logic VDD (ST7789 sleep-in still draws 15+5 uA typ, DM-TFT114 §5.3) + WS2812 RGB LED: both off in deep sleep. Shares SNS_PWR_EN (no free GPIO): the rails are on together whenever the caliper is awake. C13 1u at VIN (pin 1): the switch's own input cap (C5 is 12.5 mm away by copper). Firmware: dr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
I2C + open-drain pull-ups (always-on +3V3)
SDA/SCL 2.2k: BQ25180 0x6A, MAX17048 0x36, LSM6DSO 0x6B at 400 kHz (SPEC §6): ~205 ns rise (30-70 %) with ~110 pF (4.7k gave 438 ns > 300 ns); 1.3 mA sink at VOL 0.4 V (fast mode allows 3 mA). Must stay on the always-on rail: the MAX17048 reads a low bus as 'disconnected' and sleeps.
Mounting holes and fiducials
H1 (18.75, 24) support hole; H2-H5 tab clamp holes (-3.5, 5.5) (-3.5, 14) (65.5, 5.5) (65.5, 14), plated, to GND (SPEC §2.1). H2-H5 carry an SMT M2 standoff, fitted by hand (no LCSC part fits the 6 mm tab). 3 fiducials.
Power flags and test points
VBUS (USB-C) and GND are driven from outside the board.

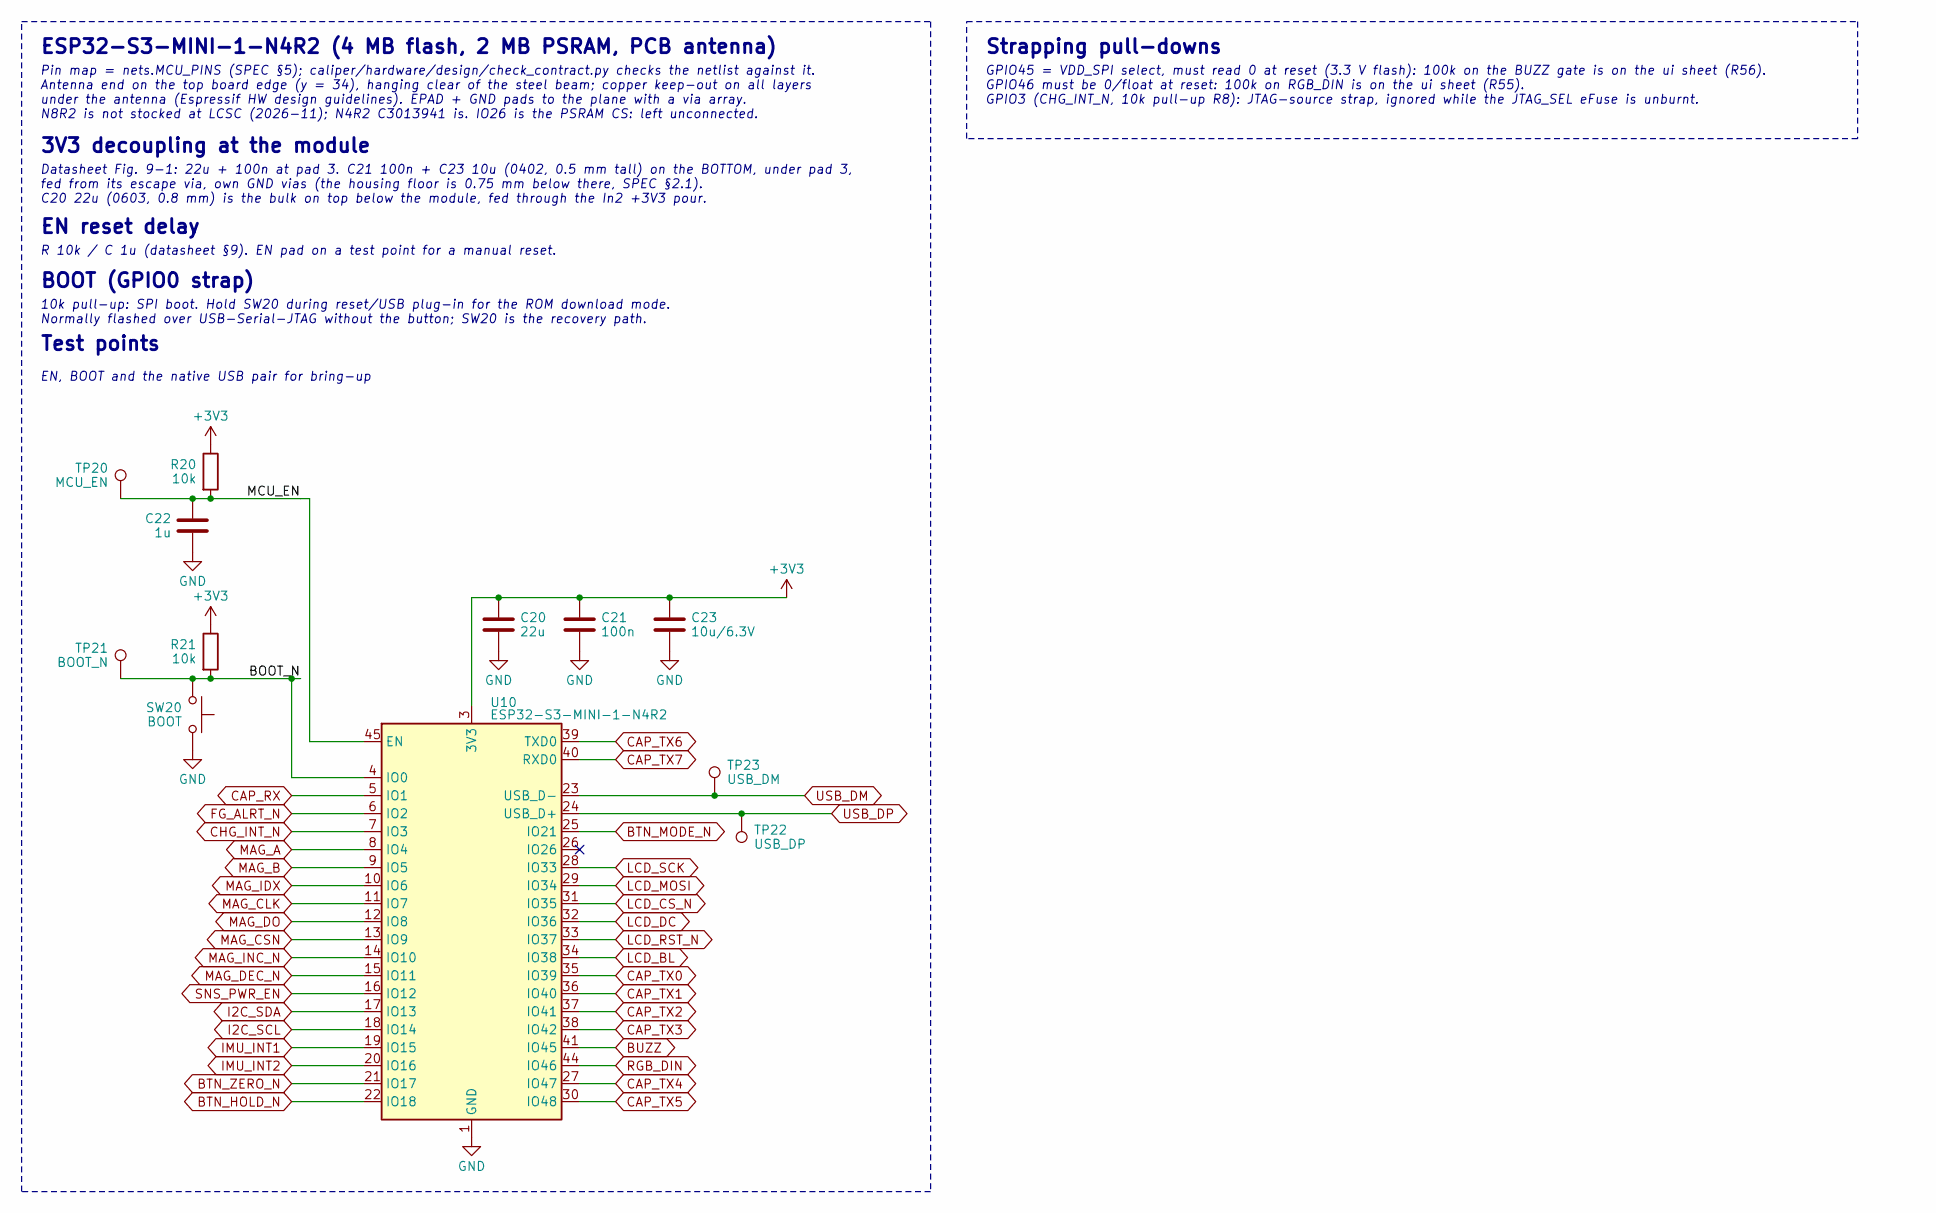
[picture p64: schematic mcu.kicad_sch, ESP32-S3 module]

Parts:
C20: 22u; C_0603_1608Metric; MPN CL10A226MQ8NRNC; LCSC C59461
C21: 100n; C_0402_1005Metric; MPN CL05B104KO5NNNC; LCSC C1525
C22: 1u; C_0402_1005Metric; MPN CL05A105KA5NQNC; LCSC C52923
C23: 10u/6.3V; C_0402_1005Metric; MPN CL05A106MQ5NUNC; LCSC C15525
R20, R21: 10k; R_0402_1005Metric; MPN 0402WGF1002TCE; LCSC C25744
SW20: BOOT; SW_SPST_TS-1088-xR020; MPN TS-1088-AR02016; LCSC C720477
TP20: MCU_EN; TestPoint_Pad_D1.0mm
TP21: BOOT_N; TestPoint_Pad_D1.0mm
TP22: USB_DP; TestPoint_Pad_D1.0mm
TP23: USB_DM; TestPoint_Pad_D1.0mm
U10: ESP32-S3-MINI-1-N4R2; ESP32-S2-MINI-1; MPN ESP32-S3-MINI-1-N4R2; LCSC C3013941

Connections:
+3V3: C20.1, C21.1, C23.1, R20.1, R21.1, U10.3 (3V3); also elsewhere on the board
/ESP32-S3 module/BOOT_N: R21.2, SW20.1, TP21.1, U10.4 (IO0)
/ESP32-S3 module/MCU_EN: C22.1, R20.2, TP20.1, U10.45 (EN)
BTN_HOLD_N: U10.22 (IO18); also elsewhere on the board
BTN_MODE_N: U10.25 (IO21); also elsewhere on the board
BTN_ZERO_N: U10.21 (IO17); also elsewhere on the board
BUZZ: U10.41 (IO45); also elsewhere on the board
CAP_RX: U10.5 (IO1); also elsewhere on the board
CAP_TX0: U10.35 (IO39); also elsewhere on the board
CAP_TX1: U10.36 (IO40); also elsewhere on the board
CAP_TX2: U10.37 (IO41); also elsewhere on the board
CAP_TX3: U10.38 (IO42); also elsewhere on the board
CAP_TX4: U10.27 (IO47); also elsewhere on the board
CAP_TX5: U10.30 (IO48); also elsewhere on the board
CAP_TX6: U10.39 (TXD0); also elsewhere on the board
CAP_TX7: U10.40 (RXD0); also elsewhere on the board
CHG_INT_N: U10.7 (IO3); also elsewhere on the board
FG_ALRT_N: U10.6 (IO2); also elsewhere on the board
GND: C20.2, C21.2, C22.2, C23.2, SW20.2, U10.1 (GND), U10.2 (GND), U10.42 (GND), U10.43 (GND), U10.46 (GND), U10.47 (GND), U10.48 (GND), U10.49 (GND), U10.50 (GND), U10.51 (GND), U10.52 (GND), U10.53 (GND), U10.54 (GND), U10.55 (GND), U10.56 (GND), U10.57 (GND), U10.58 (GND), U10.59 (GND), U10.60 (GND), U10.61 (GND), U10.62 (GND), U10.63 (GND), U10.64 (GND), U10.65 (GND); also elsewhere on the board
I2C_SCL: U10.18 (IO14); also elsewhere on the board
I2C_SDA: U10.17 (IO13); also elsewhere on the board
IMU_INT1: U10.19 (IO15); also elsewhere on the board
IMU_INT2: U10.20 (IO16); also elsewhere on the board
LCD_BL: U10.34 (IO38); also elsewhere on the board
LCD_CS_N: U10.31 (IO35); also elsewhere on the board
LCD_DC: U10.32 (IO36); also elsewhere on the board
LCD_MOSI: U10.29 (IO34); also elsewhere on the board
LCD_RST_N: U10.33 (IO37); also elsewhere on the board
LCD_SCK: U10.28 (IO33); also elsewhere on the board
MAG_A: U10.8 (IO4); also elsewhere on the board
MAG_B: U10.9 (IO5); also elsewhere on the board
MAG_CLK: U10.11 (IO7); also elsewhere on the board
MAG_CSN: U10.13 (IO9); also elsewhere on the board
MAG_DEC_N: U10.15 (IO11); also elsewhere on the board
MAG_DO: U10.12 (IO8); also elsewhere on the board
MAG_IDX: U10.10 (IO6); also elsewhere on the board
MAG_INC_N: U10.14 (IO10); also elsewhere on the board
RGB_DIN: U10.44 (IO46); also elsewhere on the board
SNS_PWR_EN: U10.16 (IO12); also elsewhere on the board
USB_DM: TP23.1, U10.23 (USB_D-); also elsewhere on the board
USB_DP: TP22.1, U10.24 (USB_D+); also elsewhere on the board

Notes on the sheet:
ESP32-S3-MINI-1-N4R2 (4 MB flash, 2 MB PSRAM, PCB antenna)
Pin map = nets.MCU_PINS (SPEC §5); caliper/hardware/design/check_contract.py checks the netlist against it. Antenna end on the top board edge (y = 34), hanging clear of the steel beam; copper keep-out on all layers under the antenna (Espressif HW design guidelines). EPAD + GND pads to the plane wit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
3V3 decoupling at the module
Datasheet Fig. 9-1: 22u + 100n at pad 3. C21 100n + C23 10u (0402, 0.5 mm tall) on the BOTTOM, under pad 3, fed from its escape via, own GND vias (the housing floor is 0.75 mm below there, SPEC §2.1). C20 22u (0603, 0.8 mm) is the bulk on top below the module, fed through the In2 +3V3 pour.
EN reset delay
R 10k / C 1u (datasheet §9). EN pad on a test point for a manual reset.
BOOT (GPIO0 strap)
10k pull-up: SPI boot. Hold SW20 during reset/USB plug-in for the ROM download mode. Normally flashed over USB-Serial-JTAG without the button; SW20 is the recovery path.
Test points
EN, BOOT and the native USB pair for bring-up
Strapping pull-downs
GPIO45 = VDD_SPI select, must read 0 at reset (3.3 V flash): 100k on the BUZZ gate is on the ui sheet (R56). GPIO46 must be 0/float at reset: 100k on RGB_DIN is on the ui sheet (R55). GPIO3 (CHG_INT_N, 10k pull-up R8): JTAG-source strap, ignored while the JTAG_SEL eFuse is unburnt.

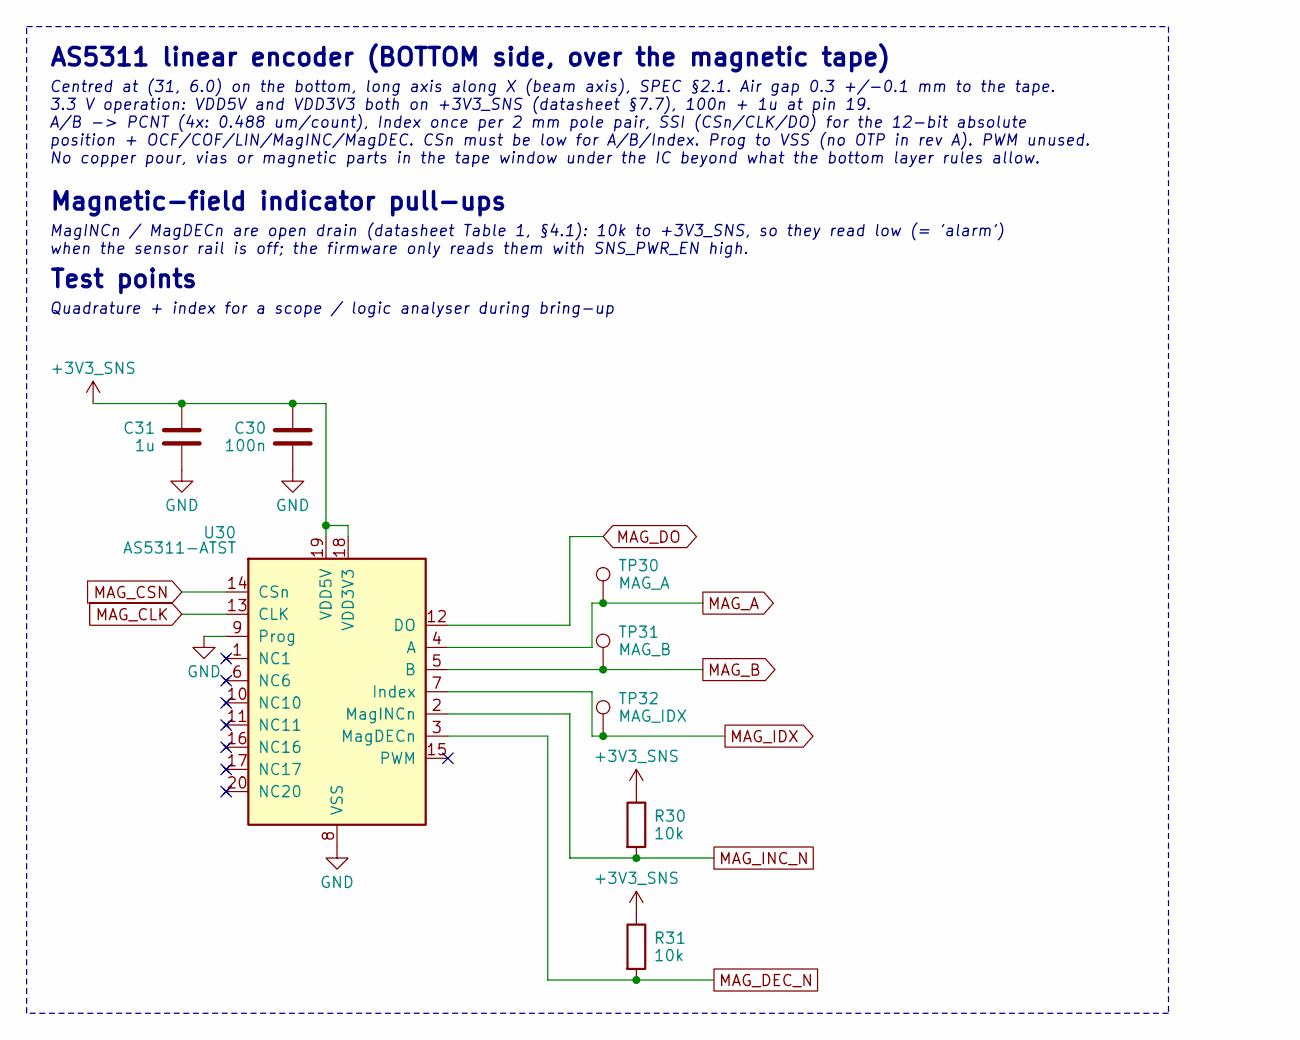
[picture p65: schematic sensor_mag.kicad_sch, AS5311 magnetic encoder]

Parts:
C30: 100n; C_0402_1005Metric; MPN CL05B104KO5NNNC; LCSC C1525
C31: 1u; C_0402_1005Metric; MPN CL05A105KA5NQNC; LCSC C52923
R30, R31: 10k; R_0402_1005Metric; MPN 0402WGF1002TCE; LCSC C25744
TP30: MAG_A; TestPoint_Pad_D1.0mm
TP31: MAG_B; TestPoint_Pad_D1.0mm
TP32: MAG_IDX; TestPoint_Pad_D1.0mm
U30: AS5311-ATST; TSSOP-20_4.4x6.5mm_P0.65mm; MPN AS5311-ATST; LCSC C22459687

Connections:
+3V3_SNS: C30.1, C31.1, R30.1, R31.1, U30.18 (VDD3V3), U30.19 (VDD5V); also elsewhere on the board
GND: C30.2, C31.2, U30.8 (VSS), U30.9 (Prog); also elsewhere on the board
MAG_A: TP30.1, U30.4 (A); also elsewhere on the board
MAG_B: TP31.1, U30.5 (B); also elsewhere on the board
MAG_CLK: U30.13 (CLK); also elsewhere on the board
MAG_CSN: U30.14 (CSn); also elsewhere on the board
MAG_DEC_N: R31.2, U30.3 (MagDECn); also elsewhere on the board
MAG_DO: U30.12 (DO); also elsewhere on the board
MAG_IDX: TP32.1, U30.7 (Index); also elsewhere on the board
MAG_INC_N: R30.2, U30.2 (MagINCn); also elsewhere on the board

Notes on the sheet:
AS5311 linear encoder (BOTTOM side, over the magnetic tape)
Centred at (31, 6.0) on the bottom, long axis along X (beam axis), SPEC §2.1. Air gap 0.3 +/-0.1 mm to the tape. 3.3 V operation: VDD5V and VDD3V3 both on +3V3_SNS (datasheet §7.7), 100n + 1u at pin 19. A/B -> PCNT (4x: 0.488 um/count), Index once per 2 mm pole pair, SSI (CSn/CLK/DO) for the 12-bit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
Magnetic-field indicator pull-ups
MagINCn / MagDECn are open drain (datasheet Table 1, §4.1): 10k to +3V3_SNS, so they read low (= 'alarm') when the sensor rail is off; the firmware only reads them with SNS_PWR_EN high.
Test points
Quadrature + index for a scope / logic analyser during bring-up

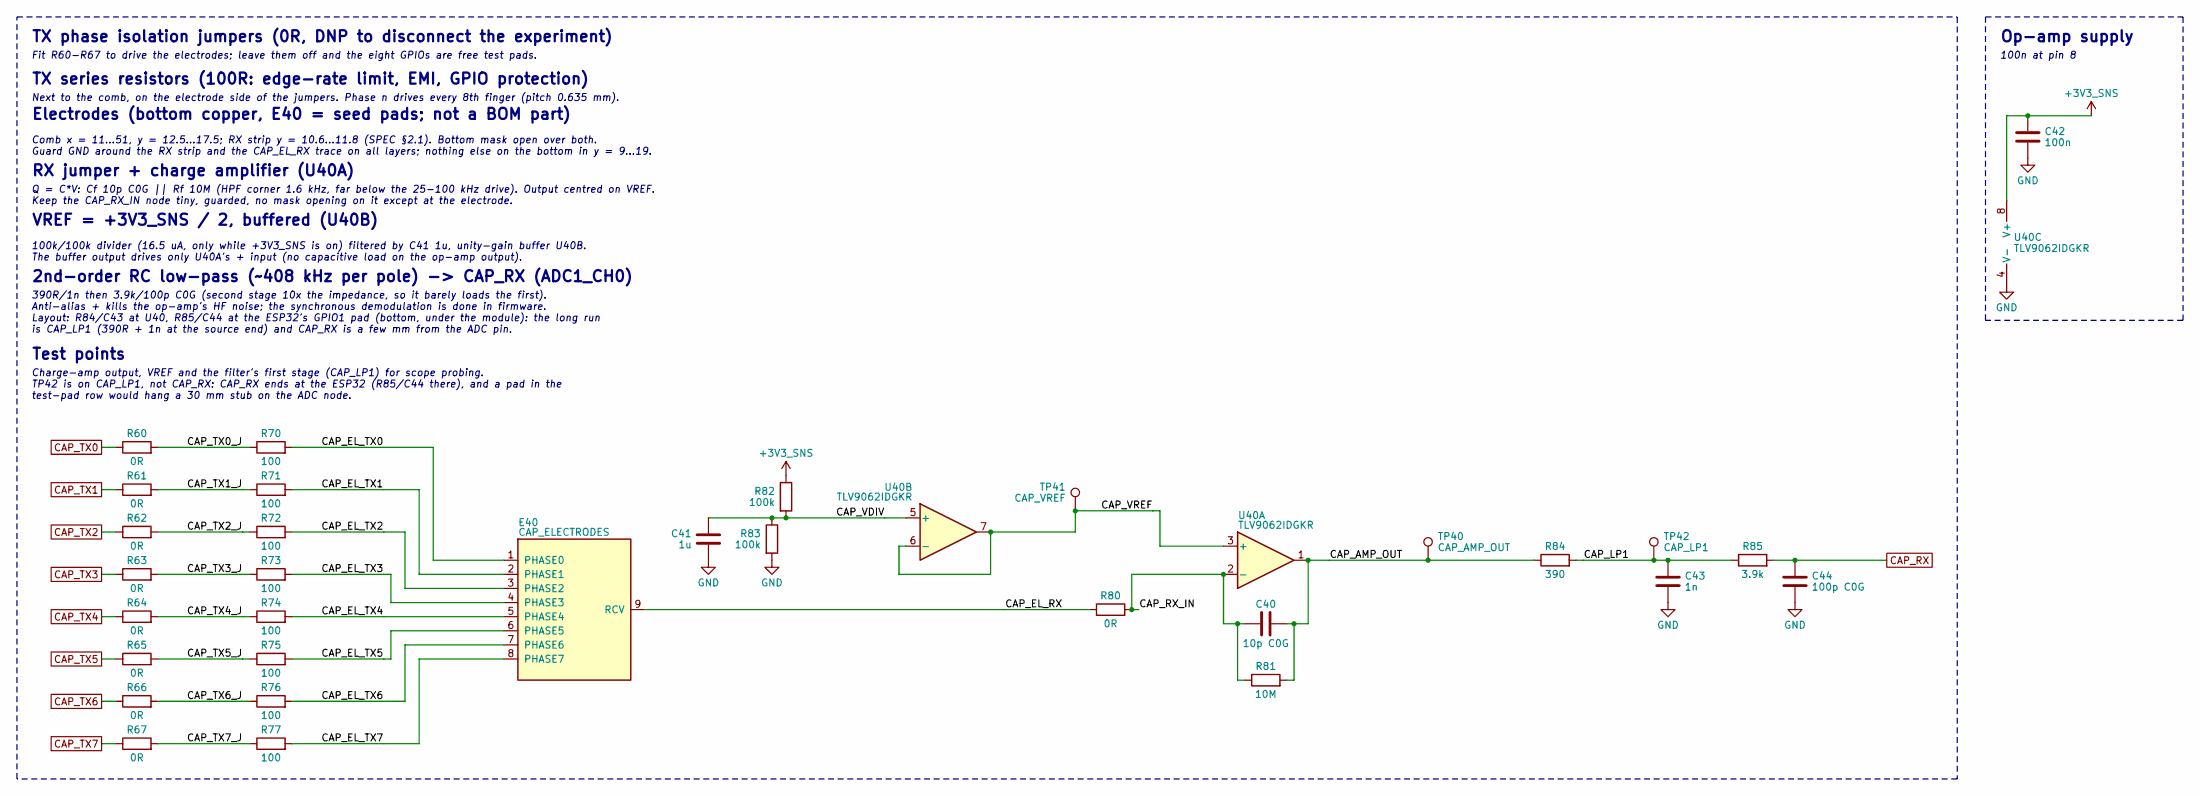
[picture p66: schematic sensor_cap.kicad_sch, Capacitive front-end (experimental)]

Parts:
C40: 10p C0G; C_0402_1005Metric; MPN 0402CG100J500NT; LCSC C1545
C41: 1u; C_0402_1005Metric; MPN CL05A105KA5NQNC; LCSC C52923
C42: 100n; C_0402_1005Metric; MPN CL05B104KO5NNNC; LCSC C1525
C43: 1n; C_0402_1005Metric; MPN 0402B102K500NT; LCSC C1523
C44: 100p C0G; C_0402_1005Metric; MPN 0402CG101J500NT; LCSC C1546
E40: CAP_ELECTRODES; Caliper_CapTX_Electrode_Seed_8Phase_P0.635mm
R60, R61, R62, R63, R64, R65, R66, R67, R80: 0R; R_0402_1005Metric; MPN 0402WGF0000TCE; LCSC C17168
R70, R71, R72, R73, R74, R75, R76, R77: 100; R_0402_1005Metric; MPN 0402WGF1000TCE; LCSC C25076
R81: 10M; R_0402_1005Metric; MPN 0402WGF1005TCE; LCSC C26082
R82, R83: 100k; R_0402_1005Metric; MPN 0402WGF1003TCE; LCSC C25741
R84: 390; R_0402_1005Metric; MPN 0402WGF3900TCE; LCSC C25109
R85: 3.9k; R_0402_1005Metric; MPN 0402WGF3901TCE; LCSC C51721
TP40: CAP_AMP_OUT; TestPoint_Pad_D1.0mm
TP41: CAP_VREF; TestPoint_Pad_D1.0mm
TP42: CAP_LP1; TestPoint_Pad_D1.0mm
U40: TLV9062IDGKR; VSSOP-8_3x3mm_P0.65mm; MPN TLV9062IDGKR; LCSC C398356

Connections:
+3V3_SNS: C42.1, R82.1, U40.8 (V+); also elsewhere on the board
/Capacitive front-end (experimental)/CAP_AMP_OUT: C40.2, R81.2, R84.1, TP40.1, U40.1
/Capacitive front-end (experimental)/CAP_EL_RX: E40.9 (RCV), R80.1
/Capacitive front-end (experimental)/CAP_EL_TX0: E40.1 (PHASE0), R70.2
/Capacitive front-end (experimental)/CAP_EL_TX1: E40.2 (PHASE1), R71.2
/Capacitive front-end (experimental)/CAP_EL_TX2: E40.3 (PHASE2), R72.2
/Capacitive front-end (experimental)/CAP_EL_TX3: E40.4 (PHASE3), R73.2
/Capacitive front-end (experimental)/CAP_EL_TX4: E40.5 (PHASE4), R74.2
/Capacitive front-end (experimental)/CAP_EL_TX5: E40.6 (PHASE5), R75.2
/Capacitive front-end (experimental)/CAP_EL_TX6: E40.7 (PHASE6), R76.2
/Capacitive front-end (experimental)/CAP_EL_TX7: E40.8 (PHASE7), R77.2
/Capacitive front-end (experimental)/CAP_LP1: C43.1, R84.2, R85.1, TP42.1
/Capacitive front-end (experimental)/CAP_RX_IN: C40.1, R80.2, R81.1, U40.2 (-)
/Capacitive front-end (experimental)/CAP_TX0_J: R60.2, R70.1
/Capacitive front-end (experimental)/CAP_TX1_J: R61.2, R71.1
/Capacitive front-end (experimental)/CAP_TX2_J: R62.2, R72.1
/Capacitive front-end (experimental)/CAP_TX3_J: R63.2, R73.1
/Capacitive front-end (experimental)/CAP_TX4_J: R64.2, R74.1
/Capacitive front-end (experimental)/CAP_TX5_J: R65.2, R75.1
/Capacitive front-end (experimental)/CAP_TX6_J: R66.2, R76.1
/Capacitive front-end (experimental)/CAP_TX7_J: R67.2, R77.1
/Capacitive front-end (experimental)/CAP_VDIV: C41.1, R82.2, R83.1, U40.5 (+)
/Capacitive front-end (experimental)/CAP_VREF: TP41.1, U40.3 (+), U40.6 (-), U40.7
CAP_RX: C44.1, R85.2; also elsewhere on the board
CAP_TX0: R60.1; also elsewhere on the board
CAP_TX1: R61.1; also elsewhere on the board
CAP_TX2: R62.1; also elsewhere on the board
CAP_TX3: R63.1; also elsewhere on the board
CAP_TX4: R64.1; also elsewhere on the board
CAP_TX5: R65.1; also elsewhere on the board
CAP_TX6: R66.1; also elsewhere on the board
CAP_TX7: R67.1; also elsewhere on the board
GND: C41.2, C42.2, C43.2, C44.2, R83.2, U40.4 (V-); also elsewhere on the board

Notes on the sheet:
TX phase isolation jumpers (0R, DNP to disconnect the experiment)
Fit R60-R67 to drive the electrodes; leave them off and the eight GPIOs are free test pads.
TX series resistors (100R: edge-rate limit, EMI, GPIO protection)
Next to the comb, on the electrode side of the jumpers. Phase n drives every 8th finger (pitch 0.635 mm).
Electrodes (bottom copper, E40 = seed pads; not a BOM part)
Comb x = 11...51, y = 12.5...17.5; RX strip y = 10.6...11.8 (SPEC §2.1). Bottom mask open over both. Guard GND around the RX strip and the CAP_EL_RX trace on all layers; nothing else on the bottom in y = 9...19.
RX jumper + charge amplifier (U40A)
Q = C*V: Cf 10p C0G || Rf 10M (HPF corner 1.6 kHz, far below the 25-100 kHz drive). Output centred on VREF. Keep the CAP_RX_IN node tiny, guarded, no mask opening on it except at the electrode.
VREF = +3V3_SNS / 2, buffered (U40B)
100k/100k divider (16.5 uA, only while +3V3_SNS is on) filtered by C41 1u, unity-gain buffer U40B. The buffer output drives only U40A's + input (no capacitive load on the op-amp output).
2nd-order RC low-pass (~408 kHz per pole) -> CAP_RX (ADC1_CH0)
390R/1n then 3.9k/100p C0G (second stage 10x the impedance, so it barely loads the first). Anti-alias + kills the op-amp's HF noise; the synchronous demodulation is done in firmware. Layout: R84/C43 at U40, R85/C44 at the ESP32's GPIO1 pad (bottom, under the module): the long run is CAP_LP1 (390R +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
Test points
Charge-amp output, VREF and the filter's first stage (CAP_LP1) for scope probing. TP42 is on CAP_LP1, not CAP_RX: CAP_RX ends at the ESP32 (R85/C44 there), and a pad in the test-pad row would hang a 30 mm stub on the ADC node.
Op-amp supply
100n at pin 8

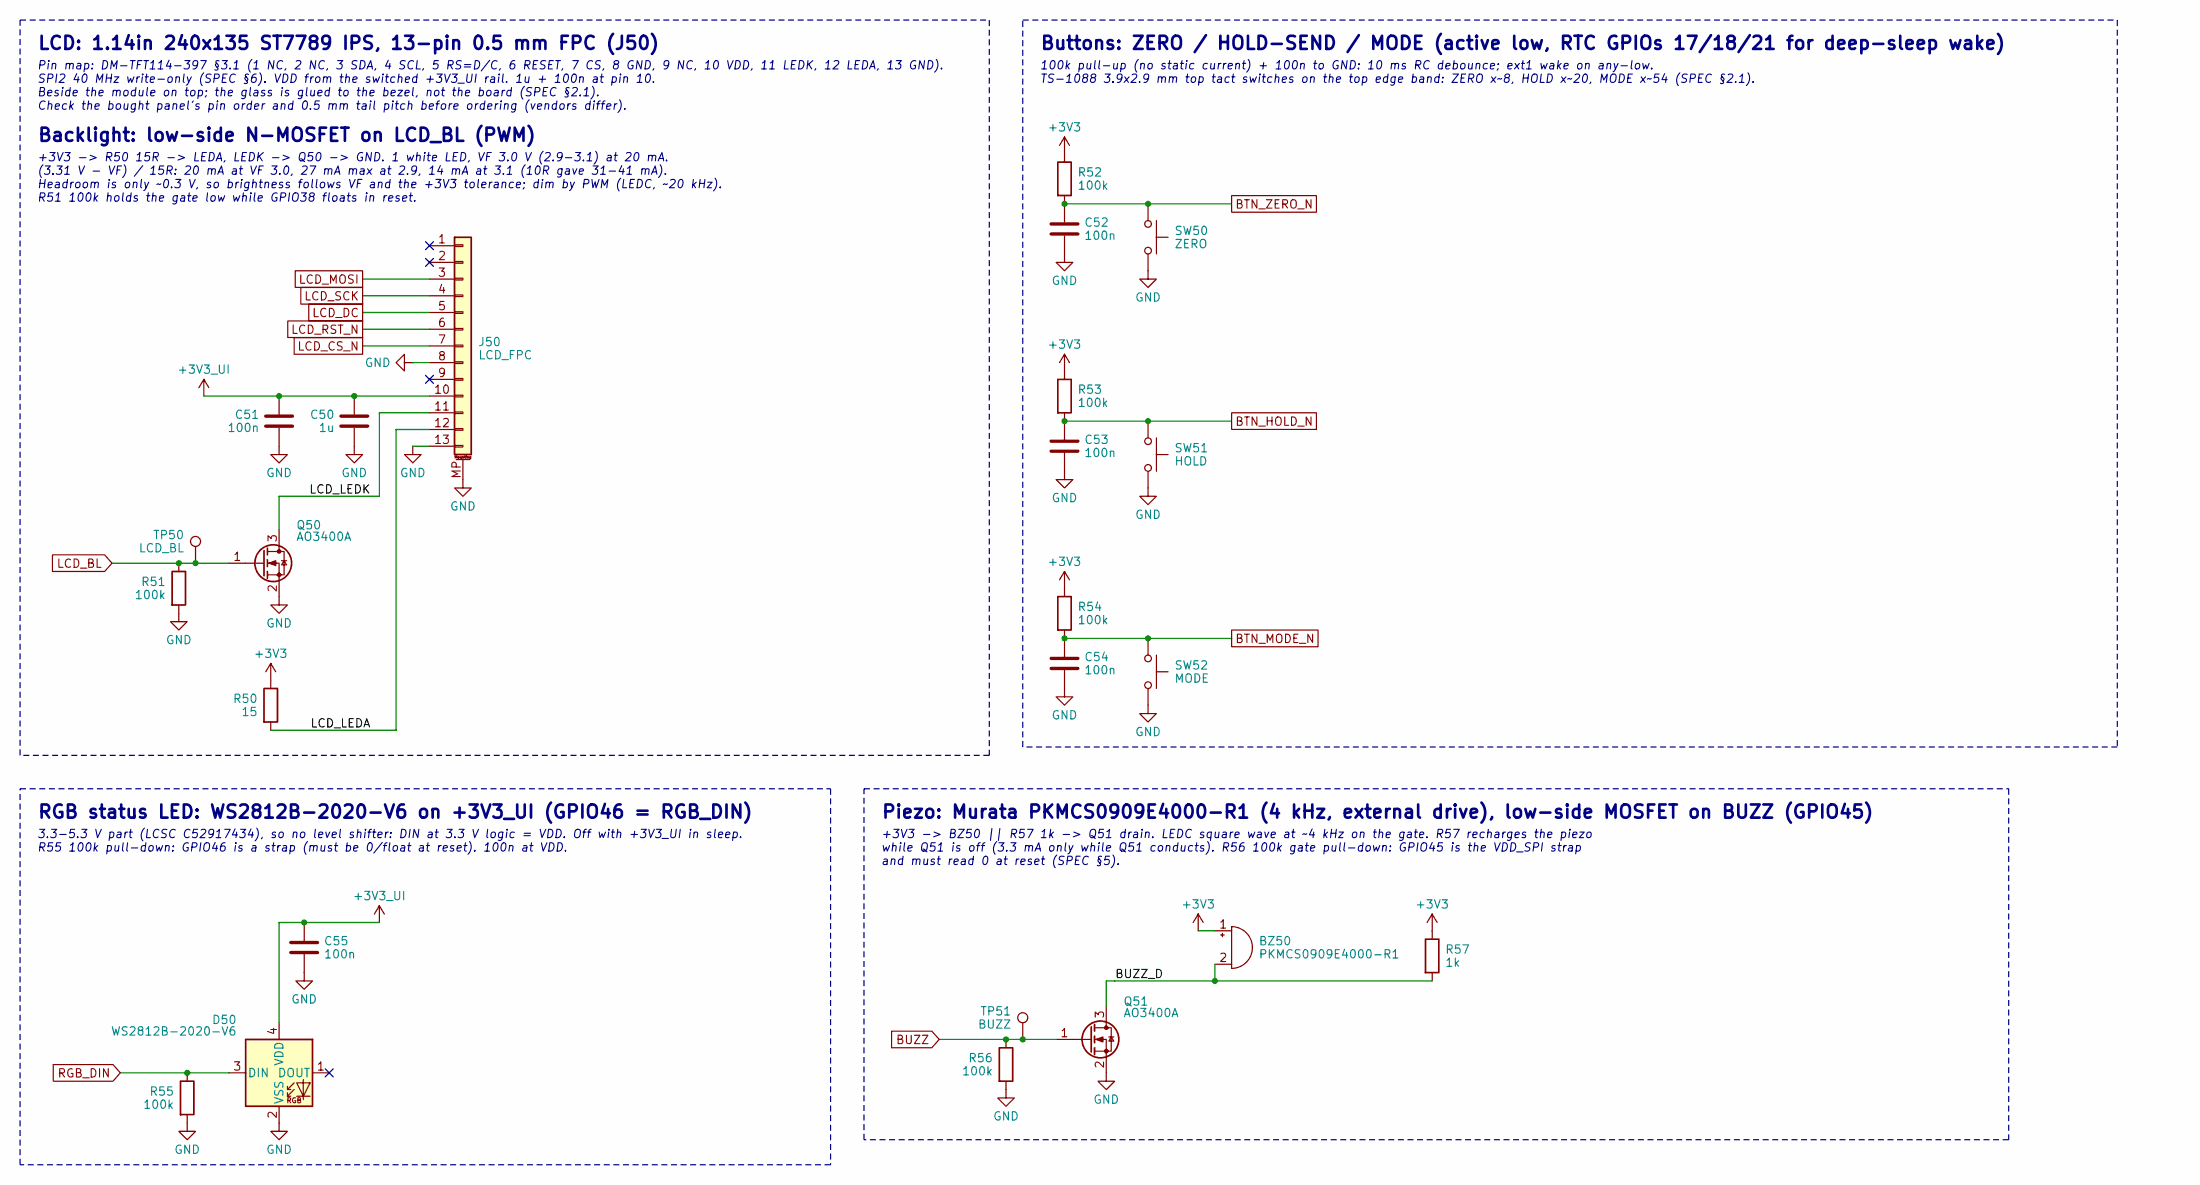
[picture p67: schematic ui.kicad_sch, Display, buttons, LED, piezo]

Parts:
BZ50: PKMCS0909E4000-R1; Buzzer_Murata_PKMCS0909E; MPN PKMCS0909E4000-R1; LCSC C910763
C50: 1u; C_0402_1005Metric; MPN CL05A105KA5NQNC; LCSC C52923
C51, C52, C53, C54, C55: 100n; C_0402_1005Metric; MPN CL05B104KO5NNNC; LCSC C1525
D50: WS2812B-2020-V6; LED_WS2812B-2020_PLCC4_2.0x2.0mm; MPN WS2812B-2020-V6; LCSC C52917434
J50: LCD_FPC; HDGC_0.5K-AX-13PWB_1x13-1MP_P0.50mm_Horizontal; MPN 0.5K-AX-13PWB; LCSC C2911931
Q50, Q51: AO3400A; SOT-23; MPN AO3400A; LCSC C20917
R50: 15; R_0603_1608Metric; MPN 0603WAF150JT5E; LCSC C22810
R51, R52, R53, R54, R55, R56: 100k; R_0402_1005Metric; MPN 0402WGF1003TCE; LCSC C25741
R57: 1k; R_0402_1005Metric; MPN 0402WGF1001TCE; LCSC C11702
SW50: ZERO; SW_SPST_TS-1088-xR020; MPN TS-1088-AR02016; LCSC C720477
SW51: HOLD; SW_SPST_TS-1088-xR020; MPN TS-1088-AR02016; LCSC C720477
SW52: MODE; SW_SPST_TS-1088-xR020; MPN TS-1088-AR02016; LCSC C720477
TP50: LCD_BL; TestPoint_Pad_D1.0mm
TP51: BUZZ; TestPoint_Pad_D1.0mm

Connections:
+3V3: BZ50.1 (+), R50.1, R52.1, R53.1, R54.1, R57.1; also elsewhere on the board
+3V3_UI: C50.1, C51.1, C55.1, D50.4 (VDD), J50.10; also elsewhere on the board
/Display, buttons, LED, piezo/BUZZ_D: BZ50.2 (-), Q51.3 (D), R57.2
/Display, buttons, LED, piezo/LCD_LEDA: J50.12, R50.2
/Display, buttons, LED, piezo/LCD_LEDK: J50.11, Q50.3 (D)
BTN_HOLD_N: C53.1, R53.2, SW51.1; also elsewhere on the board
BTN_MODE_N: C54.1, R54.2, SW52.1; also elsewhere on the board
BTN_ZERO_N: C52.1, R52.2, SW50.1; also elsewhere on the board
BUZZ: Q51.1 (G), R56.1, TP51.1; also elsewhere on the board
GND: C50.2, C51.2, C52.2, C53.2, C54.2, C55.2, D50.2 (VSS), J50.8, J50.13, J50.MP (MountPin), Q50.2 (S), Q51.2 (S), R51.2, R55.2, R56.2, SW50.2, SW51.2, SW52.2; also elsewhere on the board
LCD_BL: Q50.1 (G), R51.1, TP50.1; also elsewhere on the board
LCD_CS_N: J50.7; also elsewhere on the board
LCD_DC: J50.5; also elsewhere on the board
LCD_MOSI: J50.3; also elsewhere on the board
LCD_RST_N: J50.6; also elsewhere on the board
LCD_SCK: J50.4; also elsewhere on the board
RGB_DIN: D50.3 (DIN), R55.1; also elsewhere on the board

Notes on the sheet:
LCD: 1.14in 240x135 ST7789 IPS, 13-pin 0.5 mm FPC (J50)
Pin map: DM-TFT114-397 §3.1 (1 NC, 2 NC, 3 SDA, 4 SCL, 5 RS=D/C, 6 RESET, 7 CS, 8 GND, 9 NC, 10 VDD, 11 LEDK, 12 LEDA, 13 GND). SPI2 40 MHz write-only (SPEC §6). VDD from the switched +3V3_UI rail. 1u + 100n at pin 10. Beside the module on top; the glass is glued to the bezel, not the board (SPEC §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
Backlight: low-side N-MOSFET on LCD_BL (PWM)
+3V3 -> R50 15R -> LEDA, LEDK -> Q50 -> GND. 1 white LED, VF 3.0 V (2.9-3.1) at 20 mA. (3.31 V - VF) / 15R: 20 mA at VF 3.0, 27 mA max at 2.9, 14 mA at 3.1 (10R gave 31-41 mA). Headroom is only ~0.3 V, so brightness follows VF and the +3V3 tolerance; dim by PWM (LEDC, ~20 kHz). R51 100k holds the g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
Buttons: ZERO / HOLD-SEND / MODE (active low, RTC GPIOs 17/18/21 for deep-sleep wake)
100k pull-up (no static current) + 100n to GND: 10 ms RC debounce; ext1 wake on any-low. TS-1088 3.9x2.9 mm top tact switches on the top edge band: ZERO x~8, HOLD x~20, MODE x~54 (SPEC §2.1).
RGB status LED: WS2812B-2020-V6 on +3V3_UI (GPIO46 = RGB_DIN)
3.3-5.3 V part (LCSC C52917434), so no level shifter: DIN at 3.3 V logic = VDD. Off with +3V3_UI in sleep. R55 100k pull-down: GPIO46 is a strap (must be 0/float at reset). 100n at VDD.
Piezo: Murata PKMCS0909E4000-R1 (4 kHz, external drive), low-side MOSFET on BUZZ (GPIO45)
+3V3 -> BZ50 || R57 1k -> Q51 drain. LEDC square wave at ~4 kHz on the gate. R57 recharges the piezo while Q51 is off (3.3 mA only while Q51 conducts). R56 100k gate pull-down: GPIO45 is the VDD_SPI strap and must read 0 at reset (SPEC §5).
