tyevco/prettycoolboards/caliper/hardware/kicad/slider/prettycool-caliper-slider.kicad_pcb

## KiCad design caliper/hardware/kicad/slider/prettycool-caliper-slider.kicad_pcb (continued)

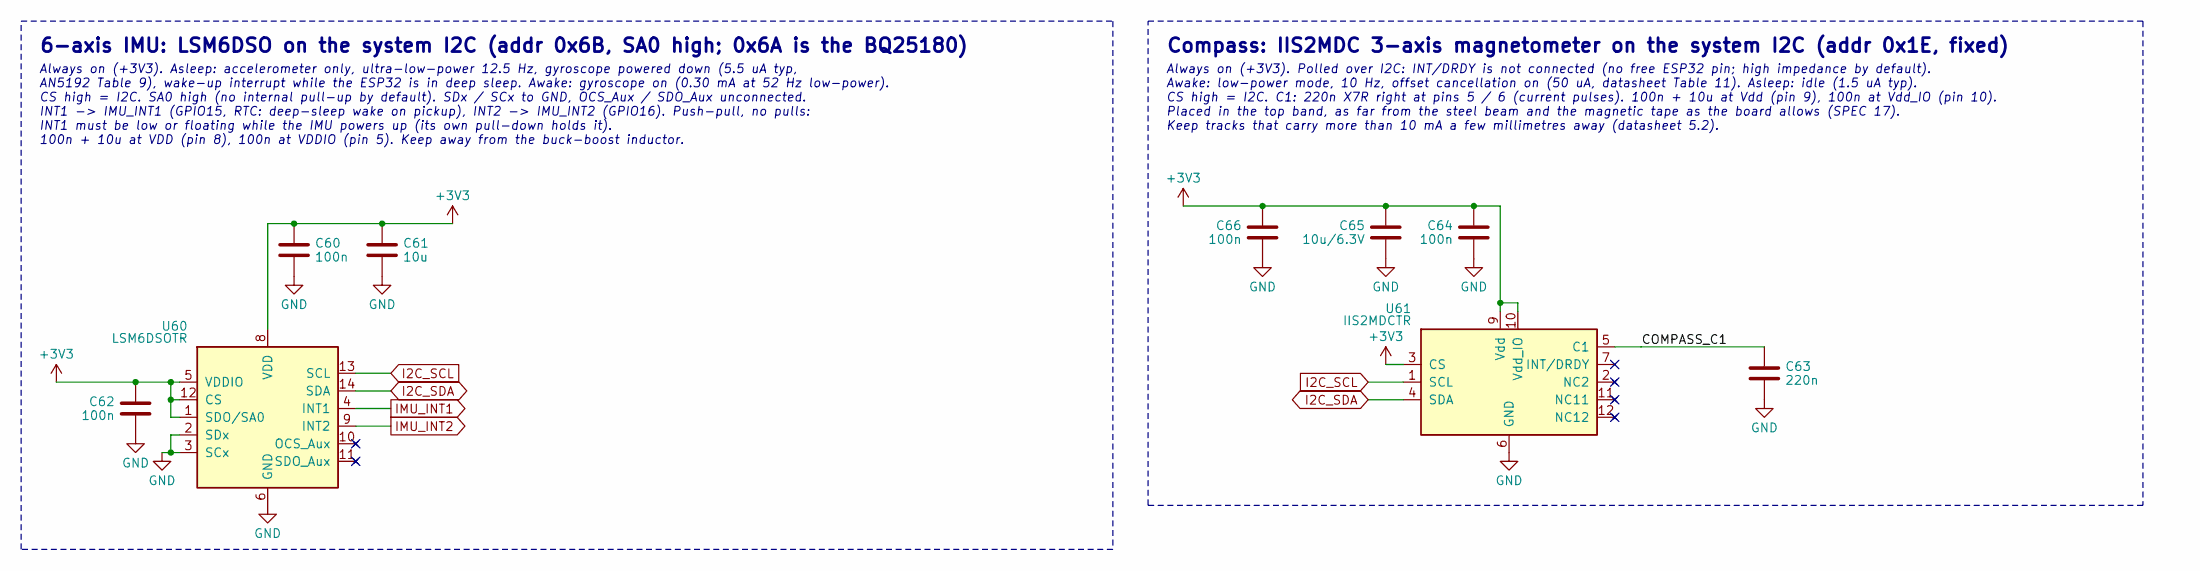
[picture p68: schematic imu.kicad_sch, IMU (accelerometer + gyroscope) and compass (magnetometer)]

Parts:
C60, C62, C64, C66: 100n; C_0402_1005Metric; MPN CL05B104KO5NNNC; LCSC C1525
C61: 10u; C_0603_1608Metric; MPN CL10A106KP8NNNC; LCSC C19702
C63: 220n; C_0402_1005Metric; MPN CL05B224KO5NNNC; LCSC C16772
C65: 10u/6.3V; C_0402_1005Metric; MPN CL05A106MQ5NUNC; LCSC C15525
U60: LSM6DSOTR; LGA-14_3x2.5mm_P0.5mm_LayoutBorder3x4y; MPN LSM6DSOTR; LCSC C2655100
U61: IIS2MDCTR; LGA-12_2x2mm_P0.5mm; MPN IIS2MDCTR; LCSC C2655002

Connections:
+3V3: C60.2, C61.2, C62.2, C64.2, C65.2, C66.2, U60.1 (SDO/SA0), U60.5 (VDDIO), U60.8 (VDD), U60.12 (CS), U61.3 (CS), U61.9 (Vdd), U61.10 (Vdd_IO); also elsewhere on the board
/IMU (accelerometer + gyroscope) and compass (magnetometer)/COMPASS_C1: C63.1, U61.5 (C1)
GND: C60.1, C61.1, C62.1, C63.2, C64.1, C65.1, C66.1, U60.2 (SDx), U60.3 (SCx), U60.6 (GND), U60.7 (GND), U61.6 (GND), U61.8 (GND); also elsewhere on the board
I2C_SCL: U60.13 (SCL), U61.1 (SCL); also elsewhere on the board
I2C_SDA: U60.14 (SDA), U61.4 (SDA); also elsewhere on the board
IMU_INT1: U60.4 (INT1); also elsewhere on the board
IMU_INT2: U60.9 (INT2); also elsewhere on the board

Notes on the sheet:
6-axis IMU: LSM6DSO on the system I2C (addr 0x6B, SA0 high; 0x6A is the BQ25180)
Always on (+3V3). Asleep: accelerometer only, ultra-low-power 12.5 Hz, gyroscope powered down (5.5 uA typ, AN5192 Table 9), wake-up interrupt while the ESP32 is in deep sleep. Awake: gyroscope on (0.30 mA at 52 Hz low-power). CS high = I2C. SA0 high (no internal pull-up by default). SDx / SCx to GN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
Compass: IIS2MDC 3-axis magnetometer on the system I2C (addr 0x1E, fixed)
Always on (+3V3). Polled over I2C: INT/DRDY is not connected (no free ESP32 pin; high impedance by default). Awake: low-power mode, 10 Hz, offset cancellation on (50 uA, datasheet Table 11). Asleep: idle (1.5 uA typ). CS high = I2C. C1: 220n X7R right at pins 5 / 6 (current pulses). 100n + 10u at V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

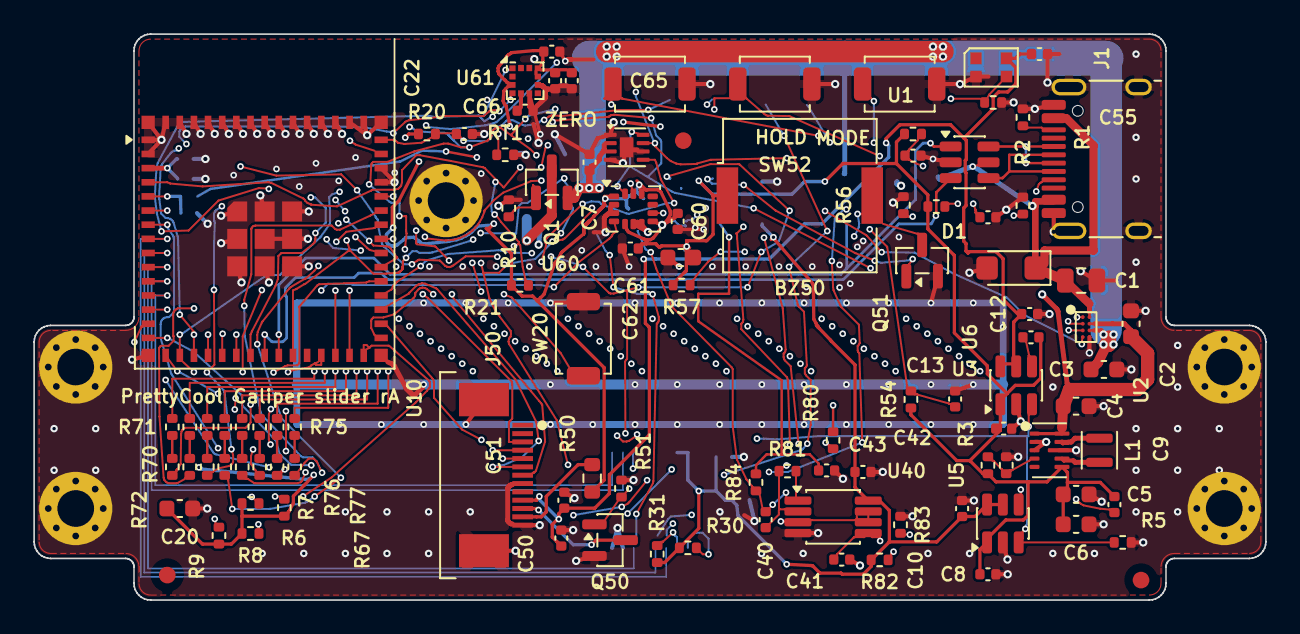
[picture p69: board prettycool-caliper-slider.kicad_pcb from above]

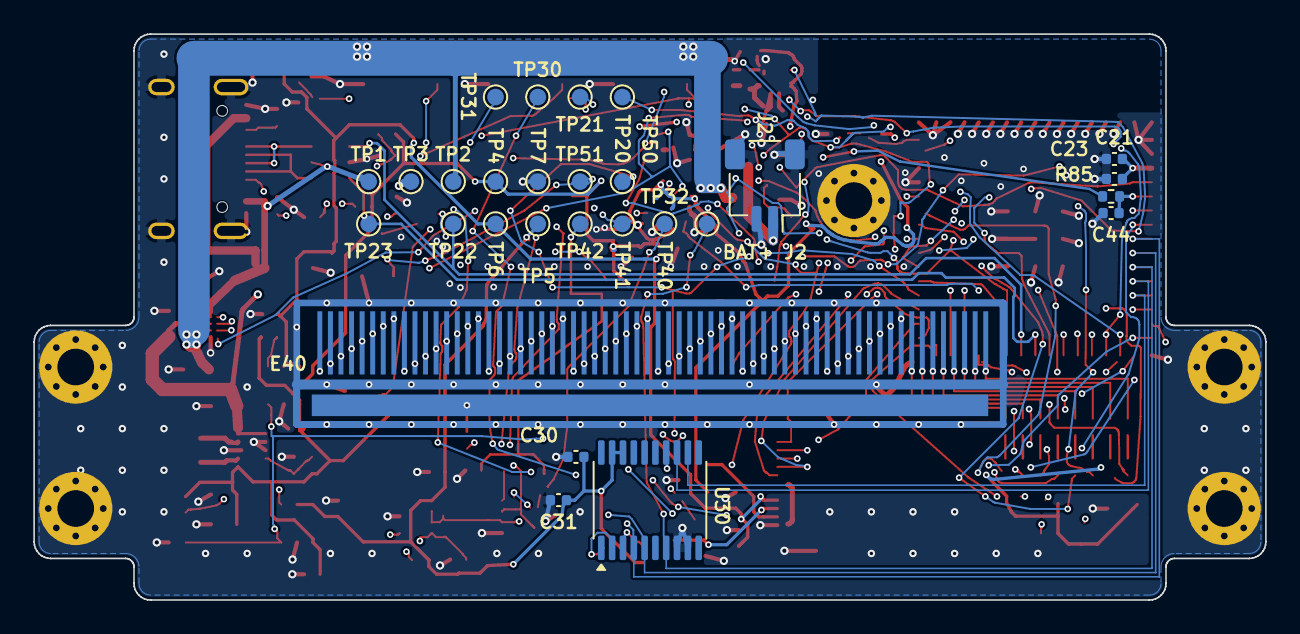
[picture p70: board prettycool-caliper-slider.kicad_pcb from below]

Board: 4 copper layers, 74.0 x 34.0 mm, 135 parts (28 on the bottom side), 82 nets.
