tyevco/prettycoolboards/caliper/firmware/components/sensor_mag/sensor_mag.c

/* sensor_mag: AS5311 over PCNT (quadrature) + bit-banged SSI. */
#include "sensor_mag.h"

#include <string.h>

#include "board_pins.h"
#include "pin_plan.h"
#include "driver/gpio.h"
#include "driver/pulse_cnt.h"
#include "esp_attr.h"
#include "esp_check.h"
#include "esp_log.h"
#include "esp_rom_sys.h"
#include "esp_system.h"
#include "freertos/FreeRTOS.h"
#include "freertos/task.h"
#include "measure.h"
#include "sdkconfig.h"

static const char *TAG = "mag";

#define PCNT_LIMIT       30000 /* hardware counter is 16-bit; the driver accumulates overflows */
/* Wrap-race filter: the largest believable count change between two reads. A read that races the
 * driver's overflow ISR is off by PCNT_LIMIT (30000 counts, 58.6 mm). 15000 counts is 29 mm in one
 * 10 ms sample (2.9 m/s), well above any hand movement, and half the race error. */
#define JUMP_MAX_COUNTS  15000
#define JUMP_REREADS     2
#define JUMP_REREAD_US   20
/* The SSI vs count consistency limit is AS5311_FINE_TOL_LSB (as5311_proto.h): 3 edges. */
#define IDX_TOL_LSB      16
#define UNLOCK_SETTLE_MS 2     /* A/B leave their power-up "all high" state after the first CSn low */
#define BAD_FRAMES_LIMIT 3
#define POWER_UP_MS      20    /* AS5311 power-up to first valid frame (TVP) */
#define OCF_WAIT_MS      100

/* SSI position assumed to increase with the PCNT count as configured below (TVP: if bring-up
 * shows the opposite, flip this; the slip residual then stays near 0 while moving). */
#define SSI_SIGN 1

#if CONFIG_CALIPER_MAG_DIR_INVERT
#define USER_DIR -1
#else
#define USER_DIR 1
#endif

#define RTC_MAGIC 0xA5311A56u /* bumped when the layout gained the offset */
typedef struct {
    uint32_t magic;
    int64_t count;
    uint16_t ssi;
    int32_t offset; /* the slip tracker's SSI/count offset: keeps the fine position continuous */
} mag_rtc_t;
RTC_DATA_ATTR static mag_rtc_t s_rtc;

static pcnt_unit_handle_t s_unit;
static int64_t s_base; /* internal count = s_base + pcnt */
static as5311_slip_t s_slip;
static as5311_mismatch_t s_mm;
static as5311_jump_t s_jump;
static mag_origin_t s_origin;
static bool s_powered;
static uint8_t s_bad_frames;
static uint32_t s_slips;
static uint32_t s_jumps;
static volatile int s_idx_pcnt;
static volatile bool s_idx_new;
static int32_t s_idx_ref = -1;
static volatile uint32_t s_idx_total;
static uint32_t s_raw_last;
/* bring-up diagnostics (sensor_mag_diag): written by the sensor task, copied by the CLI */
static mag_diag_t s_diag;
static bool s_xc_armed;
static portMUX_TYPE s_diag_mux = portMUX_INITIALIZER_UNLOCKED;

/* ---- SSI ------------------------------------------------------------------------------------ */

/* AS5311 rev 1.12 Table 10 / Figure 6: CLK idles HIGH (it must be high at the CSn falling edge,
 * else the frame carries the field magnitude), tCLKFE >= 500 ns from CSn low to the first CLK
 * falling edge (which latches the data), each rising edge shifts out one bit (valid <= 413 ns
 * later), TCLK/2 >= 500 ns, fCLK <= 1 MHz, tCSn >= 500 ns high between frames. Here: 1 us
 * half periods (~500 kHz) and the bit is sampled 1 us after each rising edge. */
static uint32_t ssi_read_raw(void)
{
    gpio_set_level(PIN_MAG_CLK, 1);
    gpio_set_level(PIN_MAG_CSN, 1);
    esp_rom_delay_us(1); /* tCSn */
    gpio_set_level(PIN_MAG_CSN, 0);
    esp_rom_delay_us(1); /* tCLKFE */
    uint32_t v = 0;
    for (int i = 0; i < AS5311_FRAME_BITS; i++) {
        gpio_set_level(PIN_MAG_CLK, 0);
        esp_rom_delay_us(1);
        gpio_set_level(PIN_MAG_CLK, 1); /* data changes after the rising edge */
        esp_rom_delay_us(1);
        v = (v << 1) | (uint32_t)(gpio_get_level(PIN_MAG_DO) & 1);
    }
    gpio_set_level(PIN_MAG_CSN, 1);
    return v;
}

static bool ssi_read(as5311_frame_t *f)
{
    s_raw_last = ssi_read_raw();
    as5311_decode(s_raw_last, f);
    return as5311_frame_valid(f);
}

/* ---- count ---------------------------------------------------------------------------------- */

static int pcnt_raw(void)
{
    int c = 0;
    pcnt_unit_get_count(s_unit, &c);
    return c;
}

/* The driver count through the wrap-race filter: an implausible step is re-read (the race lasts
 * only until the overflow ISR has run), then the filter sees this sample's last read once, so a
 * jump is only believed after it has persisted for AS5311_JUMP_ACCEPT samples (30 ms), never
 * after a few microsecond-spaced re-reads of one stuck race. */
static int64_t pcnt_filtered(bool *held)
{
    int raw = pcnt_raw();
    for (int i = 0; i < JUMP_REREADS && !as5311_jump_plausible(&s_jump, raw, JUMP_MAX_COUNTS); i++) {
        esp_rom_delay_us(JUMP_REREAD_US);
        raw = pcnt_raw();
    }
    int64_t c = 0;
    *held = !as5311_jump_filter(&s_jump, raw, JUMP_MAX_COUNTS, &c);
    if (*held) {
        s_jumps++;
    }
    return c; /* the previous count if held */
}

/* ---- index ---------------------------------------------------------------------------------- */

static void IRAM_ATTR idx_isr(void *arg)
{
    (void)arg;
    int c = 0;
    if (pcnt_unit_get_count(s_unit, &c) == ESP_OK) {
        s_idx_pcnt = c;
        s_idx_new = true;
    }
    s_idx_total++;
}

/* ---- power ---------------------------------------------------------------------------------- */

esp_err_t sensor_mag_power(bool on)
{
    if (on == s_powered) {
        return ESP_OK;
    }
    if (on) {
        gpio_hold_dis(PIN_SNS_PWR_EN);
        gpio_set_level(PIN_SNS_PWR_EN, 1);
        gpio_set_level(PIN_MAG_CSN, 1);
        gpio_set_level(PIN_MAG_CLK, 1);
        vTaskDelay(pdMS_TO_TICKS(POWER_UP_MS));
    } else {
        /* don't back-power the unpowered AS5311 through its inputs */
        gpio_set_level(PIN_MAG_CSN, 0);
        gpio_set_level(PIN_MAG_CLK, 0);
        gpio_set_level(PIN_SNS_PWR_EN, 0);
    }
    s_powered = on;
    return ESP_OK;
}

/* Waits for OCF (offset compensation finished) and returns the first valid frame. */
static bool wait_first_frame(as5311_frame_t *f)
{
    for (int t = 0; t < OCF_WAIT_MS; t += 2) {
        if (ssi_read(f)) {
            return true;
        }
        vTaskDelay(pdMS_TO_TICKS(2));
    }
    return false;
}

/* ---- init ----------------------------------------------------------------------------------- */

static esp_err_t pcnt_setup(void)
{
    pcnt_unit_config_t ucfg = {
        .low_limit = -PCNT_LIMIT,
        .high_limit = PCNT_LIMIT,
        .flags.accum_count = 1,
    };
    ESP_RETURN_ON_ERROR(pcnt_new_unit(&ucfg, &s_unit), TAG, "pcnt unit");
    pcnt_glitch_filter_config_t filt = {.max_glitch_ns = 100};
    ESP_RETURN_ON_ERROR(pcnt_unit_set_glitch_filter(s_unit, &filt), TAG, "glitch filter");

    pcnt_chan_config_t a_cfg = {.edge_gpio_num = PIN_MAG_A, .level_gpio_num = PIN_MAG_B};
    pcnt_chan_config_t b_cfg = {.edge_gpio_num = PIN_MAG_B, .level_gpio_num = PIN_MAG_A};
    pcnt_channel_handle_t ca, cb;
    ESP_RETURN_ON_ERROR(pcnt_new_channel(s_unit, &a_cfg, &ca), TAG, "chan a");
    ESP_RETURN_ON_ERROR(pcnt_new_channel(s_unit, &b_cfg, &cb), TAG, "chan b");
    /* 4x decoding: both edges of both channels, direction from the other channel's level */
    ESP_ERROR_CHECK(pcnt_channel_set_edge_action(ca, PCNT_CHANNEL_EDGE_ACTION_DECREASE,
                                                 PCNT_CHANNEL_EDGE_ACTION_INCREASE));
    ESP_ERROR_CHECK(pcnt_channel_set_level_action(ca, PCNT_CHANNEL_LEVEL_ACTION_KEEP,
                                                  PCNT_CHANNEL_LEVEL_ACTION_INVERSE));
    ESP_ERROR_CHECK(pcnt_channel_set_edge_action(cb, PCNT_CHANNEL_EDGE_ACTION_INCREASE,
                                                 PCNT_CHANNEL_EDGE_ACTION_DECREASE));
    ESP_ERROR_CHECK(pcnt_channel_set_level_action(cb, PCNT_CHANNEL_LEVEL_ACTION_KEEP,
                                                  PCNT_CHANNEL_LEVEL_ACTION_INVERSE));
    /* the accumulation needs the limits as watch points */
    ESP_ERROR_CHECK(pcnt_unit_add_watch_point(s_unit, PCNT_LIMIT));
    ESP_ERROR_CHECK(pcnt_unit_add_watch_point(s_unit, -PCNT_LIMIT));
    ESP_ERROR_CHECK(pcnt_unit_enable(s_unit));
    ESP_ERROR_CHECK(pcnt_unit_clear_count(s_unit));
    ESP_ERROR_CHECK(pcnt_unit_start(s_unit));
    return ESP_OK;
}

esp_err_t sensor_mag_init(void)
{
    /* Pads from the pin plan's RUN state (tools/pin_plan.py): SNS_PWR_EN / MAG_CLK / MAG_CSN outputs,
     * MAG_DO (with its pull-up: DO is tri-state between frames), MAG_IDX, MAG_INC_N / MAG_DEC_N inputs,
     * no other pulls. The outputs start low (rail off); sensor_mag_power() then sequences them. */
    gpio_set_level(PIN_SNS_PWR_EN, 0);
    gpio_set_level(PIN_MAG_CLK, 0);
    gpio_set_level(PIN_MAG_CSN, 0);
    ESP_RETURN_ON_ERROR(pin_plan_apply(PP_MODE_RUN, pin_plan_init_mask(PP_INIT_SENSOR_MAG), 0), TAG, "gpio");
    ESP_RETURN_ON_ERROR(gpio_set_intr_type(PIN_MAG_IDX, GPIO_INTR_POSEDGE), TAG, "idx intr");
    ESP_RETURN_ON_ERROR(gpio_intr_enable(PIN_MAG_IDX), TAG, "idx intr");

    s_powered = false;
    ESP_RETURN_ON_ERROR(sensor_mag_power(true), TAG, "power");
    ESP_RETURN_ON_ERROR(pcnt_setup(), TAG, "pcnt");
    /* pcnt_new_channel() turns the pad pull-UP on (esp_driver_pcnt pulse_cnt.c); A / B are push-pull
     * outputs of the AS5311, so that pull-up only burns ~73 uA per pin while one is low (and would
     * back-power the AS5311 if it survived into sleep). The plan says none. */
    pin_plan_apply_pulls(PP_MODE_RUN, (1ULL << PIN_MAG_A) | (1ULL << PIN_MAG_B));

    esp_err_t err = gpio_install_isr_service(ESP_INTR_FLAG_IRAM);
    if (err != ESP_OK && err != ESP_ERR_INVALID_STATE) {
        return err;
    }
    ESP_RETURN_ON_ERROR(gpio_isr_handler_add(PIN_MAG_IDX, idx_isr, NULL), TAG, "idx isr");

    as5311_slip_init(&s_slip, SSI_SIGN);
    as5311_mismatch_init(&s_mm);
    as5311_jump_init(&s_jump);
    s_origin = MAG_ORIGIN_NONE;
    as5311_frame_t f;
    bool got = wait_first_frame(&f);
    if (got) {
        /* CSn was high at power-up, so A/B/Index sat high until the first CSn low pulse
         * (datasheet §7.1.1): let them settle into the real quadrature state (that transition
         * may produce a stray count), then take the reference frame and count together. */
        vTaskDelay(pdMS_TO_TICKS(UNLOCK_SETTLE_MS));
        got = ssi_read(&f) || wait_first_frame(&f);
    }
    if (!got) {
        ESP_LOGE(TAG, "no valid SSI frame (sensor missing, unpowered or OCF never set)");
        s_base = 0;
        s_bad_frames = BAD_FRAMES_LIMIT;
        s_rtc.magic = 0;
        return ESP_OK; /* keep counting; readings are flagged SENSOR_ERR */
    }
    bool held;
    int64_t c = pcnt_filtered(&held);
    bool recovered = false;
    if (esp_reset_reason() == ESP_RST_DEEPSLEEP && s_rtc.magic == RTC_MAGIC) {
        int64_t cnt = as5311_recover_count(s_rtc.count, s_rtc.ssi, f.pos, SSI_SIGN);
        /* keep the offset learned at the first power-up, so the fine position carries on
         * seamlessly; the recovered count must agree with it like any other reading */
        as5311_slip_t chk = {.locked = true, .offset = s_rtc.offset, .dir = SSI_SIGN};
        as5311_fine_t fc = as5311_fine_combine(&chk, cnt, true, f.pos);
        if (fc.status == AS5311_FINE_OK) {
            s_base = cnt - c;
            s_slip = chk;
            recovered = true;
            ESP_LOGI(TAG, "recovered count %lld after sleep (moved %ld SSI LSB while off, residual %ld)",
                     (long long)cnt, (long)as5311_wrap_diff(f.pos, s_rtc.ssi), (long)fc.residual);
        } else {
            ESP_LOGW(TAG, "sleep recovery inconsistent (residual %ld LSB): new origin", (long)fc.residual);
        }
    } else if (esp_reset_reason() == ESP_RST_DEEPSLEEP) {
        ESP_LOGW(TAG, "woke from deep sleep without a saved position: new origin");
    }
    if (!recovered) {
        s_base = -c; /* new origin here */
        as5311_slip_lock(&s_slip, s_base + c, f.pos);
    }
    s_origin = recovered ? MAG_ORIGIN_RECOVERED
               : esp_reset_reason() == ESP_RST_DEEPSLEEP ? MAG_ORIGIN_LOST
                                                         : MAG_ORIGIN_COLD;
    s_rtc.magic = 0; /* only valid for the next wake */
    ESP_LOGI(TAG, "AS5311 ok, pos %u, field %d, origin %s", f.pos, (int)as5311_field(&f),
             recovered ? "recovered" : "new");
    return ESP_OK;
}

mag_origin_t sensor_mag_origin(void)
{
    return s_origin;
}

/* ---- read ----------------------------------------------------------------------------------- */

esp_err_t sensor_mag_read(mag_reading_t *out, bool do_ssi)
{
    memset(out, 0, sizeof(*out));
    if (!s_unit) {
        return ESP_ERR_INVALID_STATE;
    }
    bool held;
    int64_t c1 = pcnt_filtered(&held);
    as5311_fine_t fine = {.lsb = (s_base + c1) * AS5311_LSB_PER_COUNT, .residual = 0, .status = AS5311_FINE_COARSE};
    bool tried = false, valid = false;
    as5311_frame_t f = {0};

    if (do_ssi && s_powered) {
        tried = true;
        valid = ssi_read(&f);
        /* not moving during the frame (and the count read was believed): the comparison is meaningful */
        bool still = !held && pcnt_raw() == (int)c1;
        if (valid) {
            s_bad_frames = 0;
            out->ssi_valid = true;
            out->ssi_pos = f.pos;
            out->field = as5311_field(&f);
            if (!s_slip.locked) {
                as5311_slip_lock(&s_slip, s_base + c1, f.pos);
            }
            fine = as5311_fine_combine(&s_slip, s_base + c1, still, f.pos);
            out->slip = fine.residual;
            int32_t k = as5311_mismatch_update(&s_mm, &s_slip, &fine);
            if (k != 0) {
                /* the same disagreement on AS5311_SLIP_CONFIRM still frames in a row: the SSI is
                 * absolute within the pole, so re-align the count to it */
                s_base += k;
                s_slips++;
                ESP_LOGW(TAG, "count slip of %ld counts (%ld LSB) corrected", (long)k, (long)fine.residual);
                fine = as5311_fine_combine(&s_slip, s_base + c1, still, f.pos);
                out->slip = fine.residual;
            } else if (fine.status == AS5311_FINE_MISMATCH) {
                ESP_LOGD(TAG, "SSI/count mismatch %ld LSB", (long)fine.residual);
            }
        } else if (s_bad_frames < 255) {
            s_bad_frames++;
        }
    }

    if (s_idx_new) {
        s_idx_new = false;
        int32_t ph = (int32_t)as5311_count_phase(s_base + s_idx_pcnt, 1);
        if (s_idx_ref < 0) {
            s_idx_ref = ph;
        } else {
            int32_t d = as5311_wrap_diff((uint16_t)ph, (uint16_t)s_idx_ref);
            if (d > IDX_TOL_LSB || d < -IDX_TOL_LSB) {
                ESP_LOGW(TAG, "index at phase %ld, expected %ld", (long)ph, (long)s_idx_ref);
            }
        }
    }

    int64_t internal = s_base + c1;
    out->count = USER_DIR * internal;
    out->fine = fine.status;
    /* SSI-refined when the two agree; the count alone (a quarter as fine) otherwise */
    out->raw_nm = meas_lsb_to_nm(USER_DIR * fine.lsb);
    out->slips = s_slips;
    out->jumps = s_jumps;
    out->ok = s_powered && s_bad_frames < BAD_FRAMES_LIMIT && out->field != AS5311_FIELD_BAD &&
              fine.status != AS5311_FINE_MISMATCH;

    taskENTER_CRITICAL(&s_diag_mux);
    s_diag.samples++;
    if (tried) {
        if (valid) {
            s_diag.frames_ok++;
        } else {
            s_diag.frames_bad++;
        }
        s_diag.last_raw = s_raw_last;
    }
    s_diag.pcnt = c1;
    s_diag.slips = s_slips;
    s_diag.jumps = s_jumps;
    s_diag.idx_pulses = s_idx_total;
    s_diag.powered = s_powered;
    if (s_xc_armed && valid && !held) {
        as5311_xcheck_feed(&s_diag.xc, SSI_SIGN * c1, f.pos);
    }
    taskEXIT_CRITICAL(&s_diag_mux);
    return ESP_OK;
}

void sensor_mag_diag(mag_diag_t *out)
{
    taskENTER_CRITICAL(&s_diag_mux);
    *out = s_diag;
    taskEXIT_CRITICAL(&s_diag_mux);
}

void sensor_mag_xcheck_start(void)
{
    taskENTER_CRITICAL(&s_diag_mux);
    as5311_xcheck_init(&s_diag.xc);
    s_xc_armed = true;
    taskEXIT_CRITICAL(&s_diag_mux);
}

void sensor_mag_xcheck_stop(void)
{
    taskENTER_CRITICAL(&s_diag_mux);
    s_xc_armed = false;
    taskEXIT_CRITICAL(&s_diag_mux);
}

void sensor_mag_prepare_sleep(void)
{
    as5311_frame_t f;
    bool held = true;
    int64_t c = 0;
    if (s_unit && s_powered && s_slip.locked) {
        c = pcnt_filtered(&held);
    }
    /* a still, believed count and a valid frame taken together, else no recovery on wake */
    if (!held && ssi_read(&f) && pcnt_raw() == (int)c) {
        s_rtc.count = s_base + c;
        s_rtc.ssi = f.pos;
        s_rtc.offset = s_slip.offset;
        s_rtc.magic = RTC_MAGIC;
    } else {
        s_rtc.magic = 0;
    }
    sensor_mag_power(false);
    gpio_hold_en(PIN_SNS_PWR_EN);
}
