tyevco/prettycoolboards/caliper/firmware/main/board_pins.h

/*
 * GENERATED by firmware/tools/gen_pins.py from caliper/hardware/design/nets.py. Do not edit.
 * nets.py REV A 2026-11-07
 */
#pragma once

#define BOARD_PINS_HASH "202d301f8ed3b0f1"
#define BOARD_REV "A"

/* GPIO number per net (ESP32-S3-MINI-1) */
#define PIN_BOOT_N      0  /* BOOT_N */
#define PIN_CAP_RX      1  /* CAP_RX */
#define PIN_FG_ALRT_N   2  /* FG_ALRT_N */
#define PIN_CHG_INT_N   3  /* CHG_INT_N */
#define PIN_MAG_A       4  /* MAG_A */
#define PIN_MAG_B       5  /* MAG_B */
#define PIN_MAG_IDX     6  /* MAG_IDX */
#define PIN_MAG_CLK     7  /* MAG_CLK */
#define PIN_MAG_DO      8  /* MAG_DO */
#define PIN_MAG_CSN     9  /* MAG_CSN */
#define PIN_MAG_INC_N  10  /* MAG_INC_N */
#define PIN_MAG_DEC_N  11  /* MAG_DEC_N */
#define PIN_SNS_PWR_EN 12  /* SNS_PWR_EN */
#define PIN_I2C_SDA    13  /* I2C_SDA */
#define PIN_I2C_SCL    14  /* I2C_SCL */
#define PIN_IMU_INT1   15  /* IMU_INT1 */
#define PIN_IMU_INT2   16  /* IMU_INT2 */
#define PIN_BTN_ZERO_N 17  /* BTN_ZERO_N */
#define PIN_BTN_HOLD_N 18  /* BTN_HOLD_N */
#define PIN_USB_DM     19  /* USB_DM */
#define PIN_USB_DP     20  /* USB_DP */
#define PIN_BTN_MODE_N 21  /* BTN_MODE_N */
#define PIN_LCD_SCK    33  /* LCD_SCK */
#define PIN_LCD_MOSI   34  /* LCD_MOSI */
#define PIN_LCD_CS_N   35  /* LCD_CS_N */
#define PIN_LCD_DC     36  /* LCD_DC */
#define PIN_LCD_RST_N  37  /* LCD_RST_N */
#define PIN_LCD_BL     38  /* LCD_BL */
#define PIN_CAP_TX0    39  /* CAP_TX0 */
#define PIN_CAP_TX1    40  /* CAP_TX1 */
#define PIN_CAP_TX2    41  /* CAP_TX2 */
#define PIN_CAP_TX3    42  /* CAP_TX3 */
#define PIN_CAP_TX6    43  /* CAP_TX6 */
#define PIN_CAP_TX7    44  /* CAP_TX7 */
#define PIN_BUZZ       45  /* BUZZ */
#define PIN_RGB_DIN    46  /* RGB_DIN */
#define PIN_CAP_TX4    47  /* CAP_TX4 */
#define PIN_CAP_TX5    48  /* CAP_TX5 */

/* 7-bit I2C addresses */
#define I2C_ADDR_BQ25180    0x6A
#define I2C_ADDR_IIS2MDC    0x1E
#define I2C_ADDR_LSM6DSO    0x6B
#define I2C_ADDR_MAX17048   0x36

/* CAP_TX0..7 in phase order, for the dedicated-GPIO bundle */
#define PIN_CAP_TX_LIST { PIN_CAP_TX0, PIN_CAP_TX1, PIN_CAP_TX2, PIN_CAP_TX3, PIN_CAP_TX4, PIN_CAP_TX5, PIN_CAP_TX6, PIN_CAP_TX7 }

/* every GPIO above, for checks (test/host/test_pin_plan.c: each one is in the pin plan) */
#define BOARD_PINS_COUNT 38
#define BOARD_PINS_ALL { \
    PIN_BOOT_N, PIN_CAP_RX, PIN_FG_ALRT_N, PIN_CHG_INT_N, PIN_MAG_A, PIN_MAG_B, \
    PIN_MAG_IDX, PIN_MAG_CLK, PIN_MAG_DO, PIN_MAG_CSN, PIN_MAG_INC_N, PIN_MAG_DEC_N, \
    PIN_SNS_PWR_EN, PIN_I2C_SDA, PIN_I2C_SCL, PIN_IMU_INT1, PIN_IMU_INT2, PIN_BTN_ZERO_N, \
    PIN_BTN_HOLD_N, PIN_USB_DM, PIN_USB_DP, PIN_BTN_MODE_N, PIN_LCD_SCK, PIN_LCD_MOSI, \
    PIN_LCD_CS_N, PIN_LCD_DC, PIN_LCD_RST_N, PIN_LCD_BL, PIN_CAP_TX0, PIN_CAP_TX1, \
    PIN_CAP_TX2, PIN_CAP_TX3, PIN_CAP_TX6, PIN_CAP_TX7, PIN_BUZZ, PIN_RGB_DIN, \
    PIN_CAP_TX4, PIN_CAP_TX5 \
}
