tyevco/prettycoolboards/caliper/hardware/design/build.py

#!/usr/bin/env python3
"""Generate the PrettyCool Caliper KiCad schematics (and libraries) from the sheet modules.

usage: python3 caliper/hardware/design/build.py [--board slider|scale] [--only SHEET ...] [--out DIR]
                                                [--no-erc] [--render]

Adapted from dial-me-spinner's hardware/design/build.py. The shared generator toolchain lives in
<repo>/tools (two levels above caliper/hardware).
"""

from __future__ import annotations

import argparse
import importlib
import os
import re
import subprocess
import sys

HERE = os.path.dirname(os.path.abspath(__file__))
HW = os.path.dirname(HERE)                                  # caliper/hardware
REPO = os.path.dirname(os.path.dirname(HW))                 # repo root
sys.path.insert(0, os.path.join(REPO, "tools"))
sys.path.insert(0, HERE)

import fpgen  # noqa: E402
import pcbgen  # noqa: E402
import schgen  # noqa: E402
import symgen  # noqa: E402
import symlib  # noqa: E402

import nets  # noqa: E402
from sheets import PROJECTS  # noqa: E402

LIB = "caliper"
UUID_NS = "prettycool-caliper"
DEFAULT_OUT = os.path.join(HW, "kicad")
TITLES = {"slider": "PrettyCool Caliper slider board", "scale": "PrettyCool Caliper capacitive scale"}

# every generated UUID (schematic and, later, the boards) is namespaced to this project
schgen.set_uuid_namespace(UUID_NS)
pcbgen.UUID_NAMESPACE = UUID_NS


def project_name(board):
    return f"prettycool-caliper-{board}"


def load_modules(names):
    return [importlib.import_module(f"sheets.{n}") for n in names]


def build_libraries(mods, out):
    libdir = os.path.join(out, "lib")
    os.makedirs(libdir, exist_ok=True)
    sym_path = os.path.join(libdir, LIB + ".kicad_sym")
    fp_dir = os.path.join(libdir, LIB + ".pretty")
    syms, seen = [], set()
    for m in mods:
        for spec in getattr(m, "SYMBOLS", []):
            if spec["name"] in seen:
                continue
            seen.add(spec["name"])
            syms.append(symgen.box_symbol(**spec))
        if hasattr(m, "footprints"):
            m.footprints(fpgen, fp_dir)
    symgen.write_library(sym_path, syms, generator="prettycool_caliper_symgen")
    symlib.register_library(LIB, sym_path)
    return {
        "sym": {LIB: "${KIPRJMOD}/lib/" + LIB + ".kicad_sym"},
        "fp": {LIB: "${KIPRJMOD}/lib/" + LIB + ".pretty"},
    }


def make_design(board, mods):
    # A single-sheet board may carry its own title, revision and power nets on its sheet module.
    own = mods[0] if len(mods) == 1 and hasattr(mods[0], "POWER_NETS") else None
    title = getattr(own, "TITLE", None) or TITLES[board]
    d = schgen.Design(project_name(board), title, getattr(own, "REV", nets.REV), getattr(own, "DATE", nets.DATE),
                      "PrettyCool Boards")
    d.power(*(own.POWER_NETS if own else nets.POWER_NETS))
    if not own:
        d.intersheet = set(nets.INTERSHEET)     # global labels even in a partial (--only) build
    if own:
        d.root_notes = [f"{title} -- generated by caliper/hardware/design/build.py from "
                        f"caliper/hardware/design/sheets/{own.__name__.split('.')[-1]}.py. Do not hand-edit."]
    else:
        d.root_notes = list(getattr(nets, "ROOT_NOTES", []))
    for m in mods:
        m.build(d)
    return d


# Intended connections that KiCad's pin-type matrix flags: (violation, {(ref, pin), ...} or "*", reason).
# A waived violation is reported as "waived", never silently dropped; any other pins in the same violation
# keep it an error.
ERC_WAIVERS = [
    ("pin_to_pin", {("U5", "5"), ("U5", "6")},
     "TPS22917 QOD tied straight to VOUT (SLVSDW8B Table 6-1, option 2): +3V3_SNS is discharged when the switch is off"),
    ("pin_to_pin", {("U6", "5"), ("U6", "6")},
     "TPS22917 QOD tied straight to VOUT: +3V3_UI (LCD VDD, RGB LED) is discharged when the switch is off"),
]
# Per-board additions, so a reference designator reused across boards cannot waive the wrong part.
BOARD_ERC_WAIVERS = {
    "slider": [],
    "scale": [],
}


def erc(out, project, waivers=ERC_WAIVERS):
    sch = os.path.join(out, project + ".kicad_sch")
    rpt = os.path.join(out, "erc.rpt")
    subprocess.run(["kicad-cli", "sch", "erc", "--severity-all", "-o", rpt, sch], capture_output=True, text=True)
    found = []
    with open(rpt, encoding="utf-8") as f:
        for line in f:
            if line.startswith("["):
                found.append([line.split("]")[0][1:], set()])
            elif found and line.startswith("    @("):
                m = re.search(r"Symbol (\S+) Pin (\S+)", line)
                if m:
                    found[-1][1].add((m.group(1), m.group(2)))
    counts = {}
    for kind, pins in found:
        waived = any(kind == w[0] and (w[1] == "*" or pins and pins <= w[1]) for w in waivers)
        key = "waived " + kind if waived else f"[{kind}]"
        counts[key] = counts.get(key, 0) + 1
    return rpt, counts


def netlist(out, project):
    sch = os.path.join(out, project + ".kicad_sch")
    path = os.path.join(out, project + ".net")
    subprocess.run(["kicad-cli", "sch", "export", "netlist", "-o", path, sch], check=True, capture_output=True)
    return path


def render(out, project, dpi=110):
    """Schematic -> PDF -> one PNG per sheet (for visual review)."""
    sch = os.path.join(out, project + ".kicad_sch")
    rdir = os.path.join(out, "render")
    os.makedirs(rdir, exist_ok=True)
    pdf = os.path.join(rdir, project + "-schematic.pdf")
    subprocess.run(["kicad-cli", "sch", "export", "pdf", "-o", pdf, sch], check=True, capture_output=True)
    subprocess.run(["pdftoppm", "-r", str(dpi), "-png", pdf, os.path.join(rdir, "sheet")], check=True)
    return rdir


def build_board(board, sheets, out, run_erc=True, do_render=False, partial=False):
    mods = load_modules(sheets)
    libs = build_libraries(mods, out)
    d = make_design(board, mods)
    errs = d.check()
    if partial:
        errs = [e for e in errs if not any(f"net {n} has only one" in e for n in nets.INTERSHEET)]
    single = {n for m in mods for n in getattr(m, "SINGLE_PIN_NETS", [])}
    errs = [e for e in errs if not any(f"net {n} has only one" in e for n in single)]
    for e in errs:
        print(f"[{board}] CHECK:", e)
    for w in d.warnings:
        print(f"[{board}] READABILITY:", w)
    d.write(out, extra_sym_libs=libs["sym"], extra_fp_libs=libs["fp"])
    project = project_name(board)
    print(f"[{board}] schematic written to", out)
    if run_erc:
        rpt, counts = erc(out, project, ERC_WAIVERS + BOARD_ERC_WAIVERS.get(board, []))
        print(f"[{board}] ERC:", counts or "clean", "->", rpt)
        if any(k.startswith("[") for k in counts):
            errs.append(f"{board}: ERC violations {counts}")
        print(f"[{board}] netlist:", netlist(out, project))
    if do_render:
        print(f"[{board}] render:", render(out, project))
    return errs


def main():
    ap = argparse.ArgumentParser()
    ap.add_argument("--board", choices=sorted(PROJECTS), help="build one board only")
    ap.add_argument("--only", nargs="*", help="build only these sheets (scratch builds; use --out)")
    ap.add_argument("--out", help="output dir (default caliper/hardware/kicad/<board>)")
    ap.add_argument("--no-erc", action="store_true")
    ap.add_argument("--render", action="store_true", help="also export PDF + PNG per sheet")
    a = ap.parse_args()
    errs = []
    for board, sheets in PROJECTS.items():
        if a.board and board != a.board:
            continue
        sel = [s for s in sheets if not a.only or s in a.only]
        if not sel:
            continue
        out = a.out or os.path.join(DEFAULT_OUT, board)
        if a.out and not a.board and len(PROJECTS) > 1 and a.only is None:
            out = os.path.join(a.out, board)
        errs += build_board(board, sel, out, not a.no_erc, a.render, partial=bool(a.only))
    return 1 if errs else 0


if __name__ == "__main__":
    sys.exit(main())
