tyevco/prettycoolboards/caliper/firmware/components/power/power.c

/* power: BQ25180 charger, MAX17048 fuel gauge, temperature guard. The LSM6DSO IMU is in imu.c, the
 * IIS2MDC compass in compass.c. */
#include "power.h"

#include <string.h>

#include "board_pins.h"
#include "driver/temperature_sensor.h"
#include "esp_check.h"
#include "esp_log.h"
#include "esp_timer.h"
#include "freertos/FreeRTOS.h"
#include "compass.h"
#include "imu.h"
#include "sdkconfig.h"

static const char *TAG = "power";

#define I2C_HZ      400000
#define I2C_TIMEOUT 50 /* ms */

/* ---- BQ25180 registers (SLUSE99) ---- */
#define BQ_STAT0      0x00
#define BQ_STAT1      0x01
#define BQ_FLAG0      0x02
#define BQ_VBAT_CTRL  0x03
#define BQ_ICHG_CTRL  0x04
#define BQ_CHARGECTL0 0x05
#define BQ_CHARGECTL1 0x06
#define BQ_IC_CTRL    0x07
#define BQ_TMR_ILIM   0x08
#define BQ_SHIP_RST   0x09
#define BQ_SYS_REG    0x0A
#define BQ_TS_CONTROL 0x0B

#define BQ_ICHG_CHG_DIS 0x80
#define BQ_ILIM_100MA   0xC9 /* MR 20 s, autowake 1 s, ILIM code 001 = 100 mA */
#define BQ_ILIM_500MA   0xCD /* ILIM code 101 = 500 mA */
#if CONFIG_CALIPER_CHG_TS_ENABLE
#define BQ_IC_CTRL_VAL 0x97  /* TS_EN, VLOWV 3.0 V, VRCH 100 mV, 2XTMR, 6 h timer, watchdog off */
#else
#define BQ_IC_CTRL_VAL 0x17  /* TS_EN = 0: only for a board without the RT1 NTC */
#endif

/* ---- MAX17048 (Maxim 19-6171 Rev 7, Table 2 p. 10-11, Figs. 8-10 pp. 11-12) ---- */
#define FG_VCELL   0x02
#define FG_SOC     0x04
#define FG_MODE    0x06   /* write-only; bit 14 Quick-Start, bit 13 EnSleep */
#define FG_VERSION 0x08
#define FG_HIBRT   0x0A   /* HibThr (MSB) / ActThr (LSB); 0xFFFF = always hibernate, POR 0x8030 */
#define FG_CONFIG  0x0C   /* RCOMP (MSB) | SLEEP bit 7, ALSC bit 6, ALRT bit 5, ATHD 4..0 (LSB) */
#define FG_VRESET  0x18
#define FG_MODE_ENSLEEP    0x2000u
#define FG_HIBRT_ALWAYS    0xFFFFu
#define FG_HIBRT_POR       0x8030u
#define FG_CONFIG_SLEEP    0x0080u

/* Charge temperature guard on the ESP32-S3 die (no NTC). The die runs a few degC above the
 * cell; limits are therefore a little wider than the 0..45 degC cell range (TVP). */
#define GUARD_COLD_C   2.0f
#define GUARD_HOT_C    55.0f
#define GUARD_HYST_C   3.0f
#define CHARGER_GRACE_US (3 * 1000 * 1000) /* no enumeration within 3 s of VBUS: a charger */

static i2c_master_bus_handle_t s_bus;
static i2c_master_dev_handle_t s_bq, s_fg;
static temperature_sensor_handle_t s_tsens;
static bool s_chg_ok, s_fg_ok, s_imu_ok, s_compass_ok;
static bool s_usb_configured;
static bool s_guard_dis;
static int64_t s_vbus_since;
static uint8_t s_ilim = BQ_ILIM_100MA;
static power_status_t s_last; /* the last power_poll() result, for the bring-up CLI */
static portMUX_TYPE s_last_mux = portMUX_INITIALIZER_UNLOCKED;

static esp_err_t wr8(i2c_master_dev_handle_t d, uint8_t reg, uint8_t v)
{
    uint8_t b[2] = {reg, v};
    return i2c_master_transmit(d, b, 2, I2C_TIMEOUT);
}

static esp_err_t rd(i2c_master_dev_handle_t d, uint8_t reg, uint8_t *v, size_t n)
{
    return i2c_master_transmit_receive(d, &reg, 1, v, n, I2C_TIMEOUT);
}

/* MAX17048 registers are 16 bits, MSB first */
static esp_err_t fg_rd16(uint8_t reg, uint16_t *v)
{
    uint8_t b[2];
    esp_err_t err = rd(s_fg, reg, b, 2);
    *v = (uint16_t)(((uint16_t)b[0] << 8) | b[1]);
    return err;
}

static esp_err_t fg_wr16(uint8_t reg, uint16_t v)
{
    uint8_t w[3] = {reg, (uint8_t)(v >> 8), (uint8_t)v};
    return i2c_master_transmit(s_fg, w, sizeof(w), I2C_TIMEOUT);
}

/* Undo fg_ship_prepare() (a previous ship mode): CONFIG.SLEEP = 0 is the only way out of a forced
 * sleep besides POR (19-6171 p. 10 "Sleep Mode": "Other communication does not wake up the IC"),
 * MODE.EnSleep = 0 so a low bus cannot put it to sleep, HIBRT back to its POR value (automatic
 * hibernate). Harmless when nothing was set. */
static void fg_wake(void)
{
    uint16_t cfg, hib;
    if (fg_rd16(FG_CONFIG, &cfg) == ESP_OK && (cfg & FG_CONFIG_SLEEP)) {
        fg_wr16(FG_CONFIG, (uint16_t)(cfg & ~FG_CONFIG_SLEEP));
        ESP_LOGI(TAG, "MAX17048 woken from sleep (ship mode)");
    }
    fg_wr16(FG_MODE, 0x0000);
    if (fg_rd16(FG_HIBRT, &hib) == ESP_OK && hib != FG_HIBRT_POR) {
        fg_wr16(FG_HIBRT, FG_HIBRT_POR);
    }
}

/* Before ship mode. The BQ25180 then turns VSYS off: +3V3 and the 4.7 k I2C pull-ups die while the
 * MAX17048 stays on VBAT with SDA / SCL floating. Left alone it would sit in (automatic) hibernate at
 * 3 uA, or wake on noise on the floating bus. 19-6171 p. 10 "Sleep Mode": with MODE.EnSleep = 1,
 * CONFIG.SLEEP = 1 forces sleep (IDD0 0.5 uA typ / 2 uA max, p. 2), and only CONFIG.SLEEP = 0 or a POR
 * leaves it; a low bus for tSLEEP (1.75-2.5 s) also enters it, a rising SDA / SCL edge leaves that one
 * (p. 2: tSLEEP, and IPD, a 0.2 uA bus low-detection pull-down on SDA / SCL, so a dead bus does read low).
 *  1. HIBRT = 0xFFFF (p. 12 "HIBRT Register"): always hibernate, 3 uA, the fallback if 2-3 fail.
 *  2. MODE = EnSleep (p. 11 Fig. 8).
 *  3. CONFIG.SLEEP = 1 (p. 12 Fig. 10, read-modify-write: RCOMP and ATHD kept) - only without VBUS:
 *     with a cable in, the BQ25180 holds the ship request until the cable goes (SLUSE99C §8.3.11), the
 *     caliper keeps running meanwhile and needs the gauge; it then sleeps on the low bus (step 2).
 * fg_wake() at the next boot undoes all three. */
static esp_err_t fg_ship_prepare(bool vbus)
{
    esp_err_t err = fg_wr16(FG_HIBRT, FG_HIBRT_ALWAYS);
    if (err == ESP_OK) {
        err = fg_wr16(FG_MODE, FG_MODE_ENSLEEP);
    }
    uint16_t cfg;
    if (err == ESP_OK && !vbus && (err = fg_rd16(FG_CONFIG, &cfg)) == ESP_OK) {
        err = fg_wr16(FG_CONFIG, (uint16_t)(cfg | FG_CONFIG_SLEEP));
    }
    return err;
}

static uint8_t ichg_code(int ma)
{
    /* ICHG = code + 5 mA for codes 0..30 (5..35 mA), = 40 + (code - 31) * 10 mA from code 31 (SLUSE99
     * ICHG_CTRL). Rounds down: 36..39 mA give 35 mA (code 30), never the 40 mA step above the request. */
    if (ma < 40) {
        return (uint8_t)(ma < 5 ? 0 : (ma > 35 ? 30 : ma - 5));
    }
    int code = 31 + (ma - 40) / 10;
    return (uint8_t)(code > 127 ? 127 : code);
}

static uint8_t ichg_value(void)
{
    return (uint8_t)(ichg_code(CONFIG_CALIPER_CHARGE_MA) | (s_guard_dis ? BQ_ICHG_CHG_DIS : 0));
}

/* The register table, IC_CTRL first because it disables the watchdog that starts on the first I2C
 * transaction (dial-me-spinner docs/firmware.md §13.1). ICHG_CTRL and TMR_ILIM carry their live
 * values (the temperature guard's CHG_DIS, the USB input limit), so the table is also what a
 * read-back of a healthy charger returns (the bring-up check "bu bq"). */
size_t power_bq_table(power_reg_t *out, size_t max)
{
    const power_reg_t table[] = {
        {BQ_IC_CTRL, BQ_IC_CTRL_VAL},
        {BQ_VBAT_CTRL, 0x46},  /* 4.20 V */
        /* Cell: Renata ICP501230PS-03, 135 mAh typ / 130 min, 0.5C standard / 1C max charge to 4.2 V,
         * 1C continuous / 2C pulse discharge (SPEC §1, docs/architecture.md §5). */
        {BQ_ICHG_CTRL, ichg_value()}, /* 70 mA = 0.52C (SPEC §1) -> code 34 = 0x22 */
        /* ITERM 10 % = 7 mA (0.05C), precharge 2 x ITERM = 14 mA (0.1C), VINDPM 4.2 V, TREG 100 degC */
        {BQ_CHARGECTL0, 0x20},
        /* IBAT_OCP 1 A (the reset value; was 1.5 A for the 500 mAh cell), BUVLO 3.0 V, CHG_STATUS int
         * on, ILIM int masked. 1 A is a fault limit (7C), not the cell's 2C pulse rating: that one
         * is kept by the Wi-Fi TX cap and voltage floor (caliper_wifi). 500 mA, the only lower step,
         * is still 3.7C and leaves no margin over an uncapped Wi-Fi peak (0.42-0.49 A from a 3.5-3.0 V
         * cell, should the cap ever not apply); 4-7 trips in 2 s latch the BATFET off until USB is
         * plugged in (SLUSE99C §8.3.7.5), so a near miss would strand the caliper. */
        {BQ_CHARGECTL1, 0x52},
        {BQ_TMR_ILIM, s_ilim}, /* 100 mA until a host configures us, then 500 mA */
        /* EN_PUSH = 0: TS/MR carries the NTC and no button on rev A, and the push-button scan
         * costs 1 uA in battery mode (SLUSE99C IQ_BAT 3 uA with it disabled, 4 uA enabled; the
         * SPEC §3 sleep budget assumes 3 uA). Long press action = HW reset, WAKE1 300 ms, WAKE2 2 s.
         * (dial-me-spinner writes 0x09 because it has a button on TS/MR.) */
        {BQ_SHIP_RST, 0x08},
        {BQ_SYS_REG, 0x20},    /* SYS 4.4 V on USB; the buck-boost accepts 2.2-5.5 V */
#if CONFIG_CALIPER_CHG_TS_ENABLE
        {BQ_TS_CONTROL, 0x90},
#endif
    };
    size_t n = sizeof(table) / sizeof(table[0]);
    for (size_t i = 0; i < n && i < max; i++) {
        out[i] = table[i];
    }
    return n;
}

static esp_err_t bq_write_table(void)
{
    power_reg_t table[12];
    size_t n = power_bq_table(table, sizeof(table) / sizeof(table[0]));
    for (size_t i = 0; i < n; i++) {
        ESP_RETURN_ON_ERROR(wr8(s_bq, table[i].reg, table[i].val), TAG, "bq reg 0x%02x", table[i].reg);
    }
    uint8_t st[3];
    return rd(s_bq, BQ_STAT0, st, 3); /* clears the flags */
}

static esp_err_t add_dev(uint8_t addr, i2c_master_dev_handle_t *out)
{
    i2c_device_config_t cfg = {
        .dev_addr_length = I2C_ADDR_BIT_LEN_7,
        .device_address = addr,
        .scl_speed_hz = I2C_HZ,
    };
    return i2c_master_bus_add_device(s_bus, &cfg, out);
}

esp_err_t power_init(void)
{
    i2c_master_bus_config_t bcfg = {
        .i2c_port = I2C_NUM_0,
        .sda_io_num = PIN_I2C_SDA,
        .scl_io_num = PIN_I2C_SCL,
        .clk_source = I2C_CLK_SRC_DEFAULT,
        .glitch_ignore_cnt = 7,
        .flags.enable_internal_pullup = false, /* 4.7 k on the board */
    };
    ESP_RETURN_ON_ERROR(i2c_new_master_bus(&bcfg, &s_bus), TAG, "i2c bus");
    ESP_ERROR_CHECK(add_dev(I2C_ADDR_BQ25180, &s_bq));
    ESP_ERROR_CHECK(add_dev(I2C_ADDR_MAX17048, &s_fg));

    s_chg_ok = bq_write_table() == ESP_OK;
    uint8_t ver[2] = {0, 0};
    s_fg_ok = rd(s_fg, FG_VERSION, ver, 2) == ESP_OK;
    if (s_fg_ok) {
        fg_wake(); /* a previous ship mode left it in forced sleep / hibernate */
        /* VRESET/ID (0x18): set Dis (bit 0 of the MSB) so the reset comparator is off in
         * hibernate (SPEC §3 sleep budget: 3 uA instead of 4 uA, 19-6171 IDD0). The register is
         * 16 bits wide: write both bytes back, the LSB (ID) is read-only. */
        uint8_t vr[2];
        if (rd(s_fg, FG_VRESET, vr, 2) == ESP_OK && !(vr[0] & 0x01)) {
            uint8_t w[3] = {FG_VRESET, (uint8_t)(vr[0] | 0x01), vr[1]};
            if (i2c_master_transmit(s_fg, w, sizeof(w), I2C_TIMEOUT) != ESP_OK) {
                ESP_LOGW(TAG, "MAX17048 VRESET.Dis write failed");
            }
        }
    }
    s_imu_ok = power_imu_init(s_bus) == ESP_OK;
    s_compass_ok = power_compass_init(s_bus) == ESP_OK;
    ESP_LOGI(TAG, "BQ25180 %s, MAX17048 %s (0x%02x%02x), LSM6DSO %s, IIS2MDC %s", s_chg_ok ? "ok" : "MISSING",
             s_fg_ok ? "ok" : "MISSING", ver[0], ver[1], s_imu_ok ? "ok" : "MISSING",
             s_compass_ok ? "ok" : "MISSING");

    temperature_sensor_config_t tcfg = TEMPERATURE_SENSOR_CONFIG_DEFAULT(-10, 80);
    if (temperature_sensor_install(&tcfg, &s_tsens) == ESP_OK) {
        temperature_sensor_enable(s_tsens);
    } else {
        s_tsens = NULL;
    }
    return ESP_OK;
}

i2c_master_bus_handle_t power_i2c_bus(void)
{
    return s_bus;
}

void power_usb_configured(bool configured)
{
    s_usb_configured = configured;
    uint8_t want = configured ? BQ_ILIM_500MA : BQ_ILIM_100MA;
    if (s_chg_ok && want != s_ilim) {
        s_ilim = want;
        wr8(s_bq, BQ_TMR_ILIM, s_ilim);
    }
}

void power_poll(power_status_t *o)
{
    memset(o, 0, sizeof(*o));
    o->charger_ok = s_chg_ok;
    o->gauge_ok = s_fg_ok;
    o->imu_ok = s_imu_ok;
    o->compass_ok = s_compass_ok;

    if (s_fg_ok) {
        uint8_t b[2];
        if (rd(s_fg, FG_VCELL, b, 2) == ESP_OK) {
            o->vcell_mv = (uint16_t)((((uint64_t)b[0] << 8) | b[1]) * 78125u / 1000000u); /* 78.125 uV/LSB (64-bit: 32 overflows above 4.29 V) */
        }
        if (rd(s_fg, FG_SOC, b, 2) == ESP_OK) {
            o->soc_pct = b[0] > 100 ? 100 : b[0]; /* 1 %/LSB in the high byte */
        }
    }

    if (s_tsens) {
        temperature_sensor_get_celsius(s_tsens, &o->die_c);
    }

    if (s_chg_ok) {
        uint8_t st[3];
        if (rd(s_bq, BQ_STAT0, st, 3) == ESP_OK) {
            o->stat0 = st[0];
            o->stat1 = st[1];
            o->flag0 = st[2];
            o->vbus = st[0] & 0x01;            /* VIN_PGOOD_STAT */
            o->chg_stat = (st[0] >> 5) & 0x03; /* CHG_STAT */
            o->charging = o->chg_stat == 1 || o->chg_stat == 2;
            o->ts_open = (st[0] & 0x80) != 0; /* TS_OPEN_STAT */
        }
        /* a BQ reset returns IC_CTRL to its POR value: rewrite the table */
        uint8_t ic;
        if (rd(s_bq, BQ_IC_CTRL, &ic, 1) == ESP_OK && ic != BQ_IC_CTRL_VAL) {
            ESP_LOGW(TAG, "BQ25180 reset detected (IC_CTRL 0x%02x), rewriting", ic);
            bq_write_table();
        }
        /* VBUS without enumeration for 3 s: a dedicated charger, allow 500 mA */
        int64_t now = esp_timer_get_time();
        if (!o->vbus) {
            s_vbus_since = 0;
            if (s_ilim != BQ_ILIM_100MA) {
                s_ilim = BQ_ILIM_100MA; /* re-arm for the next plug-in */
                wr8(s_bq, BQ_TMR_ILIM, s_ilim);
            }
        } else if (s_vbus_since == 0) {
            s_vbus_since = now;
        } else if (!s_usb_configured && s_ilim != BQ_ILIM_500MA && now - s_vbus_since > CHARGER_GRACE_US) {
            s_ilim = BQ_ILIM_500MA;
            wr8(s_bq, BQ_TMR_ILIM, s_ilim);
        }
        /* die-temperature charge guard */
        bool dis = s_guard_dis;
#if CONFIG_CALIPER_CHG_TS_ENABLE
        /* an open NTC can disable TS monitoring instead of reading cold (dial-me-spinner §13.1) */
        if (o->ts_open) {
            dis = true;
        } else
#endif
        if (s_tsens) {
            if (!dis && (o->die_c < GUARD_COLD_C || o->die_c > GUARD_HOT_C)) {
                dis = true;
            } else if (dis && o->die_c > GUARD_COLD_C + GUARD_HYST_C && o->die_c < GUARD_HOT_C - GUARD_HYST_C) {
                dis = false;
            }
        }
        if (dis != s_guard_dis) {
            s_guard_dis = dis;
            wr8(s_bq, BQ_ICHG_CTRL, ichg_value());
            ESP_LOGW(TAG, "charging %s (die %.1f C)", dis ? "disabled" : "enabled", (double)o->die_c);
        }
        o->chg_disabled = s_guard_dis;
    }
    taskENTER_CRITICAL(&s_last_mux);
    s_last = *o;
    taskEXIT_CRITICAL(&s_last_mux);
}

void power_get_last(power_status_t *out)
{
    taskENTER_CRITICAL(&s_last_mux);
    *out = s_last;
    taskEXIT_CRITICAL(&s_last_mux);
}

esp_err_t power_diag_read(uint8_t addr, uint8_t reg, uint8_t *buf, size_t n)
{
    if (addr == I2C_ADDR_LSM6DSO) {
        return power_imu_diag_read(reg, buf, n);
    }
    if (addr == I2C_ADDR_IIS2MDC) {
        return power_compass_diag_read(reg, buf, n);
    }
    i2c_master_dev_handle_t d = addr == I2C_ADDR_BQ25180 ? s_bq : addr == I2C_ADDR_MAX17048 ? s_fg : NULL;
    return d ? rd(d, reg, buf, n) : ESP_ERR_NOT_FOUND;
}

esp_err_t power_ship_mode(void)
{
    if (!s_chg_ok) {
        return ESP_ERR_INVALID_STATE;
    }
    uint8_t st0 = 0;
    bool vbus = rd(s_bq, BQ_STAT0, &st0, 1) == ESP_OK && (st0 & 0x01); /* VIN_PGOOD_STAT */
    /* the gauge first: once SHIP_RST is written (without VBUS) the I2C bus is gone with VSYS */
    if (s_fg_ok && fg_ship_prepare(vbus) != ESP_OK) {
        ESP_LOGW(TAG, "MAX17048 sleep request failed: it stays in automatic hibernate (3 uA)");
    }
    ESP_LOGI(TAG, "ship mode%s", vbus ? " (pending until USB is unplugged)" : "");
    /* EN_RST_SHIP = 01: shutdown mode, wake on adapter insert only (SLUSE99C Table 8-18).
     * TS/MR has no button on rev A, so the button-wake ship mode (10) would only cost
     * IBAT_SHIP 3.2 uA for its push-button scan instead of IBAT_SHUTDOWN 15 nA. */
    return wr8(s_bq, BQ_SHIP_RST, 0x28) == ESP_OK ? ESP_OK : ESP_FAIL;
}
