tyevco/prettycoolboards/(commit log)

2026-11-08 Bootstrap prettycoolboards: shared KiCad toolchain, VitePress docs, caliper SPEC
    Claude-Session: https://claude.ai/code/session_018T6HA5hE2KEcNxwRL61f4t
2026-11-08 Caliper phase 2: schematics, mechanics, firmware, companion app (each reviewed)
    - Slider + scale schematics from Python (ERC clean, 2 intended waivers), LCSC-checked BOM
    - build123d mechanics: printed rev A housing, rev B CNC drawings, gap/deflection calcs
    - ESP-IDF firmware with host tests (649 checks pass); target build not yet run
    - Web Bluetooth companion app at public/caliper/app with protocol tests cross-checked against the firmware codec
    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
    [back_cover.step, back_cover.stl, back_gib.step, back_gib.stl, beam.step, beam.stl, beam_pockets.step, button_cap.step]
2026-11-08 Caliper firmware: ESP32-S3 target build, pin plan, sleep-leakage fixes, contract update
    - First idf.py build for esp32s3 (0 warnings, 6% app-slot free); SSI fine interpolation (0.488 um)
    - Fix ~440 uA deep-sleep leak: gpio_reset_pin() left pull-ups on six held-low UI lines
    - Clear the PCNT driver's pull-ups on MAG_A/B; isolate/hold every RTC pad in sleep
    - One declarative pin plan (tools/pin_plan.py) drives sleep/boot config, exported as
    hwtools pinstate.json; host tests enforce no output-vs-pull and strap levels
    - MAX17048 forced to sleep/hibernate before BQ25180 ship mode
    - GATT contract clarified (LIVE grows to 12 B with active profile id); app + vectors updated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
    [app_main.c, as5311_proto.c, as5311_proto.h, board_pins.h]
2026-11-08 Caliper firmware: SWEEP (min/max/range) capture and SETTLE median auto-hold
    - SWEEP: tracks MIN/MAX while the part is rocked; AUTO picks the true size from the
    approach direction (closing = OD -> MIN, opening = ID -> MAX), MIN/MAX overridable;
    shows the other extreme, range and n; tolerance judged on the shown extreme
    - SETTLE: freezes the median of the last 32 samples once still
    - Averaging would read an OD high: jaw tilt only ever adds (~68 um at 0.5 deg)
    - LIVE v3 (20 B), COMMAND 0x05 SET_CAPTURE / 0x06 CAPTURE_RESET, 6-byte LOG_READ;
    10/12-byte clients unaffected; app shows capture state, vectors regenerated from C
    - Adversarial review fixed 9 defects (hover-before-contact lost, sm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
    [app_main.c, caliper_gatt.h]
2026-11-08 Caliper phase 3: wired schematics, routed boards, mechanics vs the real board
    - Schematics drawn with wires (hard rule enforced in tools/schgen; label-only local
    nets fail the build); netlists proven identical to before the rework
    - kicad-codegen skill + repo CLAUDE.md carry the rule
    - Slider (4-layer, 74x34 with clamp tabs) and scale boards placed and routed:
    KiCad 9 DRC 0 errors / 0 unconnected / 0 parity on both; KiCad 10 agrees
    - Layout review fixed the USB pair, decoupling, the electrode guard and more
    - Fab outputs written; slider package REVIEW-ONLY (J50 FPC footprint vs C2911931)
    - Mechanics re-fitted to the extracted board: 0 clashes; back-cover preload,
    board support via tabs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
    [back_cover.step, back_cover.stl, back_gib.step, back_gib.stl, battery_door.step, battery_door.stl, beam.step, beam.stl]
2026-11-08 Caliper phase 4: battery reverse-polarity FET, 2.2k I2C, J50 footprint, jlcplace gate
    - Q1 AO3401A P-FET ideal diode in the battery lead (<=43 mV at 0.5 A); VBAT_RAW net
    - I2C pull-ups 4.7k -> 2.2k (rise 438 -> 205 ns at 400 kHz)
    - J50: custom footprint from the C2911931 drawing (no Hirose/Amphenol 13p at LCSC)
    - Module decoupling under the ESP32 3V3 pad (1.9 mm, was 22 mm); E40 pin names; H5 in schematic
    - Re-placed and re-routed: KiCad 9 DRC/parity 0/0/0, KiCad 10 agrees
    - CPL now written by jlcplace cpl and gated by jlcplace check (slider: 0 red,
    1 yellow BZ50 polarity, 100 green); packages are orderable, no REVIEW-ONLY
    - Mechanics: inside jaw reshaped to clear the antenna by 5.15 mm; 0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
    [back_gib.step, battery_door.step, beam.step, beam_pockets.step, button_cap.step, caliper_assembly.step, fixed_jaw.step, fixed_jaw.stl]
2026-11-09 Move the caliper toolchain and boards to KiCad 10.0.8
    - Port tools to pcbnew 10 (FindPlugin, HasField/GetField, DoNotAllowZoneFills,
    GetBoardPolygonOutlines flag); schgen/symgen write KiCad 10 formats
    - KiCad 10 netlist format handled (pinfunction name_number, empty datasheet);
    netlist_diff --pin-rename; parity now checks custom fields -> fields copied
    - USB-C shield pin S1 -> SH (10.0.8 library); J1 pads renumbered, same copper
    - schgen: wire UUIDs unique per sheet (duplicate UUIDs predated the move)
    - Evidence: netlists IDENTICAL, routed copper identical (pcbnew compare),
    Gerbers/drill geometrically identical, BOM/CPL/jlcplace byte-identical,
    DRC/parity 0/0/0; the KiCad 10 'second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
    [imu.kicad_sch, mcu.kicad_sch, power.kicad_sch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]
2026-11-09 Caliper design fixes: power paths, VBUS through the TVS, CAP_RX filter at the ADC, stack-up, stiffer jaw
    - VBAT Q1->U2 97 -> 12.7 mOhm, VSYS 20.9 -> 12.0, VBUS 17.6 -> 11.2 (wide pre-routes, via arrays)
    - U6 input cap C13; every USB-C VBUS pad now reaches the charger only through D1
    - R85/C44 next to GPIO1: CAP_RX 60 -> 2.9 mm, crosstalk 11.0 -> 0.14 mV
    - JLC04101H-3313 stack-up in the board; USB pair 89.4 ohm diff; no detour through U1
    - layout.py --rework: keeps committed routing, re-routes only changed nets
    - finish_route: fix track split losing copper (pcbnew GetEnd() is a live reference)
    - U2 DSBGA lands kept narrow at the balls
    - Moving inside jaw 9.5 -> 1.98 um/N (PA-CF); BZ50 recorde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
    [back_gib.step, battery_door.step, beam.step, beam_pockets.step, button_cap.step, caliper_assembly.step, fixed_jaw.step, front_pad.step]
2026-11-09 Caliper: stiffer fixed jaw, shielded CAP_LP1, order checklist, bring-up kit
    - Fixed inside jaw 2.17 -> 1.13 um/N (PA-CF, with block give); inside reading 24.9 -> 18.7 um over 2-8 N
    - CAP_LP1 shielded corridor (rule areas, In2 GND, stitching): worst aggressor 20.4 -> 0.88 mV;
    DRC/parity 0/0/0, jlcplace 102 green / 0 red
    - docs/ordering.md: JLC options (Standard PCBA, both sides, 0.2 mm vias, JLC04101H-3313, panel),
    rough cost, off-board parts, preview checks for U30/BZ50
    - Firmware 'bu' bring-up commands (rails, I2C, charger, gauge, IMU, AS5311 count-vs-SSI, LCD,
    buttons, piezo/LED, cap I/Q, BLE/Wi-Fi RSSI, sleep, ship) + docs/bringup.md B-steps;
    fixed CLI help truncation and a MAX170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
    [caliper_assembly.step, fixed_jaw.step, fixed_jaw.stl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]
2026-11-10 Caliper: slim housing (52 -> 39.2 mm tall) with a 135 mAh cell, rounded shape
    - Cell Renata ICP501230PS-03 (<=5.4x12.5x31.5, 135 mAh, protected) behind the board's upper band
    - Housing 76.9 x 39.2 x 16.0 mm (was 52 tall); printed slider parts 43 -> 29 g
    - Corner radii, back and lid bevels (support-free); nylon screws near the antenna (RF rule 5.15 mm)
    - J2 moved to the bottom side into a J2 bay; VBAT_RAW re-routed; gates 0/0/0, jlcplace 0 red
    - Charger: 70 mA (0.5C), IBAT_OCP 1 A; Wi-Fi capped at 10 dBm and floored at 3.5 V on battery
    - Battery life re-derived: ~3.3 days typical shop day, ~1 h 40 min continuous
    Claude-Session: https://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
    [back_gib.step, battery_door.step, battery_door.stl, beam.step, beam_pockets.step, button_cap.step, caliper_assembly.step, fixed_jaw.step]
2026-11-10 Docs: 3D gallery of the slim rev A (assembly, exploded, housing, before/after, boards)
    Static page under public/caliper/gallery/ (three.js 0.160 from jsDelivr); models as
    base64 GLB text, the KiCad 10 board export meshopt-compressed (27 MB -> 1.7 MB).
    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
2026-11-10 Caliper: add a gyroscope (LSM6DSO 6-axis IMU replaces the LIS2DW12)
    U60 becomes an LSM6DSOTR (C2655100, LGA-14) on the same spot, bus and
    interrupt lines, at I2C 0x6B (0x6A is the BQ25180). Wi-Fi stays: it is the
    same module and antenna as BLE, so removing it would free no board area.
    Hardware: imu sheet and symbol, nets.I2C_ADDR, rule area with no F.Cu
    copper inside U60's pad ring, C60/C61/C62/R57 moved, slider re-routed with
    the grid router (11 nets differ; USB, VBUS, VBAT, VSYS, CAP_LP1 untouched),
    fab package regenerated (CPL rotation 270 -> 0, new jlcplace entry).
    Sleep target <= 35 -> <= 40 uA, +0.25 mA awake, +$3.09 a board.
    Firmware: LSM6DSO driver, orientation filter (roll/pitch a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
    [caliper_assembly.step, imu.kicad_sch, power.kicad_sch, prettycool-caliper-slider-BOM-JLCPCB.csv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]
2026-11-11 caliper: add an IIS2MDC magnetometer (compass) as a yaw reference
    U61 IIS2MDCTR (C2655002) on the I2C bus at 0x1E and the always-on +3V3,
    with C63 220 nF (C1), C64/C65 (Vdd) and C66 (Vdd_IO). INT/DRDY is not
    connected (no GPIO free), so the firmware polls at 10 Hz. nets.MCU_PINS
    is unchanged.
    Hardware
    * Placed in the free corner of the top band, 11.2 mm from the beam edge.
    * C1 loop pre-routed and locked (preroute_compass); no top copper inside
    the pad ring (U61_NO_COPPER_UNDER).
    * Reworked with the grid router: 16 nets differ, vias 534 -> 543; USB,
    VBUS, VBAT, VSYS, CAP_RX and CAP_LP1 untouched.
    * Sleep target <= 40 -> <= 42 uA (estimate ~40 uA).
    Firmware
    * compass.c driver, compass t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
    [imu.kicad_sch, prettycool-caliper-slider-BOM-JLCPCB.csv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]
2026-11-11 Docs: rev B ideas page; bin the electronic slide lock
    New caliper/docs/ideas/rev-b.md collects the rev B directions from costing rev A's
    fabrication: battery life (bigger cell, SSI-unwrap instead of PCNT so the CPU can
    sleep, lower-power position sensors, a memory LCD, a low-Iq buck-boost, a firmware
    standby state), dropping Wi-Fi and the candidate chips (nRF52840/nRF54L15,
    ESP32-H2/C6, STM32WB/WBA), hardened jaws, a standard beam size, depth rod, an
    absolute vernier reading, constant measuring force, temperature compensation,
    sealing, and the fabrication lessons (PCB rules vs US fab tiers, V-cut clearance,
    US stock). Nothing in it is designed or measured.
    The electronic slide lock is binne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
